santan444/MS003/03-设计开发输出阶段/02电子/05物料证书/18.内部网电源电线/BVR 450750V 2.5-6.jpg

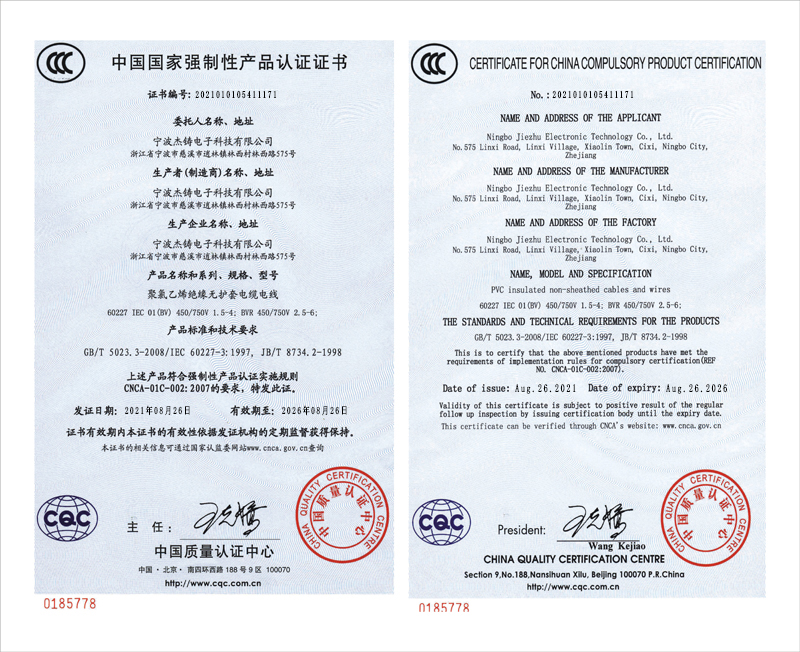
03-设计开发输出阶段/02电子/05物料证书/18.内部网电源电线/BVR 450750V 2.5-6.jpg
