santan444/MS003/03-设计开发输出阶段/02电子/02接线图/MS-003导航台车接线图.pdf

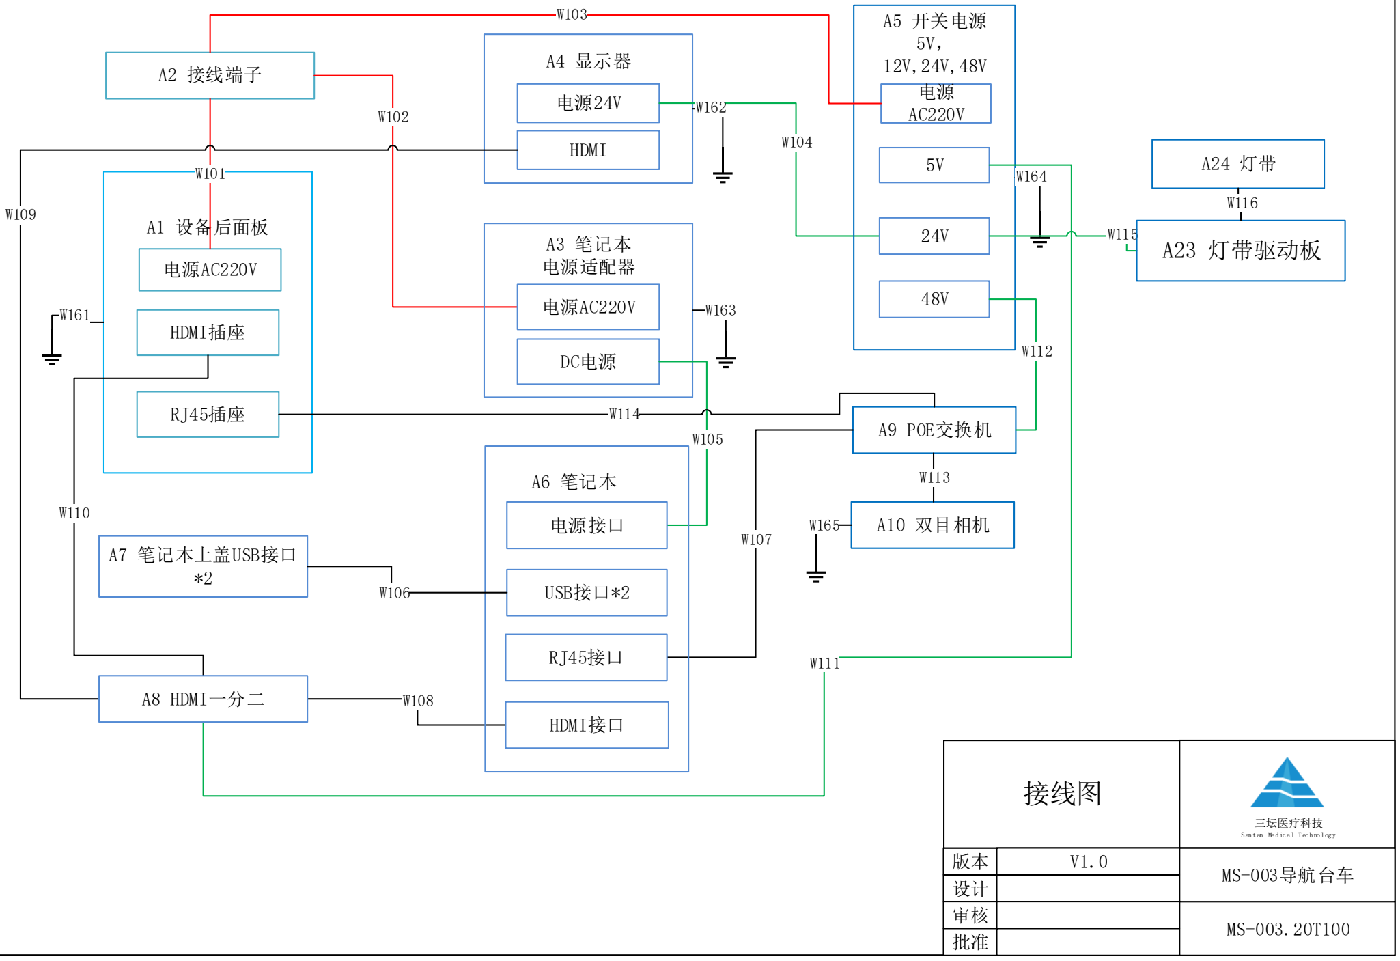
[picture p32: figure]
MS-003导航台车; 三坛医疗科技; Santan Medical Technology; 接线图; A2 接线端子; HDMI; A4 显示器; 电源AC220V; A1 设备后面板; DC电源; A3 笔记本 电源适配器; A5 开关电源 5V， 12V,24V,48V; A10 双目相机; A9 POE交换机; HDMI插座; A8 HDMI一分二; A7 笔记本上盖USB接口 *2; A6 笔记本; 电源接口; USB接口*2; HDMI接口; A23 灯带驱动板
