santan444/MS003/01-设计开发策划阶段/MS-003已上市同类产品不良事件及召回情况分析.docx

MS-003

已上市同类产品不良事件及召回情况分析

1. 已上市同类产不良事件

在国家药品监督管理局网站（https://www.nmpa.gov.cn/）的“医疗器械不良事件通报信息”版块中暂未发现2008年2月-2022年8月期间MS-003已上市同类产品的不良事件通报。

2. 已上市同类产品召回情况

2022年9月21日，在国家药品监督管理局网站（https://www.nmpa.gov.cn/）的“医疗器械召回”版块中以“关节”、“髋关节”、“关节系统”为关键词搜索相关信息，暂未发现MS-003已上市同类产品的召回信息。

编制人/日期：

复核人/日期：
