santan444/MS003/03-设计开发输出阶段/03软件/MS-003软件安装说明书.docx

MS-003

软件安装说明书

目 录

1 数据库安装及配置 3

1.1 PostgreSQL 12.11.1 安装 3

1.2 配置数据库 8

2 软件安装 11

2.1 安装 11

2.2 注册 14

# 1 数据库安装及配置

## 1.1 PostgreSQL 12.11.1 安装

说明: PostgreSQL 12.11.1 安装包由研发部提供。

双击运行安装文件postgresql-12.11-1-windows-x64.exe，如下图：

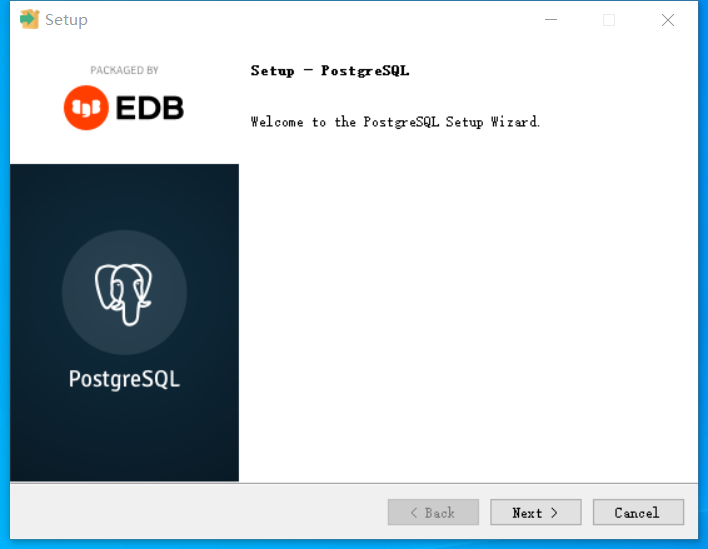
[picture p67: figure]
1660188475(1)

使用默认安装路径，如下图：

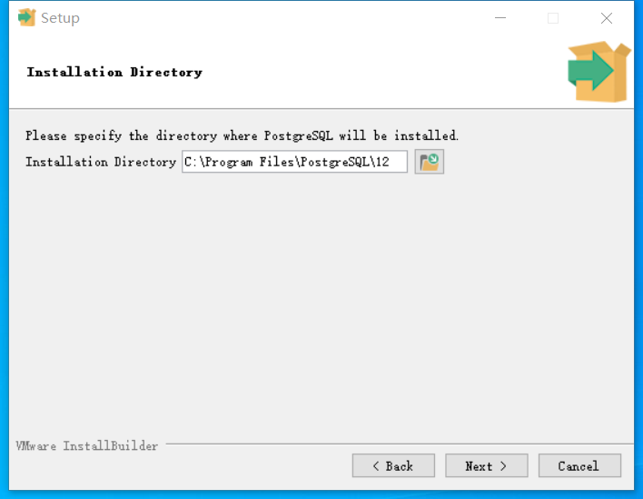
[picture p68: figure]
1660188507(1)

勾选所有组件，如下图：

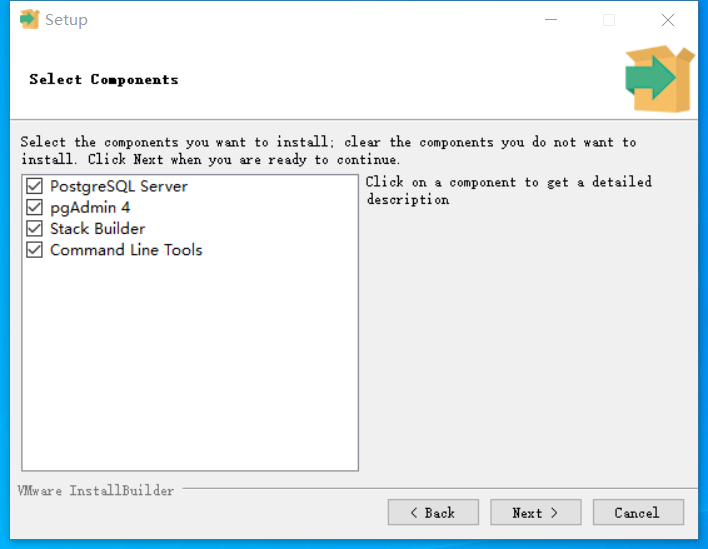
[picture p69: figure]
1660188563(1)

使用默认的数据存储路径，如下图：

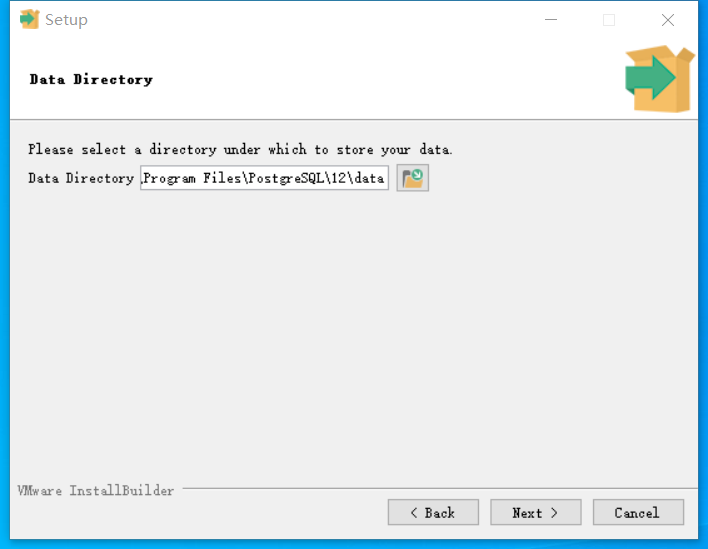
[picture p70: figure]
1660188821(1)

设置数据库用户密码，如下图：使用默认用户名，密码：santan2022

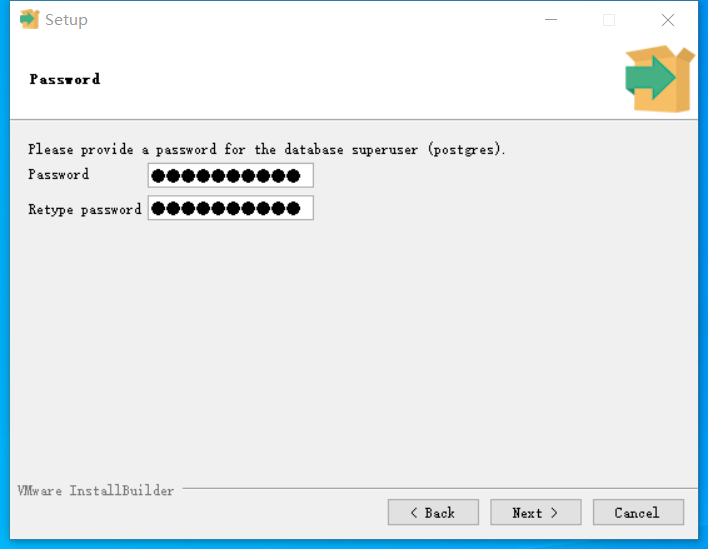
[picture p71: figure]
1660188945(1)

使用默认端口：

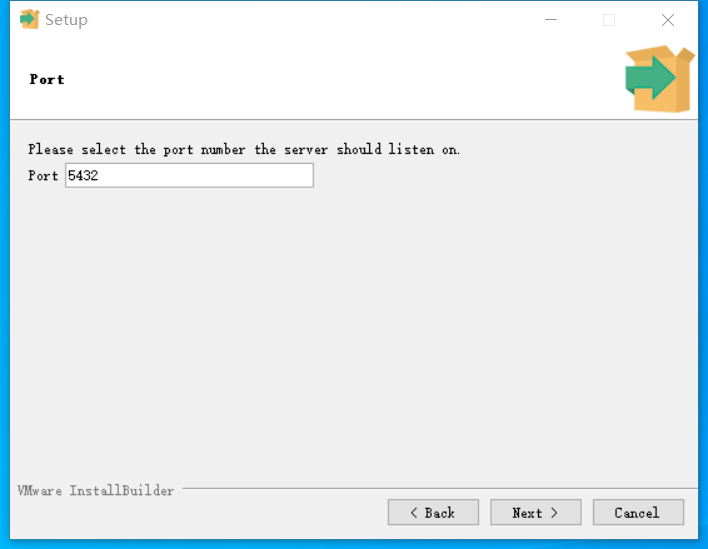
[picture p72: figure]
1660188966(1)

选择默认位置：

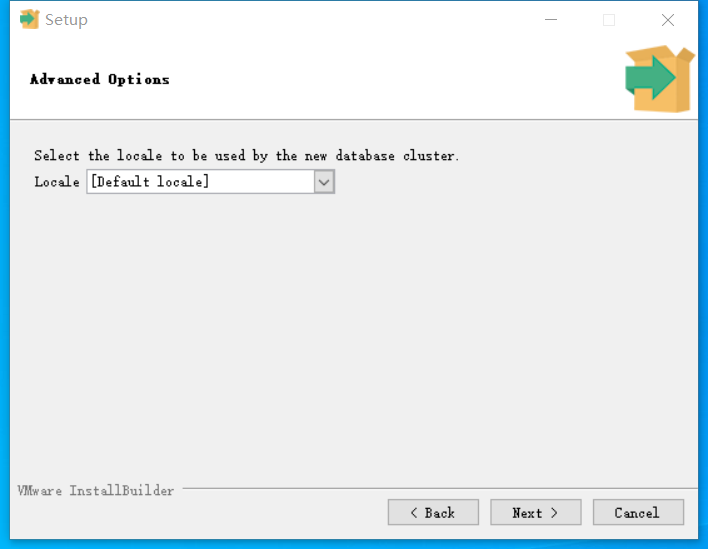
[picture p73: figure]
1660189086(1)

确认安装信息：

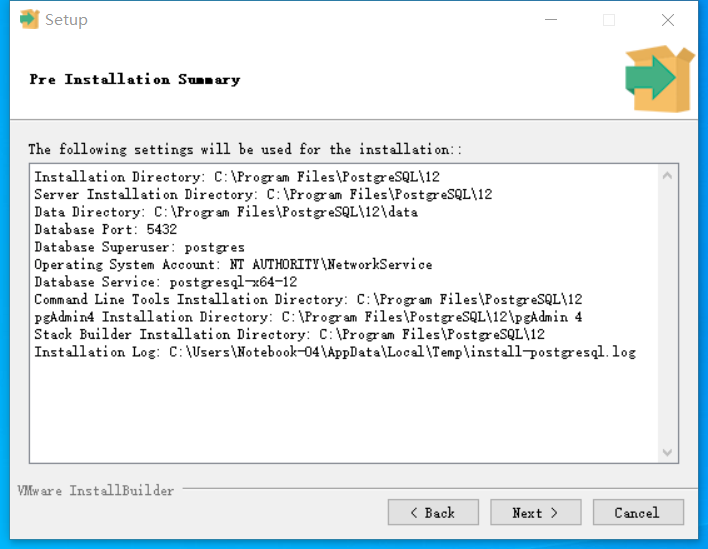
[picture p74: figure]
1660189108(1)

准备就绪，点击安装：

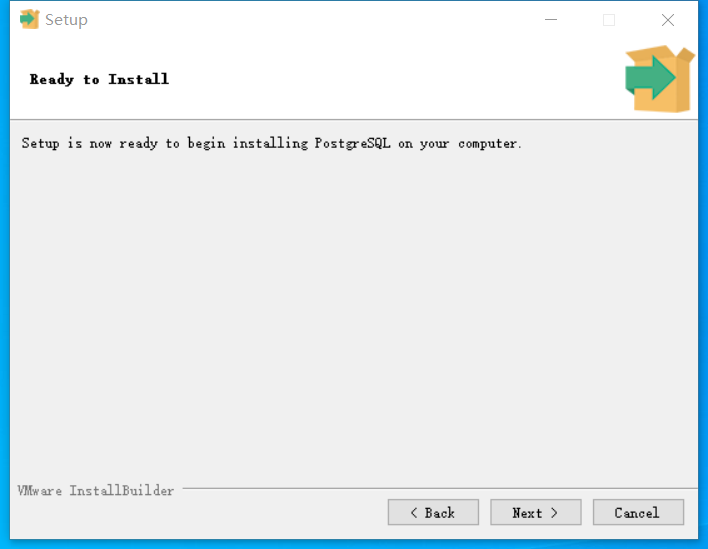
[picture p75: figure]
1660189157(1)

安装完成：

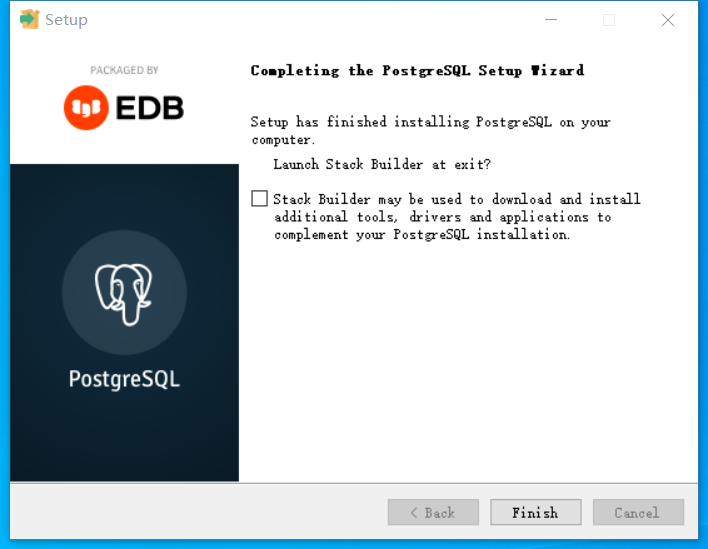
[picture p76: figure]
1660189288(1)

## 1.2 配置数据库

运行pgAdmin，输入密码登录，展开选中Servers->PostgreSQL12->Databases，右键单击，选择Create->Database

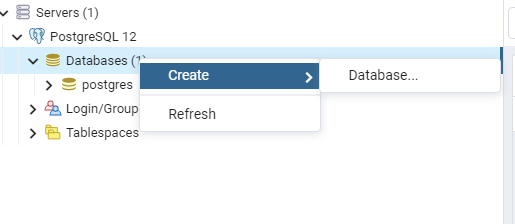
[picture p77: figure]
1660197411(1)

弹出对话框，输入名称STMDB, 点击save创建成功。

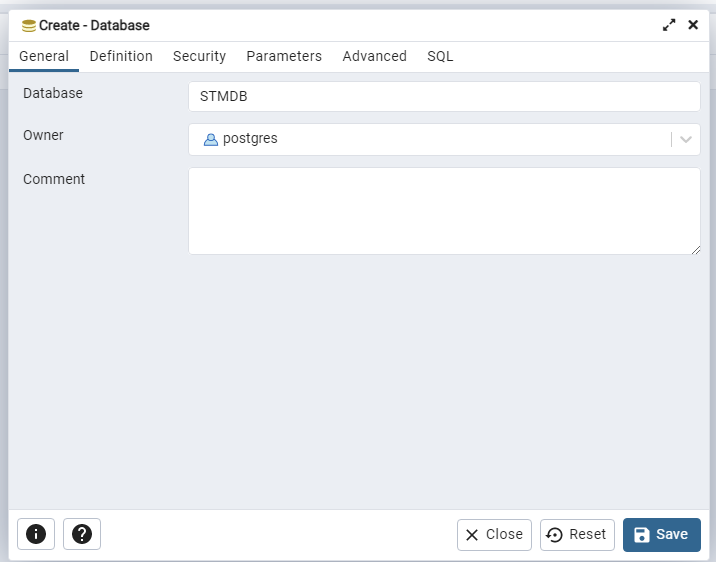
[picture p78: figure]
1660197630(1)

右键单击刚创建的STMDB，选择QueryTool，打开QueryEditor

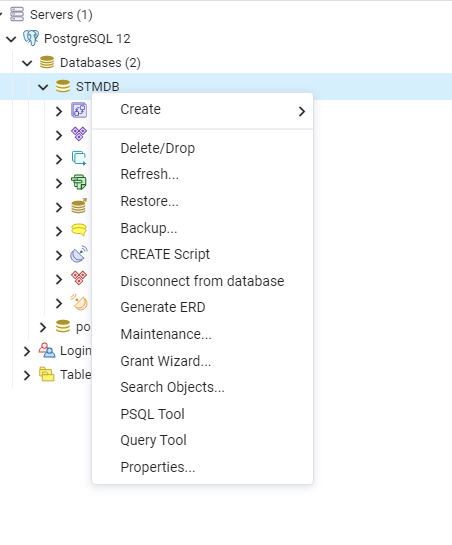
[picture p79: figure]
1660197780(1)

复制文档DbCreateScript中内容至Query Editor：

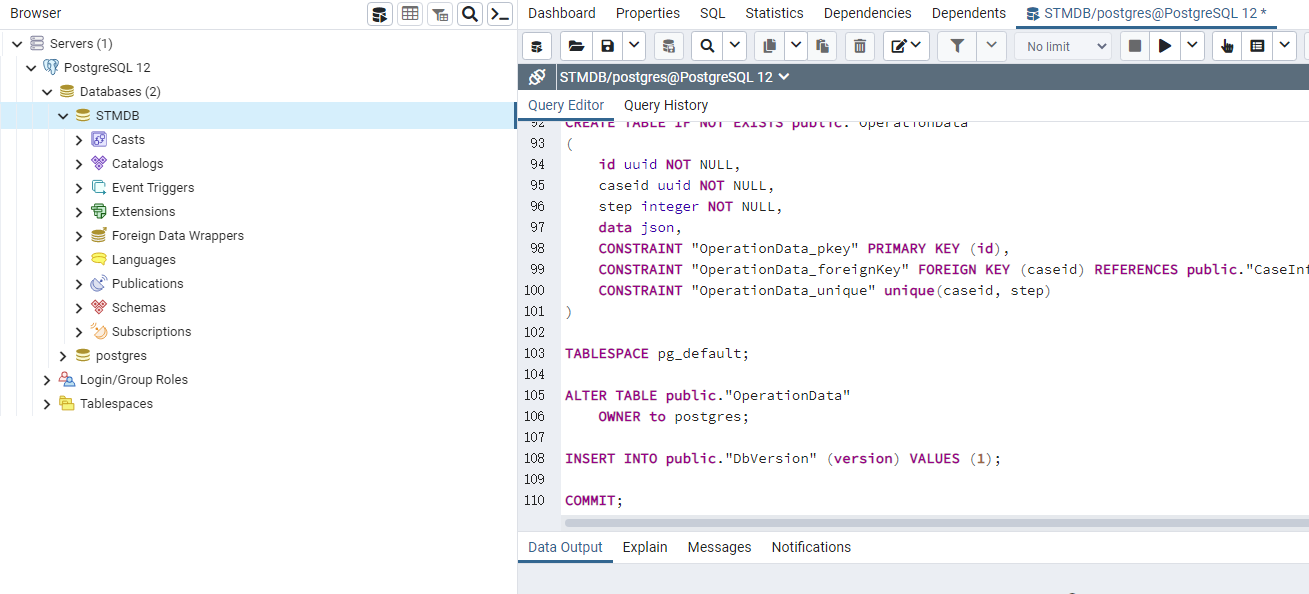
[picture p80: figure]
1660197918(1)

单击执行按钮或者按下F5执行成功。

此时展开STMDB->Schemas->Tables，会看到创建成功的数据表。

# 2 软件安装及注册

## 2.1 安装

安装前请卸载原有软件（如有），双击“安装包/MS003.msi”运行。 弹出窗口：

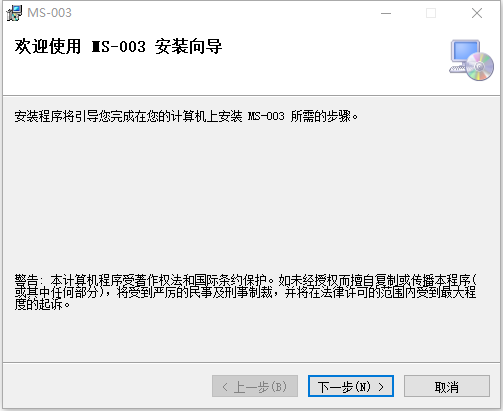
[picture p81: figure]

点击【下一步】，进入以下页面：

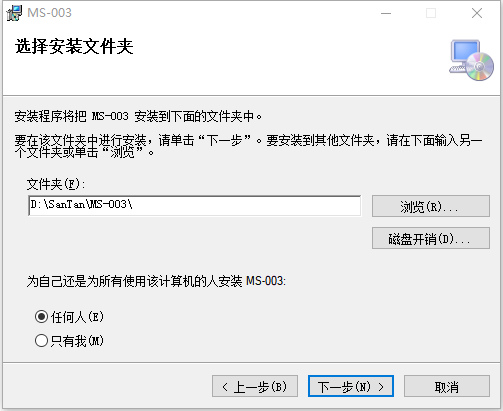
[picture p82: figure]

选择安装目录，可直接手工修改比如D盘“D:\”，或者点击右边【浏览】按钮：浏览

选择本地目录，如下图：

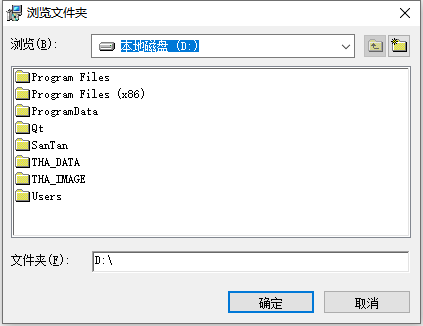
[picture p83: figure]

选中D\SanTan\MS-003\盘，点击【确定】:

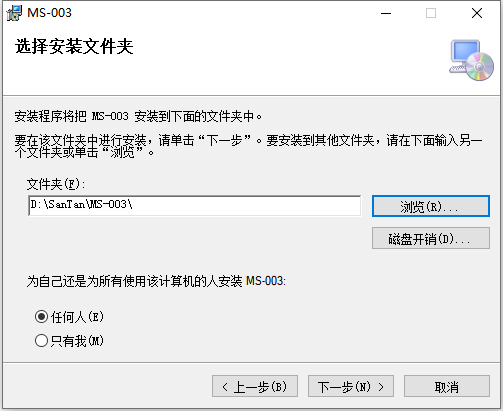
[picture p84: figure]

点击【下一步】按钮，进入以下页面：

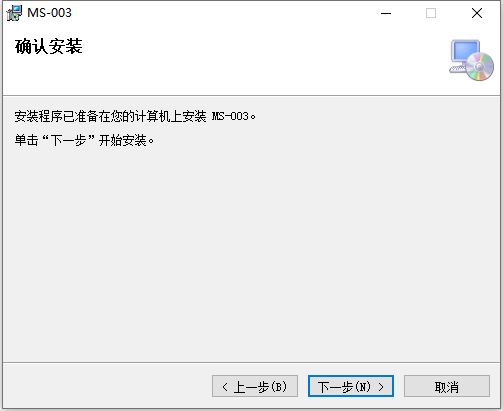
[picture p85: figure]

点击【下一步】按钮，开始安装，等待进度条加载：

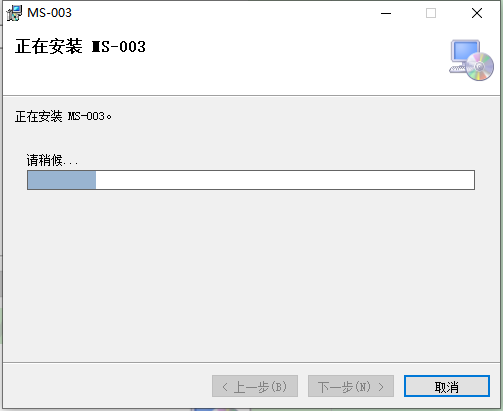
[picture p86: figure]

等待进度条加载完成，如下图：

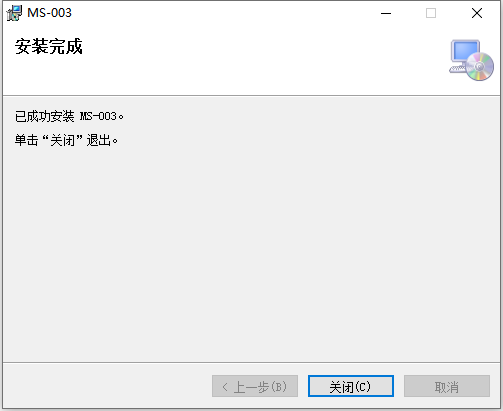
[picture p87: figure]

点击【关闭】按钮，安装完成。

## 2.2 注册

双击“D\SanTan\MS-003\ActivateTool.exe”如下图：

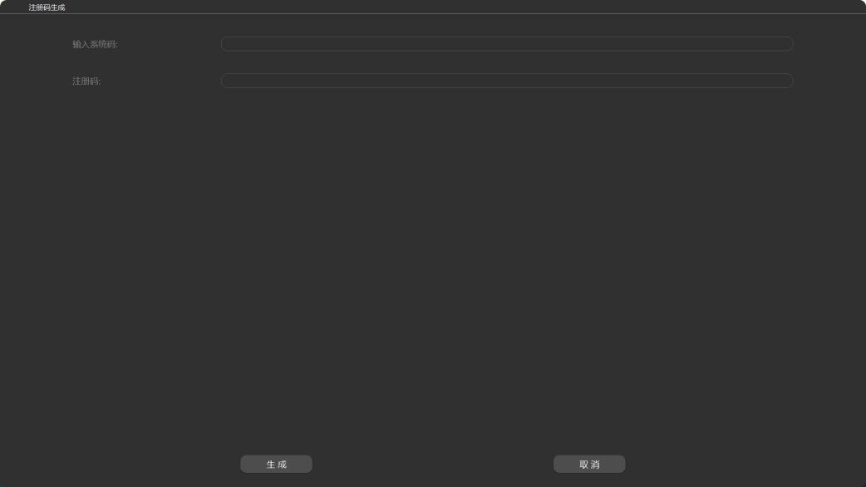
[picture p88: figure]

运行髋关节置换手术规划与控制（MS-003）软件，双击D:\MS-003\Entrance.exe，首

次运行，会自动进入注册页面，如下图：

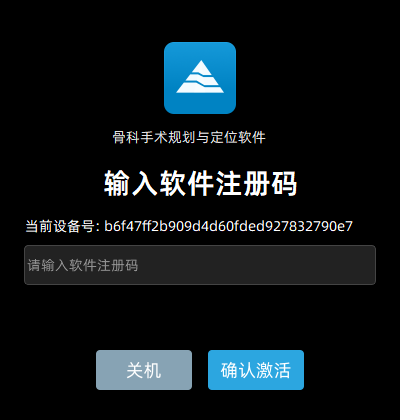
[picture p89: figure]

将注册页面的第一行内容(当前设备号)32位字符复制，

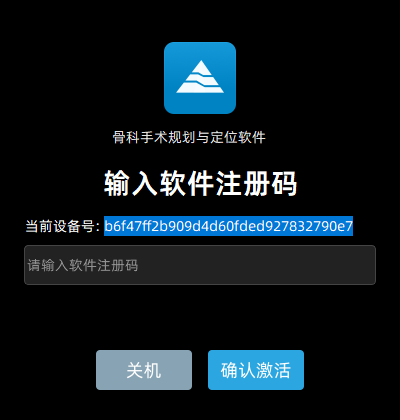
[picture p90: figure]

然后粘贴到ActivateTool窗口的“输入系统码”输入框，

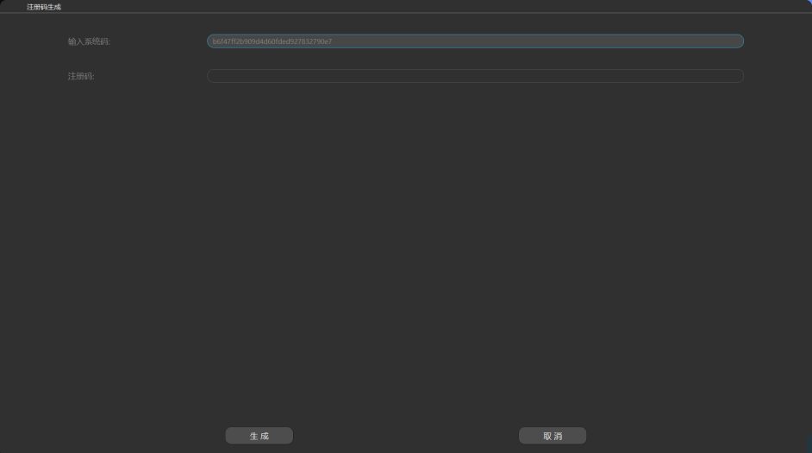
[picture p91: figure]

点击下方【生成】按钮，会自动生成注册码，如下图：

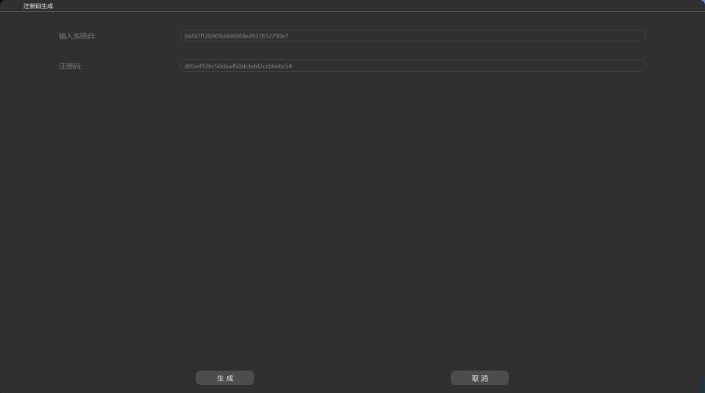
[picture p92: figure]

复制32位注册码，然后粘贴到MS-003软件注册页面，如下图：

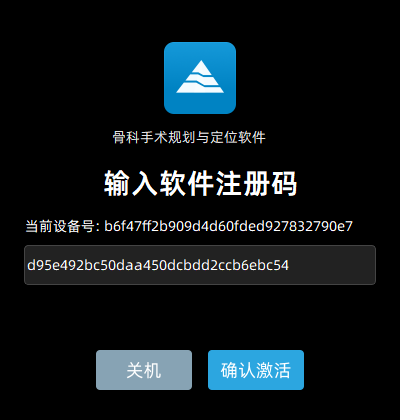
[picture p93: figure]

点击【确认激活】按钮，注册成功，进入登录页面，如下图：

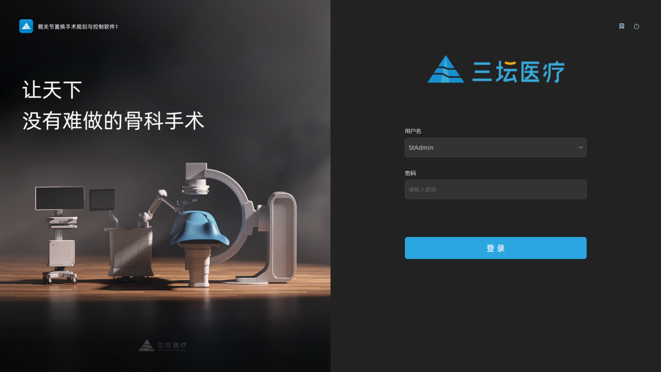
[picture p94: figure]

安装注册完成。
