santan444/MS003/03-设计开发输出阶段/02电子/MS-003网电源电路图.docx

MS-002 操作台车网电源电路图

P1:电源插座， 包含在DD12.9321.111中
F1、 F2:熔断器， 包含在DD12.9321.111中
F1、 F2熔断器座， 包含在DD12.9321.111中
SW1:电源开关， 包含在DD12.9321.111中
L1:滤波器， 包含在DD12.9321.111中

MS-002 导航台车网电源电路图

P1:电源插座， 包含在DD12.9321.111中
F1、 F2:熔断器， 包含在DD12.9321.111中
F1、 F2熔断器座， 包含在DD12.9321.111中
SW1:电源开关， 包含在DD12.9321.111中
L1:滤波器， 包含在DD12.9321.111中

MS-002 执行台车网电源电路图

P1:电源插座， 包含在DD12.9321.111中
F1、 F2:熔断器， 包含在DD12.9321.111中
F1、 F2熔断器座， 包含在DD12.9321.111中
SW1:电源开关， 包含在DD12.9321.111中
L1:滤波器， 包含在DD12.9321.111中
