santan444/MS003/03-设计开发输出阶段/02电子/04电子测试验证/MS-003.20W011 MS-003末端控制板验证方案.docx

| 文件号： | | | | | MS-003.20W011

MS-003

末端控制板验证方案
编制人： | | | | 日期：
审核人： | | | | 日期：
批准人： | | | | 日期：

文档修订履历

版本号 | 发布日期 | 更改内容概述 | 更改者
V1.0 | 2022.03.00 | 文件新编 | 雷俊勇

保密条款

文档仅限产品（项目）组内流转，违者负相应法律责任。

目录

# 第1章 概述

## 1.1 验证目的

末端控制板是用来控制机械臂前端通道上升下降通道左旋转右旋转和状态灯显示机械臂和操作状态的部件，根据产品技术需求说明书，对末端控制板按键功能和灯光控制功能进行测试验证，检验产品功能与开发需求是否一致。

根据GB∕T 14710-2009《医用电器环境要求及试验方法》环境试验条件分组第Ⅲ组要求，进行气候环境条件测试，试验产品在特定温湿度条件下是否正常工作。

## 1.2 验证范围

MS-003.22T001-末端控制板。

## 1.3 术语

无

## 1.4 参考资料

GB∕T 14710-2009《医用电器环境要求及试验方法》

《MS-003 技术需求规格书》

《MS-003 电子设计失效模式分析(D-FMEA)》

《MS-003 风险评估和控制记录》

# 第2章 验证条件

## 2.1 验证对象

设备编号 | 设备名称 | 型号规格 | 备注
1 | 末端控制板 | MS-003.22T001 | /

## 2.2 验证设备/工装/工具

设备编号 | 设备名称 | 型号规格 | 备注
/ | 末端灯板 | MS-003.24T001 | /
ST/RD-E2001 | 直流稳压电源 | UTP1306S | /
ST/RD-E1002 | 数字万用表 | FLUKE 17B+ | /
ST/SC-025 | 高低温箱 | WHTM-150BO | /

## 2.3 验证地点

公司实验室

## 2.4 验证时间

2023.01-2023.02

## 2.5 验证环境

环境一：温度：室温；相对湿度：≤75%

环境二：高低温箱内特殊要求

## 2.6 验证人员

序号 | 岗位 | 人数 | 职责
1 | 电子工程师 | 1人 | 验证中的设备操作
2 | 测试工程师 | 1人 | 进行相关过程数据记录； 数据统计，编制报告

# 第3章 验证可接受准则

验证结果应符合以下指标：

(1) 末端控制板电压值在±5%范围内。末端灯板灯光显示状态正常；
(2) 高低温试验后，末端灯板灯光显示状态依然正常。

# 第4章 验证方法与步骤

## 4.1 功能验证（在室温环境下进行）

(1) 电压：

将末端控制板接入稳压电源（12V）中，测试其按键输出至机械臂工具模拟输入口电压是否正常。分别各测3次。

表4.2-1 末端控制板功能测试-电压

按下按键 | 预期电压（V）±5% | 实测电压（V）
SW1 | 2
SW2 | 4
SW3 | 6
SW4 | 8

(2) 灯光：

将末端控制板接入机械臂工具口中，连接末端灯板测试灯光显示是否正常。

表4.2-2 末端控制板功能测试-灯光

状态 | 预期灯光显示 | 实际灯光显示
机械臂掉电、按下急停按钮 | 灯光不亮
机械臂运动中、自由拖动 | 蓝色闪烁
待机状态 | 蓝色常亮
定位就绪（精度达到1.5mm以内） | 绿色常亮
套筒示踪器不可见 | 黄色常亮

## 4.2 性能验证

根据GB∕T 14710-2009《医用电器环境要求及试验方法》环境试验条件分组要求，进行气候环境第Ⅲ组条件测试，进行以下试验项目：

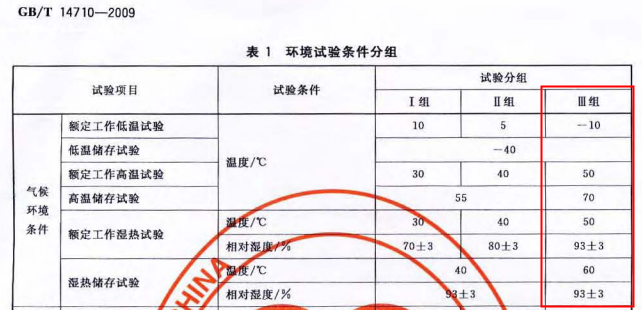
[picture p167: figure]

步骤：

(1) 进行高低温试验前，需要进行4.1功能测试，确认电压和灯光正常。

在低温(1)、高温(3)、湿热(5)的工作状态测试时应正常工作；

在低温(2)、高温(4)、湿热(6)的储存状态测试后恢复1h应正常工作。

(2) 将末端控制板置于高低温箱，按下表6种试验条件分别设置温湿度、并持续预定的时间。

表5.3-1 环境测试

序号 | 试验项目 | 试验条件 | 持续时间 | 预期结果 | 实际测试结果
1 | 额定工作低温试验 | 温度-10℃，试验时通电 | 1h | 此条件下正常工作
2 | 低温储存试验 | 温度-40℃，试验恢复后通电 | 4h | 上电后正常工作
3 | 额定工作高温试验 | 温度50℃，试验时通电 | 1h | 此条件下正常工作
4 | 高温储存试验 | 温度70℃，试验恢复后通电 | 4h | 上电后正常工作
5 | 额定工作湿热试验 | 温度50℃，湿度93%±3，试验时通电 | 4h | 此条件下正常工作
6 | 湿热储存试验 | 温度60℃，湿度93%±3，试验恢复后通电 | 48h | 上电后正常工作

(3) 序号1,3,5条件在高低温箱里，测试控制板，按照4.1功能测试分别测试电压和灯光状态。
(4) 序号2,4,6条件：将末端控制板从高低温箱取出，置于室温环境下恢复一小时，确认灯光状态。

# 第5章 验证结果与结论

从验证小组组员根据本方案的方法及步骤进行验证，记录结果并对结果进行相关分析。依据本方案的标准要求得出最终的验证结论，并编写验证报告。验证相关文档需经过审核、批准后归档。

# 第6章 附件

《MS-003 末端控制板验证记录表》。
