santan444/MS003/03-设计开发输出阶段/03软件/软件测试/v1..0.0.2截图/手术规划_运动评估.png

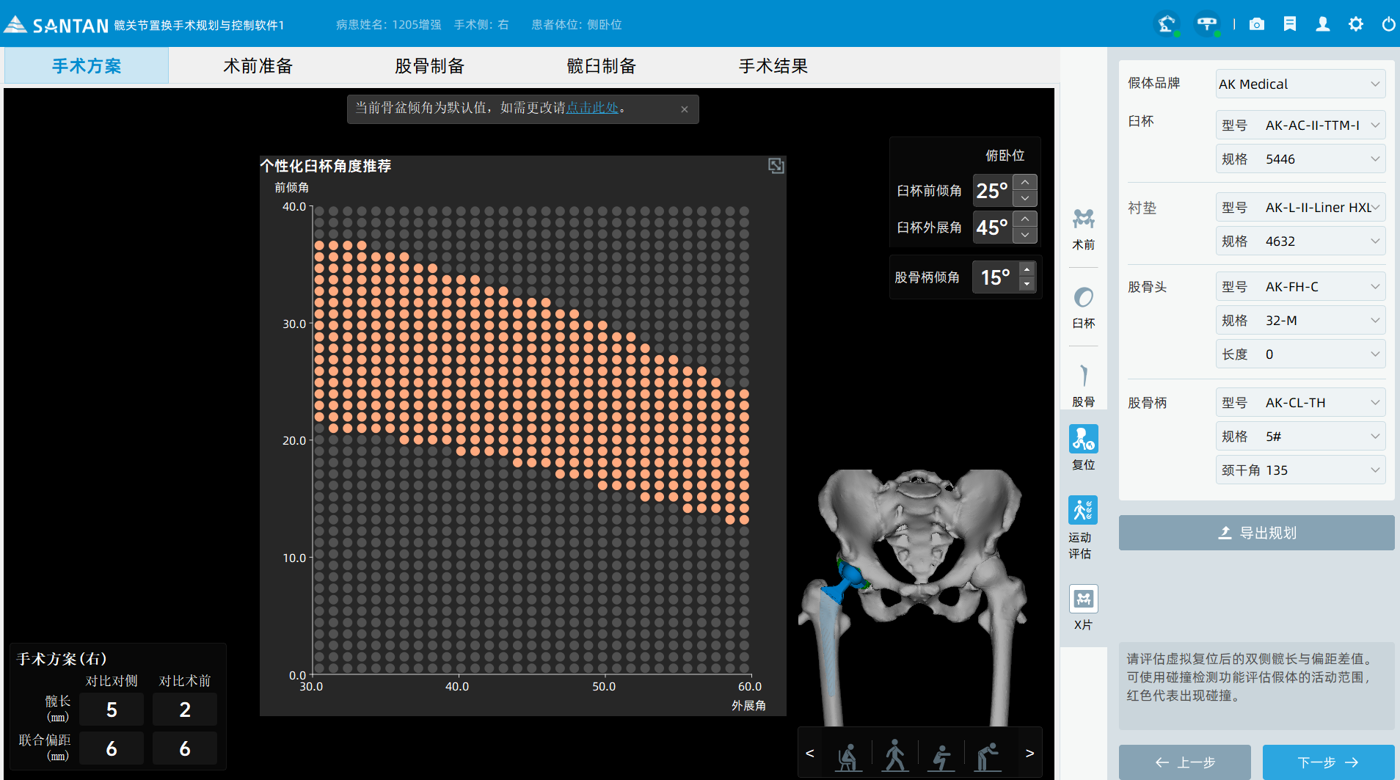
03-设计开发输出阶段/03软件/软件测试/v1..0.0.2截图/手术规划_运动评估.png
