santan444/MS003/03-设计开发输出阶段/02电子/07电子物料表/MS-003 三个台车电子BOM总表.xls

物料编码 | 物料名 | 型号 | 规格 | 品牌 | 缺少 | 合计 | 备注 | 导航 |  | 操作 |  | 执行 |  | 2023-12-19
611010217 | 电源接入连接器 | DD12.9321.111 |  | 得捷电子 |  | 3 |  |  | ● |  | ● |  | ●
611010147 | 保险丝座 | 4301.1403 |  | 得捷电 |  | 3 |  |  | ● |  | ● |  | ●
611010268 | 熔断器 | F5AL250V |  | 富轩电子 |  | 6 |  |  | ● |  | ● |  | ●
611010569 | 快速接线端子 | KC-6601 | 双色二进六出(固定款) | 汇君 |  | 3 |  |  | ● |  |  |  | ●
611010570 | 开关电源650W | NMP650-CEHK | 输出5V，12V，24V，48V | 明纬 |  | 3 |  |  | ● |  | ● |  | ●
611010571 | 开关电源450W-12V | MSP-450-12 |  | 明纬 |  | 1 |  |  |  |  |  |  | ●
611010435 | 27寸显示器 | MS27STPA | 带显示器电源适配器和HDMI线 | 睿显 |  | 2 |  |  | ● |  | ●
611010573 | UPS | UPS2000-G-1KRTS | 自带电源线和A口转B口USB线缆 | 华为 |  | 1 |  |  |  |  |  |  | ●
611010438 | 隔离变压器 | T8BFN-85419 | TTO-85419-00L | 河源天裕 |  | 1 |  |  |  |  |  |  | ●
611010206 | 铝壳电阻 | RX24-200W-4ΩJ |  |  |  | 1 |  |  |  |  |  |  | ●
611010574 | 机械臂 | LBR Med 14 R820 |  | KUKA |  | 1 |  |  |  |  |  |  | ●
611010582 | 戴尔笔记本主机 | 游匣G16 7630-1948W | 自带适配器 | 戴尔 |  | 1 |  |  | ●
611010434 | 双目相机 | Polaris Vega ST | 自带双目相机电源适配器 | NDI |  | 1 |  |  | ●
611010445 | 键盘 | MX keys mini | 无接收器 | 罗技 |  | 1 |  |  | ●
611010588 | 鼠标 | MX Anywhere3S |  | 罗技 |  | 1 |  |  | ●
611010523 | Bolt接收器 | Bolt | 支持鼠标和键盘 | 罗技 |  | 1 |  |  | ●
611010583 | poe交换机 | TL-SG2105P | POE，5口工业交换机 | TP-LINK |  | 1 |  |  | ●
611010581 | HDMI分屏器 | MT-SP102M | 一进二出 | 迈拓维矩 |  | 1 |  |  | ●
611010577 | HDMI插座 | VL24Y-HDMI-2 | 银色 | 罗科斯通 |  | 2 |  |  | ● |  | ●
611010580 | HDMI切换器 | CM597 | 三进一出 | 绿联 |  | 1 |  |  |  |  | ●
611010140 | 8口交换机 | TEG1008M | 电源线使用自带适配器线改装 | 腾达 |  | 1 |  |  |  |  |  |  | ●
611010288 | 电源指示灯-220V | GQ8T-DLGAC220VN | 绿色，带线 | 红波 |  | 1 |  |  |  |  |  |  | ●
611010515 | 电源指示灯-6V | GQ8T-DLGDC6VN | 绿色，带线 | 红波 |  | 1 |  |  |  |  |  |  | ●
611010575 | RJ45网口插座 | RAD24-C6A-S | 银色 | 罗科斯通 |  | 3 |  |  | ● |  |  |  | ●
611010576 | USB 插座 | RAU3D24-C | 银色 | 罗科斯通 |  | 3 |  |  | ● |  |  |  | ●
610060070 | 航空插头 | 2K-T1-3P plug | 金属原色 | 莫科连 |  | 1 |  |  |  |  |  |  | ●
610060071 | 航空插座 | 2K-Z7-3P socket | 金属原色 | 莫科连 |  | 1 |  |  |  |  |  |  | ●
611010578 | 航空插头 | 2K-T1-6P plug | 金属原色 | 莫科连 |  | 2 |  |  |  |  |  |  | ●
611010579 | 航空插座 | 2K-Z7-6P socket | 金属原色 | 莫科连 |  | 1 |  |  |  |  |  |  | ●
613010018 | M8连接器 | M8直头4针公头带线两米 |  | 东菀市代唯电子 |  | 5 |  |  |  |  |  |  | ●
613010017 | M8连接器 | M8直头4孔母头带线两米 |  | 东菀市代唯电子 |  | 5 |  |  |  |  |  |  | ●
611010593 | M8连接器 | M8直头6针公头带线两米 |  | 东菀市代唯电子 |  | 4 |  |  |  |  |  |  | ●
611010594 | M8连接器 | M8直头6孔母头带线两米 |  | 东菀市代唯电子 |  | 4 |  |  |  |  |  |  | ●
611010561 | 16mm金属带灯按钮 （蓝色圆圈符号) | HBS1-AGQ16F 电源符号【自锁】220V蓝色 |  | 红波 |  | 1 |  |  |  |  |  |  | ●
611010562 | AGQ按钮接插线 | HB-T1 五线 | 线长1m | 红波 |  | 1 |  |  |  |  |  |  | ●
611010122 | 16mm金属带灯按钮 （绿色箭头符号） | FY1B-A/16F-10F/箭头/G24 | 单独按钮，电压24V 自复位常开，平头 | FERNYE/丰奕电气 |  | 2 |  |  |  |  |  |  | ●
611010125 | 16mm金属按钮插座 | 16mm金属按钮插座 | 与16mm金属按钮配套使用 预留线定制 （长1.5m） |  |  | 2 |  |  |  |  |  |  | ●
611010427 | 急停开关 | PB1S-02ZR-R | 红色，两常闭，底座型号为PB1-F-C01 | APT |  | 1 |  |  |  |  |  |  | ●
611010595 | 散热风扇 | 9厘米/厚度2.5厘米/12V静音 |  | 台达 |  | 2 |  |  |  |  |  |  | ●
611010437 | 立柱 | HB-DJ825 | 24V供电 60毫米行程 6mm/s 1500N，带霍尔编码器，IP54 | 无锡宏霸机电 |  | 4 |  |  |  |  |  |  | ●
611010596 | 接触器 | ICT 2P 2NO 230~240V 16A |  | 施耐德 |  | 1 |  |  |  |  |  |  | ●
611010584 | 骨钻 | 5107B |  | 博进 |  | 1 |  |  |  |  |  |  | ●
611010439 | 脚踏 | MKF 2 1PW/1PW-MED GP26 | 有线脚踏 | 世德 |  | 1 |  |  |  |  |  |  | ●
611010527 | 无线脚踏发射器 | FS82-W-RF（S） | 无线脚踏发射器+无线脚踏接收器 | 三实 |  | 1 |  |  |  |  |  |  | ●
611010528 | 无线脚踏接收器 | RCV-RF-1A-6 |  | 三实 |  | 1 |  |  |  |  |  |  | ●
611010572 | 无线脚踏充电器 | GSM06U09-P1J | 明纬电源适配器 | 明纬 |  | 1 |  |  |  |  |  |  | ●
610130026 | 台车控制板 |  |  |  |  | 1 |  |  |  |  |  |  | ●
610130028 | 升降控制板 |  |  |  |  | 1 |  |  |  |  |  |  | ●
 | 末端灯板 |  |  |  |  | 1 |  |  |  |  |  |  | ●
 | 末端连接板 |  |  |  |  | 1 |  |  |  |  |  |  | ●
610130039 | 灯带驱动板 |  |  |  |  | 3 |  |  | ● |  | ● |  | ●
611010597 | TTL转网口模块 | TAS-LAN-751 |  | TASTEK |  | 2 |  |  |  |  |  |  | ●
611010513 | HDMI线 | HDMI | 睿显自带线缆 | 睿显 |  | 6 |  |  | ● |  | ●
611010514 | HDMI线 | H678I | HDMI2.1/5M | 晶华 |  | 1 |  |  |  |  | ●
611010505 | 网线 | W200B/CAT8/0.5m | 0.5m | 晶华 |  | 2 |  |  | ● |  |  |  | ●
611010589 | 网线 | 八类万兆双屏蔽网线【右弯对直头】 1米 | 1m | 炬信科技（JUXIN） |  | 1 |  |  | ●
611010590 | 网线 | 八类万兆双屏蔽网线【右弯对直头】 3米 | 3m | 炬信科技（JUXIN） |  | 1 |  |  | ●
611010453 | 网线 | W200I/CAT8/5m | 5m | 晶华 |  | 2 |  |  | ●
611010510 | 网线 | W200M/CAT8/15m | 15m | 晶华 |  | 1 |  |  | ●
611010558 | 网线 | W200C/CAT8/1m | 1m | 晶华 |  | 3 |  |  |  |  |  |  | ●
611010591 | 双头usb数据线 | 黑色右右公对公USB3.0 约25厘米 |  |  |  | 2 | https://item.jd.com/10066496520119.html |  | ●
611010506 | USB线 | US128/公对公/USB3.0 | 1m | 绿联 |  | 1 |  |  |  |  |  |  | ●
611010452 | USB线 | US102/公对公/USB2.0 | 1.5m | 绿联 |  | 1 |  |  |  |  |  |  | ●
611010451 | TYPE-C线缆 | US287 | 1.5m | 绿联 |  | 3 |  |  |  |  | ●
611010598 | 9针串口线 | DB9公对母/B110E | 1.5m | 晶华 |  | 1 |  |  |  |  |  |  | ●
611010599 | 品字电源线 | 直插头【1.5米】 | 1.5m | 绿联 |  | 2 |  |  |  |  |  |  | ●
611010454 | 品字电源线-2.5平方 | 3芯x2.5平方 5米 | 5m |  |  | 3 |  |  | ● |  | ● |  | ●
 | LED灯带 | 每米720珠cob幻彩RGB | 10m | NIOYE(欧尼意) |  |  |  |  | ● |  | ● |  | ●
