santan444/MS003/03-设计开发输出阶段/02电子/MS-003.24T001-灯带驱动板/03_物料清单/MS-003.24W004 灯带驱动板物料清单 V1.0.xlsx

Sheet: 文档修改履历
文档更改履历
日期 | 版本号 | 修订章节 | 描述 | 作者 | 审核 | 批准
2023.12.18 | V1.0 | 全文 | 文件新编 | 秦铭 | 雷俊勇 | 张巍

Sheet: 物料清单
三坛医疗 |  |  | 组件名称 | 灯光驱动板 |  | 电路板组件 物料明细表 | 编制/日期 |  | 审核/日期 | 批准/日期
产品型号 |  | Navolution | 文件号 | MS-003.24W004 V1.0 |  |  | 秦铭/2023.12.18
电路板组件
组件编码 |  | 610130024 | 灯光驱动板
物料明细
序号 | 物料类型 | 物料编码 | 名称/规格 | 厂家 | 封装 | 位号 | 数量 | 替代编码 | 替代名称/规格 | 替代厂家
1 | 贴片电容 | 610026014 | CC0603KRX7R9BB104 | 国巨 | C0603 | C1, C5, C6, C7, C8 | 5 | 610027014 | GRM188R71H104KA93D | 村田
2 | 贴片电解电容 | 610026049 | VES101M1VTR-0607 | lelon(台湾立隆) | SMD-6.3*7.7mm | C2 | 1
3 | 贴片钽电容 | 610027034 | TAJA106K016RNJ | Kyocera AVX | CASE-A_3216 | C3, C4 | 2
4 | TVS管 | 610120014 | SMBJ26CA | Brightking(君耀电子) | SMB(DO-214AA) | D1 | 1
5 | 贴片LED | 610040060 | 19-217/G7C-AN1P2/3T | EVERLIGHT(台湾亿光) | 0603 | D3 | 1
6 | 贴片电感 | 610030020 | SWPA4030S100MT | Sunlord(深圳顺络) | SMD-4.0*4.0*4.0mm | L1, L2 | 2
7 | 插拔式接线端子 | 610060058 | HT396R-3.96-04P-15 | KEFA(科发电子) | 2EDG4P-3R96-TH-W-L | P1, P4 | 2
8 | 贴片MOS管 | 610040015 | CJ2301 | CJ（江苏长电） | SOT-23-3 | Q1 | 1
9 | 贴片三极管 | 610040003 | S8050 | CJ（江苏长电） | SOT-23-3 | Q2, Q3 | 2
10 | 贴片电阻 | 610016109 | RC0603JR-0751KL | 国巨 | R0603 | R1, R2, R3, R4 | 4 | 610017109 | 0603WAJ0513T5E | 厚声
11 | 贴片电阻 | 610016093 | RC0603JR-0710KL | 国巨 | R0603 | R5, R7, R8, R13, R16 | 5 | 610017093 | 0603WAJ0103T5E | 厚声
12 | 贴片电阻 | 610016089 | RC0603JR-076K8L | 国巨 | R0603 | R6 | 1 | 610017089 | 0603WAJ0682T5E | 厚声
13 | 贴片电阻 | 610011078 | RC0603JR-074K7L | 国巨 | R0604 | R9, R10 | 2 | 610011040 | RTT034701FTP | 旺诠
14 | 贴片电阻 | 610016070 | RC0603JR-071KL | 国巨 | R0603 | R11, R15 | 2 | 610017070 | 0603WAJ0102T5E | 厚声
15 | 贴片电阻 | 610011025 | RC0603FR-07200RL | 国巨 | R0603 | R12, R14 | 2
16 | 集成电路 | 610050032 | TPS54202DDCR | TI(德州仪器) | SOT-23-6 | U1 | 1
17 | 电源芯片 | 610050066 | ME6211A33M3G-N | MICRONE(南京微盟) | SOT-23-3 | U2 | 1
18 | MCU芯片 |  | STM32G030F6P6 | ST(意法半导体) | TSSOP-20 | U3 | 1
19
20 | PCB板 |  | MS-003.22T003.1.0 | 睿索科技
37
38
39
40
41
42
