santan444/MS003/02-设计开发输入阶段/MS-003关键元器件表.xlsx

 |  |  |  |  |  |  | 文件号：MS-003.10W020
MS-003关键元器件表
序号 | 名称 | 品牌/厂商 | 型号 | 认证标准 | 价格 | 供货周期及备货建议 | 备注
1 | 27寸显示器 | 睿显 | MS27STPA |  | 8000 | 1个月 | 27寸、1920*1080分辨率、白色、带HDMI接口
2 | 主机工作站 | 戴尔 | 游匣G16 7630-1948W |  | 10000 | 15天 | (皓影白) CPU:i9-13900HX GPU:RTX4060 显存：8G 内存:32G 硬盘：1TB M.2 NVMe 显示屏：16英寸 2.5K（2560 x 1600）240hz 机身尺寸：约357x288.73x25.65mm 质量：约2.87kg
3 | 双目相机 | NDI | Polaris Vega ST（带电源和网线） |  | 196000 | 2个月左右
4 | NDI双目相机配套用反光球 | NDI | Radix Lens |  | 2390 | 7天 | 目前有库存，正常海外发货2个月起，价格为10盒的批量订货价
5 | 双目吊臂 | 深圳捷宜电子 | JY208B
6 | 机械臂 | KUKA德国股份有限公司 | LBR Med 14 R820 | LBR Med CB Test Certificate\ISO13485KUKADeutschlandGmbHe | 750000 | 目前国内有库存，正常海外订货4-5个月
7 | 无线视频传输 | 飞利浦(PHILIPS) | SWR8106 |  | 1300 | 7天 | 已停产 ，需要找替代型号
8 | 有线脚踏 | 世德 | MKF 2-MED GP26 |  | 2330 | 1.5个月 | 1. 底座：浅灰色RAL7035 2. 底座中间不带黑色按钮 3. 踏板颜色：左黑/右浅灰，不带steute logo 4. 两个脚踏单独控制 5. 线长2米，带屏蔽 6. 防水等级：IPX8
9 | 无线脚踏发射器 | 三实 | FS82-W-RF（S）
10 | 无线脚踏接收器 | 三实 | RCV-RF-1A-6
11 | 无线键鼠 | 罗技 | MX keys mini（键盘） MX Anywhere3（鼠标） |  | 119 | 7天
12 | 立柱 | 无锡市宏霸机电设备有限公司 | HB-DJ825-24-60=175-6 （24V供电 60毫米行程 6mm/s 1500N，带霍尔编码器，IP54 | CE | 340 | 1.5个月
13 | 开关电源450W-24V | 明纬企业股份有限公司 | MSP-450-24 | UL ES60601-1、CB IEC60601-1、EAC、EMC、UK、CE | 788 | 10天
14 | 开关电源450W-12V | 明纬企业股份有限公司 | MSP-450-12 | UL ES60601-1、CB IEC60601-1、EAC、EMC、UK、CE | 150 | 10天
15 | 开关电源650W | 明纬企业股份有限公司 | NMP650-CEHK | UL ES60601-1、CB IEC60601-2、EAC、EMC、UK、CE
16 | 开关电源45W-5V | 明纬企业股份有限公司 | MPM-45-5ST | UL ES60601-1、CB IEC60601-3、EAC、EMC、UK、CE
17 | 急停开关 | APT | PB1S-02ZR-R |  |  |  | 红色，两常闭
18 | 电源接入连接器 | 得捷电子 | DD12.9321.111
19 | 熔断器 |  | F5AL250V
20 | 保险丝座 | 得捷电子 | 4301.1403
21 | 脚轮 | 腾德脚轮+扫线器 | 5947UAP125P30-13 |  | 194 | 10天
22 | 8口交换机 | 腾达 | TEG1008M |  | 91 | 7天 | SY-002现用型号
23 | POE交换机 | TP-LINK | TL-SG2105P
24 | HDMI分屏器 | 迈拓维矩 | MT-SP102M |  |  |  | 一进二出
25 | HDMI切换器 | 绿联 | CM597 |  |  |  | 三进一出
26 | 隔离变压器 | 河源天裕电子塑胶有限公司 | T8BFN-85419 (TTO-85419-00L) （加宽保护接地屏蔽 温控开关 130℃） | CQC UL 60601-1 | 743 | 1个月
27 | UPS | 华为技术有限公司 | UPS2000-G-1KRTS（1kVA 内置电池） | YD/T 1095-2008, EN/IEC 62040-1, EN/IEC 62040-2, EN/IEC 62040-3, TLC,CE,CB等 | 970 | 10天
28 | 继电器 | 欧姆龙 | G6B-47BND-DC24
29 | 髋臼钻 | 上海博进 | 5107B
