santan444/MS003/03-设计开发输出阶段/02电子/MS-002.23T001-升降控制板/02_PCB/MS-002.23T003升降控制板PCB图检查表 V1.0.xls

PCB检查表
项目型号： | MS-002.23T003 V1.0
审查人： | 易臣云
日期： | 2022.07.22
序号 | 检查项 | 要求 | 检查结果 |  |  | 备注（不符合项说明）
 |  |  | 是 | 否 | NA
一、整体检查
1 | PCB生成 | PCB由原理图Update而来，不是PCB上直接修改 | √
2 | 规则检查 | 工具->设计规则检查不能有错误或警告信息产生 | √
3 | 外形尺寸 | PCB外形尺寸与外壳相匹配 | √
4 | 圆角处理 | 出于安全考虑，在板的四个角上做倒圆角处理 | √
5 | 名称 | PCB名称与原理图相对应 | √
6 | 封装 | 器件封装从公司封装库内选用，新增加器件需特别检查封装是否正确 | √
7 | 拼板 | 单板尺寸＜50mm*50mm时，必须做拼版，拼版尺寸＜200mm*250mm |  |  | √
二、布局
1 | 退耦电容 | 芯片、电源的退耦电容（例如0.1uF）和信号线上的滤波电容应该尽量放置在相关的管脚边上 | √
2 | 大功率或发热器件 | 大功率的器件或者发热的电路，远离单片机的位置，同时远离热敏感的器件 | √
3 | 磁敏感器件 | 磁敏感器件（如干簧管、霍尔、磁阻）周围应该尽量避免大电流的走线（如电机线），以防受到干扰 | √
4 | 强干扰器件 | 强干扰元器件（一般是指产生强电磁干扰的器件，如开关电源、GSM模块），此类器件一定要单独地放在PCB的一端，尽量的远离MCU或者易受干扰的器件 | √
5 | QFP、BGA器件 | QFP、BGA等多边出脚的器件（拆焊时需要热风枪）不要靠塑料件太近，以免维修芯片时热风枪将塑料件吹变形 | √
6 | 较高的器件 | 两个高大器件之间（15mm之内）不应该摆放低矮的贴片器件 | √
7 | 螺丝孔 | 螺丝孔周围2mm的范围内不应放置器件或者布线 | √
8 | MARK点 | PCB的两个对角上各放置一个MARK点 | √
9 | 波峰焊盘 | 手工/波峰焊接的焊盘周围3mm区域内不要放置贴片器件或测试点 | √
10 | 大器件接地脚 | 插座、FPC座子、体积较大器件接地脚不要直接连到大片地线，采用热焊盘形式接地 | √
11 | 板边器件 | 器件距板边距不能小于1.5mm | √
12 | 板边器件 | 离板边禁布区8mm范围内不允许布局高于25mm的器件 | √
13 | 工艺边 | 为满足生产工艺，器件与板边过轨面距离不能小于5mm，当不能满足此条件时，需要增加工艺边 | √
14 | 板边界 | 电路板的物理边界就是PCB的实际大小和形状，必须在“Mechanical 1”上绘制，不能只画“Keep_Out Layer”层 | √
二、布线
1 | 线宽 | 双层板信号线的最小线宽和线距为10mil，电源线的线宽和线距应该适当加大 |  | √ |  | MCU线距最大8mil
2 | 走线方式 | 布线方向水平或者垂直，由水平转垂直时一定要走45度角 | √
3 | 板边布线 | PCB板的边缘不要走类似RESET、Pulse的重要信号线 | √
4 | 过孔 | 无特殊要求时，过孔的参数：内径18mil，外径25mil，且过孔敷绿油 | √
5 | V-CUT边缘 | V-CUT（V型槽）边缘到线路边缘距离≥0.6mm |  |  | √
6 | 焊盘 | 焊盘上不能有通孔 | √
7 | 元件标识 | 元件标识和参数使用sans serif字体，高度40mil，宽度7mil，如果空间放不下，可以使用高度30mil，宽度6mil规格，但同一PCB中不能出现两种字体的位号或者参数 | √
8 | 板标识 | PCB名称、版本号使用sans serif字体，高度60mil，宽度10mil，如果空间放不下，可以使用高度40mil，宽度7mil规格，但同一PCB中名字标识不能出现两种以上字体 | √
9 | 丝印方向 | 丝印字符方向应该为水平或者右转90度 | √
10 | 丝印放置 | 丝印不能放在焊盘上，同时丝印与丝印之间不能交错 | √
11 | IC引脚出线线宽 | IC引脚引出线的线宽不允许大于焊盘宽度，避免虚焊 |  | √ |  | 有大电流故走线作加宽处理
12 | IC引脚出线方向 | IC焊盘的引出线不允许从侧面出线，相邻管脚如果相连，也需要从正面引出后再相连 | √
13 | 散热器 | 为了保证电气绝缘性，散热器下方周围应无走线 |  |  | √
14 | 差分线 | 运放差分输入的两个输入线要尽量短且相互平行走线 |  |  | √
15 | 过孔间距 | 过孔间距在条件允许的情况下不宜过小，尽可能放置过孔间隔在3mm以上 | √
16 | MCU、高频器件 | MCU或者其它高频器件下尽可能不走线 | √
