santan444/MS003/03-设计开发输出阶段/02电子/05物料证书/12.交换机/TEG1008M-CCC.pdf

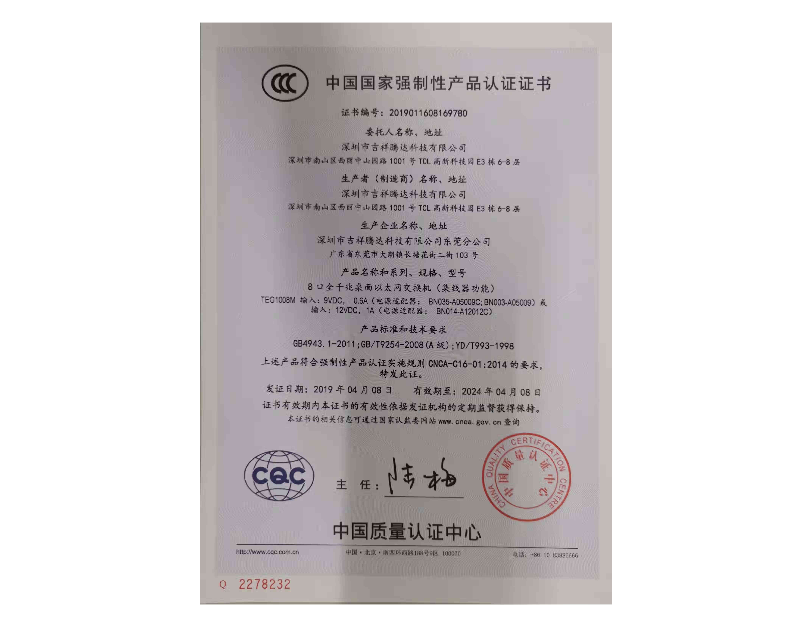
[picture p300: page 1]
