santan444/MS003/03-设计开发输出阶段/02电子/05物料证书/14.脚轮/RoSH Certificate REACH - 5947 UAP 125 P30-13.pdf

# Certificat de Conformité

## Certificate of Compliance

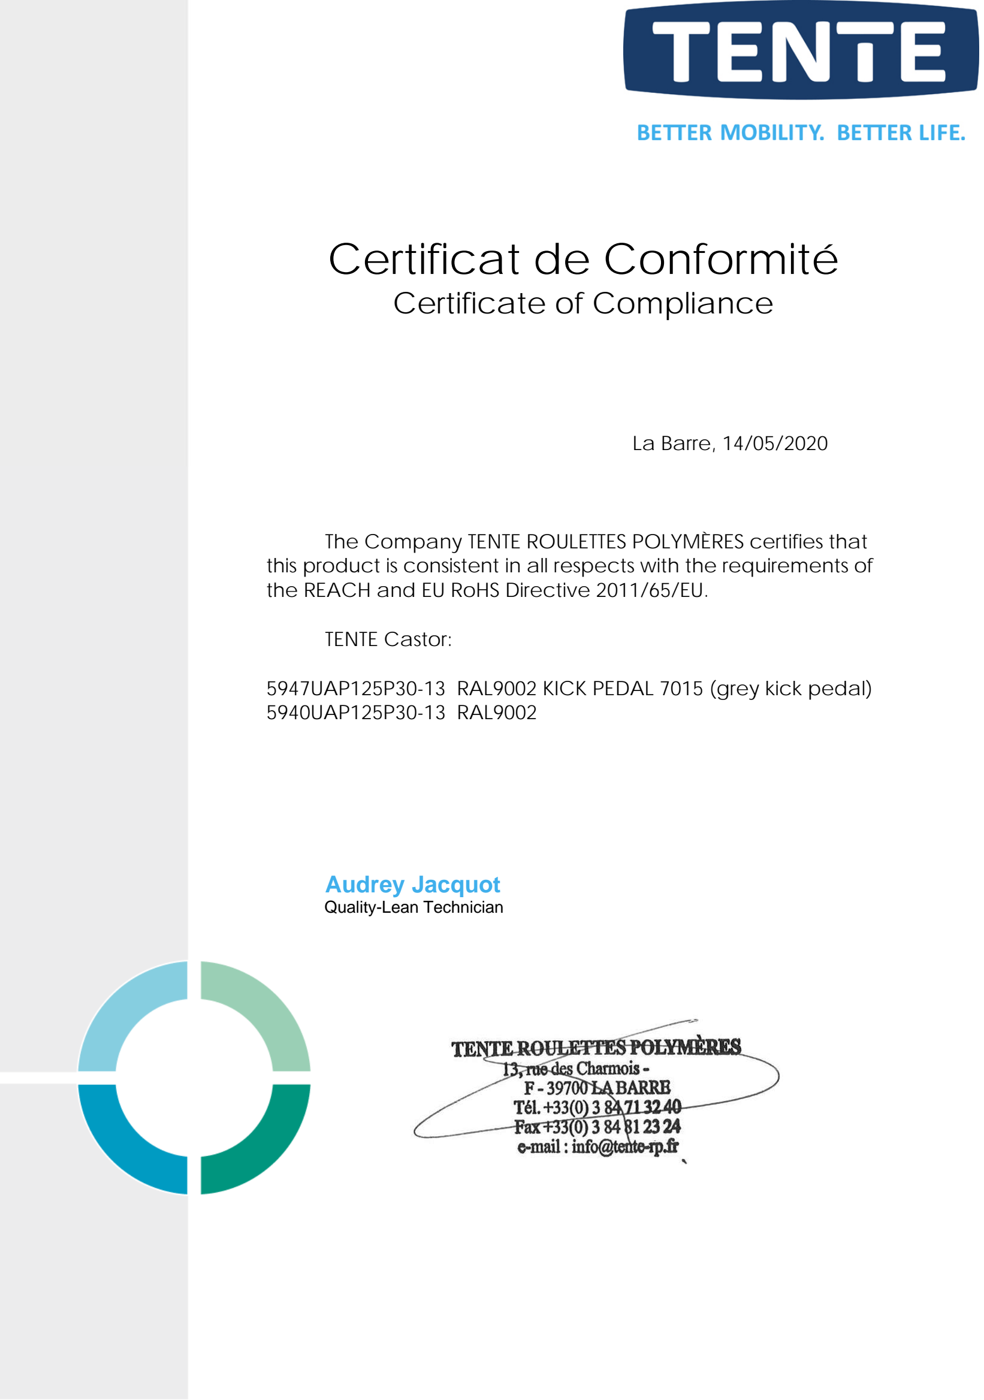
[picture p301: page 1]

La Barre, 14/05/2020

The Company TENTE ROULETTES POLYMÈRES certifies that this product is consistent in all respects with the requirements of the REACH and EU RoHS Directive 2011/65/EU.

TENTE Castor:

5947UAP125P30-13 RAL9002 KICK PEDAL 7015 (grey kick pedal) 5940UAP125P30-13 RAL9002

Audrey Jacquot
Quality-Lean Technician
