santan444/MS003/03-设计开发输出阶段/02电子/05物料证书/17.品字电源线/CCC 插头PBB 2020-02.pdf

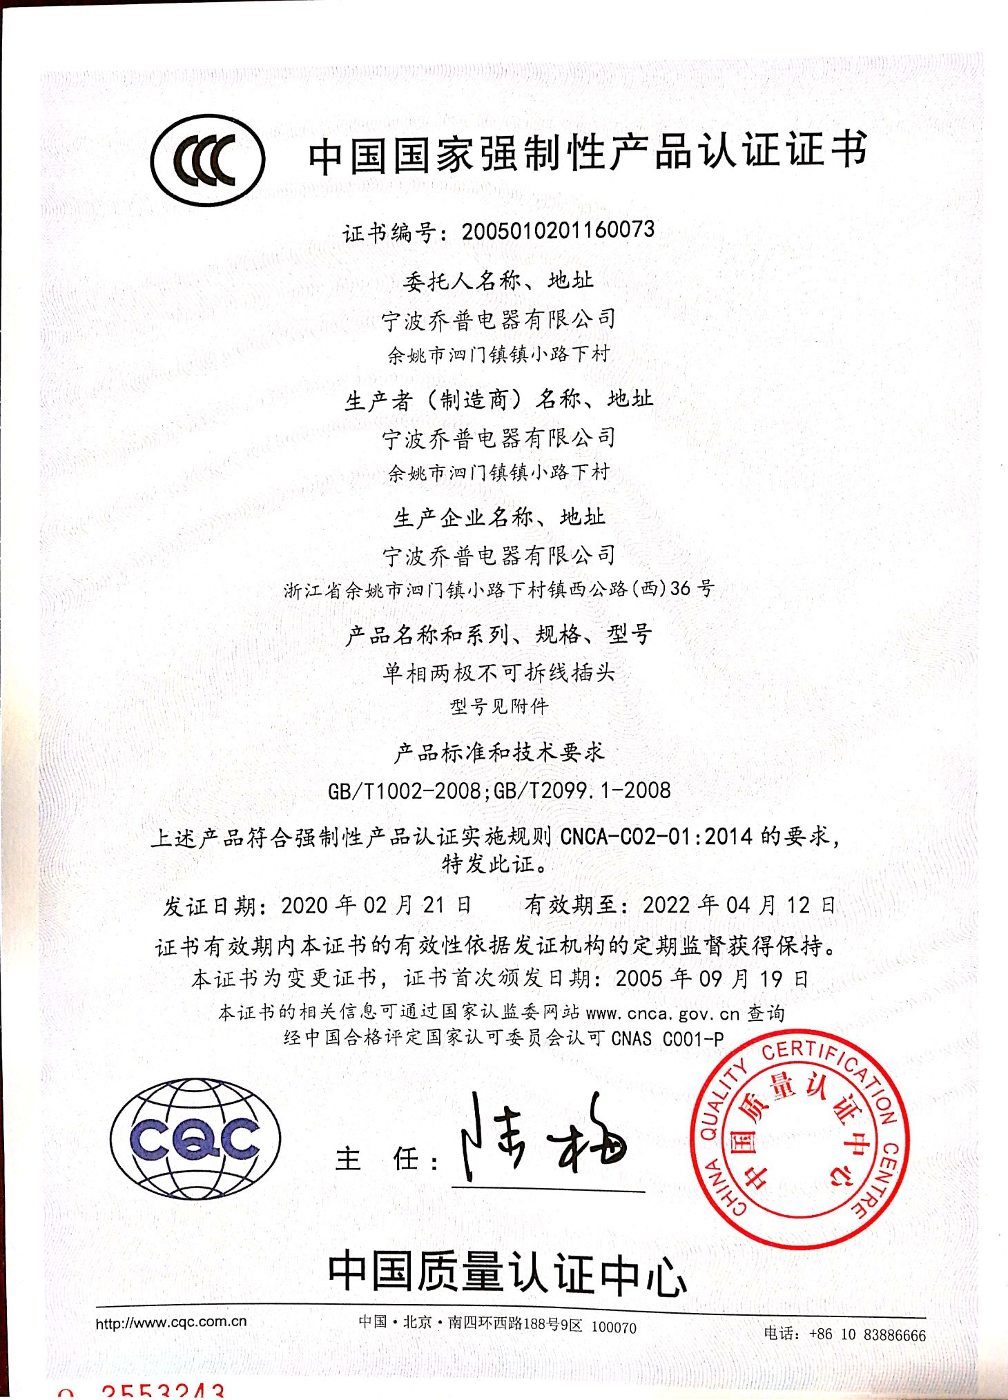
[picture p302: page 1]
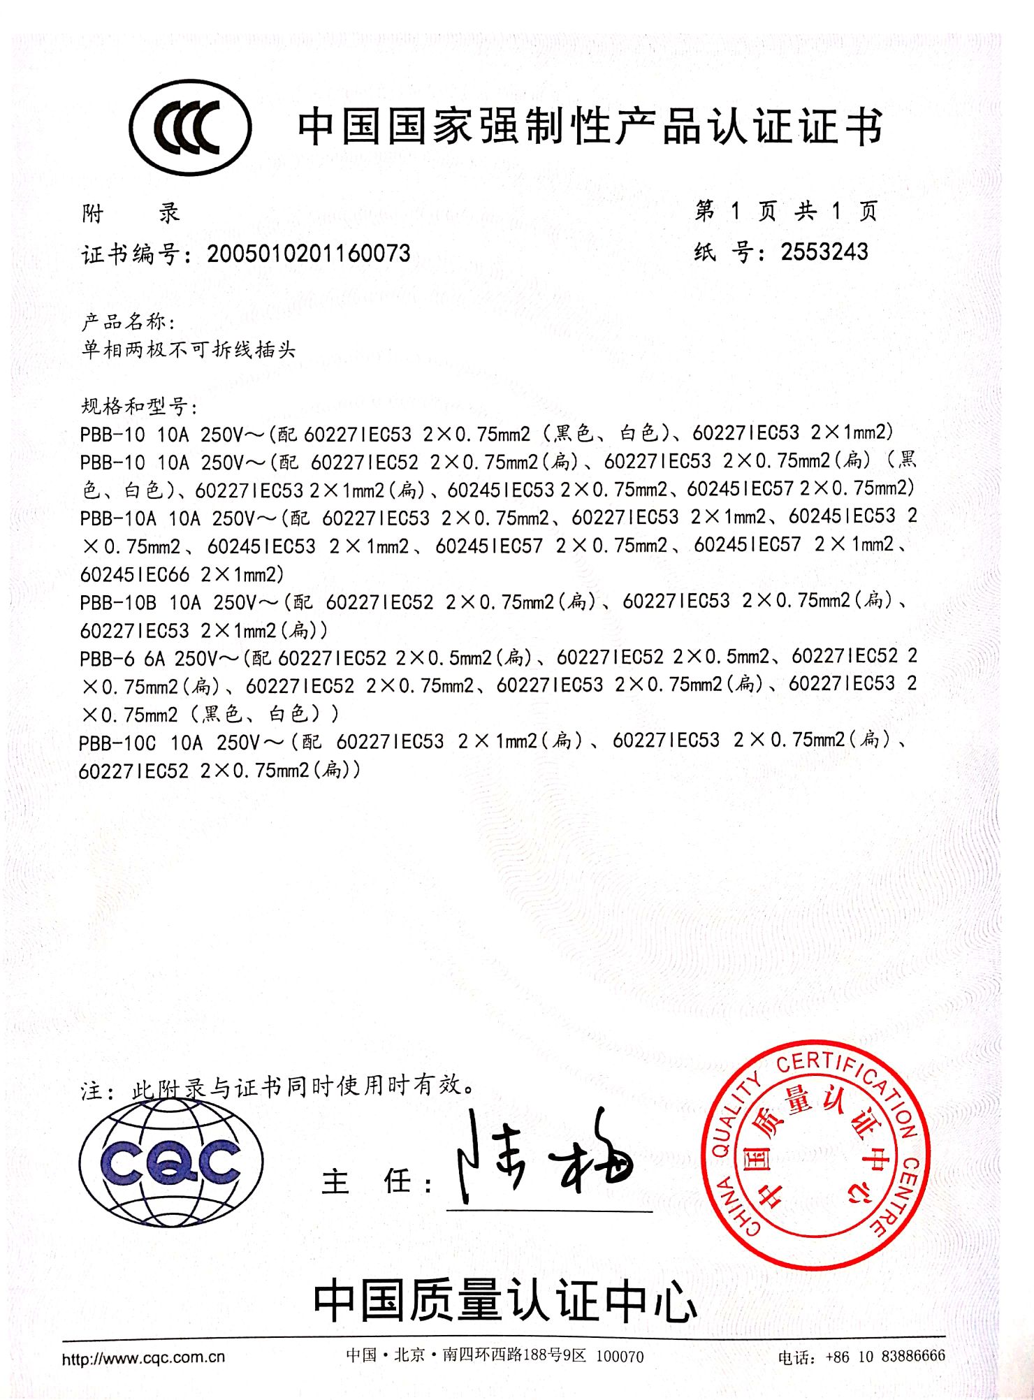
[picture p303: page 2]
