santan444/MS003/03-设计开发输出阶段/02电子/05物料证书/17.品字电源线/CCC 插头PSB 2019-05.pdf

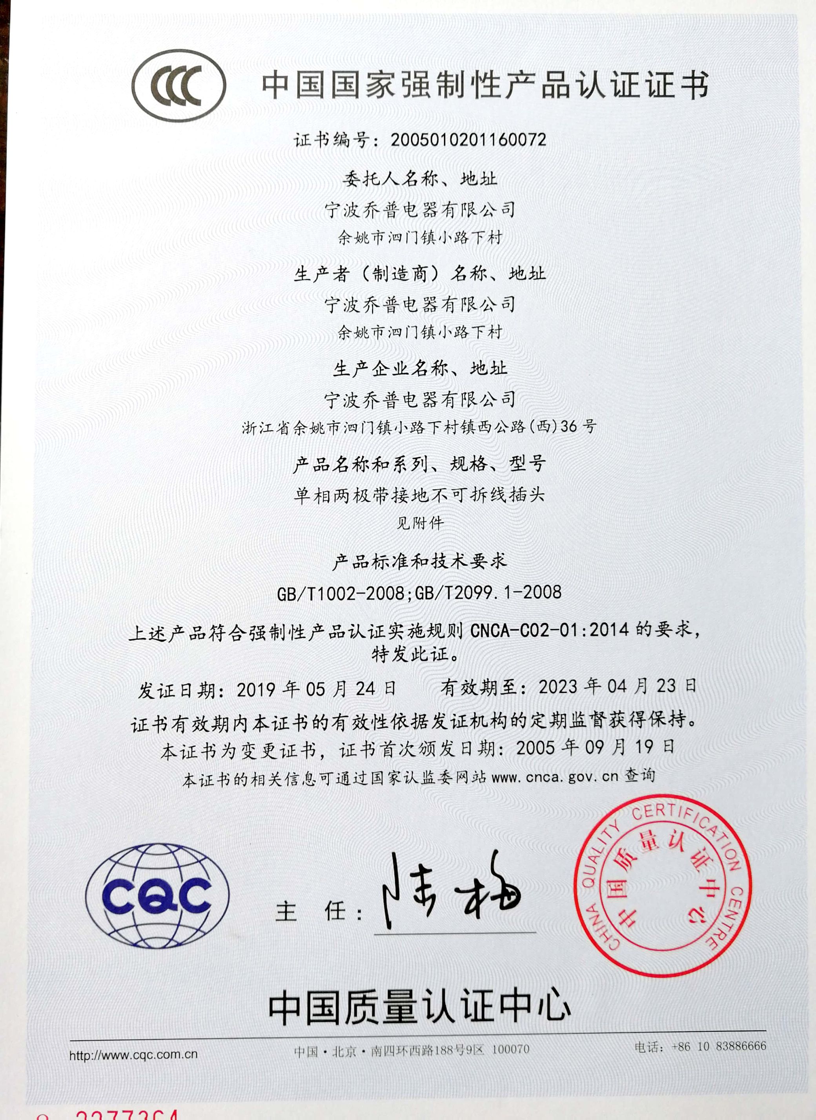
[picture p304: page 1]
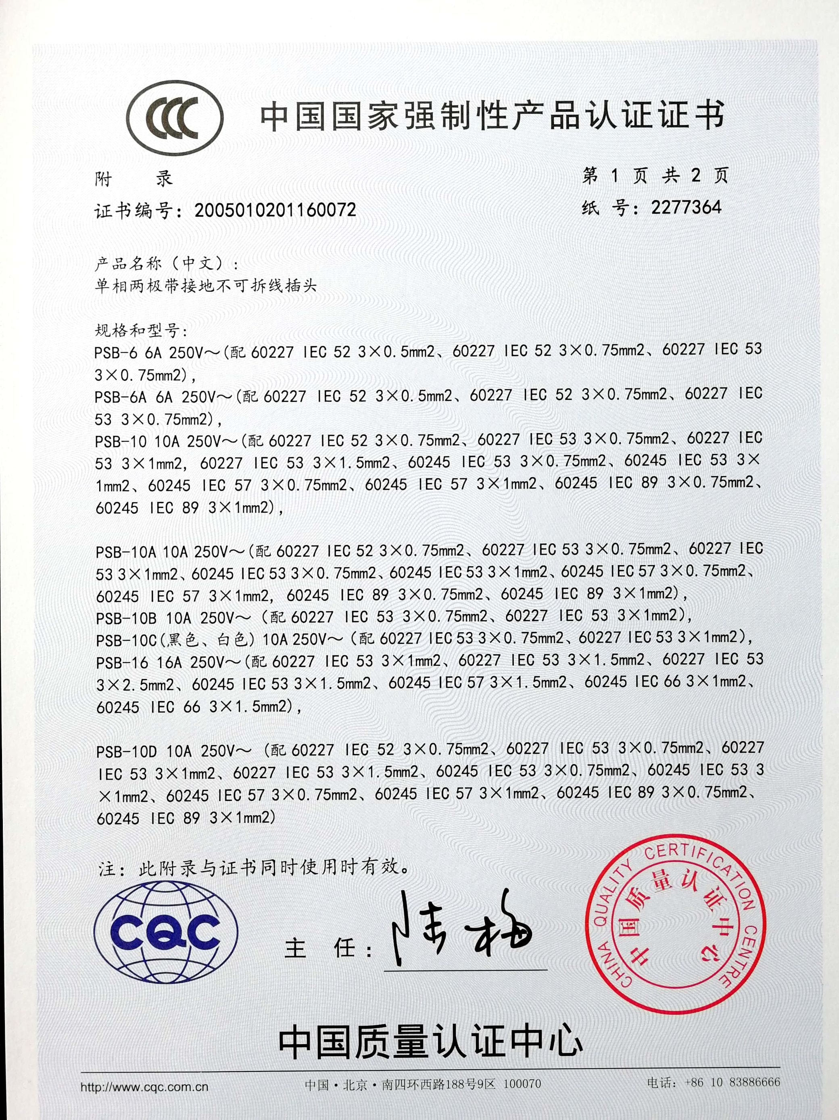
[picture p305: page 2]
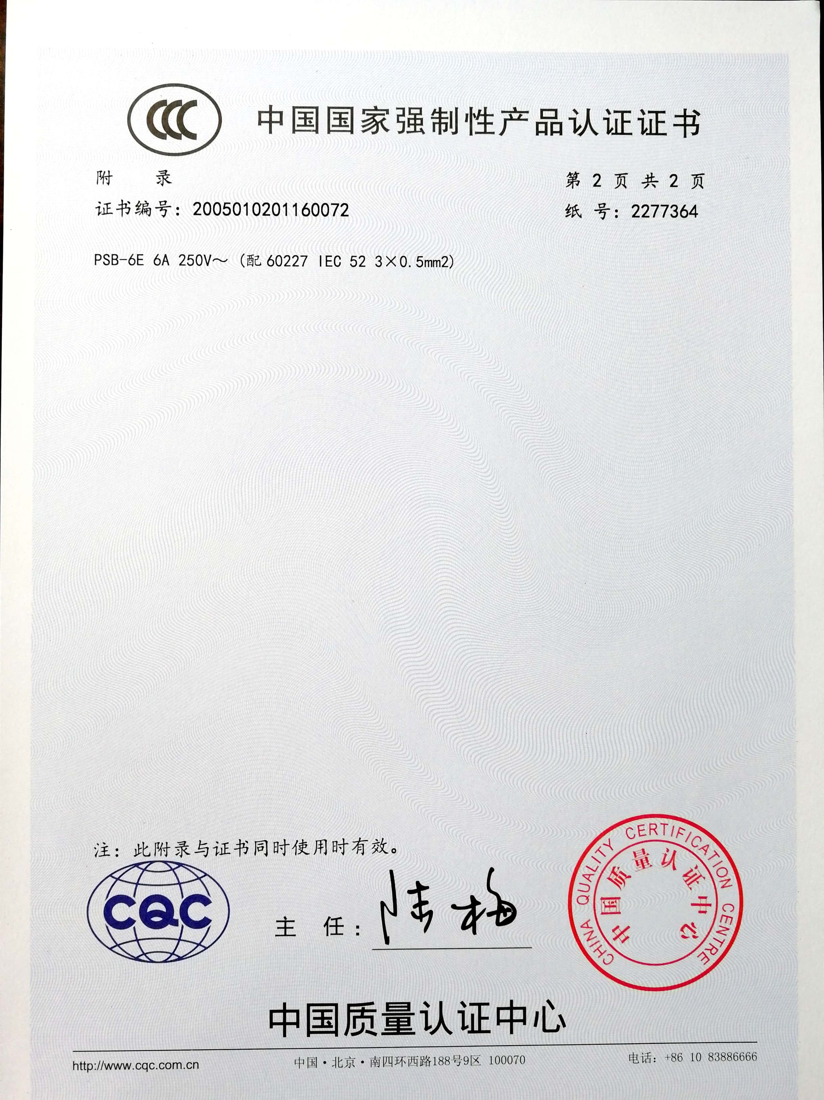
[picture p306: page 3]
