santan444/MS003/03-设计开发输出阶段/02电子/05物料证书/17.品字电源线/CCC 电线PVC 2020-01.pdf

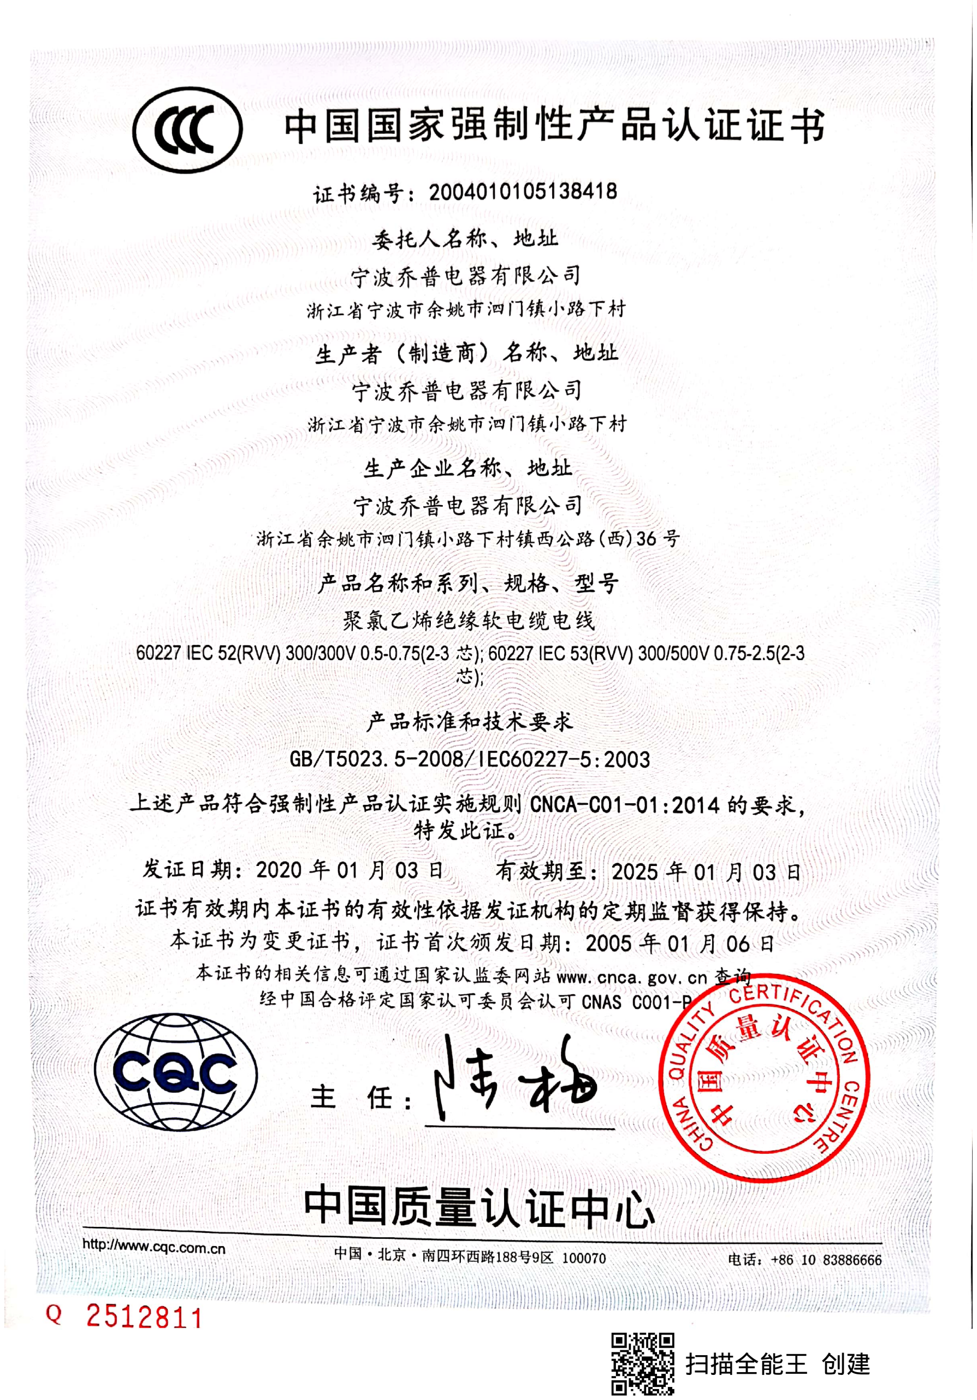
[picture p307: page 1]

扫描全能王 创建
