santan444/MS003/03-设计开发输出阶段/02电子/05物料证书/17.品字电源线/电源线3C证书.pdf

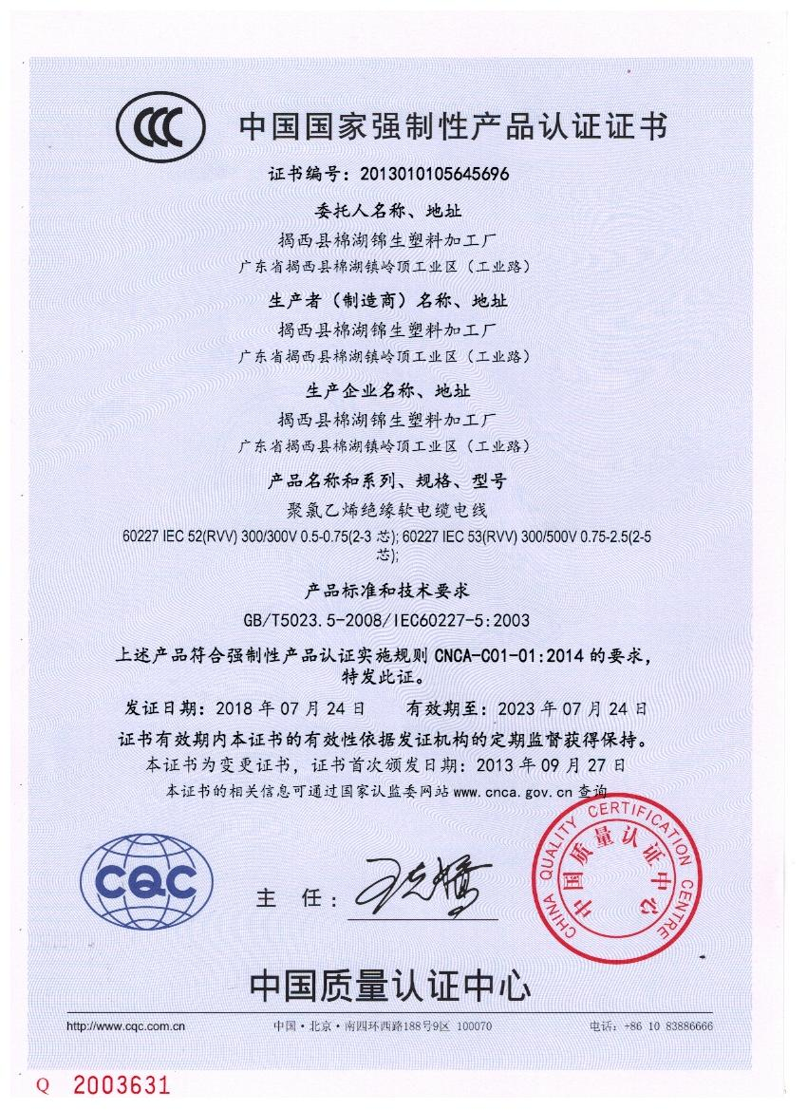
[picture p308: page 1]
