santan444/MS003/03-设计开发输出阶段/02电子/05物料证书/18.内部网电源电线/杰铸1007CCC报告.pdf

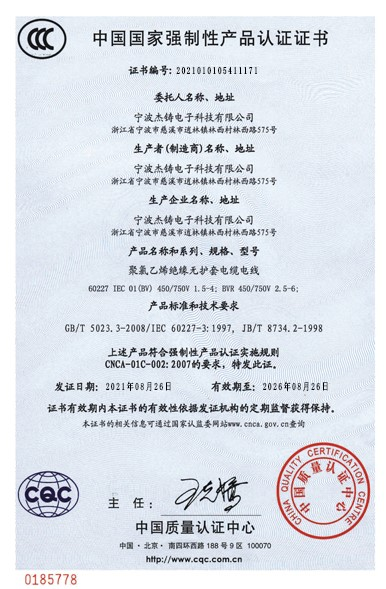
[picture p309: page 1]
