santan444/MS003/03-设计开发输出阶段/02电子/05物料证书/2.双目相机Polaris Vega ST/FM-10311- Polaris Vega EC Declaration of Conformity R03.pdf

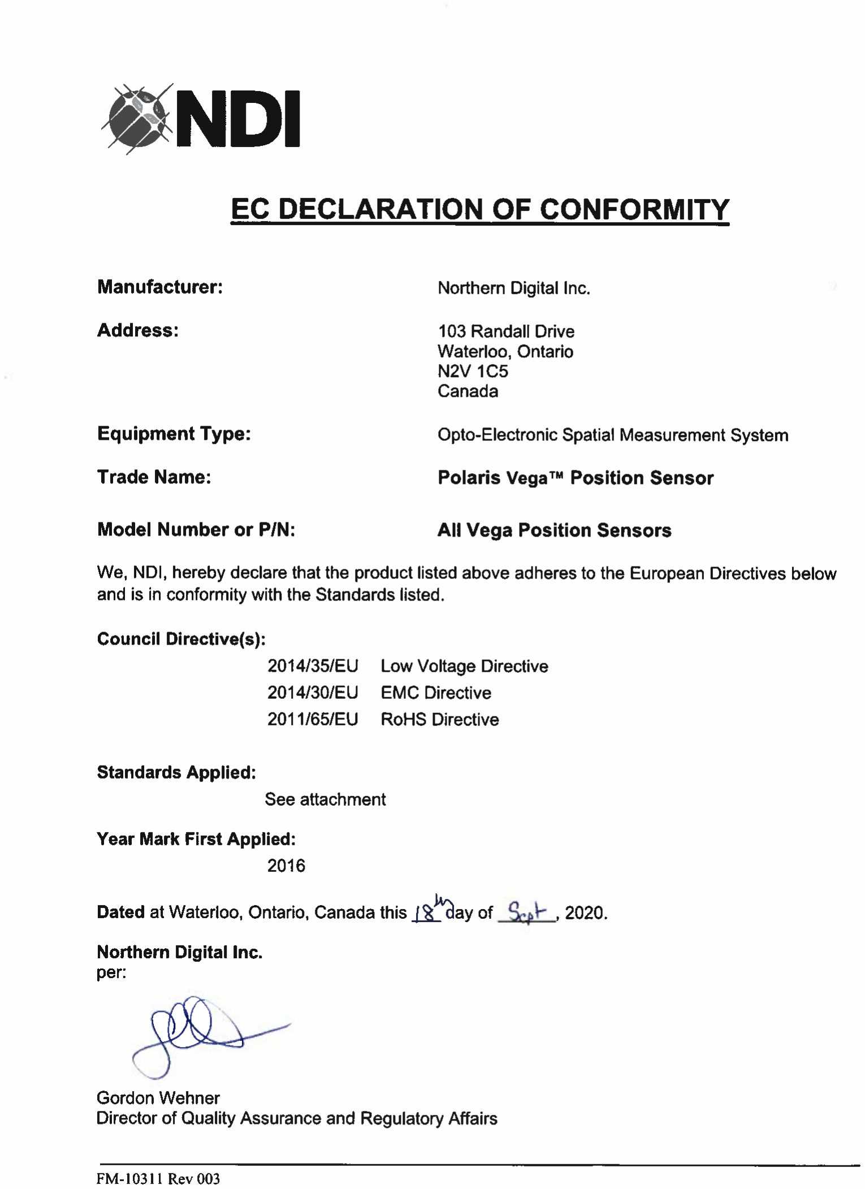
[picture p310: page 1]
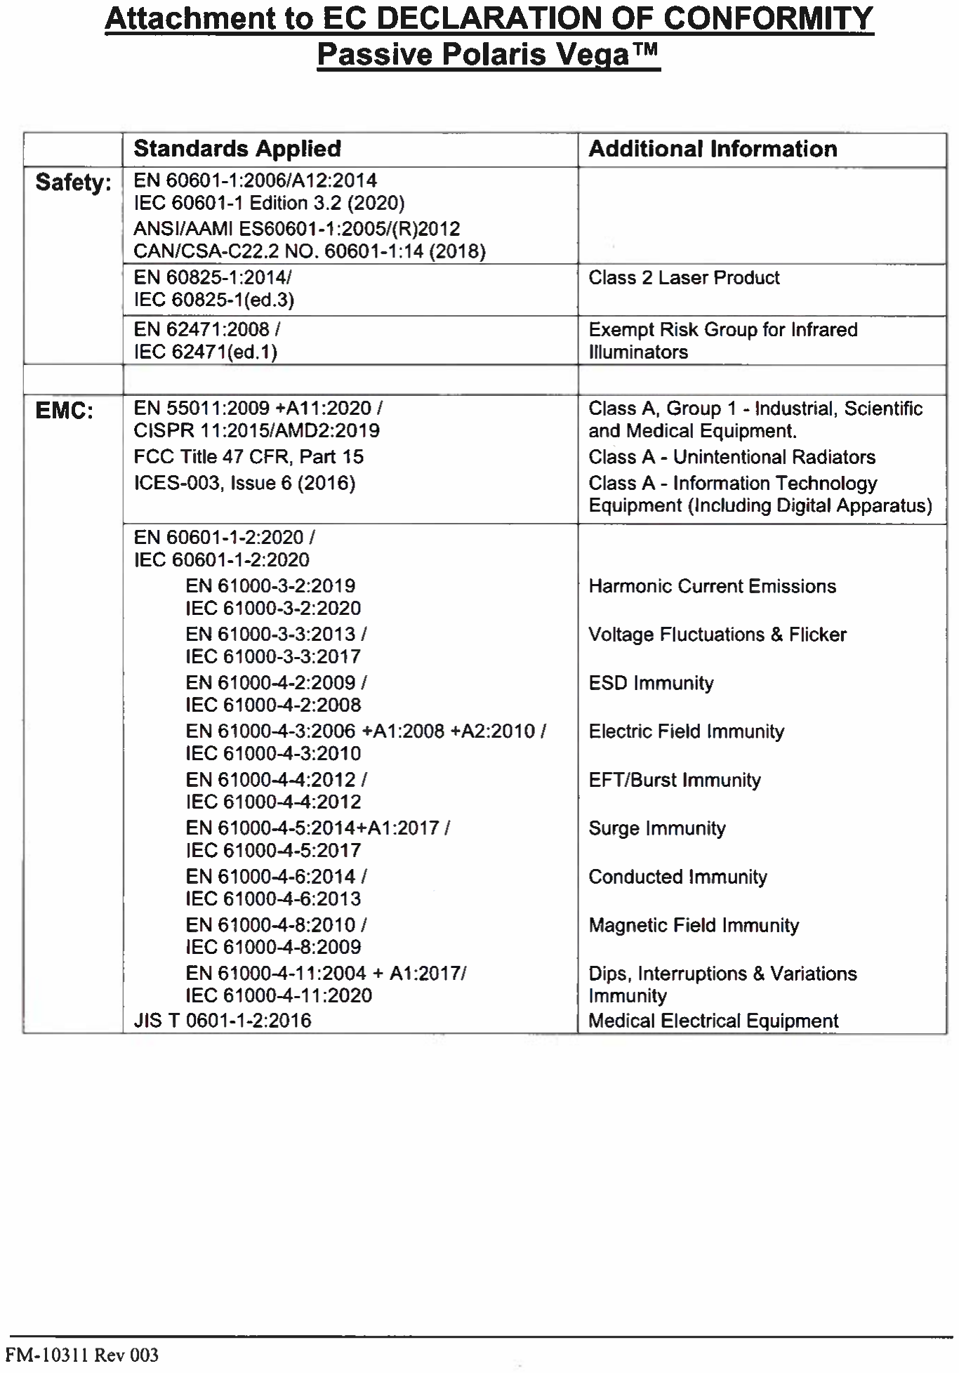
[picture p311: page 2]
