santan444/MS003/03-设计开发输出阶段/02电子/05物料证书/3.显示器睿显MS27STPA/MS27STPA CCC证书(MSXXXX通用证书).pdf

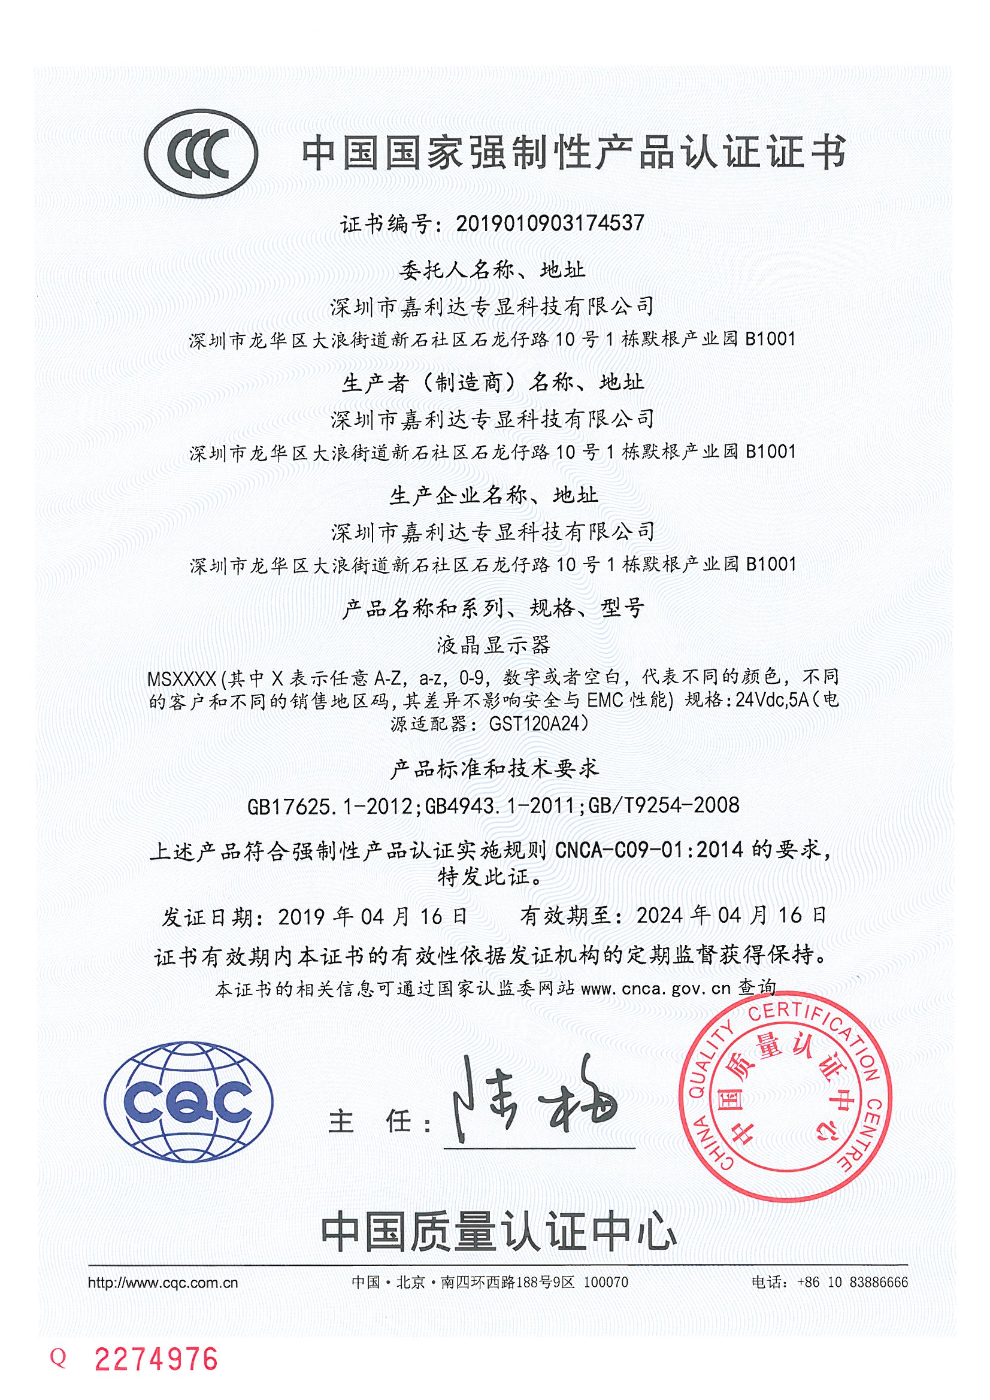
[picture p312: page 1]
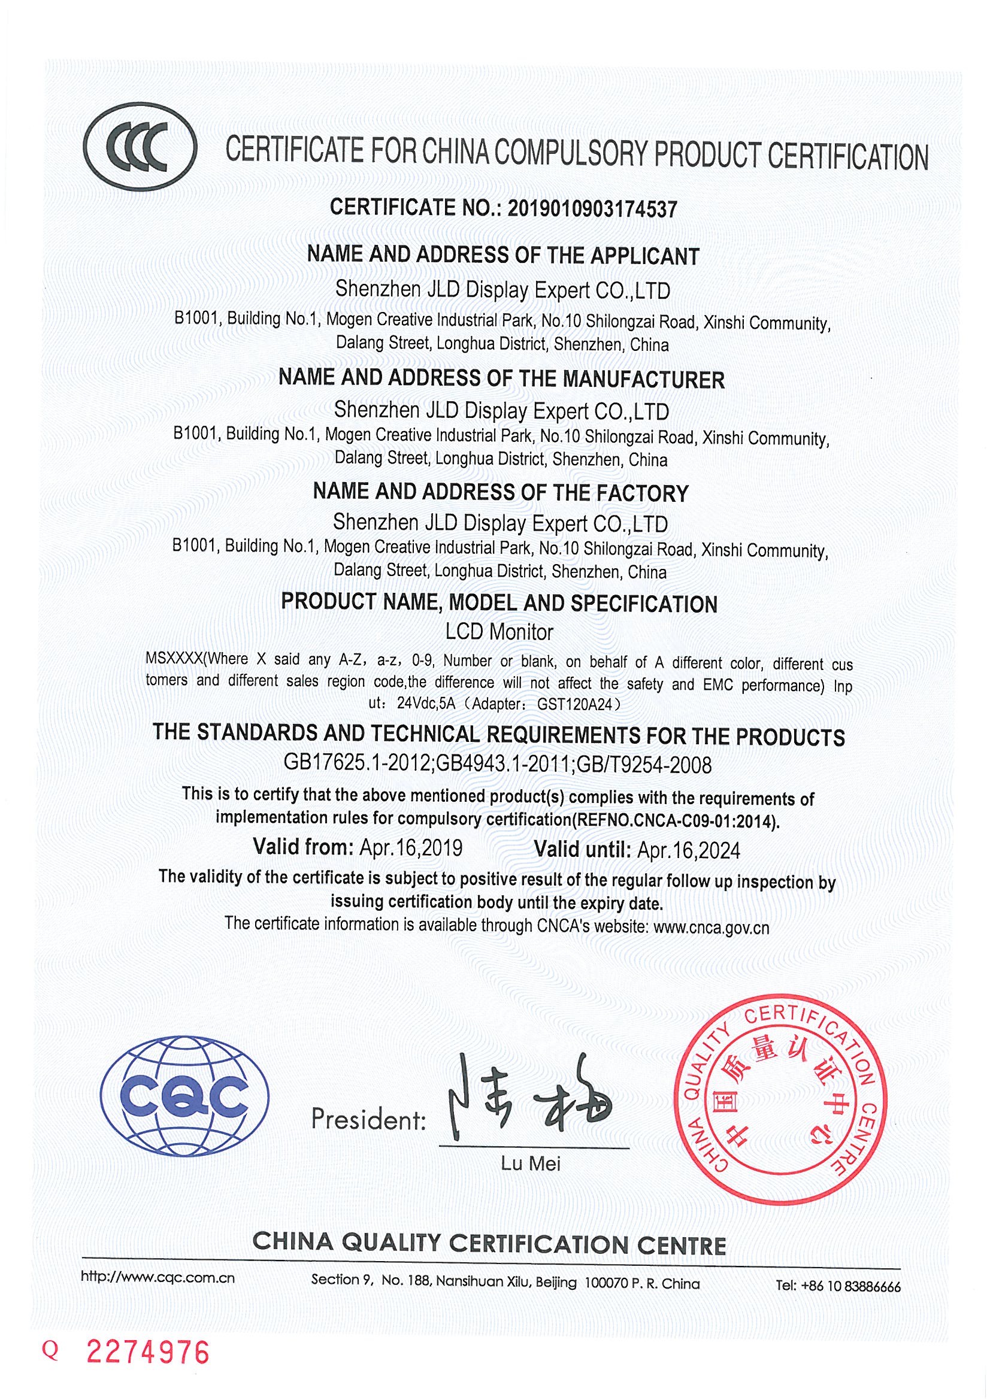
[picture p313: page 2]
