santan444/MS003/03-设计开发输出阶段/02电子/05物料证书/4.UPS UPS2000-G-1KRTL/Certificate-TLC-UPS2000-G-(1KRTL-3KRTL).pdf

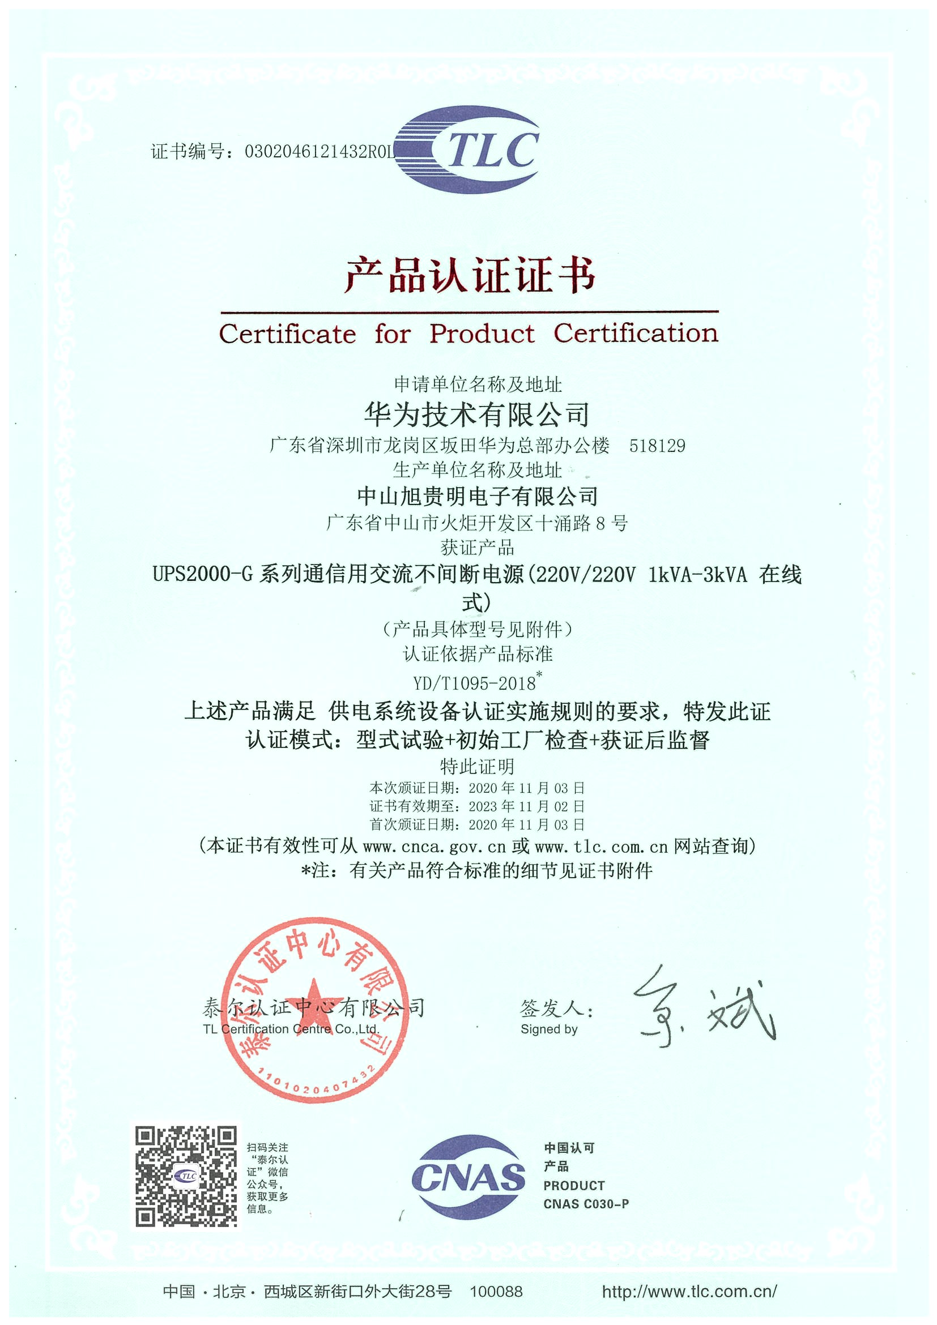
[picture p314: page 1]
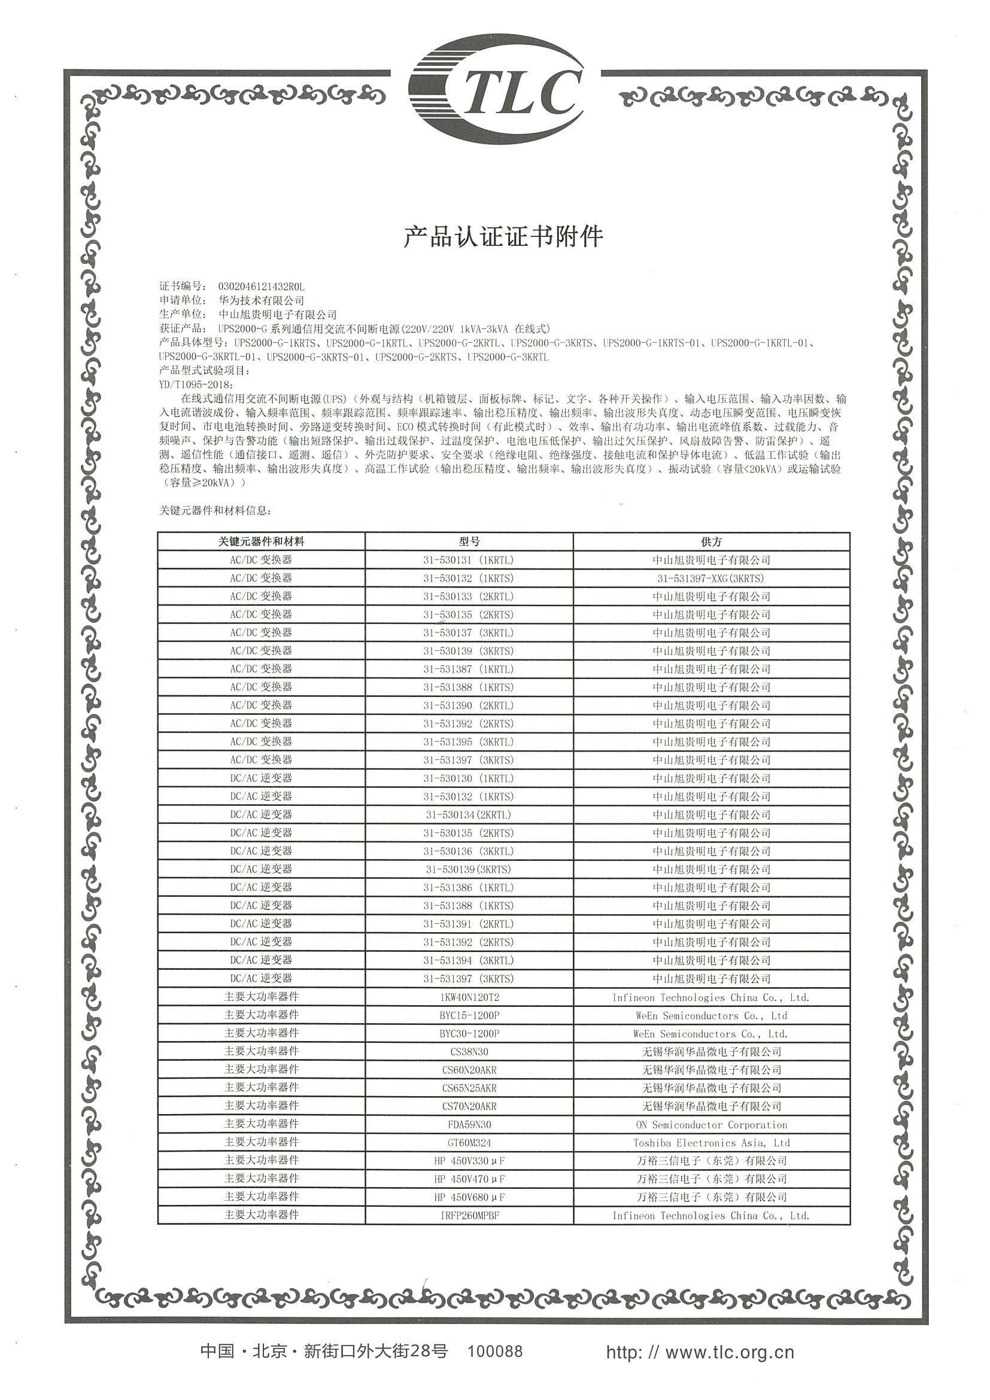
[picture p315: page 2]
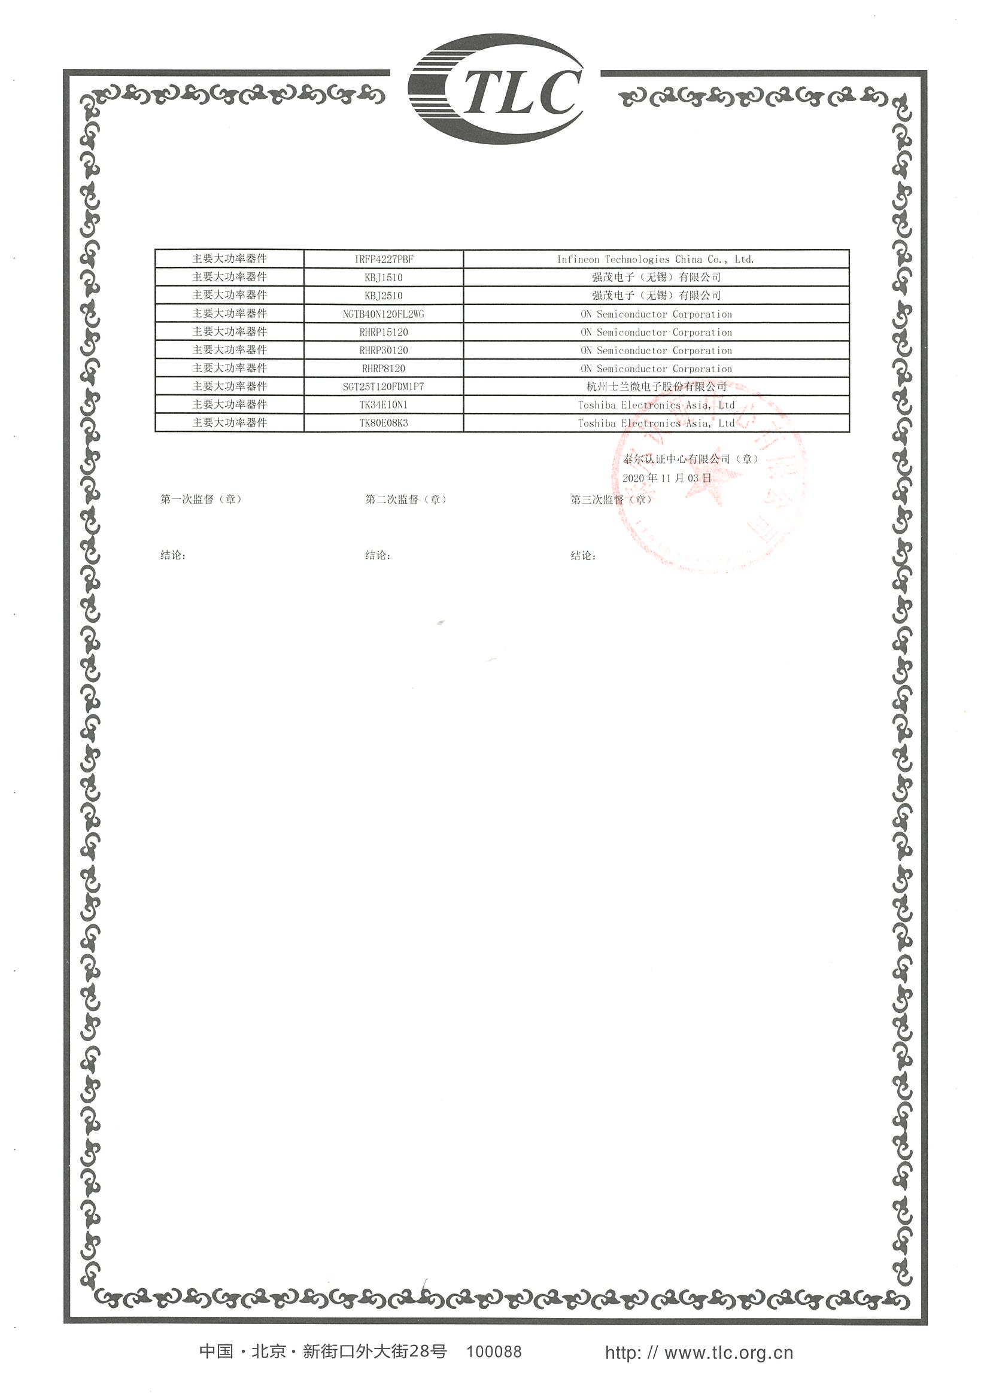
[picture p316: page 3]
