santan444/MS003/03-设计开发输出阶段/02电子/05物料证书/5.立柱HB-DJ825/CE certificate LCS170515090AE-825.pdf

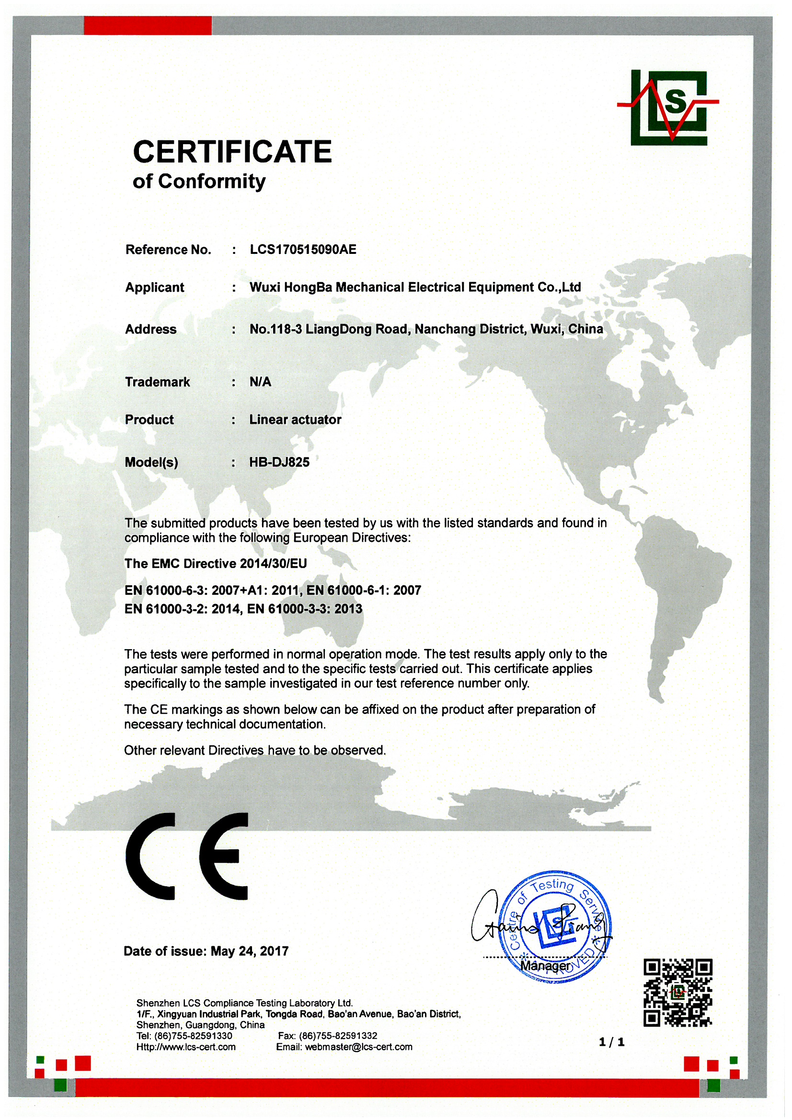
[picture p317: page 1]
