santan444/MS003/03-设计开发输出阶段/02电子/05物料证书/8.开关电源/MPM-45,65,90-TUV-cer.pdf

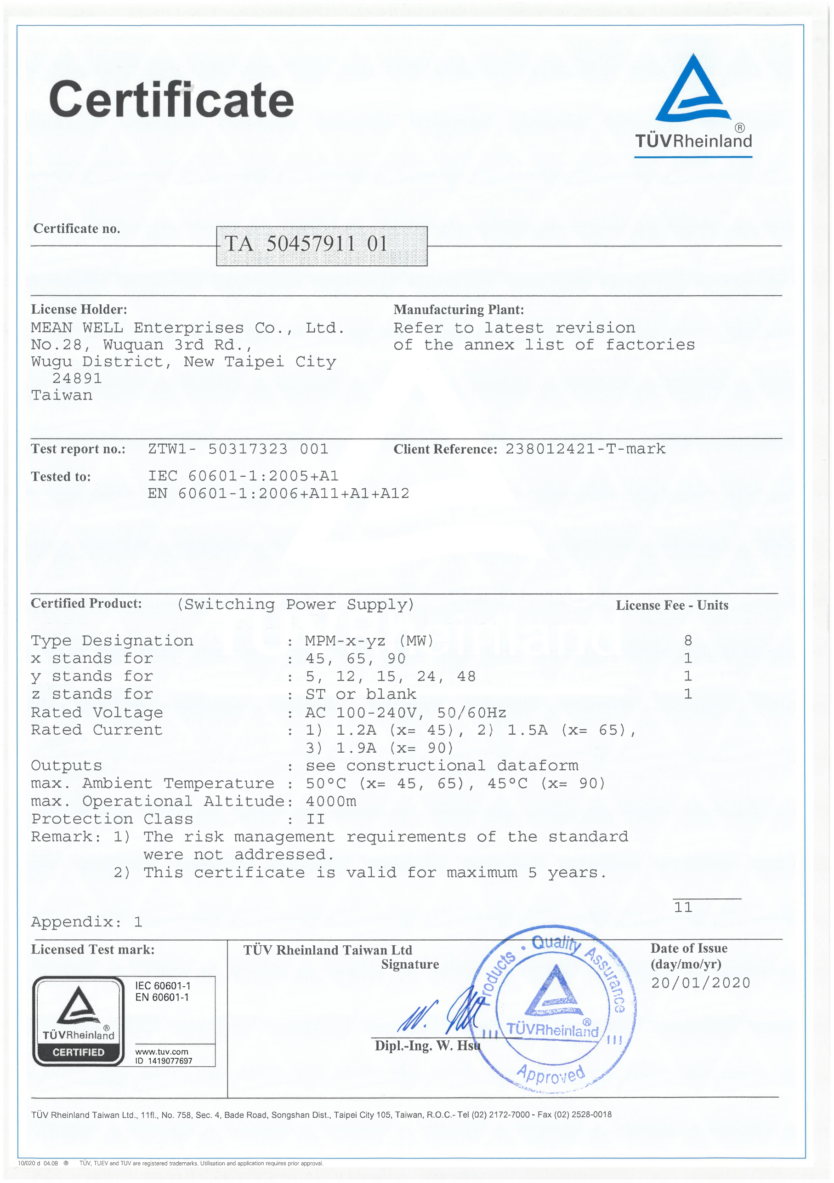
[picture p318: page 1]
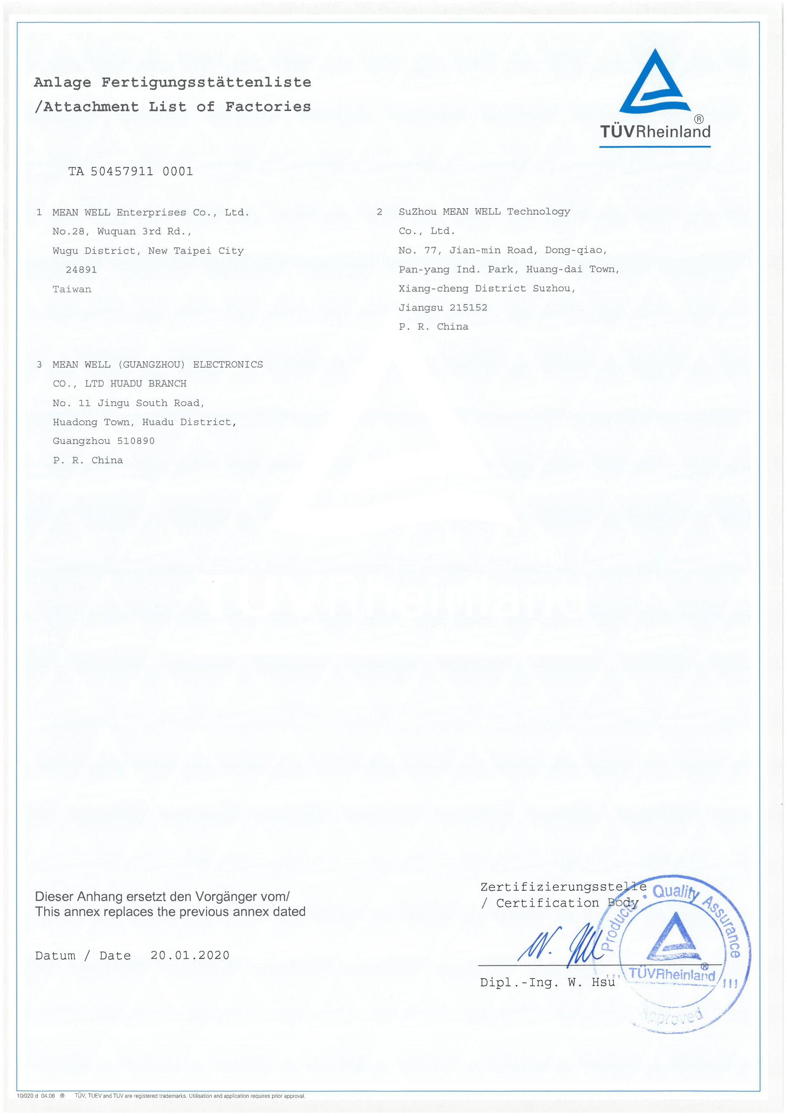
[picture p319: page 2]
