santan444/MS003/03-设计开发输出阶段/02电子/07电子物料表/MS-003 三个台车电子BOM.xls

Sheet: 导航台车
三坛医疗 |  |  | 组件名称 | 导航台车 | 组件物料 明细表 |  | 编制/日期 | 审核/日期 | 批准/日期
产品型号 |  | MS-003 | 文件号
序号 | 物料等级 | 物料编码 | 图号/标准 | 名称 | 数量 | 材料 | 规格 | 备注 | 参考 供应商
加工件明细（线缆图）
 | B |  | MS-003.20T101 | 导航台车电源输入线 | 1 |  |  | 自制线
 | B |  | MS-003.20T102 | 导航台车笔记本适配器输入线 | 1 |  |  | 自制线，笔记本自带电源线制作
 | B |  | MS-003.20T103 | 导航台车开关电源输入线 | 1 |  |  | 自制线
 | B |  | MS-003.20T104 | 导航台车显示器电源线 | 1 |  |  | 自制线，显示器自带电源线制作
 | B |  | MS-003.20T111 | 导航台车HDMI一分二电源线 | 1 |  |  | 自制线，HDMI一分二自带线制作
 | B |  | MS-003.20T112 | 导航台POE交换机电源输入线 | 1 |  |  | 自制线
 | C |  | MS-003.20T115 | 导航台车灯带驱动板电源线 | 1 |  |  | 自制线
 | C |  | MS-003.20T116 | 导航台车灯带线 | 1 |  |  | 自制线
 | B |  | MS-003.20T161 | 导航台车输入接地线 | 1 |  |  | 自制线
 | B |  | MS-003.20T162 | 导航台车显示器接地线 | 1 |  |  | 自制线
 | B |  | MS-003.20T164 | 导航台车开关电源接地线 | 1 |  |  | 自制线
 | B |  | MS-003.20T165 | 导航台车双目相机接地线 | 1 |  |  | 自制线
标准采购件明细（外购的各类机电类零部件、元器件等）
1 | B | 611010217 |  | 电源接入连接器 | 1 |  | DD12.9321.111 |  | 得捷电子/schurter
2 | B | 611010147 |  | 保险丝座 | 1 |  | 4301.1403 |  | 得捷电子/schurter
3 | B | 611010268 |  | 熔断器 | 2 |  | F5AL250V
4 | B | 611010569 |  | 快速接线端子 | 1 |  | KC-6601 | 双色二进四出(固定款) | 汇君
5 | B | 611010570 |  | 开关电源650W | 1 |  | NMP650-CEHK | 输出5V，12V，24V，48V | 明纬
6 | B | 611010435 |  | 27寸显示器 | 1 |  | MS27STPA | 带显示器电源适配器和HDMI线 | 深圳市嘉利达专显科技有限公司（睿显）
7 | B | 611010582 |  | 戴尔笔记本 | 1 |  | 游匣G16 7630-1948W | 自带适配器 | 戴尔
8 | A | 611010434 |  | 双目相机 | 1 |  | Polaris Vega ST | 自带双目相机电源适配器 | Northern Digital Inc
9 | B | 611010583 |  | poe交换机 | 1 |  | TL-SG2105P | POE，5口工业交换机 | TP-LINK
10 | B | 611010581 |  | HDMI分屏器 | 1 |  | MT-SP102M | 一进二出 | 迈拓维矩
11 | B | 611010577 |  | HDMI插座 | 1 |  | VL24Y-HDMI-2 | 银色 | 罗科斯通
12 | B | 611010575 |  | RJ45网口插座 | 1 |  | RAD24-C6A-S | 银色 | 罗科斯通
13 | B | 611010576 |  | USB 插座 | 2 |  | RAU3D24-C | 银色 | 罗科斯通
14 | C | 611010445 |  | 键盘 | 1 |  | MX keys mini | 无接收器 | 罗技
15 | C | 611010588 |  | 鼠标 | 1 |  | MX Anywhere3S |  | 罗技
16 | C | 611010523 |  | Bolt接收器 | 1 |  | Bolt | 支持鼠标和键盘 | 罗技
17 | B | 611010589 |  | 网线 | 1 |  | 八类万兆双屏蔽网线【右弯对直头】 1米 | 1m | 炬信科技（JUXIN）
18 | B | 611010590 |  | 网线 | 1 |  | 八类万兆双屏蔽网线【右弯对直头】 3米 | 3m | 炬信科技（JUXIN）
19 | B | 611010453 |  | 网线 | 2 |  | W200I/CAT8/5m | 5m | 晶华
20 | B | 611010510 |  | 网线 | 1 |  | W200M/CAT8/15m | 15m | 晶华
21 | B | 611010513 |  | HDMI线 | 3 |  | HDMI | 睿显自带线缆(可询问厂家能否2根2m,1根0.5m) | 睿显
22 | B | 611010591 |  | 双头usb数据线 | 2 |  | 黑色右右公对公USB3.0 约25厘米 | https://item.jd.com/10066496520119.html
23 | B | 611010454 |  | 品字电源线-2.5平方 | 1 |  | 3芯x2.5平方 5米 | 5m
24 | C | 610130039 | MS-003.24T001 | 灯带驱动板 | 1 |  | MS-003.24T001
25 | C | 610130035 |  | 台车LED灯带 | 1 |  | 2m/每米720珠cob幻彩RGB |  | NIOYE(欧尼意)
26
27
28
29
30

Sheet: 执行台车
三坛医疗 |  |  | 组件名称 | 执行台车 | 组件物料 明细表 |  | 编制/日期 | 审核/日期 | 批准/日期
产品型号 |  | MS-003 | 文件号
序号 | 物料等级 | 物料编码 | 图号/标准 | 名称 | 数量 | 材料 | 规格 | 备注 | 参考 供应商
加工件明细（线缆图）
 | B |  | MS-003.20T201 | 执行台车电源输入线 | 1 |  |  | 自制线
 | B |  | MS-003.20T202 | 执行台车电源指示灯线 | 1 |  |  | 自制线
 | B |  | MS-003.20T203 | 执行台车隔离变压器火 线初级 | 1 |  |  | 自制线
 | B |  | MS-003.20T204 | 执行台车UPS输入电源线 | 1 |  |  | 自制线，用UPS自带电源线制作
 | B |  | MS-003.20T205 | 执行台车UPS输出电源线1 | 1 |  |  | 自制线，611010599电源线制作
 | B |  | MS-003.20T206 | 执行台车UPS输出电源线2 | 1 |  |  | 自制线，611010599电源线制作
 | B |  | MS-003.20T207 | 执行台车风扇电源线 | 1 |  |  | 自制线，风扇自带电源线制作
 | B |  | MS-003.20T208 | 执行台车CEHK开关电源 输入线 | 1 |  |  | 自制线
 | B |  | MS-003.20T209 | 执行台车12V开关电源输 入线 | 1 |  |  | 自制线
 | B |  | MS-003.20T210 | 执行台车末端工具连接 器线缆 | 1 |  |  | 自制线，机械臂自带线制作
 | B |  | MS-003.20T211 | 执行台车接触器输入线 | 1 |  |  | 自制线
 | B |  | MS-003.20T212 | 执行台车机械臂控制柜 电源线 | 1 |  |  | 自制线，机械臂自带线制作
 | B |  | MS-003.20T213 | 执行台车交换机电源线 | 1 |  |  | 自制线，交换机自带电源线制作
 | B |  | MS-003.20T214 | 执行台车12V骨钻电源线 | 1 |  |  | 自制线
 | B |  | MS-003.20T215 | 执行台车末端骨钻电源 线 | 1 |  |  | 自制线
 | B |  | MS-003.20T216 | 执行台车升降控制板电 源线 | 1 |  |  | 自制线
 | B |  | MS-003.20T217 | 执行台车台车控制板电 源线 | 1 |  |  | 自制线
 | C |  | MS-003.20T220 | 执行台车末端灯光使能 线 | 1 |  |  | 自制线
 | B |  | MS-003.20T222 | 执行台车UPS充电指示灯 线 | 1 |  |  | 自制线
 | B |  | MS-003.20T223 | 执行台车机械臂带灯按钮线 | 1 |  |  | 自制线，按钮座自带线制作
 | B |  | MS-003.20T224 | 执行台车脚踏信号输入 线 | 1 |  |  | 自制线
 | C |  | MS-003.20T226 | 执行台车脚踏信号输出 线 | 1 |  |  | 自制线
 | B |  | MS-003.20T227 | 执行台车灯带驱动板信 号线 | 1 |  |  | 自制线
 | B |  | MS-003.20T228 | 执行台车灯带线 | 1 |  |  | 自制线
 | B |  | MS-003.20T229 | 执行台车升降立柱1自带线 | 1 |  |  | 自制线
 | B |  | MS-003.20T230 | 执行台车升降立柱2自带线 | 1 |  |  | 自制线
 | B |  | MS-003.20T231 | 执行台车升降立柱3自带线 | 1 |  |  | 自制线
 | B |  | MS-003.20T232 | 执行台车升降立柱4自带线 | 1 |  |  | 自制线
 | B |  | MS-003.20T233 | 执行台车升降按钮线 | 1 |  |  | 自制线，按钮座自带线制作
 | B |  | MS-003.20T236 | 执行台车急停开关线 | 1 |  |  | 自制线
 | B |  | MS-003.20T244 | 执行台脚踏线 | 1 |  |  | 自制线，脚踏自带线制作
 | C |  | MS-003.20T245 | 执行台车灯带驱动板电 源线 | 1 |  |  | 自制线
 | B |  | MS-003.20T246 | 执行台车脚踏电源线 | 1 |  |  | 自制线
 | B |  | MS-003.20T261 | 执行台车输入接地线 | 1 |  |  | 自制线
 | B |  | MS-003.20T262 | 执行台车隔离变压器接 地线 | 1 |  |  | 自制线
 | B |  | MS-003.20T263 | 执行台车UPS接地线 | 1 |  |  | 自制线
 | B |  | MS-003.20T264 | 执行台车CEHK开关电源 接地线 | 1 |  |  | 自制线
 | B |  | MS-003.20T265 | 执行台车12V开关电源接 地线 | 1 |  |  | 自制线
 | B |  | MS-003.20T266 | 执行台车机械臂控制柜 接地线 | 1 |  |  | 自制线
标准采购件明细（外购的各类机电类零部件、元器件等）
1 | B | 611010217 |  | 电源接入连接器 | 1 |  | DD12.9321.111 |  | 得捷电子/schurter
2 | B | 611010147 |  | 保险丝座 | 1 |  | 4301.1403 |  | 得捷电子/schurter
3 | B | 611010268 |  | 熔断器 | 2 |  | F5AL250V |  | 富轩电子
4 | B | 611010569 |  | 快速接线端子 | 2 |  | KC-6601 | 双色二进四出(固定款) | 汇君
5 | B | 611010570 |  | 开关电源650W | 1 |  | NMP650-CEHK | 输出5V，12V，24V，48V | 明纬
6 | B | 611010571 |  | 开关电源450W-12V | 1 |  | MSP-450-12 |  | 明纬
7 | B | 611010573 |  | UPS | 1 |  | UPS2000-G-1KRTS | 自带电源线和A口转B口USB线缆 | 华为技术有限公司
8 | B | 611010438 |  | 隔离变压器 | 1 |  | T8BFN-85419 (TTO-85419-00L) |  | 河源天裕电子塑胶有限公司
9 | B | 611010206 |  | 铝壳电阻 | 1 |  | RX24-200W-4ΩJ
10 | A | 611010574 |  | 机械臂 | 1 |  | LBR Med 14 R820 |  | KUKA
11 | C | 611010288 |  | 电源指示灯-220V | 1 |  | GQ8T-DLGAC220VN | 绿色，带线 | 红波
12 | C | 611010515 |  | 电源指示灯-6V | 1 |  | GQ8T-DLGDC6VN | 绿色，带线 | 红波
13 | B | 611010575 |  | RJ45网口插座 | 2 |  | RAD24-C6A-S | 银色 | 罗科斯通
14 | B | 611010576 |  | USB 插座 | 1 |  | RAU3D24-C | 银色 | 罗科斯通
15 | B | 610060070 |  | 航空插头 | 1 |  | 2K-T1-3P plug | 金属原色 | 莫科连
16 | B | 610060071 |  | 航空插座 | 1 |  | 2K-Z7-3P socket | 金属原色 | 莫科连
17 | B | 611010578 |  | 航空插头 | 2 |  | 2K-T1-6P plug | 金属原色 | 莫科连
18 | B | 611010579 |  | 航空插座 | 1 |  | 2K-Z7-6P socket | 金属原色 | 莫科连
19 | B | 613010018 |  | M8连接器 | 5 |  | M8直头4针公头带线两米 |  | 东菀市代唯电子
20 | B | 613010017 |  | M8连接器 | 5 |  | M8直头4孔母头带线两米 |  | 东菀市代唯电子
21 | B | 611010593 |  | M8连接器 | 4 |  | M8直头6针公头带线两米 |  | 东菀市代唯电子
22 | B | 611010594 |  | M8连接器 | 4 |  | M8直头6孔母头带线两米 |  | 东菀市代唯电子
23 | B | 611010561 |  | 16mm金属带灯按钮 （蓝色圆圈符号) | 1 |  | HBS1-AGQ16F 电源符号【自锁】220V蓝色 |  | 红波
24 | B | 611010562 |  | AGQ按钮接插线 | 1 |  | HB-T1 五线 | 线长1m | 红波
25 | B | 611010122 |  | 16mm金属带灯按钮 （绿色箭头符号） | 2 |  | FY1B-A/16F-10F/箭头/G24 | 单独按钮，电压24V 自复位常开，平头 | FERNYE/丰奕电气
26 | B | 611010125 |  | 16mm金属按钮插座 | 2 |  | 16mm金属按钮插座 | 与16mm金属按钮配套使用 预留线定制 （长1.5m） | FERNYE/丰奕电气
27 | B | 611010427 |  | 急停开关 | 1 |  | PB1S-02ZR-R | 红色，两常闭，底座型号为PB1-F-C01 | APT
28 | B | 611010140 |  | 8口交换机 | 1 |  | TEG1008M | 电源线使用自带适配器线改装 | 腾达
29 | B | 611010595 |  | 散热风扇 | 2 |  | 9厘米/厚度2.5厘米/12V静音 |  | 台达
30 | B | 611010437 |  | 立柱 | 4 |  | HB-DJ825 | 24V供电 60毫米行程 6mm/s 1500N，带霍尔编码器，IP54 | 无锡宏霸机电
31 | B | 611010596 |  | 接触器 | 1 |  | ICT 2P 2NO 230~240V 16A |  | 施耐德
32 | B | 611010584 |  | 骨钻 | 1 |  | 5107B |  | 博进
33 | B | 611010439 |  | 脚踏 | 1 |  | MKF 2 1PW/1PW-MED GP26 | 有线脚踏 | 世德
34 | B | 611010527 |  | 无线脚踏发射器 | 1 |  | FS82-W-RF（S） | 无线脚踏发射器+无线脚踏接收器 | 三实
35 | B | 611010528 |  | 无线脚踏接收器 | 1 |  | RCV-RF-1A-6 |  | 三实
36 | B | 610130037 | MS-003.21T001 | 台车控制板 | 1 |  | MS-003.21T001
37 | B | 610130028 | MS-002.23T001 | 升降控制板 | 1 |  | MS-002.23T001
38 | B |  | MS-002.25T001 | 末端灯板 | 1
39 | B |  | MS-002.26T001 | 末端连接板 | 1
40 | C | 610130039 | MS-003.24T001 | 灯带驱动板 | 1 |  | MS-003.24T001
41 | B | 611010597 |  | TTL转网口模块 | 2 |  | TAS-LAN-751 |  | TASTEK
42 | B | 611010505 |  | 网线 | 2 |  | W200B/CAT8/0.5m | 0.5m | 晶华
43 | B | 611010558 |  | 网线 | 3 |  | W200C/CAT8/1m | 1m | 晶华
44 | B | 611010506 |  | USB线 | 1 |  | 公对公/USB3.0 | 1m | 绿联
45 | B | 611010452 |  | USB线 | 1 |  | 公对公/USB2.0 | 1m
46 | B | 611010598 |  | 9针串口线 | 1 |  | DB9公对母/B110E | 1.5m | 晶华
47 | B | 611010599 |  | 品字电源线 | 2 |  | 直插头【1.5米】 | 2500W | 绿联
48 | B | 611010454 |  | 品字电源线-2.5平方 | 1 |  | 3芯x2.5平方 5米 | 5m
49 | C | 610130036 |  | 执行台车LED灯带 | 1 |  | 6m/每米720珠cob幻彩RGB |  | NIOYE(欧尼意)
50
51
52
53
54

Sheet: 操作台车
三坛医疗 |  |  | 组件名称 | 操作台车（可选配） | 组件物料 明细表 |  | 编制/日期 | 审核/日期 | 批准/日期
产品型号 |  | MS-003 | 文件号
序号 | 物料等级 | 物料编码 | 图号/标准 | 名称 | 数量 | 材料 | 规格 | 备注 | 参考 供应商
加工件明细（线缆图）
 | B |  | MS-003.20T301 | 操作台车电源输入线 | 1 |  |  | 自制线
 | B |  | MS-003.20T303 | 操作台车显示器电源线 | 1 |  |  | 自制线，显示器自带电源线制作
 | B |  | MS-003.20T304 | 操作台车鼠标充电线 | 1 |  |  | 自制线，由611010451制作
 | B |  | MS-003.20T305 | 操作台车键盘充电线 | 1 |  |  | 自制线，由611010451制作
 | B |  | MS-003.20T306 | 操作台车视频信号接收器电源线 | 1 |  |  | 自制线，由视频信号接收器自带电源线制作
 | B |  | MS-003.20T307 | 操作台车HDMI切换器电源线 | 1 |  |  | 自制线，由611010451制作
 | C |  | MS-003.20T311 | 操作台车灯带驱动板电 源线 | 1 |  |  | 自制线
 | C |  | MS-003.20T312 | 操作台车灯带线 | 1 |  |  | 自制线
 | B |  | MS-003.20T361 | 操作台车输入接地线 | 1 |  |  | 自制线
 | B |  | MS-003.20T362 | 操作台车显示器接地线 | 1 |  |  | 自制线
 | B |  | MS-003.20T363 | 操作台车开关电源接地 线 | 1 |  |  | 自制线
标准采购件明细（外购的各类机电类零部件、元器件等）
1 | B | 611010217 |  | 电源接入连接器 | 1 |  | DD12.9321.111 |  | 得捷电子/schurter
2 | B | 611010147 |  | 保险丝座 | 1 |  | 4301.1403 |  | 得捷电子/schurter
3 | B | 611010268 |  | 熔断器 | 2 |  | F5AL250V |  | 富轩电子
4 | B | 611010570 |  | 开关电源650W | 1 |  | NMP650-CEHK | 输出5V，12V，24V，48V | 明纬
5 | B | 611010435 |  | 27寸显示器 | 1 |  | MS27STPA | 带显示器电源适配器和HDMI线 | 深圳市嘉利达专显科技有限公司（睿显）
6 | B | 611010580 |  | HDMI切换器 | 1 |  | CM597 | 三进一出 | 绿联
7 | B | 611010577 |  | HDMI插座 | 1 |  | VL24Y-HDMI-2 | 银色 | 罗科斯通
8 | B | 611010513 |  | HDMI线 | 3 |  | HDMI | 睿显自带线缆(可询问厂家能否1根2m,1根0.5m) | 睿显
9 | B | 611010514 |  | HDMI线 | 1 |  | H678I | HDMI2.1/5M | 晶华
10 | B | 611010451 |  | TYPE-C线缆 | 3 |  | US287 | 1.5m | 绿联
11 | B | 611010454 |  | 品字电源线-2.5平方 | 1 |  | 3芯x2.5平方 5米 | 5m
12 | C | 610130039 | MS-003.24T001 | 灯带驱动板 | 1 |  | MS-003.24T001
13 | C | 610130035 |  | 台车LED灯带 | 1 |  | 2m/每米720珠cob幻彩RGB |  | NIOYE(欧尼意)
14
15
16
17
18
19
20
