santan444/MS003/03-设计开发输出阶段/02电子/MS-003.22T001-USB转接板/03_物料清单/MS-003.22W004 USB转接板物料清单 V1.0.xlsx

Sheet: 文档修改履历
文档更改履历
日期 | 版本号 | 修订章节 | 描述 | 作者 | 审核 | 批准
2023.12.18 | V1.0 | 全文 | 文件新编 | 秦铭 | 雷俊勇 | 张巍

Sheet: 物料清单
三坛医疗 |  |  | 组件名称 | USB转接板 |  | 电路板组件 物料明细表 | 编制/日期 |  | 审核/日期 | 批准/日期
产品型号 |  |  | 文件号 | MS-003.22W004 V1.0 |  |  | 秦铭/2023.12.18
电路板组件
组件编码
物料明细
序号 | 物料类型 | 物料编码 | 名称/规格 | 厂家 | 封装 | 位号 | 数量 | 替代编码 | 替代名称/规格 | 替代厂家
1 | 贴片钽电容 | 610027034 | TAJA106K016RNJ | Kyocera AVX | CASE-A_3216 | C3 | 1 |  | TAJA106K016RNJ | AVX
2 | 贴片电容 | 610026014 | CC0603KRX7R9BB104 | 国巨 | C0603 | C4, C5, C8, C9, C10, C11, C12 | 7 | 610027014 | GRM188R71H104KA93D | 村田
3 | 贴片电容 | 610026001 | CC0603JRNPO9BN220 | 国巨 | C0603 | C6, C7 | 2 | 610027001 | GRM1885C1H220JA01D | 村田
4 | 连接器 | 610060012 | U-USBAR04P-F002 | Ckmtw(灿科盟) | USB-A | P1 | 1
5 | 连接器 |  | D-DMS009PM-F000 | Ckmtw(灿科盟) | DSUB-TH_DMS009PM000XH00 | P2 | 1
6 | 集成电路 | 610050034 | CH340G | WCH(南京沁恒) | SOP-16 | U2 | 1
7 | 集成电路 | 610050035 | USBLC6-2SC6 | ST(意法半导体) | SOT-23-6 | U3 | 1
8 | 收发器 |  | SP3232EEN | UMW(友台半导体) | SOP-16 | U4 | 1
9 | 贴片晶振 | 610100006 | X503212MSB2GI | YXC(扬兴科技) | SMD-5032_2P | Y1 | 1
10
11 | PCB板 |  | MS-003.22T003.1.0 | 睿索科技
38
39
40
41
42
