santan444/MS003/03-设计开发输出阶段/07风险管理/MS-003故障树分析法(FTA)_软件V1.0.xlsx

Sheet: Rev
变更履历
版本号 | 发布/实施日期 | 更改内容概述 | 更改者
V1.0 | 2023.03.10 | 文件新编

Sheet: Method
操作指南
1，画软件架构框图
2，知晓每个模块的功能（参考软件技术需求说明书）
3，根据功能点，寻找潜在的软件故障（顶层事件）
4，根据软件架构框图，遍历可能导致故障的发生路径，识别、分析路径上的每个软件项（基本事件）
5，分析每个软件项的具体成因
备注：
1，当前只作为软件风险分析工具
2，每一个软件故障，为一棵树

Sheet: FTA
故障树分析法（FTA）
产品名称：骨科手术导航定位系统 |  | 文件号：MS-003.30W003 V1.0 |  | 项目编号：MS-003 |  | 编制人/日期： |  |  | 审核/日期： |  | 批准/日期：
序号 | 软件故障 | 危险情况 | 伤害 | 可能促成危险情况的软件项 | 软件项具体成因 | 伤害严重度S | 伤害的总体概率P | 风险水平 | 风险控制选项 | 风险控制措施描述 | 责任人和目标完成日期 | 风险评估控制记录编号
1 | 软件运行过程中闪退 | 用户当前操作数据丢失，无法继续手术，需重启设备 | 延误手术进程 | 内存申请失败 | 运行环境操作系统内存太小 | S2 | P3 | R | 设计保证 | 1.固定硬件与操作系统
 |  |  |  |  | 系统内存被其他应用大量占用 | S2 | P3 | R | 设计保证 | 1.禁止其他软件共享内存
 |  |  |  | 存储IO错误 | 内存和硬盘不稳定 | S2 | P2 | R | 设计保证 | 1.重启后可以继续操作
 |  |  |  | 操作系统错误 | 操作系统自有缺陷 | S2 | P2 | R | 设计保证 | 1.重启后可以继续操作
2 | 软件运行卡顿 | 使用体验感不佳 | 延误手术进程 | 系统内存使用占比过高 | 导入CT数据过多 | S1 | P3 | R | 设计保证 | 1. 限制导入CT数据量
 |  |  |  | 部分功能运行时间太久 | 部分功能在主进程中占 用太多时间 | S1 | P3 | R | 设计保证 | 1.采用多线程运行计算
3 | 数据导入失败 | 无法继续手术 | 延误手术进程 | 规划数据无法读取 | U盘传输错误 | S1 | P3 | R | 设计保证 安全说明 | 1.使用稳定的存储设备 2.加强测试
 |  |  |  |  | 数据路径过长 | S1 | P3 | R | 安全说明 | 1.加强培训，规范操作
 |  |  |  |  | 数据不完整 | S1 | P3 | R | 设计保证 安全说明 | 1.数据导出前增加完整性校验 2.加强培训，规范操作
 |  |  |  | 导入数据存储本地失败 | 磁盘空间不足 | S1 | P3 | R | 设计保证 安全说明 | 1.导入前检测磁盘空间容量 2.定期清理磁盘空间
4 | 数据导出失败 | 使用体验感不佳 | 影响用户判断 | 导出数据中断 | 传输过程中拔出U盘 | S1 | P3 | R | 设计保证 安全说明 | 1.加强培训，规范操作 2.软件提示
 |  |  |  | 导出数据失败 | U盘空间不足 | S1 | P3 | R | 设计保证 | 1.导出前检测U盘空间容量
 |  |  |  |  | U盘传输错误 | S1 | P3 | R | 设计保证 安全说明 | 1.使用稳定的存储设备 2.软件提示
5 | 设备连接异常 | 无法继续手术 | 延误手术进程 | 连接双目相机失败 | 参数设置错误 | S2 | P3 | R | 设计保证 | 1.软件提示
 |  |  |  |  | 硬件线路断开 | S2 | P3 | R | 设计保证 | 1.软件提示
 |  |  |  |  | 端口被占用 | S2 | P3 | R | 设计保证 | 1.软件提示
 |  |  |  | 无法获取示踪器数据 | 工具选择错误 | S2 | P3 | R | 设计保证 | 1.软件提示
 |  |  |  | 无法获取机械臂数据 | 网络参数设置错误 | S2 | P3 | R | 设计保证 | 1.软件提示
 |  |  |  |  | 硬件线路断开 | S2 | P3 | R | 设计保证 | 1.软件提示
 |  |  |  |  | 端口被占用 | S2 | P3 | R | 设计保证 | 1.软件提示
 |  |  |  | 无法控制机械臂 | 网络参数设置错误 | S2 | P3 | R | 设计保证 | 1.软件提示
 |  |  |  |  | 硬件线路断开 | S2 | P3 | R | 设计保证 | 1.软件提示
 |  |  |  |  | 端口被占用 | S2 | P3 | R | 设计保证 | 1.软件提示
6 | 视图显示异常 | 用户体验感差 | 影响用户判断 | 窗口显示效果异常 | 窗宽窗位调整不熟练 | S1 | P3 | R | 设计保证 安全说明 | 1.增加重置视图功能 2.加强培训
 |  |  |  | 窗口丢失图像 | 图像被移出视野范围 | S1 | P3 | R | 设计保证 安全说明 | 1.增加重置视图功能 2.加强培训
7 | 规划数据异常 | 无法继续手术 | 延误手术进程 | 骨性标记点选择不准确 | 操作人员经验不足 | S2 | P3 | R | 设计保证 | 1. 示意图提示标记点位置
 |  |  |  | 规划假体位置不准确 | 假体参数错误 | S2 | P3 | R | 设计保证 | 1. 对假体数据进行验证
8 | 点云配准失败 | 无法继续手术 | 延误手术进程 | 粗配准失败 | 操作人员经验不足 | S2 | P3 | R | 设计保证 安全说明 | 1.推荐合理的粗配点 2.加强培训，规范操作
 |  |  |  | 精配准失败 | 操作人员经验不足 | S2 | P3 | R | 设计保证 安全说明 | 1.推荐精配点选点区域 2.加强培训，规范操作
 |  |  |  |  | 骨模型表面与真实骨表 面差距较大 | S2 | P3 | R | 设计保证 安全说明 | 1.显示骨模型在图像上的轮廓 2.加强培训，规范操作
9 | 无法定位到目标位置 | 无 | 用户体验感差 | 仿真失败 | 目标位置超出机械臂运动范围 | S1 | P3 | R | 设计保证 安全说明 | 1.推荐合理的机械臂摆位 2.加强培训，规范操作
10 | 机械臂无法运动到目标位置 | 手术无法继续 | 延误手术进程 | 机械臂停止 | 机械臂关节自碰撞，保护性停止 | S2 | P3 | R | 设计保证 | 1.增加姿态仿真功能
 |  |  |  |  | 机械臂碰到障碍物，保护性停止 | S2 | P3 | R | 设计保证 安全说明 | 1.增加姿态仿真功能 2.操作说明要求避免机械臂大范围运动
11 | 定位不准确 | 继续手术操作 | 导致患者伤残 | 患者示踪器发生位移 | 示踪器固定不牢 | S3 | P3 | U | 设计保证 安全说明 | 1.提供检查功能 2.加强培训，规范操作
 |  |  |  | 配准结果精度不足 | 操作人员经验不足 | S3 | P5 | U | 设计保证 安全说明 | 1.提供人工确认 2.加强培训，规范操作
 |  |  |  | 机械臂精度不足 | 关节老化 | S3 | P3 | U | 设计保证 安全说明 | 1.闭环控制监测 2.定期维护
 |  |  |  |  | 关节变形 | S3 | P3 | U | 设计保证 安全说明 | 1.闭环控制监测 2.定期维护
12 | 设备工具自检不合格 | 继续使用设备工具 | 导致患者伤残 | 相机精度不合格 | 相机老化 | S3 | P2 | R | 安全说明 | 1.定期维护
 |  |  |  |  | 配置参数错误 | S3 | P3 | U | 设计保证 | 1.过滤双目相机传输数据
 |  |  |  | 器械工具精度不合格 | 工具变形 | S3 | P3 | U | 设计保证 安全说明 | 1.实时标定 2.定期维护
 |  |  |  |  | 配置参数错误 | S3 | P3 | U | 安全说明 | 1.加强培训，规范操作
13 | 软件功能不完整 | 手术无法继续 | 延误手术进程 | 依赖组件缺失 | 组件未安装 | S1 | P3 | R | 设计保证 安全说明 | 1.检测依赖组件完整性，给出相关提示 2.加强培训，规范操作
14 | 使用错误 | 数据错误 | 延误手术进程 | 软件关闭 | 误操作 | S2 | P3 | R | 设计保证 安全说明 | 1.关键操作增加二次提醒 2.加强培训，规范操作
 |  |  |  | 数据丢失 | 误操作 | S2 | P3 | R | 设计保证 安全说明 | 1.关键操作增加二次提醒 2.加强培训，规范操作
