santan444/MS003/03-设计开发输出阶段/07风险管理/MS-003设计失效模式分析(D-FMEA)_电子.xlsx

Sheet: Rev
变更履历
版本号 | 发布/实施日期 | 更改内容概述 | 更改者
A/0 | 2021.07.05 | 文件新编 | 洪洁
A/1 | 2021.07.28 | 修改SEV | 洪洁
B/0 |  | 格式修改 | 黄莹莹

Sheet: FMEA
MS-003（髋关节置换手术机器人）设计失效模式与效应分析（D-FMEA）
产品名称：髋关节置换手术机器人 |  |  | 文件号：MS-003.20W005 V1.0 |  |  | 项目编号：MS-003 |  |  | 编制人/日期： |  |  | 审核/日期： |  |  | 批准/日期：
序号 | 子系统/零部件 | 潜在失效模式 | 潜在失效的后果 | 局部影响 | SEV | 最终影响 | SEV | 失效模式发生的原因/机理 | OCC | 现行设计控制预防 | 现行设计控制探测方法 | DET | RPN | 建议采取的行动 | 责任人和目标完成日期 | 风险评估控制记录编号
1 | 升降控制板 | 台车无法升 | 脚杯无法撑住地面 | 手术无法进行 | 3 | 延误手术进程，对病人无直接伤害 | 6 | 推杆卡死 | 4 | 选用带认证的推杆 | 器件选型评审 | 1 | 24 | 无
2 |  |  |  |  | 3 |  | 6 | 限位开关失效 | 8 | 选用带认证的推杆 | 器件选型评审 | 1 | 48 | 对推杆进行疲劳测试
3 |  | 台车无法降 | 脚杯无法收离地面 | 台车不能移动 | 2 | 操作者使用不方便 | 4 | 推杆卡死 | 4 | 选用带认证的推杆 | 器件选型评审 | 2 | 32 | 无
4 |  | 电源部分芯片故障 | 控制板无法供电 | 控制板所有功能失效 | 7 | 1.手术前延误手术进程，对病人无直接伤害 2.手术中无法关机，对病人无伤害 | 3 | 后端功率过大，或者短路 | 4 | 1.设计上，对电源留有足够余量 2.对PCB板进行测试，电压、电流 | 1.原理图检查 2.台车控制板验证 | 1 | 28 | 无
5 |  | MCU故障 | 控制逻辑输出错误 | 控制板所有功能失效 | 7 | 1.手术前延误手术进程，对病人无直接伤害 2.手术中无法关机，对病人无伤害 | 3 | MCU静电等干扰损坏 | 5 | 设计阶段，设计接地线，进行防静电设计 | 原理图检查 | 1 | 35 | 无
6 |  | 电源连接松动 | 台车不能升降 | 台车在需要移动时无法进行移动 | 1 | 操作者使用不方便 | 3 | 接头故障，导致接触不良 | 1 | 使用防脱带卡扣插头 | PCB图检查 | 1 | 3 | 无
7 |  | 水平调节功能失效 | 台车不能调节水平 | 手术无法进行 | 3 | 延误手术进程，对病人无直接伤害 | 6 | 控制板逻辑失效 | 1 | 控制板进行严格测试 | 升降控制板验证 | 2 | 12 | 无
8 | 台车控制板 | UPS通讯口松动 | 与UPS信号无法发送 | 控制板功能失效 | 2 | UPS延时关机，对病人无直接伤害 | 3 | 接头故障，导致接触不良 | 6 | 使用防脱带卡扣插头 | PCB图检查 | 1 | 18 | 无
9 |  | 电源部分芯片故障 | 控制板无法供电 | 控制板所有功能失效 | 7 | 1.手术前延误手术进程，对病人无直接伤害 2.手术中无法关机，对病人无伤害 | 3 | 后端功率过大，或者短路 | 4 | 1.设计上，对电源留有足够余量 2.对PCB板进行测试，电压、电流 | 1.原理图检查 2.台车控制板验证 | 1 | 28 | 无
10 |  | MCU故障 | 控制逻辑输出错误 | 控制板所有功能失效 | 7 | 1.手术前延误手术进程，对病人无直接伤害 2.手术中无法关机，对病人无伤害 | 3 | MCU静电等干扰损坏 | 5 | 设计阶段，设计接地线，进行防静电设计 | 原理图检查 | 1 | 35 | 无
11 |  | Kuka机械臂上下电功能失效 | 机械臂无法启动 | 机械臂无法启动 | 7 | 延误手术进程，对病人无直接伤害 | 3 | 接头故障，导致接触不良 | 3 | 使用防脱带卡扣插头 | PCB图检查 | 1 | 21 | 无
12 | UPS | 内部故障关闭 | 系统断电 | 系统在工作中突然断电 | 10 | 产品缺陷会导致病人/用户严重健康损害 | 8 | UPS发生过热、过载或其它内部故障时保护性关闭 | 4 | 1.外壳增加散热孔 2.设计上，对UPS输出功率留有余量 3.保证UPS工作散热良好 | 1.结构设计图 2.器件选型评审 3.型检测试 | 2 | 80 | 对台车进行超温测试
13 |  | 后备电池供电不足 | 停电时系统无后备电源 | 系统在工作中突然断电 | 10 | 产品缺陷会导致病人/用户严重健康损害 | 8 | 用户超年限使用 | 1 | 规定使用年限，定期更换 | 使用说明书规定 | 2 | 20 | 无
14 |  | 控制线连接松动 | 系统无法关机 | 系统关机功能受限 | 2 | UPS延时关机，对病人无直接伤害 | 3 | 接头品质问题或者工艺原因 | 6 | 使用防脱带卡扣插头 | PCB图检查 | 2 | 36 | 无
15 | Kuka机械臂 | 关节卡死 | 机械臂达不到定位位置 | 系统定位无法正常进行 | 7 | 延误手术进程，对病人无直接伤害 | 6 | 关节电机损坏 | 1 | 进行耐久性测试 | Kuka机械臂验证 | 1 | 7 | 无
16 |  | 定位精度变差 | 机械臂到达定位位置误差较大 | 系统定位后有较大误差 | 7 | 延误手术进程，对病人无直接伤害 | 6 | 机械传动部分间隙过大 | 1 | 进行耐久性测试 | Kuka机械臂验证 | 3 | 21 | 无
17 |  | 电源连接线松动 | 机械臂无法启动 | 机械臂无法启动 | 7 | 延误手术进程，对病人无直接伤害 | 6 | 接头故障，导致接触不良 | 3 | 使用原厂插头插座，不做二次加工 | PCB图检查 | 1 | 21 | 无
18 |  | 负载力下降 | 机械臂到达定位位置误差较大 | 系统定位后有较大误差 | 7 | 延误手术进程，对病人无直接伤害 | 6 | 关节电机损坏 | 1 | 进行耐久性测试 | Kuka机械臂验证 | 1 | 7 | 无
19 | 髋臼钻 | 髋臼钻磨锉时卡死 | 磨锉工作无法继续进行 | 手术无法进行 | 7 | 延误手术进程，对病人无直接伤害 | 6 | 髋臼钻功率不足 | 2 | 选择合适功率的髋臼钻 | 髋臼钻选型验证 | 1 | 14 | 无
20 |  | 髋臼钻发热 | 磨锉时产生热量 | 磨锉头磨锉时温度过高 | 2 | 用户接触烫伤 | 7 | 磨锉转速过高 | 2 | 选择合适转速的髋臼钻 | 髋臼钻选型验证 | 2 | 28 | 无
21 |  | 髋臼锉选择错误 | 手术磨锉范围错误 | 手术失败 | 3 | 患者受到额外伤害 | 7 | 髋臼锉型号不好分辨 | 1 | 说明书上进行使用说明 | 产品说明书 | 1 | 7 | 无
22 | 脚踏 | 脚踏卡住 | 机械臂无法启动 | 机械臂无法定位 | 7 | 延误手术进程，对病人无直接伤害 | 6 | 脚踏被异物卡住或者内部损坏 | 2 | 进行耐久性测试 | 脚踏验证 | 1 | 14 | 无
23 |  | 功能失效 | 机械臂无法启动 | 机械臂无法定位 | 7 | 延误手术进程，对病人无直接伤害 | 6 | 脚踏功能失效 | 4 | 使用具有认证的脚踏 | 器件选型评审 | 1 | 28 | 无
24 | 视频传输器 | 视频显示延迟 | 视频与鼠标键盘操作不同步 | 影响用户操作体验 | 1 | 操作者使用不方便 | 3 | 视频信号传输延迟 | 5 | 选用延迟较小的视频传输器 | 器件选型评审 | 6 | 90 | 可用性验证
25 |  | 无视频信号 | 用户无法使用 | 手术无法进行 | 8 | 延误手术进程，对病人无直接伤害 | 5 | 视频信号连接失败 | 1 | 使用具有认证的视频传输器 | 器件选型评审 | 1 | 8 | 系统测试
备注 | *1 | 如果对病人、用户的安全影响是清楚的，则记录相应的严重度等级。
 |  | 非病人、用户安全相关的失效则记录为非相关"N"。
 |  | 对病人、用户的安全影响不清楚时，应记录为"待定"并由更高一级的FMEA最终确定其是否对病人、用户构成安全影响，而不是记录为"空格"或"非安全相关影响"。
 | *2 | 即使用RPN进行危害度的评价，也不能完全根据RPN值确定是否应该采取补救措施。
 |  | RPN值不高的时候，如果失效模式的影响、后果的严重度非常高，也应当采取补救措施。

Sheet: 附录A
评分标准
SEV 局部影响严重程度 |  | SEV 最终影响严重程度
标准 | 评分 | 标准 | 评分
产品不影响使用的瑕疵，功能报废率0.1% | 1 | 用户/病人通常不会发现并对其没有影响 | 1
产品不影响使用的瑕疵，功能报废率0.3% | 2 | 较细心能察觉的外观等产品瑕疵 | 2
产品次要功能损失，功能报废率0.3% | 3 | 用户容易发现并不乐于接受，不影响使用 | 3
产品次要功能损失，功能报废率1% | 4 | 使用不方便，增加用户负担 | 4
产品次要功能损失，可靠性降低但在规格内，功能报废率1% | 5 | 产品还能用，但性能没达到预期 | 5
产品次要严重功能损失，可靠性降低，功能报废率1% | 6 | 对病人/用户健康没有损害，但产品丧失功能 | 6
产品主要功能部分损失，功能报废率1% | 7 | 产品缺陷会导致病人/用户健康损害 | 7
产品主要功能部分损失，功能报废率3% | 8 | 产品缺陷会导致病人/用户严重健康损害 | 8
产品主要功能丧失，功能报废率10% | 9 | 产品缺陷会导致病人/用户生命危险或不可逆转的健康损害 | 9
产品主要功能和次要功能完全丧失，功能报废率10% | 10 | 产品缺陷会导致病人/用户死亡 | 10

Sheet: 附录B
评分标准
OCC（发生几率） |  | DET（失效模式的可察觉性）
标准 | 评分 | 标准 | 评分
<10ppm | 1 | 发生了必然被察觉 | 1
<100ppm | 2 | 一检查就能发现 | 2
<500ppm | 3 | 较多的检查才能发现 | 3
<1000ppm | 4 | 能被发现，检测方法可靠 | 4
<2500ppm | 5 | 可能被发现，检测方法可靠 | 5
<5000ppm | 6 | 可能被发现，检测方法相对可靠 | 6
<10000ppm | 7 | 难被肯定地发现，即使检测方法可靠 | 7
<25000ppm | 8 | 难被肯定地发现，即使检测方法相对可靠 | 8
<50000ppm | 9 | 很难被发现 | 9
<100000ppm | 10 | 似乎不可能察觉的到 | 10
