santan444/MS003/04-设计开发验证与确认阶段/可追溯性/MS-003可追溯性跟踪表.xlsx

Sheet: 封面
 |  | 文件号： | MS-003
MS-003
可追溯性跟踪表
 | 编制/时间：
 | 审核/时间：
 | 批准/时间：

Sheet: 文档修订页
文档更改履历
日期 | 版本号 | 修订章节 | 描述 | 作者
 | V1.0 | 全文 | 二阶（输入阶段）可追溯分析 |  | 填写用户需求、技术需求，及风险
 |  |  | 三阶（输出阶段）可追溯分析 |  | 填写概设、详设；填写单元模块、单元测试用例；填写集成测试用例
 |  |  | 四阶（验证确认阶段）可追溯分析 |  | 填写验证方案、报告

Sheet: Readme
备忘：
1 | 已在表单页眉中设置了表单编号、版本号及页码情况。
2 | 医疗器械的网络安全可追溯性分析以下方式二选一： （1）提供独立的有关网络安全的可追溯分析； （2）提供整体的可追溯性报告，但需注明网络安全情况。
Readme
简介
本文档用于记录需求的相关信息和属性，管理需求与上下游工作产品的追踪关系。
操作说明
需求跟踪矩阵RTM（Requirement traceability matrix）中所有列分成6个组，分别以不同的颜色标记，每组都可以折叠或展开（通过点击+\-). 各组详细说明如下：
字段 |  | 说明
1.用户需求跟踪 |  | 每一个用户需求可引伸出多个产品技术需求，并且多个用户需求可能需要相同的产品技术需求。在这里记录用户需求与产品技术需求之间的对应关系。可能是一对一、也可能是一对多的关系。
2.产品技术需求 | 状态 | 产品技术需求。 记录产品技术需求相关的信息，包括、、需求简要描述、需求状态。 需求状态包括： 1.已批准：该需求已经经过分析和评估，并确定了实现的版本，分配到相应的需求基线中； 2.已设计：该需求已经完成了设计； 3.已开发：该需求已经完成编码和单元测试；需求开发状态还可以进一步细分，如：提前完成/按时完成/延迟完成； 4.已测试：该需求已经完成了测试；需求测试状态还可以进一步细分，如：已系统测试，已用户测试； 5.已上线：该需求已经部署到生产系统。 6.已删除：由于需求变更原因，该需求已经被删除。
 | 技术需求编号
 | 简述
（软件需求跟踪） |  | 记录软件需求与产品技术需求、设计、代码、测试用例的关联关系。可能是一对一、也可能是一对多的关系。
3.设计文档追踪 |  | 记录产品技术需求与设计文档的关联关系。可能是一对一、也可能是一对多的关系。 设计可以跟踪到设计文档的章节。 设计文档可以是概要设计，也可以是详细设计，或者两者皆有。
4.下游工作产品跟踪 |  | 记录产品技术需求与设计、代码、测试用例的关联关系。可能是一对一、也可能是一对多的关系。 代码可以跟踪到代码文件。 测试可以跟踪到测试用例。
5.风险分析
6.需求变更信息 |  | 用于记录需求变更的过程。需求变更可以来源于用户、也可以来源于项目组内部。 需求变更类型包括新增、修改、删除。 1.新增：需要在矩阵中新增加一行，记录增加的需求点； 2.修改：直接修改原需求记录； 3.删除：原需求记录需要保留，只是将需求状态标记为“已删除”。
裁剪说明
允许裁剪的内容为： 1.用户需求跟踪。（对于由我方主导的纯研发项目，用户需求在适当情况下可裁剪） 软件需求。 3.设计文档，概要或详细至少追踪一种。
注意事项
无
依据：（五）软件可追溯性分析 软件可追溯性分析作为软件验证、软件确认的重要活动之一，是指追踪软件需求、软件设计、源代码、软件测试、软件风险管理之间的关系，分析已识别关系的正确性、一致性、完整性、准确性。 软件生存周期过程均需开展可追溯性分析活动，详见图 2。 软件需求分析阶段追溯分析软件需求与产品需求、软件需求与风险分析的关系。 软件设计阶段追溯分析软件设计与软件需求、软件设计与风险控制的关系。 软件编码阶段追溯分析源代码与软件设计、源代码与测试用例的关系。 内部测试阶段追溯分析单元测试、集成测试、系统测试各级测试用例与软件设计，系统测试与软件需求，系统测试与风险管理的关系。 用户测试阶段追溯分析用户测试与产品需求、用户测试与风险管理的关系。 软件更新亦需开展与之相适宜的软件可追溯性分析活动。 （来源《医疗器械软件注册审查指导原则（2022年修订版）（2022年第9号）》）

Sheet: RTM需求跟踪矩阵
1.产品技术需求 |  | 产品技术需求分解 |  |  | 2.用户需求追踪 |  |  | 3.设计 | 4.实现 |  | 5.验证、确认 |  |  | 6.风险分析
技术需求编号 | 技术需求简述 | 软件 | 机械 | 电子 | 用户需求编号 | 用户需求名称 | 软件需求名称 | 设计文档及章节名称 | 编码、图纸 | 单元测试 | 测试用例文档名称/测试方案 | 产品验证/测试报告 | 产品确认/用户测试 | 风险编号 | 备注
 |  | √ | √ | √
 |  | √ | √ | √
 |  | √
 |  | √
 |  | √
 |  | √
 |  | √
 |  | √
 |  | √
 |  | √
 |  | √
 |  | √
 |  | √
 |  | √
 |  | √
 |  | √
 |  | √
 |  | √
 |  | √
 |  | √
 |  | √
 |  | √
 |  | √
 |  | √
 |  | √
 |  | √
 |  | √
 |  | √
 |  | √
 |  | √
 |  | √
 |  | √
 |  | √
 |  | √
 |  | √
 |  | √
 |  | √
 |  | √
 |  | √
 |  | √
 |  | √
 |  | √
 |  | √
 |  | √
 |  | √
 |  | √
 |  | √
 |  | √
 |  | √
 |  | √
 |  | √
 |  | √
 |  |  | √ | √
 |  |  | √
 |  |  |  | √
 |  |  |  | √
