santan444/MS003/02-设计开发输入阶段/可用性工程/MS-003可用性任务分析_V1.0.xlsx

可用性任务分析
产品名称：髋关节置换手术手术导航系统 |  |  | 产品型号： | MS-003 | 编写/日期： | 2022.11.01 | 审核/日期： | 2022.11.09
文件号：MS-003.10W017 |  |  |  |  | 批准/日期： | 2022.11.10
ID | UR_ID | 使用场景 | Task_ID | 步骤（任务分析） | 潜在的使用错误 （原因） | 基于潜在用途的危害 （危害） | 伤害 | 分析
例 | {可用性需求评估中识别出的UR_ID} | {使用场景描述，适用时包括操作场景、运输场景、安装场景、维护场景、报废场景} | 任务 ID | {描述该场景下具体的人机交互步骤，注：一个任务也可由多个步骤组成} | {描述潜在的使用错误，若使用错误的可能性极低，则描述为Rare} | {识别使用错误是否可能导致危险源或危害，填写yes/no} | {罗列可能导致的伤害（可参考伤害清单）} | {本文档分析的结果输出至RAC中进一步分析和控制，同时危害相关的使用场景将进行总结性评估(可行性确认)}
1 | URS001-001 | 术中调整手术规划 | Task0001 | 通过二级菜单进入CT标记或手术规划界面 | 进入了配准界面，并点击了重置 | Yes | 延长手术时间 | 将结果输出至RAC进行风险分析及控制；对该场景进行可行性确认
 |  |  |  |  | 进入了手术工具标定界面，并点击了重置 | Yes | 延长手术时间 | 将结果输出至RAC进行风险分析及控制；对该场景进行可行性确认
 |  |  |  |  | 进入了示踪器安装界面，并点击了重置 | Yes | 延长手术时间 | 将结果输出至RAC进行风险分析及控制；对该场景进行可行性确认
 |  |  |  |  | 进入了机械臂精度检查界面，并点击了重置 | Yes | 延长手术时间 | 将结果输出至RAC进行风险分析及控制；对该场景进行可行性确认
 |  |  |  |  | 进入了机械臂开机检查界面，并点击了重置 | Yes | 延长手术时间 | 将结果输出至RAC进行风险分析及控制；对该场景进行可行性确认
 |  |  |  |  | 进入了股骨标记点捕获界面，并点击了重置 | Yes | 延长手术时间 | 将结果输出至RAC进行风险分析及控制；对该场景进行可行性确认
 |  |  |  |  | 进入了股骨检查钉安装及捕获界面，并点击了重置 | Yes | 延长手术时间 | 将结果输出至RAC进行风险分析及控制；对该场景进行可行性确认
 |  |  | Task0002 | 当前在磨锉界面，通过点击“上一步”，依次经过磨锉前准备界面、机械臂台车摆位界面、髋臼精配准界面、髋臼粗配准界面、联合前倾角评估界面、股骨截骨界面、股骨精配准界面、股骨粗配准界面、示踪器安装界面、手术工具标定界面、机械臂精度检查界面、机械臂开机检查界面、手术设置界面，最后后进入手术规划界面 | 进入了配准界面，并点击了重置 | Yes | 延长手术时间 | 将结果输出至RAC进行风险分析及控制；对该场景进行可行性确认
 |  |  |  |  | 进入了手术工具标定界面，并点击了重置 | Yes | 延长手术时间 | 将结果输出至RAC进行风险分析及控制；对该场景进行可行性确认
 |  |  |  |  | 进入了示踪器安装界面，并点击了重置 | Yes | 延长手术时间 | 将结果输出至RAC进行风险分析及控制；对该场景进行可行性确认
 |  |  |  |  | 进入了机械臂精度检查界面，并点击了重置 | Yes | 延长手术时间 | 将结果输出至RAC进行风险分析及控制；对该场景进行可行性确认
 |  |  |  |  | 进入了机械臂开机检查界面，并点击了重置 | Yes | 延长手术时间 | 将结果输出至RAC进行风险分析及控制；对该场景进行可行性确认
 |  |  |  |  | 进入了股骨标记点捕获界面，并点击了重置 | Yes | 延长手术时间 | 将结果输出至RAC进行风险分析及控制；对该场景进行可行性确认
 |  |  |  |  | 进入了股骨检查钉安装及捕获界面，并点击了重置 | Yes | 延长手术时间 | 将结果输出至RAC进行风险分析及控制；对该场景进行可行性确认
 |  |  | Task0003 | 在CT标记界面或手术规划界面修改相关信息 | Rare | No | / | /
 |  |  | Task0004 | 在磨锉过程中返回手术规划界面，在磨锉后的CT数据上修改手术规划 | Rare | No | / | /
 |  |  | Task0005 | 进入下一个界面前，系统会自动跳转到手术信息确认界面 | 没有对所有规划的参数逐一确认 | Yes | 无法继续使用本产品进行手术 | 将结果输出至RAC进行风险分析及控制；对该场景进行可行性确认
2 | URS001-002 URS001-033 | 检查患者示踪器 | Task0006 | 在患者示踪器旁植入检查钉 | 检查钉安装不牢靠 | Yes | 延长手术时间 | 将结果输出至RAC进行风险分析及控制；对该场景进行可行性确认
 |  |  |  |  | 检查钉植入位置不当 | Yes | 干扰手术操作，可能引起患者受伤 | 将结果输出至RAC进行风险分析及控制；对该场景进行可行性确认
 |  |  | Task0007 | 用探针捕获检查钉，记录初始位置 | 探针采集不到位 | Yes | 延长手术时间 | 将结果输出至RAC进行风险分析及控制；对该场景进行可行性确认
 |  |  | Task0008 | 点击工具精度检查按钮，用探针再次捕获检查钉，并查看精度值 | Rare | No | / | /
3 | URS001-008 URS001-009 | 登录软件 | Task0009 | 管理员账户输入用户名与密码后登录软件；普通用户输入用户名与密码后登录软件；售后工程师用户输入用户名与密码后登录软件 | 可能输入错误的用户名或密码，无法正常登录 | No | / | /
4 | URS001-010 URS001-011 URS001-012 URS001-013 URS001-018 | 病例管理 | Task0010 | 进入病例管理界面，选择“新建病例”，输入患者信息及手术信息 | 信息输入错误 | Yes | 可能导致患者受伤 | 将结果输出至RAC进行风险分析及控制；对该场景进行可行性确认
 |  |  | Task0011 | 双击病例列表中的某患者，在弹窗内查看或修改患者信息 | 信息修改错误 | Yes | 可能导致患者受伤 | 将结果输出至RAC进行风险分析及控制；对该场景进行可行性确认
 |  |  | Task0012 | 选中病例列表中的某患者，点击“导入规划”，选择目标文件夹并导入 | 数据导入错误 | Yes | 无法继续使用本产品进行手术，可能导致患者受伤 | 将结果输出至RAC进行风险分析及控制；对该场景进行可行性确认
 |  |  | Task0013 | 选中病例列表中的某患者，点击“导出规划”，选择存储路径并导出 | Rare | No | / | /
 |  |  | Task0014 | 通过搜索栏对患者信息进行关键词查找 | Rare | No | / | /
5 | URS001-014 URS001-015 URS001-017 | 术前图像处理 | Task0015 | 进入CT导入界面，点击导入CT，选择目标文件夹并导入一个或多个数据包 | 数据导入错误 | Yes | 无法继续使用本产品进行手术，可能导致患者受伤 | 将结果输出至RAC进行风险分析及控制；对该场景进行可行性确认
 |  |  | Task0016 | 选中某个目标CT序列，并分别与“髋关节”及“股骨远端”绑定 | 用户序列选择错误 | Yes | 无法继续使用本产品进行手术，可能导致患者受伤 | 将结果输出至RAC进行风险分析及控制；对该场景进行可行性确认
 |  |  | Task0017 | 进入CT预处理界面，利用工具对兴趣区域进行预剪裁，点击“下一步”即保存剪裁结果 | 剪裁错误 | Yes | 无法继续使用本产品进行手术，可能导致患者受伤 | 将结果输出至RAC进行风险分析及控制；对该场景进行可行性确认
 |  |  | Task0018 | 进入CT分割界面，依次导入骨盆模型及股骨模型 | 用户模型选择错误，导致数据不可用 | Yes | 无法继续使用本产品进行手术，可能导致患者受伤 | 将结果输出至RAC进行风险分析及控制；对该场景进行可行性确认
 |  |  | Task0019 | 进入CT分割界面，点击“分割”按钮，出现分割功能栏 | Rare | No | / | /
 |  |  | Task0020 | 使用分割工具栏，在骨块上添加不同颜色的标记球，进行自动分割 | 标记球放置位置不正确 | Yes | 无法继续使用本产品进行手术，可能导致患者受伤 | 将结果输出至RAC进行风险分析及控制；对该场景进行可行性确认
 |  |  |  |  | CT分割错误 | Yes | 无法继续使用本产品进行手术，可能导致患者受伤 | 将结果输出至RAC进行风险分析及控制；对该场景进行可行性确认
 |  |  | Task0021 | 进入CT标记界面，选中“髋臼”区域，并选中该区域的标记点标题栏 | Rare | No | / | /
 |  |  | Task0022 | 用鼠标在CT断层上选中标题栏对应的部位，并点击确认 | CT标记点选择不精准或者有误 | Yes | 无法进行本产品辅助下的手术，严重时患者受伤 | 将结果输出至RAC进行风险分析及控制；对该场景进行可行性确认
 |  |  | Task0023 | 在CT标记界面，通过菜单切换“股骨”及“膝关节”区域，重复上步操作 | Rare | No | / | /
 |  |  | Task0024 | 如果需要修改某个特征点，选中某栏特征点标题，点击“重置” | Rare | No | / | /
6 | URS001-021 URS001-022 URS001-026 | 假体规划及参数评估 | Task0025 | 进入规划界面，选择“术前模式”，观察术前患者髋长差值及偏距差值 | Rare | No | / | /
 |  |  | Task0026 | 通过下拉菜单选择假体的品牌、各假体组件的型号及规格 | 假体信息选择错误 | Yes | 可能导致患者受伤 | 将结果输出至RAC进行风险分析及控制；对该场景进行可行性确认
 |  |  | Task0027 | 进入“臼杯规划”或“股骨规划”界面，在3D视图上通过鼠标拖动假体位置 | Rare | No | / | /
 |  |  | Task0028 | 进入“臼杯规划”或“股骨规划”界面，在CT断层视图上通过箭头调整假体位置 | Rare | No | / | /
 |  |  | Task0029 | 系统实时显示臼杯当前角度值、臼杯旋转中心相对解剖旋转中心的位移 | Rare | No | / | /
 |  |  | Task0030 | 点击臼杯规划选项中的X线视图，观察臼杯在骨盆X片中的位置 | Rare | No | / | /
 |  |  | Task0031 | 点击臼杯规划选项中磨锉视图，观察预期磨锉的范围及深度 | Rare | No | / | /
 |  |  | Task0032 | 更改臼杯规划信息，磨锉范围会出现相应变化 | Rare | No | / | /
 |  |  | Task0033 | 在股骨柄规划界面，系统实时显示髋长差值及偏距差值 | Rare | No | / | /
 |  |  | Task0034 | 进入复位界面，系统模拟假体组装且骨骼复位后的3D模型，并显示髋关节长度及偏距差值 | Rare | No | / | /
 |  |  | Task0035 | 用户点开“脊柱骨盆矢状面平衡”,将骨盆倾角输入系统 | 用户输入的数值有误 | Yes | 影响临床精度 | 将结果输出至RAC进行风险分析及控制；对该场景进行可行性确认
 |  |  | Task0036 | 系统显示矢状面臼杯前外展角 | Rare | No | / | /
7 | URS001-027 | 进行假体运动模拟 | Task0037 | 用户进入“复位”界面，点开“更多评估”，并选中“坐位”或“站立位” | Rare | No | / | /
 |  |  | Task0038 | 用户在方向对应的三个数字框内输入某个角度值，模拟患者的某个动作（如选中坐位对应的数值栏后，输入屈曲90°及内旋30°可大致模拟跷二郎腿的动作） | Rare | No | / | /
 |  |  | Task0039 | 系统将显示在当前输入值下，股骨相对于骨盆的位姿关系 | Rare | No | / | /
 |  |  | Task0040 | 用户用肉眼判断当前假体与骨骼或假体与假体之间是否发生了碰撞 | 用户未能在3D模型上看清假体与骨骼或假体与假体之间是否发生了碰撞，导致忽视了风险，引发手术失败 | Yes | 假体的规划及安装不能满足患者需求 | 将结果输出至RAC进行风险分析及控制；对该场景进行可行性确认 （解决方案是禁忌症的明确）
8 | URS001-018 | 确认手术信息 | Task0041 | 用户改变了规划数据，一旦切换到其他界面，均出现手术信息确认弹窗 | Rare | No | / | /
9 | URS001-028 URS001-029 | 选择术中工具包及执行工具的类型 | Task0042 | 用户在手术设置界面，选择工具包及执行工具类型 | 用户误操作导致系统选择的工具包与实际工具包不一致，导致本产品参数显示错误 | Yes | 无法进行本产品辅助下的手术，严重时患者受伤 | 将结果输出至RAC进行风险分析及控制；对该场景进行可行性确认
 |  |  | Task0043 | 用户在其他界面返回手术设置界面，重新选择工具包，且工具的类型发生了变化（如直杆变成了弯杆） | 用户没有根据信息提示重新标定工具或直接跳过工具标定 | Yes | 无法进行本产品辅助下的手术，严重时患者受伤 | 将结果输出至RAC进行风险分析及控制；对该场景进行可行性确认
10 | URS001-030 | 图像配准 | Task0044 | 在患者髂骨植入2-3枚骨针 | 骨针打偏 | Yes | 无法进行本产品辅助下的手术，严重时患者受伤 | 将结果输出至RAC进行风险分析及控制；对该场景进行可行性确认
 |  |  | Task0045 | 在髂骨的骨针上套入转接件及参考架 | 转接件及参考架未牢固固定 | Yes | 延长手术时间 | 将结果输出至RAC进行风险分析及控制；对该场景进行可行性确认
 |  |  | Task0046 | 在患者股骨近端植入1枚骨皮质螺钉 | 骨皮质螺钉安装不牢固 | Yes | 延长手术时间 | 将结果输出至RAC进行风险分析及控制；对该场景进行可行性确认
 |  |  | Task0047 | 在患者股骨近端的螺钉上安装转接件及参考架 | 转接件及参考架未牢固固定 | Yes | 延长手术时间 | 将结果输出至RAC进行风险分析及控制；对该场景进行可行性确认
 |  |  | Task0048 | 用户进入点云配准界面，使用探针依次在患者骨骼上采集模型提示的特征点 | 用户使用探针采集不到位，导致配准不通过 | Yes | 延长手术时间 | 将结果输出至RAC进行风险分析及控制；对该场景进行可行性确认
 |  |  | Task0049 | 用户在粗配准开始前，先在3D模型上修改全部粗配准的特征点 | Rare | No | / | /
 |  |  | Task0050 | 用户在第一次粗配准失败的情况下，修改一个或多个特征点，并再次用探针捕获修改后的特征点（捕获完成且精度通过后自动进入下一界面） | Rare | No | / | /
 |  |  | Task0051 | 使用探针根据工具栏提示依次采集若干特征点，用于精配准 | 探针采集不到位 | Yes | 无法进行本产品辅助下的手术，严重时患者受伤 | 将结果输出至RAC进行风险分析及控制；对该场景进行可行性确认
 |  |  | Task0052 | 采集若干点用于配准验证，查看配准结果 | Rare | No | / | /
 |  |  | Task0053 | 用户在精配准失败后重置所有点，重新精配准 | 用户多次重复精配准，均无法成功 | Yes | 延长手术时间 | 将结果输出至RAC进行风险分析及控制；对该场景进行可行性确认
11 | URS001-031 URS001-034 URS001-035 URS001-036 URS001-037 URS001-038 URS001-039 URS001-040 URS001-046 URS001-047 URS001-048 URS001-049 URS001-050 | 髋臼磨锉与臼杯安放 | Task0054 | 将磨锉杆装入机械臂套筒 | 用户安装错误 | Yes | 延长手术时间 | 将结果输出至RAC进行风险分析及控制；对该场景进行可行性确认
 |  |  | Task0055 | 将髋臼锉装入磨锉杆末端 | 用户安装错误 | Yes | 延长手术时间 | 将结果输出至RAC进行风险分析及控制；对该场景进行可行性确认
 |  |  | Task0056 | 进入磨锉前准备界面，在软件中选择髋臼锉型号及磨锉杆型号 | 用户在系统选择的型号与实际型号不一致 | Yes | 无法进行本产品辅助下的手术，严重时患者受伤 | 将结果输出至RAC进行风险分析及控制；对该场景进行可行性确认
 |  |  |  |  | 用户中途修改操作工具或髋臼锉等信息，没有在软件上重新选择型号 | Yes | 无法进行本产品辅助下的手术，严重时患者受伤 | 将结果输出至RAC进行风险分析及控制；对该场景进行可行性确认
 |  |  | Task0057 | 用探针验证髋臼锉连杆的精度，以及示踪器的精度 | 探针采集错误 | Yes | 无法进行本产品辅助下的手术，严重时患者受伤 | 将结果输出至RAC进行风险分析及控制；对该场景进行可行性确认
 |  |  | Task0058 | 将机械臂台车脚撑着地 | 用户未将机械臂台车脚撑着地 | Yes | 无法进行本产品辅助下的手术，严重时患者受伤 | 将结果输出至RAC进行风险分析及控制；对该场景进行可行性确认
 |  |  | Task0059 | 进入磨锉界面，选中自由拖动模式 | Rare | No | / | /
 |  |  | Task0060 | 将机械臂末端拖动至患者髋臼 | Rare | No | / | /
 |  |  | Task0061 | 将骨钻连接在磨锉杆末端，先选择“手动磨锉"模式，消除髋臼周围骨赘 | 用户操作错误或操作不当 | Yes | 患者受伤 | 将结果输出至RAC进行风险分析及控制；对该场景进行可行性确认
 |  |  | Task0062 | 骨赘清除后，用户在边界保护模式下开始磨锉 | Rare | No | / | /
 |  |  | Task0063 | 用户根据实际需求，使用髋臼钻的正转或反转功能 | 用户误用了骨钻的反转功能 | Yes | 患者受伤 | 将结果输出至RAC进行风险分析及控制；对该场景进行可行性确认
 |  |  | Task0064 | 用户将机械臂拖离出髋臼，更换髋臼锉型号 | Rare | No | / | /
 |  |  | Task0065 | 用户重新在软件上选择更换的髋臼锉型号 | 用户忘记重新选择髋臼锉型号 | Yes | 无法实现预期手术效果，严重时患者受伤 | 将结果输出至RAC进行风险分析及控制；对该场景进行可行性确认
 |  |  | Task0066 | 中途放弃导航系统辅助，移除机械臂 | Rare | No | / | /
 |  |  | Task0067 | 将磨锉杆从机械臂套筒中取下，装上套筒把持装置，用传统方式进行磨锉 | Rare | No | / | /
 |  |  | Task0068 | 将臼杯打入杆装入机械臂末端 | 用户安装错误 | Yes | 延长手术时间，严重时患者受伤 | 将结果输出至RAC进行风险分析及控制；对该场景进行可行性确认
 |  |  | Task0069 | 在臼杯打入杆上安装示踪器 | 示踪器安装不牢靠 | Yes | 延长手术时间 | 将结果输出至RAC进行风险分析及控制；对该场景进行可行性确认
 |  |  | Task0070 | 进入安放前准备界面，将臼杯安装在臼杯打入杆末端 | 打入杆安装不牢靠 | Yes | 延长手术时间，严重时患者受伤 | 将结果输出至RAC进行风险分析及控制；对该场景进行可行性确认
 |  |  | Task0071 | 在软件上选择打入杆型号及臼杯型号 | 用户在系统选择的型号与实际型号不一致 | Yes | 无法实现预期手术效果，严重时患者受伤 | 将结果输出至RAC进行风险分析及控制；对该场景进行可行性确认
 |  |  | Task0072 | 验证臼杯打入杆及示踪器精度 | Rare | No | 无法进行本产品辅助下的手术，严重时患者受伤 | 将结果输出至RAC进行风险分析及控制；对该场景进行可行性确认
 |  |  | Task0073 | 进入臼杯安放界面，选择自由拖动模式 | Rare | No | / | /
 |  |  | Task0074 | 将机械臂拖动到规划位置附近，选择自动定位 | 机械臂定位错误 | Yes | 无法进行本产品辅助下的手术，严重时患者受伤 | 将结果输出至RAC进行风险分析及控制；对该场景进行可行性确认
 |  |  | Task0075 | 用骨锤敲击打入杆末端，直至臼杯牢固植入人体适当位置 | 用户未按照规划磨锉，仍然按照规划的角度打入臼杯 | Yes | 无法进行本产品辅助下的手术，严重时患者受伤 | 将结果输出至RAC进行风险分析及控制；对该场景进行可行性确认
 |  |  |  |  | 用户在错误的方向不断敲击骨锤导致机械臂锁死 | Yes | 无法进行本产品辅助下的手术，严重时患者受伤 | 将结果输出至RAC进行风险分析及控制；对该场景进行可行性确认
 |  |  |  |  | 用户误解了剩余敲击距离的提示，导致敲击不到位或者敲击过深 | Yes | 无法进行本产品辅助下的手术，严重时患者受伤 | 将结果输出至RAC进行风险分析及控制；对该场景进行可行性确认
 |  |  |  |  | 用户在敲击的过程中，引发髋臼示踪器松动 | Yes | 无法进行本产品辅助下的手术，严重时患者受伤 | 将结果输出至RAC进行风险分析及控制；对该场景进行可行性确认
 |  |  | Task0076 | 用户安装臼杯后，可通过探针验证臼杯放置角度 | 探针采集不到位 | No | / | /
12 | URS001-042 URS001-043 URS001-044 | 股骨截骨及验证 | Task0077 | 用探针在患者股骨侧标记规划的截骨线 | 探针操作不到位 | Yes | 无法进行本产品辅助下的手术，严重时患者受伤 | 将结果输出至RAC进行风险分析及控制；对该场景进行可行性确认
 |  |  | Task0078 | 在股骨侧重新装入示踪器，在髓腔锉末端安装转接头 | 示踪器安装不牢靠或转接头安装不到位 | Yes | 无法进行本产品辅助下的手术 | 将结果输出至RAC进行风险分析及控制；对该场景进行可行性确认
 |  |  | Task0079 | 使用探针依次采集转接头特征点，获得当前髓腔锉前倾角 | Rare | No | / | /
13 | URS001-024 | 术后评估髋关节长度及偏距 | Task0080 | 术前在患者股骨远端植入/贴标记物 | 用户可能遗忘 | Yes | 影响本产品的系统精度 | 将结果输出至RAC进行风险分析及控制；对该场景进行可行性确认
 |  |  | Task0081 | 术前在患者股骨近端植入/贴标记物 | 标记钉或标记物术中发生脱落 | Yes | 影响本产品的系统精度 | 将结果输出至RAC进行风险分析及控制；对该场景进行可行性确认
 |  |  | Task0082 | 用探针分别捕获两枚标记钉/物，记录股骨初始位置 | 捕获过程中，患者体位发生了移动，则记录的数据无效 | Yes | 影响本产品的系统精度 | 将结果输出至RAC进行风险分析及控制；对该场景进行可行性确认
 |  |  | Task0083 | 复位后再次用探针分别捕获两枚标记钉 | 术后捕获标记钉时的体位与术前第一次捕获的体位不一致 | Yes | 影响本产品的系统精度 | 将结果输出至RAC进行风险分析及控制；对该场景进行可行性确认
 |  |  | Task0084 | 将股骨示踪器重新安装于大转子螺钉 | 安装不牢靠 | Yes | 延长手术时间 | 将结果输出至RAC进行风险分析及控制；对该场景进行可行性确认
 |  |  | Task0085 | 点击捕获按钮，系统可计算并显示髋关节长度及偏距 | Rare | No | 本产品的术后评估无法使用 | 将结果输出至RAC进行风险分析及控制；对该场景进行可行性确认
14 | URS002-001 | 意外导致系统崩溃，重启软件后提供可恢复的方案 | Task0086 | 用户在使用软件过程中，突然遇到系统崩溃或死机，因此重启系统 | 关键操作的中断 | Yes | 无法进行本产品辅助下的手术，严重时患者受伤 | 将结果输出至RAC进行风险分析及控制；对该场景进行可行性确认
15 | URS002-007 | 台车操作面板应简单易用 | Task0087 | 点击面板的操作按钮进行相应操作 | 按钮操作错误 | Yes | 导致患者体表擦伤，严重可能导致患者受伤 | 将结果输出至RAC进行风险分析及控制；对该场景进行可行性确认
16 | URS002-008 | 硬件接口应方便用户使用 | Task0088 | 通过硬件接口进行设备连接 | 设备连接错误 | Yes | 导致患者体表擦伤，严重可能导致患者受伤 | 将结果输出至RAC进行风险分析及控制；对该场景进行可行性确认
17 | URS003-001 | 机械臂台车无菌保护 | Task0089 | 为机械臂台车包裹无菌罩 | 无菌罩包裹错误 | Yes | 导致并发症 | 将结果输出至RAC进行风险分析及控制；对该场景进行可行性确认
18 | URS005-001 | 收纳、包装和运输的可用性 | Task0090 | 收纳：在软件的机械臂控制界面，点击收纳位后踩下脚踏，机械臂运行至收纳位；将操作台车与导航台车进行组合拼接 | 机械臂收纳运动中出现自碰撞；操作台车与导航台车拼接不到位导致结构损伤 | / | / | /
 |  |  | Task0091 | 包装：操作台车与导航台车的显示器、导航相机统一包装； 导航台车悬臂独立包装；导航台车与操作台车统一包装；执行台车独立包装 | 包装不到位，导致设备损伤 | / | / | /
 |  |  | Task0092 | 拆卸包装 | Rare | No | / | /
 |  |  | Task0093 | 取出显示器Ⅰ，安装于操作台车上 | Rare | No | / | /
 |  |  | Task0094 | 将操作台车主体引出的电源线与显示器Ⅰ后部接口连接 | Rare | No | / | /
 |  |  | Task0095 | 取出显示器Ⅱ拆下显示器装饰罩，安装在导航台车上 | Rare | No | / | /
 |  |  | Task0096 | 将导航台车主体引出的信号线和电源线与显示器Ⅱ连接 | 接错接口 | No | / | /
 |  |  | Task0097 | 将相机悬臂安装在导航台车上 | 安装不到位，悬臂易掉落 | Yes | 悬臂掉落，手术中断 | 将结果输出至RAC进行风险分析及控制； 对该场景进行可行性确认；
 |  |  | Task0098 | 将相机安装在相机悬臂末端 | 安装不到位，相机易掉落 | Yes | 悬臂掉落，手术中断 | 将结果输出至RAC进行风险分析及控制； 对该场景进行可行性确认；
 |  |  | Task0099 | 将导航台车主体引出的信号线和电源线与双目相机连接 | Rare | No | / | /
 |  |  | Task0100 | 进行机械臂开机检查 | Rare | No | / | /
 |  |  | Task0101 | 从工具包中取出磨挫杆并装在机械臂末端 | 安装不到位 | Yes | 延长安装调试时间 | 将结果输出至RAC进行风险分析及控制； 对该场景进行可行性确认；
 |  |  | Task0102 | 从工具包中取出示踪器，装在磨锉杆末端 | 安装不到位 | Yes | 延长安装调试时间 | 将结果输出至RAC进行风险分析及控制； 对该场景进行可行性确认；
 |  |  | Task0103 | 进行机械臂精度检查 | Rare | No | / | /
 |  |  | Task0104 | 将执行台车拖至手术床合适位置，通过网线与导航台车连接，接通电源并按下“台车降”按钮，使台车底部支撑脚撑着地，脚轮悬空即可 | 台车下降未到位，脚撑未着地 | No | / | /
 |  |  | Task0105 | 现场对系统进行精度调试 | Rare | No | / | /
 |  |  | Task0106 | 完成后关闭系统 | Rare | No | / | /
19 | URS006-001 | 与配套工具包及假体联合使用， 实现基本功能和手术目标 | Task0107 | 术前对配套工具包进行清洁及灭菌处理 | 清洁不充分、灭菌方式选择错误或灭菌不充分 | Yes | 患者发生感染等并发症 | 将结果输出至RAC进行风险分析及控制；对该场景进行可行性确认
 |  |  | Task0108 | 术前使用标定工具，对工具包进行标定 | 术前标定过程发生错误 | Yes | 患者受伤 | 将结果输出至RAC进行风险分析及控制；对该场景进行可行性确认
