santan444/MS003/02-设计开发输入阶段/可用性工程/MS-003可用性需求评估.xlsx

可用性需求评估
产品名称：髋关节置换手术导航定位系统 |  |  | 产品型号：MS-003 |  | 编写/日期：
文件号：MS-003.10W016 |  |  | 版本号：V1.0 |  | 审核/日期：
 |  |  |  |  | 批准/日期：
序号 | URS_ID （用户需求编号） | 用户需求 （填写具体的用户需求条款内容,参考用户需求、概念说明书等） | 判定 | 使用错误的可能性 | 是否开展任务分析 | 评估 （结果输出形成人机界面及功能描述、经常使用的功能，也是任务分析的输入；任务应能覆盖产品安装、使用、维护等过程）
1 | URS001-001 | 能够支持操作者在术中任意时刻调整手术规划方案 | 是 | 可能 | 是 | 软件操作的可用性
2 | URS001-002 | 能够支持操作者在术中任意时刻检查患者示踪器精度 | 是 | 可能 | 是 | 软件操作的可用性
3 | URS001-003 | 能够支持操作者在术中任意时刻检查执行工具的精度 | 是 | 可能 | 是 | 软件操作的可用性
4 | URS001-004 | 提供随时截图的功能 | 是 | 不可能 | 不适用 | 不适用
5 | URS001-005 | 术后能够复现手术过程 | 是 | 不可能 | 不适用 | 不适用
6 | URS001-006 | 临床可接受的偏差范围如下：与术前规划对比，臼杯旋转中心偏差±2mm，臼杯前倾角及外展角偏差±5°。 | 否 | 不适用 | 不适用 | 不适用
7 | URS001-007 | 电气安全、EMC、环境要求及网络安全等符合相关标准 | 否 | 不适用 | 不适用 | 不适用
8 | URS001-008 | 提供用户账户管理功能 | 是 | 可能 | 是 | 软件操作的可用性
9 | URS001-009 | 提供分级管理权限 | 是 | 可能 | 是 | 软件操作的可用性
10 | URS001-010 | 提供患者、手术信息的录入功能 | 是 | 可能 | 是 | 软件操作的可用性
11 | URS001-011 | 提供病例储存、查找、导出功能 | 是 | 可能 | 是 | 软件操作的可用性
12 | URS001-012 | 能够读取图像预处理及手术规划的数据包 | 是 | 可能 | 是 | 软件操作的可用性
13 | URS001-013 | 能够导出图像预处理及手术规划的数据包 | 是 | 可能 | 是 | 软件操作的可用性
14 | URS001-014 | 提供图像分割的功能 | 是 | 可能 | 是 | 软件操作的可用性
15 | URS001-015 | 提供解剖标记点选择、确认及调整功能 | 是 | 可能 | 是 | 软件操作的可用性
16 | URS001-016 | 提供虚拟矫正及髋关节参数计算功能 | 否 | 不适用 | 不适用 | 不适用
17 | URS001-017 | 提供图像分割结果确认及调整的功能 | 是 | 可能 | 是 | 软件操作的可用性
18 | URS001-018 | 对患者信息和手术信息进行修改及确认的功能 | 是 | 可能 | 是 | 软件操作的可用性
19 | URS001-019 | 提供核对患者信息与图像信息的提示 | 是 | 不可能 | 不适用 | 不适用
20 | URS001-020 | 提供多视图联动功能 | 是 | 不可能 | 不适用 | 不适用
21 | URS001-021 | 提供假体规划功能 | 是 | 可能 | 是 | 软件操作的可用性
22 | URS001-022 | 提供臼杯角度计算功能 | 否 | 不适用 | 不适用 | 不适用
23 | URS001-023 | 提供磨锉量及磨锉范围计算功能 | 否 | 不适用 | 不适用 | 不适用
24 | URS001-024 | 提供髋关节长度及偏距差值评估功能 | 是 | 可能 | 是 | 软件操作的可用性
25 | URS001-025 | 提供髋关节长度差值及偏距差值计算功能 | 否 | 不适用 | 不适用 | 不适用
26 | URS001-026 | 提供矢状面平衡评估功能 | 是 | 可能 | 是 | 软件操作的可用性
27 | URS001-027 | 提供运动模拟功能 | 是 | 可能 | 是 | 软件操作的可用性
28 | URS001-028 | 提供手术工具包选择的功能 | 是 | 可能 | 是 | 软件操作的可用性
29 | URS001-029 | 提供选择执行工具类型的功能 | 是 | 可能 | 是 | 软件操作的可用性
30 | URS001-030 | 提供一种及以上配准功能 | 是 | 可能 | 是 | 配准功能的可用性
31 | URS001-031 | 提供髋臼锉规格选择功能 | 是 | 可能 | 是 | 软件操作的可用性
32 | URS001-032 | 提供执行工具的精度检查功能 | 是 | 可能 | 是 | 示踪器精度检查工具的可用性
33 | URS001-033 | 提供患者跟踪器偏移检查功能 | 是 | 可能 | 是 | 执行工具精度检查的可用性
34 | URS001-034 | 提供骨骼3D模型显示及视角调整的功能 | 是 | 可能 | 是 | 软件操作的可用性
35 | URS001-035 | 实时显示3D髋臼锉与骨骼模型相对位置 | 是 | 可能 | 是 | 软件操作的可用性
36 | URS001-036 | 提供术中髋臼锉/杯前倾角、外展角实时计算功能 | 是 | 可能 | 是 | 软件操作的可用性
37 | URS001-037 | 提供髋臼磨锉数据实时监测功能 | 是 | 可能 | 是 | 软件操作的可用性
38 | URS001-038 | 提供髋臼钻工作状态的提示功能 | 是 | 可能 | 是 | 软件操作的可用性
39 | URS001-039 | 提供臼杯型号选择功能 | 是 | 可能 | 是 | 软件操作的可用性
40 | URS001-040 | 提供臼杯安放轴向距离计算功能 | 是 | 可能 | 是 | 臼杯安放轴向距离计算功能的可用性
41 | URS001-041 | 提供臼杯安放后角度验证功能 | 是 | 可能 | 是 | 臼杯角度验证功能的可用性
42 | URS001-042 | 具有股骨截骨位置提示的功能 | 是 | 可能 | 是 | 软件操作的可用性
43 | URS001-043 | 具有髓腔锉前倾角计算功能 | 是 | 可能 | 是 | 髓腔锉前倾角计算功能的可用性
44 | URS001-044 | 具有联合前倾角计算的功能 | 否 | 不适用 | 不适用 | 不适用
45 | URS001-045 | 提供实时显示机械臂工作状态的功能 | 是 | 可能 | 是 | 软件操作的可用性
46 | URS001-046 | 支持医生在机械臂边界保护的方式下进行磨锉 | 是 | 可能 | 是 | 机械臂边界保护功能的可用性
47 | URS001-047 | 能够根据髋臼锉型号启动相应的边界保护模式 | 是 | 可能 | 是 | 软件操作的可用性
48 | URS001-048 | 支持医生使用非机械臂引导的模式进行磨锉 | 是 | 可能 | 是 | 非机械臂导引工具的可用性
49 | URS001-049 | 提供髋臼钻的正转和反转的控制功能 | 是 | 可能 | 是 | 骨钻正转与反转功能的可用性
50 | URS001-050 | 磨锉偏移规划时给予提示 | 是 | 可能 | 是 | 软件操作的可用性
51 | URS002-001 | 如果意外导致系统崩溃，重启软件后提供可恢复的方案 | 是 | 可能 | 是 | 软件操作的可用性
52 | URS002-002 | 提供UPS防止意外断电 | 否 | 不适用 | 不适用 | 不适用
53 | URS002-003 | 提示示踪器状态 | 是 | 可能 | 是 | 软件操作的可用性
54 | URS002-004 | 提示机械臂台车脚撑着地状态 | 是 | 可能 | 是 | 软件操作的可用性
55 | URS002-005 | 机械臂台车可升降 | 是 | 可能 | 是 | 机械臂升降功能的可用性
56 | URS002-006 | 台车操作面板应简单易用 | 是 | 可能 | 是 | 台车操作面板的可用性
57 | URS002-007 | 硬件接口应方便用户使用 | 是 | 可能 | 是 | 应有软件人机界面及操作面板，需要有额外控制接口
58 | URS003-001 | 机械臂台车要求使用无菌保护罩 | 是 | 可能 | 是 | 软件操作的可用性
59 | URS004-001 | 设备外壳可用干净的抹布擦洗清洁 | 否 | 不适用 | 不适用 | 不适用
60 | URS005-001 | 可移动式设备 | 是 | 可能 | 是 | 收纳、包装和运输的可用性
61 | URS006-001 | 本产品需结合配套工具包及经过验证的联合使用器械使用 | 是 | 可能 | 是 | 配套工具包及联合使用器械的可用性
