santan444/MS003/02-设计开发输入阶段/配置管理/MS-003配置管理计划及配置项列表_V1.0.xls

Sheet: 封面
 |  | 文件号：MS-003.10W026
MS-003
配置管理计划及配置项列表
 | 编制/日期：
 | 审核/日期：
 | 批准/日期：
杭州三坛医疗科技有限公司

Sheet: 文档修订页
文档更改履历
日期 | 版本号 | 修订章节 | 描述 | 作者
2022-10-13 | V0.1 | 全文 | 根据模板初步制定本项目配置计划 | 吴辉
2022-12-28 | V1.0 | 4.基线计划 | 需求基线建立时间； | 吴辉
 |  | 5.配置项计划 | 识别了新的配置项。

Sheet: 1.组织和职责
组织和职责
角色 | 承担者 | 职责 | 工作频度
配置管理员 | 吴辉 | 1.根据项目特点制定项目配置管理计划； 2.配合项目经理识别项目生命周期过程各个阶段的配置项； 3.根据项目生命周期确定项目基线计划； 4.配置服务器日常管理； 5.创建配置基线，跟踪和管理变更过程； 6.向项目经理报告当前配置状态； 7.程序发布执行； 8.跟踪并解决相关的配置问题。 | 每阶段/事件触发
产品经理 | 王婧 | 1.批准配置项的标志，以及软件基线的建立； 2.制定访问控制策略； 3.建立、更改基线的设置，审核变更申请； 4.根据配置管理员的报告决定相应的对策； 5.审核项目配置管理计划； 6.审核配置项的发布； 7.接受配置状态报告； 8.跟踪并解决相关的配置问题。 | 每阶段/事件触发
项目经理 | 洪洁 | 1.审批项目配置管理计划，发布配置计划； 2.审批配置项的发布； 3.接受配置状态报告； 4.解决配置管理问题； 5.批准产品版本发布。 | 每阶段/事件触发

Sheet: 2.配置项标识规定
配置项标识规定
技术类文档
技术文档
标识规定 | 项目名称(简称) + 文档类型名称
说明 | 项目名称：项目启动阶段，依据项目计划书定义
 | 技术类文档包括：技术需求说明书/设计文档/测试类文档等
举例 | MS-003技术需求说明书
技术讨论记录
标识规定 | 项目名称(简称) +记录日期
说明 | 项目名称：项目启动阶段，依据项目计划书定义
 | 技术讨论记录：表示管理文档的类别为技术讨论记录
 | 讨论日期：为讨论的时间(格式为：4位的“年”+2位的“月”+2位的“日”，如20050718)
举例 | MS-003技术讨论记录_20050914
项目管理文档
项目计划
标识规定 | 项目名称(简称) + 项目计划+（版本号）
说明 | 文档类型名称：如概要设计说明书、详细设计说明书
 | 项目名称：项目启动阶段，依据项目计划书定义
 | 括号内版本号为可选项，如：进度计划选用（无法添加历史修改页）
举例 | MS-003项目计划书.docx MS-003进度计划V1.0.mpp
会议纪要
标识规定 | 项目名称(简称) + 会议纪要 +开会日期
说明 | 项目名称：项目启动阶段，依据项目计划书定义
 | 文档类型名称：会议纪要
举例 | MS-003会议记要_20051010
项目月报/周报
标识规定 | 项目名称(简称)+文档类别+ 日期
说明 | 项目名称：项目启动阶段，依据项目计划书定义
 | 项目周报：表示管理文档的类别为项目周报
 | 提交日期：为提交的时间(格式为：4位的“年”+2位的“月”+2位的“日”，如20050718)
举例 | MS-003项目周报_20051010
软件发布标识
文档版本号命名规则(适用修改历史页版本命名)
标识规定 | VX.Y
说明 | X – 与发布版本对应，范围为0~9；
 | Y – 与增量、修正对应，范围为0~9。当Y满10，X顺序升一位；
 | 说明：文档初始版本号为0.1，发布初始版本为1.0 ，
 | 若发布新的版本，则发布版本X增加“1”为“X+1”，如“V1.0”升版为“V2.0”；
 | 若发布版本仅存在增量、修正，则Y增1，如“V1.0”升版为“V1.1”。
举例 | V1.1
代码版本命名规则
标识规定 | 版本号=vX.Y.Z.B
说明
举例 | v1.0.0.1

Sheet: 3.配置库说明
配置库说明
文档工程-配置库目录结构
一级目录 | 二级目录 | 三级目录 | 四级目录 | 备注说明 | 操作权限
研发中心 |  |  |  | 公盘研发中心目录，不可更改 | 依照公司文档管理制度，具体权限见“研发中心公盘权限matrix.xlsx”
 | 01-产品文档 |  |  | 公盘研发中心二级目录产品文档，不可更改
 |  | MS-003 髋关节置换手术导航定位系统 |  | 产品编号及名称
 |  |  | 01-设计开发策划阶段 | 针对策划阶段（一阶）文档，例如产品开发提议、可行性分析等
 |  |  | 02-设计开发输入阶段 | 针对输入阶段（二阶）文档，例如产品技术需求、风险管理计划等
 |  |  | 03-设计开发输出阶段 | 针对输出阶段（三阶）文档，例如概要设计说明书、详细设计说明书、单元测试报告、集成测试报告等
 |  |  | 04-设计开发验证与确认阶段 | 针对验证与确认阶段（四阶）文档，例如系统测试报告、用户测试报告等
 |  |  | 05-设计开发注册申报阶段 | 注册申报阶段（五阶），例如注册检验报告、临床评价资料等
 |  |  | 06-设计开发量产阶段 | 量产阶段（六阶），上市及上市后产生的文档
注:1.一~四级目录均不可更改，四级目录以上可再进行扩展；2.文档工程中不允许存放开发工具软件包等，请将开发工具软件包存放在“研发中心/09-工作软件”目录下。避免工具包占用配置库主机空间，备份时间周期过长。
工作环境及使用工具说明
类别 | 工具/环境/配置要求 |  | 地址 |  | 维护负责人
需求管理 | Excel/Word |  | \\192.168.2.200\研发中心\ |  | 吴辉、蒋雨枫
缺陷跟踪 | Excel/Word |  | \\192.168.2.200\研发中心\ |  | 吴辉、蒋雨枫
配置管理 | Excel/Word |  | \\192.168.2.200\研发中心\ |  | 吴辉、蒋雨枫
编码工具 | Microsoft Visual Studio |  | / |  | /
发布站点 | 公司公盘共享目录 |  | \\192.168.2.200\研发体系归档 |  | 吴辉、蒋雨枫
版本控制 | 代码工程：Gitlab |  | http://192.168.2.252:7080/MS-003 |  | 吴辉、蒋雨枫
代码工程-配置库操作权限分配举例说明
master分支 | master | 用途 | 主分支，产品的功能全部实现后，最终在master分支对外发布。
 |  | 数据来源 | 初始创建；从其他分支(develop)合并。
 |  | 权限 | 该分支为开发负责人可以读写，其他开发人员只读； 另外所有在master分支的推送应该打标签做记录，方便追溯。
develop分支 | develop | 用途 | 开发分支，该分支为所有开发人员日常提交的分支； 按项目进展阶段性，进行提测。
 |  | 数据来源 | 基于master分支克隆。
 |  | 权限 | 该分支为所有开发人员可读写，测试人员只读。
配置库操作权限分组举例说明
大域 | 名称 | 权限分组名称 | 权限分组说明
文档域 | MS-003 髋关节置换手术导航定位系统 | / | 依照公司文档管理制度，具体权限见“研发中心公盘权限matrix.xlsx”
代码域（Gitlab） | / | Guest | Gitlab用户在组中有五种权限：Guest、Reporter、Developer、Master、Owner Guest：可以创建issue、发表评论，不能读写版本库
 |  | Reporter | Reporter：可以克隆代码，不能提交，QA、PM可以赋予这个权限
 |  | Developer | Developer：可以克隆代码、开发、提交、push，研发可以赋予这个权限
 |  | Master | Master：可以创建项目、添加tag、保护分支、添加项目成员、编辑项目，核心RD负责人可以赋予这个权限
 |  | Owner | Owner：可以设置项目访问权限 - Visibility Level、删除项目、迁移项目、管理组成员，开发组leader可以赋予这个权限。
 |  | / | Gitlab中的组和项目有三种访问权限：Private、Internal、Public Private：只有组成员才能看到 Internal：只要登录的用户就能看到 Public：所有人都能看到
发布站点（公盘）服务器信息
地址 | \\192.168.2.200\研发体系归档
用户名 | lixiaokang | / | wuhui
用途 | 只能下载 | 只能下载和上传 | 能上传、下载、建目录、删除、改名

Sheet: 4.基线计划
基线计划
基线标识 | 基线名称 | 计划创建日期
MS-003需求基线V1.0 | 需求基线 | 2022-12-28
MS-003设计基线V1.0 | 设计基线 | 2023-??
MS-003发布基线V1.0 | 发布基线 | 2023-??

Sheet: 5.配置项计划
配置项计划
1.文档类配置项 |  |  |  |  |  | 按阶段进行配置
1.1技术类文档
# | 配置项名称 | 责任人 | 是否纳入基线 | 进入基线条件 | 计划入库日期 | 所属基线
1 | 开发提议书 | 产品经理 | 是 | 评审通过 | 2022-10-13 | 需求基线
2 | 任命书 | 产品经理 | 是 | 评审通过 | 2022-10-13 | 需求基线
3 | 市场可行性分析 | 产品经理 | 是 | 评审通过 | 2022-10-13 | 需求基线
4 | 技术可行性分析 | 系统工程师 | 是 | 评审通过 | 2022-10-13 | 需求基线
5 | 市场竞品情况 | 质量经理 | 是 | 评审通过 | 2022-10-13 | 需求基线
6 | 可注册性评估 | 注册经理 | 是 | 评审通过 | 2022-10-13 | 需求基线
7 | 学术调研分析 | 学术专员 | 是 | 评审通过 | 2022-10-13 | 需求基线
8 | 专利分析 | 知识产权专员 | 是 | 评审通过 | 2022-10-13 | 需求基线
9 | 用户需求规格说明书 | 产品经理 | 是 | 评审通过 | 2022-10-13 | 需求基线
10 | 立项报告 | 项目经理 | 是 | 评审通过 | 2022-10-13 | 需求基线
11 | 产品系统设计方案 | 系统工程师 | 是 | 评审通过 | 2022-12-28 | 需求基线
12 | 可用性需求评估 | 产品经理 | 是 | 评审通过 | 2022-12-28 | 需求基线
13 | 可用性任务分析 | 产品经理 | 是 | 评审通过 | 2022-12-28 | 需求基线
14 | 可用性分析报告 | 产品经理 | 是 | 评审通过 | 2022-12-28 | 需求基线
15 | 风险评估和控制记录 | DQA | 是 | 评审通过 | 2022-12-28 | 需求基线
16 | 风险管理报告 | DQA | 是 | 评审通过 | 2022-12-28 | 需求基线
17 | 产品开发试验和验证清单 | DQA | 是 | 评审通过 | 2022-12-28 | 需求基线
18 | 产品技术需求规格书（软件、硬件、结构） | 系统工程师 | 是 | 评审通过 | 2022-12-28 | 需求基线
19 | 初始关键物料采购建议 | 采购经理 | 是 | 评审通过 | 2022-12-28 | 需求基线
20 | 可追溯性分析 | 项目经理 | 是 | 评审通过 | 2022-12-28 | 需求基线
21 | 技术评审报告 | DQA | 是 | 评审通过 | / | 各阶段所属基线
22 | 配置审计报告 | 配置管理员 | 是 | 评审通过 | 2022-12-28 | 需求基线
23 | 配置项状态报告 | 配置管理员 | 是 | 评审通过 | 2022-12-28 | 需求基线
包括：需求规格书/设计文档/测试文档/数据库脚本等，当然每个阶段这些的变量部分作为新配置项识别。
1.2管理类文档
# | 配置项名称 | 责任人 | 是否纳入基线 | 进入基线条件 | 计划入库日期 | 所属基线
1 | 设计与开发策划计划 | 项目经理 | 是 | 评审通过 | 2022-10-13 | 需求基线
2 | 设计开发计划 | 项目经理 | 是 | 评审通过 | 2022-12-28 | 需求基线
3 | 风险管理计划 | DQA | 是 | 评审通过 | 2022-12-28 | 需求基线
4 | 配置管理计划 | 配置管理员 | 是 | 评审通过 | 2022-12-28 | 需求基线
5 | 会议记录 | / | 是 | 项目经理确认 | / | 各阶段所属基线
6 | 阶段评审报告 | DQA | 是 | 评审通过 | / | 各阶段所属基线
7 | 里程碑事件进展表 | 项目经理 | 是 | 评审通过 | / | 各阶段所属基线
8 | 更改申请单 | / | 是 | 评审通过 | / | 各阶段所属基线
9 | 更改通知单 | QA | 是 | 评审通过 | / | 各阶段所属基线
包括：项目计划，配置计划，会议纪要等。
1.3第三方相关
# | 配置项名称 | 责任人 | 是否纳入基线 | 进入基线条件 | 计划入库日期 | 所属基线
1 | 第三方软件验证报告 | / | 是 | 评审通过 | / | 各阶段所属基线
2 | 现成软件列表 | 配置管理员 | 是 | 项目经理确认 | / | 各阶段所属基线
包括：和相关小组交互的第三方文档、工具、平台、插件等等，这些输入或者输出直接对项目产生一定的影响，相关小组包括：本公司其他项目或者部门，用户，第三方厂家。
1.4工程类文档
# | 配置项名称 | 责任人 | 是否纳入基线 | 进入基线条件 | 计划入库日期 | 所属基线
1 | / | / | / | / | / | /
包括：项目的割接方案/上线计划/安装调试报告/上线报告等等工程文档。
2.代码类配置项
# | 配置项名称 | 责任人 | 是否纳入基线 | 进入基线条件 | 计划入库日期 | 所属基线
1 | 源代码 | / | 是 | 测试通过 | / | 发布基线
包括：产品的源代码/编译环境。 要求：颗粒度保持在模块级别，不需要列出具体的配置项名称，只需要说明此子目录下存放的哪类配置项，如“子服务前台”。
公共部分说明： 1.识别阶段和生命周期的各个阶段保持一致，如果在设计阶段识别的配置项，那么这个识别阶段就是设计阶段。 2.进入基线条件：其实任何一个配置项纳入配置库必须经过评审/验证/或者确认才能纳入基线库，例如需求规格书必须经过评审，工程类文档只要项目经理确认，对于代码类配置项必须经常测试进行验证。

Sheet: 6.配置变更流程 7.源码管理流程
配置变更流程
按照ST-QSP-39《更改控制程序》执行。
源码管理流程
注：以下流程供项目组参考，配置管理与项目组定义源码管理流程。
主要工作流程： 1.初始化项目为gitflow，默认创建master分支，然后从master拉取第一个develop分支。 2.从develop拉取feature分支进行编码开发(多个开发人员拉取多个feature同时进行并行开发，互不影响)。 3.feature分支完成后，合并到develop(不推送，feature功能完成还未提测，推送后会影响其他功能分支的开发)。 合并feature到develop后，可以选择删除当前feature，也可以不删除。但当前feature就不可更改了，必须从release分支继续编码修改。 4.从develop拉取release分支进行提测，提测过程中在release分支上修改BUG。 5.release分支上线后，合并release分支到develop/master并推送。 合并之后，可选删除当前release分支，若不删除，则当前release不可修改。线上有问题也必须从master拉取hotfix分支进行修改。 6.上线之后若发现线上BUG，从master拉取hotfix进行BUG修改。 7.hotfix通过测试上线后，合并hotfix分支到develop/master并推送； 合并之后，可选删除当前hostfix，若不删除，则当前hotfix不可修改，若补丁未修复，需要从master拉取新的hotfix继续修改。 8.当进行一个feature时，若develop分支有变动，如其他开发人员完成功能并上线，则需要将完成的功能合并到自己分支上，即合并develop到当前feature分支。 9.当进行一个release分支时，若develop分支有变动，如其他开发人员完成功能并上线，则需要将完成的功能合并到自己分支上，即合并develop到当前release分支(！因为当前release分支通过测试后会发布到线上，如果不合并最新的develop分支，就会发生丢代码的情况)。

Sheet: 8.日常工作计划
日常工作计划
配置审计计划
审计频率 | 1次/阶段
审计人 | 配置管理员
审计内容 | 1.项目组成员配置活动的规范性检查（检入、检出等） 2.配置项变更过程及记录 3.基线完整性及变更过程和记录
配置状态报告发布计划
发布频率 | 1次/阶段
发布人 | 配置管理员
发布对象 | 项目管理人员（PM，各小组组长）
配置库维护计划
维护频率 | 巡检：1次/周 备份：文档配置库每天自动备份，代码配置库每3天自动备份
维护人 | 信息管理员、配置管理员
维护内容 | 1.配置库巡检，确保配置库正常 2.配置库备份
