santan444/MS003/02-设计开发输入阶段/风险管理/MS-003.10W013 MS-003风险评估和控制记录_V1.0.xlsx

Sheet: Rev.
变更履历
序号 | 版本号 | 发布/实施日期 | 更改内容概述 | 更改者
1 | V1.0 | 2021.08.03 | 文件新编 | 洪洁
2 | V1.1 | 2022.04.28 | 文件修订 | 程焕

Sheet: 风险可接受准则
潜在的伤害严重度等级(S)
等级名称 | 代号 | 定义
可忽略 | S1 | 不便或暂时不适
轻度 | S2 | 导致不要求专业医疗介入的暂时伤害或损伤
严重 | S3 | 导致要求专业医疗介入的伤害或损伤
危重的 | S4 | 导致永久性损伤或危及生命的伤害
灾难性的 | S5 | 导致患者死亡
危险发生概率(P)
等级名称 | 代号 | 概率范围 | 分析
非常少 | P1 | ﹤10-6 | 事件不可复制和/或无法在设备的指定操作条件下复制。由于缺乏明确的信息，或在调查后发现与一系列未经证实或不可信的操作员行为或事件有关，因此无法对此类事件进行适当调查。
很少 | P2 | ﹤10-5和≥10-6 | 在设备的特定操作条件下，在产品寿命期间，事件很少发生。这一概率与设备运行相关的不经常的、未预料到的结果有关，或与操作员操作或异常事件的多步骤序列有关。
偶然 | P3 | ﹤10-4和≥10-5 | 在产品寿命期间，在设备的特定操作条件下，偶尔会发生事件。这种概率与两个特定的连续或同时的操作员操作或事件，或大多数用户偶尔执行的功能有关。
有时 | P4 | ﹤10-3和≥10-4 | 在产品的寿命期内，在设备的特定操作条件下，事件可能会发生或多次发生。这种可能性与未预料到的结果有关，这些结果很可能发生在设备的正常使用中。
经常 | P5 | ≥10-3 | 在产品的寿命期内，在设备的特定操作条件下，事件可能会被频发重现的或可能规律性发生或多次发生。
风险评价准则
A：可接受的风险；
R：合理可行降低(ALARP)的风险；
U：不经过风险/收益分析即判定为不可接受的风险。

Sheet: RAC
项目编号： |  | MS-003 |  | 产品名称： | 髋关节置换手术导航定位系统 |  |  |  | 编制/日期：
风险分析 |  |  |  |  |  |  |  | 风险评估 |  |  | 风险控制
危险源序号 | 危险(源) |  | 详细描述 | 可预见的事件 |  | 危险情况 | 伤害 | 伤害等级S | 伤害概率P | 风险A/R/U | 风险控制选项 | 风险控制措施描述
H1 | 机械能危险 |  | 是一款有源医疗设备，预期用于髋关节置换手术过程中的手术工具和髋关节假体的导航定位。 | 1.定位过程中，机械臂失控或误操作； 2.操作过程中髋臼钻失控或误操作。 |  | 1.碰撞患者； 2.在非规划区域磨锉。 | 造成患者伤残。 | S4 | P3 | U | 设计保证 | 1.增加脚踏控制； 2.紧急停止按钮。
H2 | 功能危险 |  | 是一款有源医疗设备，预期用于髋关节置换手术过程中的手术工具和髋关节假体的导航定位。 | 系统精度不准，或者配准误差过大。 |  | 1.碰撞患者； 2.在非规划区域操作。 | 造成患者伤残。 | S4 | P3 | U | 设计保证、安全说明 | 1.软件增加确认提示信息； 2.说明书中增加说明。
H3 | 机械能危险 |  | 患者创伤接触。 | 机械臂掉电，末端器械脱落。 |  | 1.碰撞患者； 2.在非规划区域操作。 | 造成患者伤残。 | S4 | P3 | U | 设计保证 | 1.增加UPS防止掉电； 2.末端器械防脱落设计。
H4 | 功能危险 |  | 患者创伤接触。 | 患者体位移动。 |  | 1.碰撞患者； 2.在非规划区域操作。 | 造成患者伤残。 | S4 | P3 | U | 设计保证 | 依靠双目进行动态补偿。
H5 | 生物学危险 |  | 患者创伤接触。 | 末端器械灭菌不彻底。 |  | 细菌与患者伤口接触。 | 引起并发症。 | S3 | P3 | U | 安全说明 | 1.说明书明确消毒灭菌要求； 2.对用户进行培训。
H6 | 化学危险 |  | 与假体、髋臼锉、示踪器、骨针、标记钉、探针共同使用。 | 1.清洁不彻底； 2.磨损导致污染物掉落。 |  | 污染物掉落到患者伤口。 | 引起并发症。 | S3 | P3 | U | 设计保证、安全说明 | 1.说明书明确清洁要求； 2.限定使用次数。
H7 | 生物相容性危险 |  | 与假体、髋臼锉、示踪器、骨针、标记钉、探针共同使用。 | 选用生物不相容材料。 |  | 生物不相容。 | 引起并发症。 | S3 | P3 | U | 设计保证 | 选用生物相容材料。
H8 | 机械能危险 |  | 髋臼磨锉。 | 髋臼钻选型不当。 |  | 过度磨锉。 | 造成患者伤残。 | S4 | P2 | U | 设计保证 | 限定髋臼钻扭矩和转速。
H9 | 辐射能危险 |  | 髋臼磨锉。 | 磨锉时间过长。 |  | 组织灼伤。 | 造成患者伤残。 | S4 | P2 | U | 设计保证 | 限定磨锉时间。
H10 | 生物学危险 |  | 联合使用工具包需要医院进行高温或低温等离子灭菌，髋臼钻需要进行灭菌。 | 灭菌不彻底。 |  | 细菌与患者伤口接触。 | 引起并发症。 | S3 | P3 | U | 安全说明 | 1.说明书明确消毒灭菌要求； 2.对用户进行培训。
H11 | 生物学危险 |  | 医院进行常规清洁消毒。 | 清洁不彻底。 |  | 污染物掉落到患者伤口。 | 引起并发症。 | S3 | P1 | R | 安全说明 | 说明书明确清洁要求。
H12 | 功能危险 |  | 需要对医学图像进行处理。 | 1、导入其他患者的医学图像； 2、医学图像人为处理不当； 3、患者数据未经授权的操作。 |  | 1、规划对象不正确； 2、数据不完整； 3、患者信息泄露。 | 1、导致患者伤残； 2、造成本产品无法使用； 3、侵犯患者隐私。 | S4 | P3 | U | 设计保证、安全说明 | 1.软件增加确认提示信息； 2、通过账号、密码进行用户管理； 3.对用户进行培训。
H13 | 辐射能危险 |  | 与工具包配合使用，与假体共同使用。 | 磨挫时，髋臼挫与病灶长时间接触。 |  | 产生大量热量。 | 引起并发症。 | S3 | P2 | R | 设计保证 | 1.系统控制持续磨挫的时间； 2.持续磨挫时间过久，有相应的软件提示。
H14 | 机械能危险 |  | 与工具包配合使用，与假体共同使用。 | 医疗器械与工具包、假体不匹配。 |  | 医疗器械无法使用或精度下降。 | 造成患者伤残。 | S4 | P2 | U | 设计保证、安全说明 | 1.操作前精度检查； 2.说明书中明确配合使用的医疗器械的产品规格。
H15 | 电磁能危险 |  | 器械可能发射辐射电磁能及设备发热产生的热源。 | 对外辐射电磁能超标。 |  | 干扰其他手术设备不正常。 | 造成患者伤残。 | S4 | P3 | U | 设计保证 | EMC设计。
H16 | 辐射能危险 |  | 器械可能发射辐射电磁能及设备发热产生的热源。 | 设备发热量超标。 |  | 影响其他手术室设备运行。 | 造成患者伤残。 | S4 | P3 | U | 设计保证 | 防超温设计。
H17 | 标记危险 |  | 操作、运输和存储环境都会规定要求； 器械可能受环境辐射电磁能、发热及红外干扰影响。 | 标记脱落、残缺。 |  | 使用不规范或功能变坏。 | 延误手术进程。 | S3 | P1 | R | 设计保证 | 增强标签的防脱落能力。
H18 | 电磁能危险 |  | 操作、运输和存储环境都会规定要求； 器械可能受环境辐射电磁能、发热及红外干扰影响。 | 环境电磁能超标。 |  | 干扰设备运行不流畅甚至死机。 | 造成患者伤残。 | S4 | P2 | U | 设计保证 | EMC设计。
H19 | 辐射能危险 |  | 操作、运输和存储环境都会规定要求； 器械可能受环境辐射电磁能、发热及红外干扰影响。 | 环境温度过高导致设备内部温度过高。 |  | 设备运行不流畅甚至死机。 | 延误手术进程。 | S3 | P2 | R | 设计保证 | 按GB/T 14710-2009《医用电器环境要求及试验方法》进行设计。
H20 | 功能危险 |  | 操作、运输和存储环境都会规定要求； 器械可能受环境辐射电磁能、发热及红外干扰影响。 | 手术室中有红外干扰源。 |  | 双目视觉数据被干扰。 | 延误手术进程。 | S3 | P3 | U | 设计保证、安全说明 | 1、示踪器结构设计； 2、软件中示踪器精度异常提示； 3、说明书中明确设备使用环境中无红外干扰源。
H21 | 电磁能危险 |  | 器械对环境产生辐射电磁能影响。 | 对外辐射电磁能超标。 |  | 干扰其他手术设备不正常。 | 造成患者伤残。 | S4 | P3 | U | 设计保证 | EMC设计。
H22 | 辐射能危险 |  | 器械对环境产生辐射电磁能影响。 | 设备发热量超标。 |  | 影响其他手术室设备运行。 | 造成患者伤残。 | S4 | P3 | U | 设计保证 | 防超温设计。
H23 | 功能危险 |  | 整机需要定期维护。 | 没有定期维护。 |  | 整机精度下降，在非规划区域工作。 | 造成患者伤残。 | S4 | P2 | U | 设计保证、安全说明 | 1.软件增加提示； 2.说明书中规定维护周期。
H24 | 使用错误危险 |  | 整机需要定期维护。 | 超期继续使用器械。 |  | 整机精度下降，在非规划区域工作。 | 造成患者伤残。 | S4 | P2 | U | 设计保证、安全说明 | 1.软件增加提示； 2.说明书中规定维护周期。
H25 | 功能危险 |  | 器械预装软件，用户无法修改。 | 软件版本安装错误。 |  | 软件功能无法使用。 | 延误手术进程。 | S3 | P1 | R | 设计保证、安全说明 | 1.软件版本管理； 2.提供生产作业指南； 3.生产作业培训。
H26 | 功能危险 |  | 存储寿命8年。 | 1、关键元器件超过使用寿命； 2、医疗器械到期后处置不当。 |  | 1.设备无法正常使用； 2.患者数据泄露。 | 延误手术进程。 | S3 | P2 | R | 设计保证、安全说明 | 1.对关键元器件进行选型设计； 2.整机设计符合有效期8年的要求； 3.说明书中明确定期维护设备和明确有效期期限为8年； 4.说明书中明确到期后的处置方式。
H27 | 功能危险 |  | 器械机械松动，老化。 标签磨损或脱落。 | 老化后继续使用器械。 |  | 整机精度下降，在非规划区域工作。 | 造成患者伤残。 | S4 | P2 | U | 设计保证、安全说明 | 1.软件增加提示； 2.增强标签的防脱落能力； 3.说明书中规定维护周期。
H28 | 机械能危险 |  | 受到的力是受用户及他人的相互作用控制。 | 1.医生拖动机械臂用力过猛。 2.安放臼杯时，敲打过程中，机械臂受力。 |  | 1、机械臂保护性停止。 2.非规划区域内操作 | 造成患者伤残。 | S4 | P3 | U | 设计保证、安全说明 | 1.说明书中规定； 2.软件里增加提示。 3.机械臂虚拟边界区域保护与深度区域保护设计。 4.安放杆设计，尽可能减少敲击时机械臂的受力。
H29 | 功能危险 |  | 关键元器件决定医疗器械的寿命。 | 关键元器件超过使用寿命。 |  | 设备无法正常使用。 | 造成患者伤残。 | S4 | P3 | U | 设计保证、安全说明 | 1.对关键元器件选型设计； 2.设计应符合整机有效期要求； 3.说明书中明确定期维护设备。 1.对关键元器件进行选型设计；
H30 | 化学危险 |  | 相关部件和数据需要按照国家标准规范进行处置。 | UPS电池未按规定回收处置。 |  | 造成环境污染。 | 无。 | S1 | P1 | A | 安全说明 | 说明书中增加回收相关说明。
H31 | 信息危险 |  | 相关部件和数据需要按照国家标准规范进行处置。 | 医疗器械到期处置时，患者数据信息未按规定处理。 |  | 患者信息泄露 | 侵犯患者隐私。 | S1 | P2 | A | 安全说明 | 说明书中增加医疗器械在到期处置，患者数据的处理方式。
H32 | 使用错误危险 |  | 需要培训。 | 培训不到位。 |  | 引起误操作。 | 造成患者伤残。 | S4 | P2 | U | 安全说明 | 实施培训。
H33 | 操作说明书危险 |  | 需要培训。 | 过于复杂的操作说明。 |  | 影响医生的手术效率。 | 延误手术进程。 | S3 | P2 | R | 设计保证、安全说明 | 1.系统可用性设计； 2.完善说明书。
H34 | 服务和维护规范危险 |  | 必须由专人进行售后安装、调试； 会提供操作说明书。 | 由未经培训的人员进行安装、调试。 |  | 设备无法正常使用。 | 无。 | S2 | P1 | A | 安全说明 | 实施培训。
H35 | 使用错误危险 |  | 必须由专人进行售后安装、调试； 会提供操作说明书。 | 没有提供操作说明书。 |  | 设备无法正常使用。 | 无。 | S2 | P1 | A | 安全说明 | 进行装箱核对。
H36 | 操作说明书危险 |  | 必须由专人进行售后安装、调试； 会提供操作说明书。 | 培训不到位。 |  | 设备使用不当。 | 造成患者伤残。 | S4 | P2 | U | 安全说明 | 实施培训。
H37 | 标记危险 |  | 用户界面设计可能导致使用错误。 | 软件界面不适当的描述。 |  | 引起误操作。 | 造成患者伤残。 | S4 | P2 | U | 设计保证、安全说明 | 1.系统可用性设计； 2.完善操作说明书。
H38 | 使用错误危险 |  | 用户界面设计可能导致使用错误。 | 软件界面不适当的描述。 |  | 引起误操作。 | 造成患者伤残。 | S4 | P2 | U | 设计保证、安全说明 | 1.系统可用性设计； 2.完善操作说明书。
H39 | 使用错误危险 |  | 软件的操作界面时会有分散注意力。 | 使用者注意力不集中，在软件界面误点了机械臂相关功能。 |  | 机械臂碰撞到患者。 | 造成患者伤残。 | S4 | P3 | U | 设计保证 | 增加机械臂控制相关动作的确认提示。
H40 | 使用错误危险 |  | 使用脚踏进行控制； 多个台车之间通过数据线进行连接； 执行工具和机械臂之间的连接。 | 接口/接插件连接错误。 |  | 医疗器械无法正常工作。 | 延误手术进程。 | S3 | P2 | R | 设计保证 | 接口防呆设计。
H41 | 使用错误危险 |  | 使用脚踏进行控制； 使用键盘鼠标进行控制； 使用按键进行控制。 | 脚踏/按键的误操作。 |  | 引起非预期动作。 | 造成患者伤残。 | S4 | P2 | U | 设计保证、安全说明 | 1.关键行为前增加确认提示信息； 2.髋臼钻的控制电源与安全区域（虚拟边界保护与深度保护区域）联动。
H42 | 使用错误危险 |  | 软件界面或操作面板均显示信息。 | 颜色和文字引发用户误解。 |  | 引起误操作。 | 造成患者伤残。 | S4 | P2 | U | 设计保证 | 系统可用性设计。
H43 | 功能危险 |  | 软件界面或操作面板均显示信息。 | 软件界面造成用户误解。 |  | 引起误操作。 | 延误手术进程。 | S3 | P1 | R | 设计保证 | 系统可用性设计。
H44 | 使用错误危险 |  | 器械由菜单控制。 | 菜单点错按钮。 |  | 引起误操作。 | 造成患者伤残。 | S4 | P2 | U | 设计保证 | 系统可用性设计。
H45 | 功能危险 |  | 器械由菜单控制。 | 菜单表述不明确。 |  | 引起误操作。 | 延误手术进程。 | S3 | P2 | R | 设计保证 | 系统可用性设计。
H46 | 使用错误危险 |  | 经过专业培训的医生。 | 医生培训不合格或未经培训操作。 |  | 引起误操作。 | 造成患者伤残。 | S4 | P1 | R | 安全说明 | 实施培训。
H47 | 使用错误危险 |  | 软件界面会有相应提示，引导用户进行相应动作。 | 手术过程中，误点手动磨挫按钮。 |  | 引起非预期动作。 | 造成患者伤残。 | S4 | P2 | U | 设计保证 | 1.采用脚踏控制。 2.增加用户确认。
H48 | 功能危险 |  | 软件界面和指示灯有报警系统。 | 软件界面/操作面板与实际故障不符。 |  | 引起误操作。 | 延误手术进程。 | S3 | P2 | R | 设计保证 | 1.符合GB 9706.1-2020《医用电气设备 第1部分：基本安全和基本性能的通用要求》进行设计； 2.系统可用性设计。
H49 | 使用错误危险 |  | 软件操作存在误用可能性； 用户不按照说明书要求使用和维护器械。 | 用户不按说明书要求使用和维护医疗器械 |  | 引起非预期动作。 | 造成患者伤残。 | S4 | P2 | U | 安全说明 | 1.说明书中明确非正常操作及维护的危险性。 2.实施培训。
H50 | 使用错误危险 |  | 器械持有患者CT数据，存在未经授权访问数据的可能性。 | 患者数据被修改或损坏。 |  | 导致误操作。 | 造成患者伤残。 | S4 | P1 | R | 设计保证 | 软件提示。
H51 | 信息危险 |  | 器械持有患者CT数据，存在未经授权访问数据的可能性。 | 患者数据未经授权的访问操作。 |  | 患者信息泄露。 | 侵犯患者隐私。 | S1 | P3 | R | 设计保证 | 通过账号、密码进行用户管理。
H52 | 机械能危险 |  | 移动式医疗设备。 | 台车移动过程中，脚轮失效。 |  | 台车移动困难。 | 延误手术进程。 | S3 | P1 | R | 设计保证 | 对影响台车移动的零部件进行稳定性、耐久性的设计。
H53 | 功能危险 |  | 器械使用依赖导航定位精度；系统配准精度会影响系统精度。 | 系统精度不达标。 |  | 在非规划区域操作。 | 造成患者伤残。 | S4 | P2 | U | 设计保证 | 1.软件增加配准精度确认提示信息； 2.软件引导用户进行机械臂精度验证； 3.软件引导用户进行示踪器标定； 4.在关键操作时，软件引导用户进行工具精度检验。
H54 | 使用错误危险 |  | 有可访问的以太网端口、USB 端口。 | 以太网端口插错。 |  | 设备无法正常使用。 | 延误手术进程。 | S3 | P3 | U | 设计保证 | 内部网络通过交换机进行组网。
H55 | 功能危险 |  | 有可访问的以太网端口、USB 端口。 | 使用U盘导入患者数据时，系统中病毒。 |  | 系统功能丧失。 | 产品无法使用。 | S1 | P3 | R | 设计保证、安全说明 | 1.对U盘进行病毒扫描、查杀； 2.说明书提示用户对装有患者数据的U盘进行病毒扫描、查杀。
H56
H57
H58
H59
H60
H61
H62
H63
H64
H65
H66
H67
H68
H69
H70
H71
H72
H73
H74
H75
H76
H77
H78
H79
H80
H81
H82
H83
H84
H85
H86
H87
H88
H89
H90
H91
H92
H93
H94
H95
H96
H97
H98
H99
H100
H101
H102
H103
H104
H105
H106
H107
H108
H109
H110
H111
H112
H113
H114
H115
H116
H117
H118
H119
H120
H121
H122
H123
H124
H125
H126
H127
H128
H129
H130
H131
H132
H133
H134
H135
H136
H137
H138
H139
H140
H141
H142
H143
H144
H145
H146
H147
H148
H149
H150
H151
H152
H153
H154

Sheet: 可用性危险
ID | UR_ID | 使用场景 | Task_ID | 步骤（任务分析） | 潜在的使用错误 （原因） | 基于潜在用途的危害 （危害） | 伤害 | 分析 |  | 详细描述 | 可预见的事件 | 危险情况 | 伤害
1 | URS001-001 | 术中调整手术规划 | Task0001 | 通过二级菜单进入CT标记或手术规划界面 | 进入了配准界面，并点击了重置 | Yes | 延长手术时间 | 将结果输出至RAC进行风险分析及控制；对该场景进行可行性确认 | H56 | 通过二级菜单进入CT标记或手术规划界面 | 进入了配准界面，并点击了重置 | 延长手术时间 | 延误手术进程。
 |  |  |  |  | 进入了手术工具标定界面，并点击了重置 | Yes | 延长手术时间 | 将结果输出至RAC进行风险分析及控制；对该场景进行可行性确认 | H57 | 通过二级菜单进入CT标记或手术规划界面 | 进入了手术工具标定界面，并点击了重置 | 延长手术时间 | 延误手术进程。
 |  |  |  |  | 进入了示踪器安装界面，并点击了重置 | Yes | 延长手术时间 | 将结果输出至RAC进行风险分析及控制；对该场景进行可行性确认 | H58 | 通过二级菜单进入CT标记或手术规划界面 | 进入了示踪器安装界面，并点击了重置 | 延长手术时间 | 延误手术进程。
 |  |  |  |  | 进入了机械臂精度检查界面，并点击了重置 | Yes | 延长手术时间 | 将结果输出至RAC进行风险分析及控制；对该场景进行可行性确认 | H59 | 通过二级菜单进入CT标记或手术规划界面 | 进入了机械臂精度检查界面，并点击了重置 | 延长手术时间 | 延误手术进程。
 |  |  |  |  | 进入了机械臂开机检查界面，并点击了重置 | Yes | 延长手术时间 | 将结果输出至RAC进行风险分析及控制；对该场景进行可行性确认 | H60 | 通过二级菜单进入CT标记或手术规划界面 | 进入了机械臂开机检查界面，并点击了重置 | 延长手术时间 | 延误手术进程。
 |  |  |  |  | 进入了股骨标记点捕获界面，并点击了重置 | Yes | 延长手术时间 | 将结果输出至RAC进行风险分析及控制；对该场景进行可行性确认 | H61 | 通过二级菜单进入CT标记或手术规划界面 | 进入了股骨标记点捕获界面，并点击了重置 | 延长手术时间 | 延误手术进程。
 |  |  |  |  | 进入了股骨检查钉安装及捕获界面，并点击了重置 | Yes | 延长手术时间 | 将结果输出至RAC进行风险分析及控制；对该场景进行可行性确认 | H62 | 通过二级菜单进入CT标记或手术规划界面 | 进入了股骨检查钉安装及捕获界面，并点击了重置 | 延长手术时间 | 延误手术进程。
 |  |  | Task0002 | 当前在磨锉界面，通过点击“上一步”，依次经过磨锉前准备界面、机械臂台车摆位界面、髋臼精配准界面、髋臼粗配准界面、联合前倾角评估界面、股骨截骨界面、股骨精配准界面、股骨粗配准界面、示踪器安装界面、手术工具标定界面、机械臂精度检查界面、机械臂开机检查界面、手术设置界面，最后后进入手术规划界面 | 进入了配准界面，并点击了重置 | Yes | 延长手术时间 | 将结果输出至RAC进行风险分析及控制；对该场景进行可行性确认 | H63 | 当前在磨锉界面，通过点击“上一步”，依次经过磨锉前准备界面、机械臂台车摆位界面、髋臼精配准界面、髋臼粗配准界面、联合前倾角评估界面、股骨截骨界面、股骨精配准界面、股骨粗配准界面、示踪器安装界面、手术工具标定界面、机械臂精度检查界面、机械臂开机检查界面、手术设置界面，最后后进入手术规划界面 | 进入了配准界面，并点击了重置 | 延长手术时间 | 延误手术进程。
 |  |  |  |  | 进入了手术工具标定界面，并点击了重置 | Yes | 延长手术时间 | 将结果输出至RAC进行风险分析及控制；对该场景进行可行性确认 | H64 | 当前在磨锉界面，通过点击“上一步”，依次经过磨锉前准备界面、机械臂台车摆位界面、髋臼精配准界面、髋臼粗配准界面、联合前倾角评估界面、股骨截骨界面、股骨精配准界面、股骨粗配准界面、示踪器安装界面、手术工具标定界面、机械臂精度检查界面、机械臂开机检查界面、手术设置界面，最后后进入手术规划界面 | 进入了手术工具标定界面，并点击了重置 | 延长手术时间 | 延误手术进程。
 |  |  |  |  | 进入了示踪器安装界面，并点击了重置 | Yes | 延长手术时间 | 将结果输出至RAC进行风险分析及控制；对该场景进行可行性确认 | H65 | 当前在磨锉界面，通过点击“上一步”，依次经过磨锉前准备界面、机械臂台车摆位界面、髋臼精配准界面、髋臼粗配准界面、联合前倾角评估界面、股骨截骨界面、股骨精配准界面、股骨粗配准界面、示踪器安装界面、手术工具标定界面、机械臂精度检查界面、机械臂开机检查界面、手术设置界面，最后后进入手术规划界面 | 进入了示踪器安装界面，并点击了重置 | 延长手术时间 | 延误手术进程。
 |  |  |  |  | 进入了机械臂精度检查界面，并点击了重置 | Yes | 延长手术时间 | 将结果输出至RAC进行风险分析及控制；对该场景进行可行性确认 | H66 | 当前在磨锉界面，通过点击“上一步”，依次经过磨锉前准备界面、机械臂台车摆位界面、髋臼精配准界面、髋臼粗配准界面、联合前倾角评估界面、股骨截骨界面、股骨精配准界面、股骨粗配准界面、示踪器安装界面、手术工具标定界面、机械臂精度检查界面、机械臂开机检查界面、手术设置界面，最后后进入手术规划界面 | 进入了机械臂精度检查界面，并点击了重置 | 延长手术时间 | 延误手术进程。
 |  |  |  |  | 进入了机械臂开机检查界面，并点击了重置 | Yes | 延长手术时间 | 将结果输出至RAC进行风险分析及控制；对该场景进行可行性确认 | H67 | 当前在磨锉界面，通过点击“上一步”，依次经过磨锉前准备界面、机械臂台车摆位界面、髋臼精配准界面、髋臼粗配准界面、联合前倾角评估界面、股骨截骨界面、股骨精配准界面、股骨粗配准界面、示踪器安装界面、手术工具标定界面、机械臂精度检查界面、机械臂开机检查界面、手术设置界面，最后后进入手术规划界面 | 进入了机械臂开机检查界面，并点击了重置 | 延长手术时间 | 延误手术进程。
 |  |  |  |  | 进入了股骨标记点捕获界面，并点击了重置 | Yes | 延长手术时间 | 将结果输出至RAC进行风险分析及控制；对该场景进行可行性确认 | H68 | 当前在磨锉界面，通过点击“上一步”，依次经过磨锉前准备界面、机械臂台车摆位界面、髋臼精配准界面、髋臼粗配准界面、联合前倾角评估界面、股骨截骨界面、股骨精配准界面、股骨粗配准界面、示踪器安装界面、手术工具标定界面、机械臂精度检查界面、机械臂开机检查界面、手术设置界面，最后后进入手术规划界面 | 进入了股骨标记点捕获界面，并点击了重置 | 延长手术时间 | 延误手术进程。
 |  |  |  |  | 进入了股骨检查钉安装及捕获界面，并点击了重置 | Yes | 延长手术时间 | 将结果输出至RAC进行风险分析及控制；对该场景进行可行性确认 | H69 | 当前在磨锉界面，通过点击“上一步”，依次经过磨锉前准备界面、机械臂台车摆位界面、髋臼精配准界面、髋臼粗配准界面、联合前倾角评估界面、股骨截骨界面、股骨精配准界面、股骨粗配准界面、示踪器安装界面、手术工具标定界面、机械臂精度检查界面、机械臂开机检查界面、手术设置界面，最后后进入手术规划界面 | 进入了股骨检查钉安装及捕获界面，并点击了重置 | 延长手术时间 | 延误手术进程。
 |  |  | Task0003 | 在CT标记界面或手术规划界面修改相关信息 | Rare | No | / | /
 |  |  | Task0004 | 在磨锉过程中返回手术规划界面，在磨锉后的CT数据上修改手术规划 | Rare | No | / | /
 |  |  | Task0005 | 进入下一个界面前，系统会自动跳转到手术信息确认界面 | 没有对所有规划的参数逐一确认 | Yes | 无法继续使用本产品进行手术 | 将结果输出至RAC进行风险分析及控制；对该场景进行可行性确认 | H70 | 进入下一个界面前，系统会自动跳转到手术信息确认界面 | 没有对所有规划的参数逐一确认 | 无法继续使用本产品进行手术 | 延误手术进程。
2 | URS001-002 URS001-033 | 检查患者示踪器 | Task0006 | 在患者示踪器旁植入检查钉 | 检查钉安装不牢靠 | Yes | 延长手术时间 | 将结果输出至RAC进行风险分析及控制；对该场景进行可行性确认 | H71 | 在患者示踪器旁植入检查钉 | 检查钉安装不牢靠 | 延长手术时间 | 延误手术进程。
 |  |  |  |  | 检查钉植入位置不当 | Yes | 干扰手术操作，可能引起患者受伤 | 将结果输出至RAC进行风险分析及控制；对该场景进行可行性确认 | H72 | 在患者示踪器旁植入检查钉 | 检查钉植入位置不当 | 干扰手术操作 | 导致患者伤残
 |  |  | Task0007 | 用探针捕获检查钉，记录初始位置 | 探针采集不到位 | Yes | 延长手术时间 | 将结果输出至RAC进行风险分析及控制；对该场景进行可行性确认 | H73 | 用探针捕获检查钉，记录初始位置 | 探针采集不到位 | 延长手术时间 | 延误手术进程。
 |  |  | Task0008 | 点击工具精度检查按钮，用探针再次捕获检查钉，并查看精度值 | Rare | No | / | /
3 | URS001-008 URS001-009 | 登录软件 | Task0009 | 管理员账户输入用户名与密码后登录软件；普通用户输入用户名与密码后登录软件；售后工程师用户输入用户名与密码后登录软件 | 可能输入错误的用户名或密码，无法正常登录 | No | / | /
4 | URS001-010 URS001-011 URS001-012 URS001-013 URS001-018 | 病例管理 | Task0010 | 进入病例管理界面，选择“新建病例”，输入患者信息及手术信息 | 信息输入错误 | Yes | 可能导致患者受伤 | 将结果输出至RAC进行风险分析及控制；对该场景进行可行性确认 | H74 | 进入病例管理界面，选择“新建病例”，输入患者信息及手术信息 | 信息输入错误 |  | 导致患者伤残
 |  |  | Task0011 | 双击病例列表中的某患者，在弹窗内查看或修改患者信息 | 信息修改错误 | Yes | 可能导致患者受伤 | 将结果输出至RAC进行风险分析及控制；对该场景进行可行性确认 | H75 | 双击病例列表中的某患者，在弹窗内查看或修改患者信息 | 信息修改错误 |  | 导致患者伤残
 |  |  | Task0012 | 选中病例列表中的某患者，点击“导入规划”，选择目标文件夹并导入 | 数据导入错误 | Yes | 无法继续使用本产品进行手术，可能导致患者受伤 | 将结果输出至RAC进行风险分析及控制；对该场景进行可行性确认 | H76 | 选中病例列表中的某患者，点击“导入规划”，选择目标文件夹并导入 | 数据导入错误 | 无法继续使用本产品进行手术 | 导致患者伤残
 |  |  | Task0013 | 选中病例列表中的某患者，点击“导出规划”，选择存储路径并导出 | Rare | No | / | /
 |  |  | Task0014 | 通过搜索栏对患者信息进行关键词查找 | Rare | No | / | /
5 | URS001-014 URS001-015 URS001-017 | 术前图像处理 | Task0015 | 进入CT导入界面，点击导入CT，选择目标文件夹并导入一个或多个数据包 | 数据导入错误 | Yes | 无法继续使用本产品进行手术，可能导致患者受伤 | 将结果输出至RAC进行风险分析及控制；对该场景进行可行性确认 | H77 | 进入CT导入界面，点击导入CT，选择目标文件夹并导入一个或多个数据包 | 数据导入错误 | 无法继续使用本产品进行手术 | 导致患者伤残
 |  |  | Task0016 | 选中某个目标CT序列，并分别与“髋关节”及“股骨远端”绑定 | 用户序列选择错误 | Yes | 无法继续使用本产品进行手术，可能导致患者受伤 | 将结果输出至RAC进行风险分析及控制；对该场景进行可行性确认 | H78 | 选中某个目标CT序列，并分别与“髋关节”及“股骨远端”绑定 | 用户序列选择错误 | 无法继续使用本产品进行手术 | 导致患者伤残
 |  |  | Task0017 | 进入CT预处理界面，利用工具对兴趣区域进行预剪裁，点击“下一步”即保存剪裁结果 | 剪裁错误 | Yes | 无法继续使用本产品进行手术，可能导致患者受伤 | 将结果输出至RAC进行风险分析及控制；对该场景进行可行性确认 | H79 | 进入CT预处理界面，利用工具对兴趣区域进行预剪裁，点击“下一步”即保存剪裁结果 | 剪裁错误 | 无法继续使用本产品进行手术 | 导致患者伤残
 |  |  | Task0018 | 进入CT分割界面，依次导入骨盆模型及股骨模型 | 用户模型选择错误，导致数据不可用 | Yes | 无法继续使用本产品进行手术，可能导致患者受伤 | 将结果输出至RAC进行风险分析及控制；对该场景进行可行性确认 | H80 | 进入CT分割界面，依次导入骨盆模型及股骨模型 | 用户模型选择错误，导致数据不可用 | 无法继续使用本产品进行手术 | 导致患者伤残
 |  |  | Task0019 | 进入CT分割界面，点击“分割”按钮，出现分割功能栏 | Rare | No | / | /
 |  |  | Task0020 | 使用分割工具栏，在骨块上添加不同颜色的标记球，进行自动分割 | 标记球放置位置不正确 | Yes | 无法继续使用本产品进行手术，可能导致患者受伤 | 将结果输出至RAC进行风险分析及控制；对该场景进行可行性确认 | H81 | 使用分割工具栏，在骨块上添加不同颜色的标记球，进行自动分割 | 标记球放置位置不正确 | 无法继续使用本产品进行手术 | 导致患者伤残
 |  |  |  |  | CT分割错误 | Yes | 无法继续使用本产品进行手术，可能导致患者受伤 | 将结果输出至RAC进行风险分析及控制；对该场景进行可行性确认 | H82 | 使用分割工具栏，在骨块上添加不同颜色的标记球，进行自动分割 | CT分割错误 | 无法继续使用本产品进行手术 | 导致患者伤残
 |  |  | Task0021 | 进入CT标记界面，选中“髋臼”区域，并选中该区域的标记点标题栏 | Rare | No | / | /
 |  |  | Task0022 | 用鼠标在CT断层上选中标题栏对应的部位，并点击确认 | CT标记点选择不精准或者有误 | Yes | 无法进行本产品辅助下的手术，严重时患者受伤 | 将结果输出至RAC进行风险分析及控制；对该场景进行可行性确认 | H83 | 用鼠标在CT断层上选中标题栏对应的部位，并点击确认 | CT标记点选择不精准或者有误 | 无法进行本产品辅助下的手术 | 导致患者伤残
 |  |  | Task0023 | 在CT标记界面，通过菜单切换“股骨”及“膝关节”区域，重复上步操作 | Rare | No | / | /
 |  |  | Task0024 | 如果需要修改某个特征点，选中某栏特征点标题，点击“重置” | Rare | No | / | /
6 | URS001-021 URS001-022 URS001-026 | 假体规划及参数评估 | Task0025 | 进入规划界面，选择“术前模式”，观察术前患者髋长差值及偏距差值 | Rare | No | / | /
 |  |  | Task0026 | 通过下拉菜单选择假体的品牌、各假体组件的型号及规格 | 假体信息选择错误 | Yes | 可能导致患者受伤 | 将结果输出至RAC进行风险分析及控制；对该场景进行可行性确认 | H84 | 通过下拉菜单选择假体的品牌、各假体组件的型号及规格 | 假体信息选择错误 | 软件规划错误 | 导致患者伤残
 |  |  | Task0027 | 进入“臼杯规划”或“股骨规划”界面，在3D视图上通过鼠标拖动假体位置 | Rare | No | / | /
 |  |  | Task0028 | 进入“臼杯规划”或“股骨规划”界面，在CT断层视图上通过箭头调整假体位置 | Rare | No | / | /
 |  |  | Task0029 | 系统实时显示臼杯当前角度值、臼杯旋转中心相对解剖旋转中心的位移 | Rare | No | / | /
 |  |  | Task0030 | 点击臼杯规划选项中的X线视图，观察臼杯在骨盆X片中的位置 | Rare | No | / | /
 |  |  | Task0031 | 点击臼杯规划选项中磨锉视图，观察预期磨锉的范围及深度 | Rare | No | / | /
 |  |  | Task0032 | 更改臼杯规划信息，磨锉范围会出现相应变化 | Rare | No | / | /
 |  |  | Task0033 | 在股骨柄规划界面，系统实时显示髋长差值及偏距差值 | Rare | No | / | /
 |  |  | Task0034 | 进入复位界面，系统模拟假体组装且骨骼复位后的3D模型，并显示髋关节长度及偏距差值 | Rare | No | / | /
 |  |  | Task0035 | 用户点开“脊柱骨盆矢状面平衡”,将骨盆倾角输入系统 | 用户输入的数值有误 | Yes | 影响临床精度 | 将结果输出至RAC进行风险分析及控制；对该场景进行可行性确认 | H85 | 用户点开“脊柱骨盆矢状面平衡”,将骨盆倾角输入系统 | 用户输入的数值有误 | 影响临床精度 | 导致患者伤残
 |  |  | Task0036 | 系统显示矢状面臼杯前外展角 | Rare | No | / | /
7 | URS001-027 | 进行假体运动模拟 | Task0037 | 用户进入“复位”界面，点开“更多评估”，并选中“坐位”或“站立位” | Rare | No | / | /
 |  |  | Task0038 | 用户在方向对应的三个数字框内输入某个角度值，模拟患者的某个动作（如选中坐位对应的数值栏后，输入屈曲90°及内旋30°可大致模拟跷二郎腿的动作） | Rare | No | / | /
 |  |  | Task0039 | 系统将显示在当前输入值下，股骨相对于骨盆的位姿关系 | Rare | No | / | /
 |  |  | Task0040 | 用户用肉眼判断当前假体与骨骼或假体与假体之间是否发生了碰撞 | 用户未能在3D模型上看清假体与骨骼或假体与假体之间是否发生了碰撞，导致忽视了风险，引发手术失败 | Yes | 假体的规划及安装不能满足患者需求 | 将结果输出至RAC进行风险分析及控制；对该场景进行可行性确认 （解决方案是禁忌症的明确） | H86 | 用户用肉眼判断当前假体与骨骼或假体与假体之间是否发生了碰撞 | 用户未能在3D模型上看清假体与骨骼或假体与假体之间是否发生了碰撞，导致忽视了风险，引发手术失败 |  | 假体的规划及安装不能满足患者需求
8 | URS001-018 | 确认手术信息 | Task0041 | 用户改变了规划数据，一旦切换到其他界面，均出现手术信息确认弹窗 | Rare | No | / | /
9 | URS001-028 URS001-029 | 选择术中工具包及执行工具的类型 | Task0042 | 用户在手术设置界面，选择工具包及执行工具类型 | 用户误操作导致系统选择的工具包与实际工具包不一致，导致本产品参数显示错误 | Yes | 无法进行本产品辅助下的手术，严重时患者受伤 | 将结果输出至RAC进行风险分析及控制；对该场景进行可行性确认 | H87 | 用户在手术设置界面，选择工具包及执行工具类型 | 用户误操作导致系统选择的工具包与实际工具包不一致，导致本产品参数显示错误 | 无法进行本产品辅助下的手术 | 导致患者伤残
 |  |  | Task0043 | 用户在其他界面返回手术设置界面，重新选择工具包，且工具的类型发生了变化（如直杆变成了弯杆） | 用户没有根据信息提示重新标定工具或直接跳过工具标定 | Yes | 无法进行本产品辅助下的手术，严重时患者受伤 | 将结果输出至RAC进行风险分析及控制；对该场景进行可行性确认 | H88 | 用户在其他界面返回手术设置界面，重新选择工具包，且工具的类型发生了变化（如直杆变成了弯杆） | 用户没有根据信息提示重新标定工具或直接跳过工具标定 | 无法进行本产品辅助下的手术 | 导致患者伤残
10 | URS001-030 | 图像配准 | Task0044 | 在患者髂骨植入2-3枚骨针 | 骨针打偏 | Yes | 无法进行本产品辅助下的手术，严重时患者受伤 | 将结果输出至RAC进行风险分析及控制；对该场景进行可行性确认 | H89 | 在患者髂骨植入2-3枚骨针 | 骨针打偏 | 无法进行本产品辅助下的手术 | 导致患者伤残
 |  |  | Task0045 | 在髂骨的骨针上套入转接件及参考架 | 转接件及参考架未牢固固定 | Yes | 延长手术时间 | 将结果输出至RAC进行风险分析及控制；对该场景进行可行性确认 | H90 | 在髂骨的骨针上套入转接件及参考架 | 转接件及参考架未牢固固定 | 延长手术时间 | 延误手术进程。
 |  |  | Task0046 | 在患者股骨近端植入1枚骨皮质螺钉 | 骨皮质螺钉安装不牢固 | Yes | 延长手术时间 | 将结果输出至RAC进行风险分析及控制；对该场景进行可行性确认 | H91 | 在患者股骨近端植入1枚骨皮质螺钉 | 骨皮质螺钉安装不牢固 | 延长手术时间 | 延误手术进程。
 |  |  | Task0047 | 在患者股骨近端的螺钉上安装转接件及参考架 | 转接件及参考架未牢固固定 | Yes | 延长手术时间 | 将结果输出至RAC进行风险分析及控制；对该场景进行可行性确认 | H92 | 在患者股骨近端的螺钉上安装转接件及参考架 | 转接件及参考架未牢固固定 | 延长手术时间 | 延误手术进程。
 |  |  | Task0048 | 用户进入点云配准界面，使用探针依次在患者骨骼上采集模型提示的特征点 | 用户使用探针采集不到位，导致配准不通过 | Yes | 延长手术时间 | 将结果输出至RAC进行风险分析及控制；对该场景进行可行性确认 | H93 | 用户进入点云配准界面，使用探针依次在患者骨骼上采集模型提示的特征点 | 用户使用探针采集不到位，导致配准不通过 | 延长手术时间 | 延误手术进程。
 |  |  | Task0049 | 用户在粗配准开始前，先在3D模型上修改全部粗配准的特征点 | Rare | No | / | /
 |  |  | Task0050 | 用户在第一次粗配准失败的情况下，修改一个或多个特征点，并再次用探针捕获修改后的特征点（捕获完成且精度通过后自动进入下一界面） | Rare | No | / | /
 |  |  | Task0051 | 使用探针根据工具栏提示依次采集若干特征点，用于精配准 | 探针采集不到位 | Yes | 无法进行本产品辅助下的手术，严重时患者受伤 | 将结果输出至RAC进行风险分析及控制；对该场景进行可行性确认 | H94 | 使用探针根据工具栏提示依次采集若干特征点，用于精配准 | 探针采集不到位 | 无法进行本产品辅助下的手术 | 导致患者伤残
 |  |  | Task0052 | 采集若干点用于配准验证，查看配准结果 | Rare | No | / | /
 |  |  | Task0053 | 用户在精配准失败后重置所有点，重新精配准 | 用户多次重复精配准，均无法成功 | Yes | 延长手术时间 | 将结果输出至RAC进行风险分析及控制；对该场景进行可行性确认 | H95 | 用户在精配准失败后重置所有点，重新精配准 | 用户多次重复精配准，均无法成功 | 延长手术时间 | 延误手术进程。
11 | URS001-031 URS001-034 URS001-035 URS001-036 URS001-037 URS001-038 URS001-039 URS001-040 URS001-046 URS001-047 URS001-048 URS001-049 URS001-050 | 髋臼磨锉与臼杯安放 | Task0054 | 将磨锉杆装入机械臂套筒 | 用户安装错误 | Yes | 延长手术时间 | 将结果输出至RAC进行风险分析及控制；对该场景进行可行性确认 | H96 | 将磨锉杆装入机械臂套筒 | 用户安装错误 | 延长手术时间 | 延误手术进程。
 |  |  | Task0055 | 将髋臼锉装入磨锉杆末端 | 用户安装错误 | Yes | 延长手术时间 | 将结果输出至RAC进行风险分析及控制；对该场景进行可行性确认 | H97 | 将髋臼锉装入磨锉杆末端 | 用户安装错误 | 延长手术时间 | 延误手术进程。
 |  |  | Task0056 | 进入磨锉前准备界面，在软件中选择髋臼锉型号及磨锉杆型号 | 用户在系统选择的型号与实际型号不一致 | Yes | 无法进行本产品辅助下的手术，严重时患者受伤 | 将结果输出至RAC进行风险分析及控制；对该场景进行可行性确认 | H98 | 进入磨锉前准备界面，在软件中选择髋臼锉型号及磨锉杆型号 | 用户在系统选择的型号与实际型号不一致 | 无法进行本产品辅助下的手术 | 导致患者伤残
 |  |  |  |  | 用户中途修改操作工具或髋臼锉等信息，没有在软件上重新选择型号 | Yes | 无法进行本产品辅助下的手术，严重时患者受伤 | 将结果输出至RAC进行风险分析及控制；对该场景进行可行性确认 | H99 | 进入磨锉前准备界面，在软件中选择髋臼锉型号及磨锉杆型号 | 用户中途修改操作工具或髋臼锉等信息，没有在软件上重新选择型号 | 无法进行本产品辅助下的手术 | 导致患者伤残
 |  |  | Task0057 | 用探针验证髋臼锉连杆的精度，以及示踪器的精度 | 探针采集错误 | Yes | 无法进行本产品辅助下的手术，严重时患者受伤 | 将结果输出至RAC进行风险分析及控制；对该场景进行可行性确认 | H100 | 用探针验证髋臼锉连杆的精度，以及示踪器的精度 | 探针采集错误 | 无法进行本产品辅助下的手术 | 导致患者伤残
 |  |  | Task0058 | 将机械臂台车脚撑着地 | 用户未将机械臂台车脚撑着地 | Yes | 无法进行本产品辅助下的手术，严重时患者受伤 | 将结果输出至RAC进行风险分析及控制；对该场景进行可行性确认 | H101 | 将机械臂台车脚撑着地 | 用户未将机械臂台车脚撑着地 | 无法进行本产品辅助下的手术 | 导致患者伤残
 |  |  | Task0059 | 进入磨锉界面，选中自由拖动模式 | Rare | No | / | /
 |  |  | Task0060 | 将机械臂末端拖动至患者髋臼 | Rare | No | / | /
 |  |  | Task0061 | 将骨钻连接在磨锉杆末端，先选择“手动磨锉"模式，消除髋臼周围骨赘 | 用户操作错误或操作不当 | Yes | 患者受伤 | 将结果输出至RAC进行风险分析及控制；对该场景进行可行性确认 | H102 | 将骨钻连接在磨锉杆末端，先选择“手动磨锉"模式，消除髋臼周围骨赘 | 用户操作错误或操作不当 |  | 导致患者伤残
 |  |  | Task0062 | 骨赘清除后，用户在边界保护模式下开始磨锉 | Rare | No | / | /
 |  |  | Task0063 | 用户根据实际需求，使用髋臼钻的正转或反转功能 | 用户误用了骨钻的反转功能 | Yes | 患者受伤 | 将结果输出至RAC进行风险分析及控制；对该场景进行可行性确认 | H103 | 用户根据实际需求，使用髋臼钻的正转或反转功能 | 用户误用了骨钻的反转功能 |  | 导致患者伤残
 |  |  | Task0064 | 用户将机械臂拖离出髋臼，更换髋臼锉型号 | Rare | No | / | /
 |  |  | Task0065 | 用户重新在软件上选择更换的髋臼锉型号 | 用户忘记重新选择髋臼锉型号 | Yes | 无法实现预期手术效果，严重时患者受伤 | 将结果输出至RAC进行风险分析及控制；对该场景进行可行性确认 | H104 | 用户重新在软件上选择更换的髋臼锉型号 | 用户忘记重新选择髋臼锉型号 | 无法实现预期手术效果 | 导致患者伤残
 |  |  | Task0066 | 中途放弃导航系统辅助，移除机械臂 | Rare | No | / | /
 |  |  | Task0067 | 将磨锉杆从机械臂套筒中取下，装上套筒把持装置，用传统方式进行磨锉 | Rare | No | / | /
 |  |  | Task0068 | 将臼杯打入杆装入机械臂末端 | 用户安装错误 | Yes | 延长手术时间，严重时患者受伤 | 将结果输出至RAC进行风险分析及控制；对该场景进行可行性确认 | H105 | 将臼杯打入杆装入机械臂末端 | 用户安装错误 | 延长手术时间 | 导致患者伤残
 |  |  | Task0069 | 在臼杯打入杆上安装示踪器 | 示踪器安装不牢靠 | Yes | 延长手术时间 | 将结果输出至RAC进行风险分析及控制；对该场景进行可行性确认 | H106 | 在臼杯打入杆上安装示踪器 | 示踪器安装不牢靠 | 延长手术时间 | 延误手术进程。
 |  |  | Task0070 | 进入安放前准备界面，将臼杯安装在臼杯打入杆末端 | 打入杆安装不牢靠 | Yes | 延长手术时间，严重时患者受伤 | 将结果输出至RAC进行风险分析及控制；对该场景进行可行性确认 | H107 | 进入安放前准备界面，将臼杯安装在臼杯打入杆末端 | 打入杆安装不牢靠 | 延长手术时间 | 导致患者伤残
 |  |  | Task0071 | 在软件上选择打入杆型号及臼杯型号 | 用户在系统选择的型号与实际型号不一致 | Yes | 无法实现预期手术效果，严重时患者受伤 | 将结果输出至RAC进行风险分析及控制；对该场景进行可行性确认 | H108 | 在软件上选择打入杆型号及臼杯型号 | 用户在系统选择的型号与实际型号不一致 | 无法实现预期手术效果 | 导致患者伤残
 |  |  | Task0072 | 验证臼杯打入杆及示踪器精度 | Rare | No | 无法进行本产品辅助下的手术，严重时患者受伤 | 将结果输出至RAC进行风险分析及控制；对该场景进行可行性确认 | H109 | 验证臼杯打入杆及示踪器精度 | Rare | 无法进行本产品辅助下的手术 | 导致患者伤残
 |  |  | Task0073 | 进入臼杯安放界面，选择自由拖动模式 | Rare | No | / | /
 |  |  | Task0074 | 将机械臂拖动到规划位置附近，选择自动定位 | 机械臂定位错误 | Yes | 无法进行本产品辅助下的手术，严重时患者受伤 | 将结果输出至RAC进行风险分析及控制；对该场景进行可行性确认 | H110 | 将机械臂拖动到规划位置附近，选择自动定位 | 机械臂定位错误 | 无法进行本产品辅助下的手术 | 导致患者伤残
 |  |  | Task0075 | 用骨锤敲击打入杆末端，直至臼杯牢固植入人体适当位置 | 用户未按照规划磨锉，仍然按照规划的角度打入臼杯 | Yes | 无法进行本产品辅助下的手术，严重时患者受伤 | 将结果输出至RAC进行风险分析及控制；对该场景进行可行性确认 | H111 | 用骨锤敲击打入杆末端，直至臼杯牢固植入人体适当位置 | 用户未按照规划磨锉，仍然按照规划的角度打入臼杯 | 无法进行本产品辅助下的手术 | 导致患者伤残
 |  |  |  |  | 用户在错误的方向不断敲击骨锤导致机械臂锁死 | Yes | 无法进行本产品辅助下的手术，严重时患者受伤 | 将结果输出至RAC进行风险分析及控制；对该场景进行可行性确认 | H112 | 用骨锤敲击打入杆末端，直至臼杯牢固植入人体适当位置 | 用户在错误的方向不断敲击骨锤导致机械臂锁死 | 无法进行本产品辅助下的手术 | 导致患者伤残
 |  |  |  |  | 用户误解了剩余敲击距离的提示，导致敲击不到位或者敲击过深 | Yes | 无法进行本产品辅助下的手术，严重时患者受伤 | 将结果输出至RAC进行风险分析及控制；对该场景进行可行性确认 | H113 | 用骨锤敲击打入杆末端，直至臼杯牢固植入人体适当位置 | 用户误解了剩余敲击距离的提示，导致敲击不到位或者敲击过深 | 无法进行本产品辅助下的手术 | 导致患者伤残
 |  |  |  |  | 用户在敲击的过程中，引发髋臼示踪器松动 | Yes | 无法进行本产品辅助下的手术，严重时患者受伤 | 将结果输出至RAC进行风险分析及控制；对该场景进行可行性确认 | H114 | 用骨锤敲击打入杆末端，直至臼杯牢固植入人体适当位置 | 用户在敲击的过程中，引发髋臼示踪器松动 | 无法进行本产品辅助下的手术 | 导致患者伤残
 |  |  | Task0076 | 用户安装臼杯后，可通过探针验证臼杯放置角度 | 探针采集不到位 | No | / | /
12 | URS001-042 URS001-043 URS001-044 | 股骨截骨及验证 | Task0077 | 用探针在患者股骨侧标记规划的截骨线 | 探针操作不到位 | Yes | 无法进行本产品辅助下的手术，严重时患者受伤 | 将结果输出至RAC进行风险分析及控制；对该场景进行可行性确认 | H115 | 用探针在患者股骨侧标记规划的截骨线 | 探针操作不到位 | 无法进行本产品辅助下的手术
 |  |  | Task0078 | 在股骨侧重新装入示踪器，在髓腔锉末端安装转接头 | 示踪器安装不牢靠或转接头安装不到位 | Yes | 无法进行本产品辅助下的手术 | 将结果输出至RAC进行风险分析及控制；对该场景进行可行性确认 | H116 | 在股骨侧重新装入示踪器，在髓腔锉末端安装转接头 | 示踪器安装不牢靠或转接头安装不到位 | 无法进行本产品辅助下的手术
 |  |  | Task0079 | 使用探针依次采集转接头特征点，获得当前髓腔锉前倾角 | Rare | No | / | /
13 | URS001-024 | 术后评估髋关节长度及偏距 | Task0080 | 术前在患者股骨远端植入/贴标记物 | 用户可能遗忘 | Yes | 影响本产品的系统精度 | 将结果输出至RAC进行风险分析及控制；对该场景进行可行性确认 | H117 | 术前在患者股骨远端植入/贴标记物 | 用户可能遗忘 | 影响本产品的系统精度 | 导致患者伤残
 |  |  | Task0081 | 术前在患者股骨近端植入/贴标记物 | 标记钉或标记物术中发生脱落 | Yes | 影响本产品的系统精度 | 将结果输出至RAC进行风险分析及控制；对该场景进行可行性确认 | H118 | 术前在患者股骨近端植入/贴标记物 | 标记钉或标记物术中发生脱落 | 影响本产品的系统精度 | 导致患者伤残
 |  |  | Task0082 | 用探针分别捕获两枚标记钉/物，记录股骨初始位置 | 捕获过程中，患者体位发生了移动，则记录的数据无效 | Yes | 影响本产品的系统精度 | 将结果输出至RAC进行风险分析及控制；对该场景进行可行性确认 | H119 | 用探针分别捕获两枚标记钉/物，记录股骨初始位置 | 捕获过程中，患者体位发生了移动，则记录的数据无效 | 影响本产品的系统精度 | 导致患者伤残
 |  |  | Task0083 | 复位后再次用探针分别捕获两枚标记钉 | 术后捕获标记钉时的体位与术前第一次捕获的体位不一致 | Yes | 影响本产品的系统精度 | 将结果输出至RAC进行风险分析及控制；对该场景进行可行性确认 | H120 | 复位后再次用探针分别捕获两枚标记钉 | 术后捕获标记钉时的体位与术前第一次捕获的体位不一致 | 影响本产品的系统精度 | 导致患者伤残
 |  |  | Task0084 | 将股骨示踪器重新安装于大转子螺钉 | 安装不牢靠 | Yes | 延长手术时间 | 将结果输出至RAC进行风险分析及控制；对该场景进行可行性确认 | H121 | 将股骨示踪器重新安装于大转子螺钉 | 安装不牢靠 | 延长手术时间 | 延误手术进程。
 |  |  | Task0085 | 点击捕获按钮，系统可计算并显示髋关节长度及偏距 | Rare | No | 本产品的术后评估无法使用 | 将结果输出至RAC进行风险分析及控制；对该场景进行可行性确认 | H122 | 点击捕获按钮，系统可计算并显示髋关节长度及偏距 | Rare |  | 本产品的术后评估无法使用
14 | URS002-001 | 意外导致系统崩溃，重启软件后提供可恢复的方案 | Task0086 | 用户在使用软件过程中，突然遇到系统崩溃或死机，因此重启系统 | 关键操作的中断 | Yes | 无法进行本产品辅助下的手术，严重时患者受伤 | 将结果输出至RAC进行风险分析及控制；对该场景进行可行性确认 | H123 | 用户在使用软件过程中，突然遇到系统崩溃或死机，因此重启系统 | 关键操作的中断 |  | 无法进行本产品辅助下的手术，严重时患者受伤
15 | URS002-007 | 台车操作面板应简单易用 | Task0087 | 点击面板的操作按钮进行相应操作 | 按钮操作错误 | Yes | 导致患者体表擦伤，严重可能导致患者受伤 | 将结果输出至RAC进行风险分析及控制；对该场景进行可行性确认 | H124 | 点击面板的操作按钮进行相应操作 | 按钮操作错误 |  | 导致患者体表擦伤，严重可能导致患者受伤
16 | URS002-008 | 硬件接口应方便用户使用 | Task0088 | 通过硬件接口进行设备连接 | 设备连接错误 | Yes | 导致患者体表擦伤，严重可能导致患者受伤 | 将结果输出至RAC进行风险分析及控制；对该场景进行可行性确认 | H125 | 通过硬件接口进行设备连接 | 设备连接错误 |  | 导致患者体表擦伤，严重可能导致患者受伤
17 | URS003-001 | 机械臂台车无菌保护 | Task0089 | 为机械臂台车包裹无菌罩 | 无菌罩包裹错误 | Yes | 导致并发症 | 将结果输出至RAC进行风险分析及控制；对该场景进行可行性确认 | H126 | 为机械臂台车包裹无菌罩 | 无菌罩包裹错误 | 细菌与患者伤口接触。 | 引起并发症。
18 | URS005-001 | 收纳、包装和运输的可用性 | Task0090 | 收纳：在软件的机械臂控制界面，点击收纳位后踩下脚踏，机械臂运行至收纳位；将操作台车与导航台车进行组合拼接 | 机械臂收纳运动中出现自碰撞；操作台车与导航台车拼接不到位导致结构损伤 | / | / | /
 |  |  | Task0091 | 包装：操作台车与导航台车的显示器、导航相机统一包装； 导航台车悬臂独立包装；导航台车与操作台车统一包装；执行台车独立包装 | 包装不到位，导致设备损伤 | / | / | /
 |  |  | Task0092 | 拆卸包装 | Rare | No | / | /
 |  |  | Task0093 | 取出显示器Ⅰ，安装于操作台车上 | Rare | No | / | /
 |  |  | Task0094 | 将操作台车主体引出的电源线与显示器Ⅰ后部接口连接 | Rare | No | / | /
 |  |  | Task0095 | 取出显示器Ⅱ拆下显示器装饰罩，安装在导航台车上 | Rare | No | / | /
 |  |  | Task0096 | 将导航台车主体引出的信号线和电源线与显示器Ⅱ连接 | 接错接口 | No | / | /
 |  |  | Task0097 | 将相机悬臂安装在导航台车上 | 安装不到位，悬臂易掉落 | Yes | 悬臂掉落，手术中断 | 将结果输出至RAC进行风险分析及控制； 对该场景进行可行性确认； | H127 | 将相机悬臂安装在导航台车上 | 安装不到位，悬臂易掉落 | 悬臂掉落，手术中断 | 延误手术进程。
 |  |  | Task0098 | 将相机安装在相机悬臂末端 | 安装不到位，相机易掉落 | Yes | 悬臂掉落，手术中断 | 将结果输出至RAC进行风险分析及控制； 对该场景进行可行性确认； | H128 | 将相机安装在相机悬臂末端 | 安装不到位，相机易掉落 | 悬臂掉落，手术中断 | 延误手术进程。
 |  |  | Task0099 | 将导航台车主体引出的信号线和电源线与双目相机连接 | Rare | No | / | /
 |  |  | Task0100 | 进行机械臂开机检查 | Rare | No | / | /
 |  |  | Task0101 | 从工具包中取出磨挫杆并装在机械臂末端 | 安装不到位 | Yes | 延长安装调试时间 | 将结果输出至RAC进行风险分析及控制； 对该场景进行可行性确认； | H129 | 从工具包中取出磨挫杆并装在机械臂末端 | 安装不到位 | 延长安装调试时间 | 延误手术进程。
 |  |  | Task0102 | 从工具包中取出示踪器，装在磨锉杆末端 | 安装不到位 | Yes | 延长安装调试时间 | 将结果输出至RAC进行风险分析及控制； 对该场景进行可行性确认； | H130 | 从工具包中取出示踪器，装在磨锉杆末端 | 安装不到位 | 延长安装调试时间 | 延误手术进程。
 |  |  | Task0103 | 进行机械臂精度检查 | Rare | No | / | /
 |  |  | Task0104 | 将执行台车拖至手术床合适位置，通过网线与导航台车连接，接通电源并按下“台车降”按钮，使台车底部支撑脚撑着地，脚轮悬空即可 | 台车下降未到位，脚撑未着地 | No | / | /
 |  |  | Task0105 | 现场对系统进行精度调试 | Rare | No | / | /
 |  |  | Task0106 | 完成后关闭系统 | Rare | No | / | /
19 | URS006-001 | 与配套工具包及假体联合使用， 实现基本功能和手术目标 | Task0107 | 术前对配套工具包进行清洁及灭菌处理 | 清洁不充分、灭菌方式选择错误或灭菌不充分 | Yes | 患者发生感染等并发症 | 将结果输出至RAC进行风险分析及控制；对该场景进行可行性确认 | H131 | 术前对配套工具包进行清洁及灭菌处理 | 清洁不充分、灭菌方式选择错误或灭菌不充分 | 细菌与患者伤口接触。 | 引起并发症。
 |  |  | Task0108 | 术前使用标定工具，对工具包进行标定 | 术前标定过程发生错误 | Yes | 患者受伤 | 将结果输出至RAC进行风险分析及控制；对该场景进行可行性确认 | H132 | 术前使用标定工具，对工具包进行标定 | 术前标定过程发生错误 |  | 导致患者伤残

Sheet: 危险源分析
参考YY/T 0316-2016 | 参考ISO14971-2019 | 问题 | 考虑因素 | 适用 与否 | 详细描述 | 可能的危险（源） | 危险源标识
C.2.1 | A.2.1 | 医疗器械的预期用途是什么和怎样使用医疗器械？ | 医疗器械的作用： 疾病的诊断、预防、监护、治疗或者缓解； 伤害或残疾的补偿； 解剖或生理过程的研究、替代或者补偿； 妊辰控制； 使用要求（例如，患者人群）？ 设备用于维持生命或支撑生命？ 医疗器械故障时是否需要特殊干预？ 使用适应症是什么（例如患者群体、用户特征、使用环境）？ 禁忌症是什么？ 如果发生安全漏洞（性能下降或可用性丧失），医疗设备的性能是否会受到影响？ 未经授权的访问、未经授权的活动或数据丢失是否会影响医疗设备的安全？ | 适用 | 是一款有源医疗设备，预期用于髋关节置换手术过程中的手术工具和髋关节假体的导航定位 | 机械能危险 功能危险 | H1 H2
C.2.2 | A.2.2 | 医疗器械是否预期植入？ | 考虑： 植入位置，患者人群的特征，年龄，体重，体力活动，老化对种植体性能的影响，种植体的预期寿命，植入的可逆性。 植入物在植入时是否可以修改或配置，以及执行此修改或配置的接入连接(例如，与植入医疗设备的物理接入点或无线连接)。 | 否 | / | / | /
C.2.3 | A.2.3 | 医疗器械是否预期和患者或其他人员接触？ | 预期的接触性质，即表面接触，侵入性接触或植入，以及接触的周期和频率。 | 适用 | 患者创伤接触。 | 机械能危险 功能危险 生物学危险 | H3 H4 H5
C.2.4 | A.2.4 | 在医疗器械中利用何种材料或组分，或与医疗器械共同使用或与其接触？ | 考虑： 与相关物质的相容性； 与组织或体液的相容性； 是否值得与安全相关的特征？ 是否利用动物源材料？ | 适用 | 与假体、髋臼锉、示踪器、骨针、标记钉、探针共同使用 | 化学危险 生物学危险 | H6 H7
C.2.5 | A.2.5 | 是否有能量给予患者或从患者身上获取？ | 考虑： 能量转移的类型； 其控制、质量、数量、强度和持续时间； 能量基本是否高于类似产品当前应用的能量水平。 | 适用 | 髋臼磨锉 | 机械能危险 辐射能危险（热能） | H8 H9
C.2.6 | A.2.6 | 是否有物质提供给患者或从患者身上提取？ | 考虑： 物质是提供还是提取；无论是单一物质还是一系列物质；最大和最小传送率及其控制。 | 否 | / | / | /
C.2.7 | A.2.7 | 医疗器械是否处理生物材料用于随后的再次使用、输液/血或移植？ | 考虑： 处理过程和物质的类型（例如，自动输血，透析，血液成分或细胞疗法处理） | 否 | / | / | /
C.2.8 | A.2.8 | 医疗器械是否以无菌形式提供或预期由使用者灭菌，或用其它微生物学控制方法灭菌？ | 考虑： 医疗装置是否预期一次性使用包装或重复使用包装； 储存寿命； 重复使用周期次数的限制； 灭菌方式； 制造商非预期灭菌方法的影响。 | 适用 | 联合使用工具包需要医院进行高温或低温等离子灭菌，髋臼钻需要进行灭菌。 | 生物学危险 | H10
C.2.9 | A.2.9 | 医疗器械是否预期由用户进行常规清洁和消毒？ | 考虑： 使用的清洁剂或消毒剂的类型以及对清洁周期数的任何限制。 医疗器械的设计会影响日常清洁和消毒的效果。 应考虑清洁剂和消毒剂对装置的安全性或性能的影响。 | 适用 | 医院进行常规清洁消毒。 | 生物学危险 | H11
C.2.10 | A.2.10 | 医疗器械是否预期改善患者的环境？ | 考虑： 温度； 湿度； 大气成分； 压力； 光线。 | 否 | / | / | /
C.2.11 | A.2.11 | 是否进行测量？ | 考虑： 测量的变量以及测量结果的准确性和精度。以及测量设备或数据是否会受到损害。 此外，还应考虑校准和维护的需要（另见 A.2.18） | 否 | / | / | /
C.2.12 | A.2.12 | 医疗器械是否进行分析处理？ | 考虑： 医疗设备是否从输入数据或采集数据得出结论，使用的算法以及置信限度。 应特别注意数据或算法的非预期应用。以及对算法和数据的未经授权的操作或更改。 | 适用 | 需要对医学图像进行处理。 | 功能危险 | H12
C.2.13 | A.2.13 | 医疗器械是否预期和其它医疗器械、医药或其它医疗技术联合使用？ | 考虑： 识别可能涉及的任何其他医疗装置，药物或其他医疗技术以及与这种相互作用相关的潜在问题以及患者对治疗的依从性。 | 适用 | 与工具包配合使用，与假体共同使用。 | 辐射能危险 机械能危险 | H13 H14
C.2.14 | A.2.14 | 是否有不希望的能量或物质输出？ | 能量相关考虑: 噪声和振动，热量，辐射（包括电离，非电离和紫外/可见/红外辐射），接触温度，泄漏电流和电场或磁场。 物质相关考虑： 制造，清洁或测试中使用的物质，如果留在产品中，会产生不必要的生理影响。 其他物质相关考虑：化学品，废物和体液的排放。 | 适用 | 器械可能发射辐射电磁能及设备发热产生的热源。 | 电磁能危险 辐射能危险 | H15 H16
C.2.15 | A.2.15 | 医疗器械是否对环境影响敏感？ | 考虑： 操作、运输和存储环境。这些因素包括光照、温度、湿度、振动、溢出、对电源和冷却电源变化的敏感性，以及电磁干扰。 | 适用 | 操作、运输和存储环境都会规定要求； 器械可能受环境辐射电磁能、发热及红外干扰影响。 | 标记危险 电磁能危险 辐射能危险 功能危险（红外干扰） | H17 H18 H19 H20
C.2.16 | A.2.16 | 医疗器械是否影响环境？ | 考虑： 对电力和冷却供应的影响； 有毒物质的排放； 电磁干扰的产生。 | 适用 | 器械对环境产生辐射电磁能影响。 | 电磁能危险 辐射能危险 | H21 H22
C.2.17 | A.2.17 | 医疗器械是否有基本的消耗品或附件？ | 考虑： 这些消耗品或附件的规格，以及在选择这些消耗品时对用户的任何限制。 | 否 | / | / | /
C.2.18 | A.2.18 | 是否需要维护和校准？ | 考虑： 是否由操作者或用户或专家进行维护或校准； 维护或校准需要特殊的物质或设备。 校准器值到更高阶参考的可追溯性； 如何确定何时需要维护或重新校准； 如何验证校准（仍然）可以接受。 | 适用 | 整机需要定期维护。 | 功能危险 使用错误危险 | H23 H24
C.2.19 | A.2.19 | 医疗器械是否有软件？ | 考虑： 软件是否打算由操作员或用户或专家安装，验证，修改或交换。以及软件更新的真实性。 | 适用 | 器械预装软件，用户无法修改。 | 功能危险 | H25
C.2.20 | A.2.22 | 医疗器械是否有存储寿命限制？ | 考虑： 医疗器械是否会随着时间的推移而变质、储存条件和初包装的影响、标签或标识，以及到期后此类医疗器械的处置。 | 适用 | 存储寿命8年。 | 功能危险 | H26
C.2.21 | A.2.23 | 是否有延时或长期使用效应？ | 考虑: 人体工程学和累积效应。 示例包括： 随时间腐蚀的盐水泵，机械疲劳，皮带和附件松动， 振动的影响，标签磨损或脱落，长期的材料退化。 | 适用 | 器械机械松动，老化。 标签磨损或脱落。 | 功能危险 | H27
C.2.22 | A.2.24 | 医疗器械承受何种机械力？ | 考虑: 医疗装置受到的力是受用户控制还是与他人的相互作用控制。 | 适用 | 受到的力是受用户及他人的相互作用控制。 | 机械能危险 | H28
C.2.23 | A.2.25 | 什么决定医疗器械的寿命？ | 考虑: 老化和电池耗尽。 还应考虑备件的可用性。 | 适用 | 关键元器件决定医疗器械的寿命。 | 功能危险 | H29
C.2.24 | A.2.26 | 医疗器械是否预期一次性使用？ | 考虑: 医疗器械使用后是否自毁？设备已被使用是否显而易见？ | 否 | / | / | /
C.2.25 | A.2.27 | 医疗器械是否需要安全的退出运行或处置？ | 考虑： 处置医疗设备本身产生的废弃物。 例如，是否含有有毒或有害物质，物质是否可回收？如果医疗器械存储数据，则应考虑对存储数据的正确处理和安全性，包括数据删除和保留。 | 适用 | 相关部件和数据需要按照国家标准规范进行处置。 | 化学危险 信息危险 | H30 H31
C.2.26 | A.2.28 | 医疗器械的安装或使用是否需要专门的培训或专门的技能？ | 考虑： 医疗设备的新颖性以及设备安装人员可能的技能和培训。 | 适用 | 需要培训。 | 使用错误危险 操作说明书危险 | H32 H33
C.2.27 | A.2.29 | 如何提供安全使用信息？ | 考虑： 信息是由制造商直接提供给最终用户，还是涉及安装人员，护理人员，医疗保健专业人员或药剂师等第三方的参与，以及这是否会影响到培训； 调试和交付给最终用户，以及是可以由没有必要技能的人员进行安装； 基于设备的预期寿命，是否需要对操作员或服务人员进行再培训或重新认证。 | 适用 | 必须由专人进行售后安装、调试； 会提供操作说明书。 | 服务和维护规范危险 使用错误危险 操作说明书危险 | H34 H35 H36
C.2.28 | A.2.30 | 是否需要建立或引入新的制造过程？ | 考虑: 新技术或新的生产规模，是否涉及合同制造、供应商的变更。 | 否 | / | / | /
C.2.29 | A.2.31 | 医疗器械的成功使用，是否关键取决于人为因素，例如用户界面？
C.2.29.1 | A.2.31.1 | 用户界面设计特性是否可能促成使用错误？ | 应考虑的因素是可能导致使用错误的用户界面设计。 界面设计的例子包括：控制和指示器，使用的符号，人机工程学特征，物理设计和布局，操作层次，软件驱动设备的菜单，警告的可见性，警报的可听性以及颜色编码的标准化。 有关可用性的更多指导，请参阅IEC 60601-1-6（请参阅IEC 62366-1)，有关警报的指导请参阅IEC 60601-1-8 | 适用 | 用户界面设计可能导致使用错误。 | 标记危险 使用错误危险 | H37 H38
C.2.29.2 | A.2.31.2 | 医疗器械是否在因分散注意力而导致使用错误的环境中使用？ | 考虑： 使用错误的后果； 干扰是否来自公共场所； 用户是否被偶发性事件干扰。 重复的压力是否会降低用户的意识或注意力 | 适用 | 软件的操作界面时会有分散注意力。 | 使用错误危险 | H39
C.2.29.3 | A.2.31.3 | 医疗器械是否有连接部分或附件？ | 考虑: 错误连接的可能性，与其他产品连接的相似性，连接力，对连接完整性的反馈，过度和不足。 | 适用 | 使用脚踏进行控制； 多个台车之间通过数据线进行连接； 执行工具和机械臂之间的连接。 | 使用错误危险 | H40
C.2.29.4 | A.2.31.4 | 医疗器械是否有控制接口？ | 考虑: 间隔，编码，分组，映射，反馈模式，失误，滑动，控制差异，可见性，激活或改变的方向，控制是连续的还是离散的，以及设置或动作的可逆性。 | 适用 | 使用脚踏进行控制； 使用键盘鼠标进行控制； 使用按键进行控制。 | 使用错误危险 | H41
C.2.29.5 | A.2.31.5 | 医疗器械是否显示信息？ | 考虑： 各种环境中的可视性，方向，用户的视觉能力，人口和观点，所呈现信息的清晰度，单位，颜色编码以及关键信息的可访问性。 | 适用 | 软件界面或操作面板均显示信息。 | 使用错误危险 功能危险 | H42 H43
C.2.29.6 | A.2.31.6 | 医疗器械是否由菜单控制？ | 考虑: 复杂性和层数，状态意识，设置位置，导航方法，每个动作的步数，序列清晰度和记忆问题，控制功能相对于其可访问性的重要性以及偏离指定操作程序的影响。 | 适用 | 器械由菜单控制。 | 使用错误危险 功能危险 | H44 H45
C.2.29.7 | A.2.31.7 | 医疗器械是否由具有特殊需要的人使用？ 医疗器械的成功使用是否取决于用户的知识、技能和能力？ | 考虑: 使用者，他们的精神和身体能力，技能和培训，人体工程学方面，使用环境，安装要求以及患者控制或影响医疗设备使用的能力。 应特别关注残疾人，老年人，儿童等有特殊需求的用户。 他们的特殊需求可能包括另一个人的帮助，以便使用医疗设备。 医疗器械是否打算供具有不同技术水平和文化背景的人使用？ 可能影响他们与医疗设备成功交互的能力的预期用户的个人特征。 参阅 IEC TR 62366-2 | 适用 | 经过专业培训的医生。 | 使用错误危险 | H46
C.2.29.8 | A.2.31.8 | 用户界面能否用于启动使用者动作？ | 考虑： 启动一个有意的动作以便用户进入受控操作模式的可能性，增加了患者的风险并且为用户提供了这种情况的意识。 | 适用 | 软件界面会有相应提示，引导用户进行相应动作。 | 使用错误危险 | H47
C.2.30 | A.2.32 | 医疗器械是否使用报警系统？ | 考虑: 是否存在误报，漏报，断电报警系统，不可靠的远程报警系统，以及医务人员了解报警系统工作原理的可能性。 报警系统的指导在IEC 60601-1-8中给出。 | 适用 | 软件界面和指示灯有报警系统。 | 功能危险 | H48
C.2.31 | A.2.33 | 医疗器械可能以什么方式被故意地误用？ | 考虑: 连接器使用不正确，禁用安全功能或警报，忽视制造商推荐的维护。未经授权访问医疗器械或医疗器械功能。 | 适用 | 软件操作存在误用可能性； 用户不按照说明书要求使用和维护器械。 | 使用错误危险 | H49
C.2.32 | A.2.21 | 医疗器械是否持有患者护理的关键数据？ | 考虑： 数据被修改或损坏的后果。未经授权访问数据的可能性以及对患者的后果。 | 适用 | 器械持有患者CT数据。存在未经授权访问数据的可能性 | 使用错误危险 信息危险 | H50 H51
C.2.33 | A.2.34 | 医疗器械是否预期为移动式或便携式？ | 应该考虑的因素是必要的把手，手柄，车轮，制动器，机械稳定性和耐久性。 | 适用 | 移动式医疗设备。 | 机械能危险 | H52
C.2.34 | A.2.35 | 医疗器械的使用是否依赖于基本性能？ | 考虑： 例如，生命支持设备的输出特性或警报的操作。有关性能的讨论，请参见GB 9706.1（IEC60601-1-1） | 适用 | 器械使用依赖定位精度；图像识别精度会影响系统精度。 | 功能危险 | H53
 | A.2.20 | 医疗设备是否允许访问信息？ | 可访问的以太网端口、USB 端口、串行端口和可移动硬盘驱动器。 | 适用 | 有可访问的以太网端口、USB 端口 | 使用错误危险 功能危险 | H54 H55
 | A.2.36 | 医疗器械是否有一定程度的自主权？ | 当具有一定自主权的医疗设备产生错误、警报或故障时，用户能否意识到； 当需要干预自主执行的动作时，用户能否意识到； 用户干预或中止自主执行的操作的能力； 用户选择和执行正确纠正措施的能力。 | 否 | / | / | /
 | A.2.37 | 医疗器械是否产生用作确定临床行为输入的输出？ | 不正确或延迟的输出是否会对患者造成直接或间接的风险，例如。 错误的诊断导致患者治疗延迟或遗漏。 有关体外诊断医疗器械的指南，请参见附录 H。 | 否 | / | / | /

Sheet: 参考
能量危险（源）示例 | 生物学和化学危险（源）示例 | 操作危险（源）示例 | 信息危险（源）示例
电磁能 | 生物学的 | 功能 | 标记
线电压 | 细菌 | 不正确或不适当的输出或功能 | 不完整的使用说明书
漏电流 | 病毒 | 不正确的测量 | 性能特征的不适当的描述
——外壳漏电流 | 其他介质（例如：蛋白病毒） | 错误的测量 | 不适当的预期使用规范
——对地漏电流 | 再次或者交叉感染 | 功能的丧失或变坏 | 局限性未充分公示
——患者漏电流 | 化学的 | 使用错误 | 操作说明书
电场 | 气路、组织、环境或者财产暴露在外来物质中、例如： | 缺乏注意力 | 医疗器械所使用的的附件的规范不适当
磁场 | ——酸或碱 | 记忆力不良 | 使用前检查规范不适当
辐射能 | ——残留物 | 不遵守规则 | 过于复杂的操作说明
电离辐射 | ——污染物 | 缺乏知识 | 警告
非电离辐射 | ——添加剂或者加工助剂 | 违反常规 | 副作用
热能 | ——清洁剂、消毒剂或试验试剂 |  | 一次性使用医疗器械可能重复使用的危险（源）
高温 | ——降解产物 |  | 服务和使用的危险（源）
低温 | ——医用气体
机械能 | ——麻醉产品 |  | 服务和维护规范
重力 | 生物相容性
——坠落 | 化学成分毒性，例如：
——悬挂物 | ——致敏型/刺激
振动 | ——致热源
贮存的能量
运动零件
扭转力、剪切力和张力
患者的移动和定位
声能
——超声能量
——次声能量
——声音
高压液体注射
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
