santan444/MS003/03-设计开发输出阶段/03软件/软件测试/MS-003软件系统测试用例_V1.0.xlsx

Sheet: 封皮
MS-003
系统测试用例
 | 编制/时间：
 | 审核/时间：
 | 批准/时间：
 |  | 杭州三坛医疗科技有限公司

Sheet: 更新履历
文档更改履历
版本号 | 发布日期 | 更改内容概述 | 更改者
1 | 2023-03-02 | 文件新编 | 张彦彦

Sheet: 系统用例
MS-003系统测试用例
用例编号 | 一级模块 | 二级模块 | 技术需求编号 | 用例名称 | 前提条件 | 操作步骤 | 预期结果
MS003_SC_001 | 01登录 | / | TR010101 | 开机-软件自启动 | 1、软件已注册； | 1、通电，按电源开关，按开机； 2、观察软件是否自动启动； | 1、软件启动，显示登录页面；
MS003_SC_002 | 01登录 | / | TR010102 | 验证码正确-注册成功 | 1、软件未注册； | 1、安装软件； 2、启动软件，进入注册页面； 3、输入正确的验证码； 4、点击注册； | 1、注册成功，进入登录页面；
MS003_SC_003 | 01登录 | / | TR010102 | 注册页面点击关机 | 1、软件未注册； | 1、安装软件； 2、启动软件，进入注册页面； 3、点击关机； | 1、软件关闭，工作站关机；
MS003_SC_004 | 01登录 | / | TR010103、TR010104 | 查看登录页面UI | 1、软件已注册； | 1、主机开机； 2、自动进入软件登录页面； 3、查看登录页面UI； | 1、显示logo、软件名称、标语、关于、关机、账号密码、登录按钮；
MS003_SC_005 | 01登录 | / | TR010105 | 关于、维护帮助、使用帮助-内容查看 | 1、软件已注册； 2、进入登录页面； | 1、点击关于，查看内容； 2、点击维护帮助，查看内容； 3、点击使用帮助，查看内容； | 1、与技术需求说明书描述一致；
MS003_SC_006 | 01登录 | / | TR010105 | 关机-锁屏、关机-关机、关机-重启、关机-注销 | 1、软件已注册； 2、进入登录页面； | 1、点击关机，点击锁屏； 2、点击关机，点击关机； 3、点击关机，点击重启； 4、点击关机，点击注销； | 1、软件锁屏，输入正确密码，进入系统； 软件关闭，工作站关机； 系统软件重启； 注销软件退出当前账号，进入登录页面；
MS003_SC_007 | 01登录 | / | TR010106、TR010110 | 管理员创建普通账号-查看登录页面账号列表 | 1、软件已注册； 2、进入登录页面； 3、管理员已创建普通账号； | 1、查看账号列表； 2、一级管理员、售后账号、普通账号分别登录； | 1、一级管理员、售后账号、普通账号存在，分别登录成功；
MS003_SC_008 | 01登录 | / | TR010107 | 一级管理员登录-只可操作用户管理 | 1、软件已注册； | 1、一级管理员登录； 2、进入用户管理，新增账号； 3、操作除用户管理页面的其他功能； | 1、只能操作用户管理；
MS003_SC_009 | 01登录 | / | TR010107 | 一级管理员登录-新增二级管理员及普通账号 | 1、软件已注册； | 1、一级管理员登录； 2、进入用户管理，新增二级管理员及普通账号； | 1、新增成功；新增用户可以登录；
MS003_SC_010 | 01登录 | / | TR010107 | 二级管理员登录-只能创建普通账号 | 1、软件已注册； | 1、二级管理员登录； 2、进入用户管理，新增普通账号； | 1、只能新增普通账号，无法操作其他功能；
MS003_SC_011 | 01登录 | / | TR010108 | 售后账号登录-进行手术及系统后台数据删减操作 | 1、软件已注册； | 1、售后账号登录； 2、进行手术及系统后台数据删减操作； | 1、可进行数据删减及手术过程相关操作；
MS003_SC_012 | 01登录 | / | TR010109 | 普通账号登录-仅能进行手术相关操作 | 1、软件已注册； | 1、普通账号登录； 2、进行手术相关操作并进行其他操作； | 1、仅能进行手术相关操作；
MS003_SC_013 | 02患者管理 | 患者管理 | TR020101 | 查看患者管理页面UI | 1、普通账号已登录； | 1、查看患者管理页面UI； | 1、显示logo、产品名称、版本号、截图、关于、设置、关机、患者管理和手术记录子页面； 默认显示患者管理；
MS003_SC_014 | 02患者管理 | 患者管理 | TR020102 | 患者管理-手术记录页面切换 | 1、普通账号已登录； 2、进入患者管理页面； | 1、点击手术记录； 2、点击患者管理； | 1、进入手术记录页面，后进入患者管理页面；
MS003_SC_015 | 02患者管理 | 患者管理 | TR020103 | 截图成功 | 1、普通账号已登录； 2、进入患者管理页面； | 1、点击截图，查看提示； 2、鼠标点击任意位置； | 1、提示截图成功，点击任意位置提示消失；
MS003_SC_016 | 02患者管理 | 患者管理 | TR020104 | 点击设置 | 1、进入患者管理页面； | 1、点击设置； 2、查看设置页面内容，并设置； | 1、设置页面内容与技术需求一致，修改内容，可以设置成功；
MS003_SC_017 | 02患者管理 | 患者管理 | TR020105 | 点击关于、关机 | 1、进入患者管理页面； | 1、点击关于，点击关机； 2、查看功能菜单及内容，验证锁屏等功能的正确性； | 1、同上述MS003_SC_005、MS003_SC_006的结果；
MS003_SC_018 | 02患者管理 | 患者管理 | TR020106、TR020107 | 查看患者管理页面UI | 1、进入患者管理页面； | 1、查看患者管理页面UI； | 1、显示新增病例、导入规划、导出规划、下一步按钮、搜索栏、患者列表（姓名、ID、状态、手术入路、滚动条）列表按创建时间倒序排列、图像预览窗口；
MS003_SC_019 | 02患者管理 | 患者管理 | TR020108 | 双击患者信息-修改-保存 | 1、进入患者管理页面； | 1、双击患者姓名； 2、修改患者姓名、性别、年龄、手术时间、病历号、主刀医生、备注、手术侧、软件流程、手术入路； 3、点击确定； | 1、仅姓名、性别、年龄、手术时间、病历号、主刀医生、备注被修改成功；
MS003_SC_020 | 02患者管理 | 患者管理 | TR020109 | 选中已规划病例-预览 | 1、进入患者管理页面； 2、选中已规划病例； | 1、选中已规划病例； 2、查看预览窗口视图及其他内容显示； | 1、左侧显示名称、ID、手术入路，中间显示横断面、矢状面、冠状面及3D图；
MS003_SC_021 | 02患者管理 | 患者管理 | TR020110 | 选中已规划病例-点下一步-点是 | 1、进入患者管理页面； 2、患者列表存在已规划和未规划的病例； | 1、选中已规划的病例； 2、点击下一步，弹框提示是否接受CT标记结果？ 3、点击是； | 1、进入手术方案下的手术规划页面；
MS003_SC_022 | 02患者管理 | 患者管理 | TR020110 | 选中已规划病例-点下一步-点否 | 1、进入患者管理页面； 2、患者列表存在已规划和未规划的病例； | 1、选中已规划的病例； 2、点击下一步，弹框提示是否接受CT标记结果？ 3、点击否； | 1、进入手术方案下的CT标记页面；
MS003_SC_023 | 02患者管理 | 患者管理 | TR020110 | 选中未规划病例-点下一步 | 1、进入患者管理页面； 2、患者列表存在已规划和未规划的病例； | 1、选中未规划的病例； 2、点击下一步； | 1、进入导入CT页面；
MS003_SC_024 | 02患者管理 | 患者管理 | TR020111 | 新增病例-成功 | 1、进入患者管理页面； | 1、点击新增病例； 2、输入必填项及其他患者信息； 3、点击确认； | 1、患者管理列表新增一条数据，数据正确；
MS003_SC_025 | 02患者管理 | 患者管理 | TR020112 | 导入规划数据 | 1、进入患者管理页面； 2、已规划病例中包含患者病例信息、CT数据、分割数据、规划数据； | 1、点击导入规划，选中已规划病例； 2、点击加载； | 1、患者管理列表新增一条数据，数据正确；
MS003_SC_026 | 02患者管理 | 患者管理 | TR020112 | 导出规划数据 | 1、进入患者管理页面； 2、已规划病例中包含患者病例信息、CT数据、分割数据、规划数据； | 1、插入U盘，选中已规划病例； 2、点击导出规划； 3、点击确定； | 1、提示规划数据导出完毕，数据内容正确；
MS003_SC_027 | 02患者管理 | 患者管理 | TR020113 | 根据姓名、手术入路搜索 | 1、进入患者管理页面； 2、患者管理列表有数据； | 1、输入姓名，点击搜索； 2、输入手术入路，点击搜索； | 1、显示与搜索条件匹配的所有数据；
MS003_SC_028 | 02患者管理 | 手术记录 | TR020201、TR020202、TR020203、TR020204 | 查看手术记录页面UI | 1、进入患者管理页面； | 1、点击手术记录； 2、查看手术记录页面UI； | 1、显示搜索框、姓名、ID、手术入路、软件流程、滚动条、患者姓名、病例号、手术入路、手术流程、CT预览、手术截图、手术报告、四视图、导出报告；
MS003_SC_029 | 02患者管理 | 手术记录 | TR020204 | 选中患者病例-查看手术记录右侧变化 | 1、进入手术记录页面； | 1、选中病例，查看右侧变化； | 1、显示选中病例的图像；
MS003_SC_030 | 02患者管理 | 手术记录 | TR020205 | 进入手术截图页面-截图 | 1、进入手术记录-手术截图； | 1、选中病例，点击手术截图； 2、点击截图； | 1、窗口截图+1；
MS003_SC_031 | 02患者管理 | 手术记录 | TR020206 | 查看手术记录-手术报告显示内容 | 1、进入手术记录-手术报告； | 1、选中病例； 2、点击手术报告； 3、查看报告内容； | 1、显示患者姓名、性别、年龄、病历号、手术时间、软件流程、手术入路、手术侧、手术方案、手术结果；
MS003_SC_032 | 02患者管理 | 手术记录 | TR020207 | 导出手术报告 | 1、进入手术记录页面； | 1、插入U盘； 2、选中手术已结束的病例； 3、点击导出报告； | 1、导出成功，提示报告导出完毕，内容完整正确；
MS003_SC_033 | 03 用户管理 | 管理员账号管理 | TR030101 | 一级管理员登录-查看用户管理页面UI | 1、一级管理员登录； 2、已进入用户管理页面； 3、账户列表有多个二级管理员和普通账户； | 1、查看用户管理页面UI； | 1、顶部显示logo、产品名、版本号、截图、关于、设置、关机；下面显示用户管理列表（用户名、真实姓名、用户类别、创建时间、手术例数、操作）、新建用户按钮； 账户列表显示所有二级管理员和普通账户；
MS003_SC_034 | 03 用户管理 | 管理员账号管理 | TR030101 | 二级管理员登录-查看用户管理页面UI | 1、二级管理员登录； 2、已进入用户管理页面； 3、账户列表有多个二级管理员和普通账户； | 1、查看用户管理页面UI； | 1、顶部显示logo、产品名、版本号、截图、关于、设置、关机；下面显示用户管理列表（用户名、真实姓名、用户类别、创建时间、手术例数、操作）、新建用户按钮； 账户列表只显示当前二级管理员创建的普通账户；
MS003_SC_035 | 03 用户管理 | 管理员账号管理 | TR030102、 TR030103 | 编辑用户 | 1、已进入用户管理页面； 2、账户列表有多个二级管理员和普通账户； | 1、一级管理员登录；点击二级管理员和普通账户后的编辑，输入用户名，真实姓名，用户类别，密码； 2、点击保存； 3、二级管理员登录；点击普通账户后的编辑，输入用户名，真实姓名，用户类别，密码； 4、点击保存； | 1、用户信息保存成功；
MS003_SC_036 | 03 用户管理 | 管理员账号管理 | TR030102 | 删除用户 | 1、账户列表有多个二级管理员和普通账户； | 1、管理员登录，点击账号后面的删除； 2、删除账号登录； | 1、删除账号用户列表不显示，且无法登录；
MS003_SC_037 | 03 用户管理 | 管理员账号管理 | TR030104、 TR030105 | 查看新建用户页面UI | 1、已进入用户管理； | 1、点击新建用户； 2、查看新建用户页面UI； | 1、显示新建用户，×，用户名，真实姓名，用户类别，密码，取消添加；
MS003_SC_038 | 03 用户管理 | 管理员账号管理 | TR030104、 TR030106 | 新建用户 | 1、已进入用户管理； | 1、点击新建用户； 2、输入用户姓名测试账户1A,输入真实姓名王三，选择普通用户或二级管理员；输入密码123456a； 3、点击添加； 4、新建用户，输入信息，点击取消； | 1、点添加，用户添加成功可以登录，点取消，用户添加失败，无法登录；
MS003_SC_039 | 03 用户管理 | 售后账号管理 | TR030201 | 查看工具管理页面UI | 1、进入工具包管理页面； | 1、查看工具包管理页面UI； | 1、顶部显示logo、产品名、版本号、截图、关于、设置、关机； 工具包管理列表显示序号、工具包名称、工具包编号、操作；导入工具包按钮；
MS003_SC_040 | 03 用户管理 | 售后账号管理 | TR030202 | 导入工具包 | 1、进入工具包管理页面； | 1、插入U盘，点击导入工具包； 2、选择工具包导入； | 1、导入成功，工具包显示在工具包列表；
MS003_SC_041 | 03 用户管理 | 售后账号管理 | TR030203、 TR030204 | 查看工具包数据详情-删除工具包 | 1、进入工具包管理页面； 2、工具包已导入； | 1、点击工具包后面的数据详情； 2、点击删除； | 1、数据详情显示工具包名称、编号（产品型号+年月+4位流水号）；显示探针、患者示踪器、股骨示踪器、髋臼示踪器、配准板、工装的编号，型号；
MS003_SC_042 | 03 用户管理 | 售后账号管理 | TR030205 | 查看假体管理页面UI | 1、进入假体管理页面； | 1、查看假体管理页面UI； | 1、假体列表显示序号、假体名称、假体编号、操作、导入假体；
MS003_SC_043 | 03 用户管理 | 售后账号管理 | TR030206 | 导入假体包 | 1、进入假体管理页面； | 1、插入U盘，点击导入假体； 2、选择假体包，点击确认； | 1、假体列表新增一条信息；
MS003_SC_044 | 03 用户管理 | 售后账号管理 | TR030207、 TR030208 | 查看假体包数据详情-删除假体包 | 1、进入假体管理页面； 2、假体列表存在假体信息； | 1、点击假体信息后的数据详情； 2、点击删除； | 1、详情页面显示假体包编号-数据详情，臼杯、股骨柄、衬垫、球头的编号和型号；
MS003_SC_045 | 04 手术方案 | CT导入 | TR040101 | 选择髋臼-查看CT导入页面UI | 1、进入CT导入页面； 2、软件流程选择髋臼； | 1、查看CT导入页面UI； | 1、显示logo、产品名称、版本号、截图、设置、关于、关机、导航栏包括手术方案、术前准备、髋臼制备、手术结果，图像序列选择窗口、图像预览窗口，导入CT、上一步、下一步按钮；
MS003_SC_046 | 04 手术方案 | CT导入 | TR040101 | 选择股骨及髋臼-查看CT导入页面UI | 1、进入CT导入页面； 2、软件流程选择股骨及髋臼； | 1、查看CT导入页面UI； | 1、导航栏增加股骨制备；
MS003_SC_047 | 04 手术方案 | CT导入 | TR040102 | 选择CT导入-导入成功 | 1、进入CT导入页面； | 1、点击导入CT； 2、选择CT，点击加载； | 1、CT导入成功，显示CT；
MS003_SC_048 | 04 手术方案 | CT导入 | TR040103 | 查看CT预览页面UI | 1、CT已导入； 2、进入CT导入页面； | 1、查看CT预览页面UI； | 1、显示患者姓名、勾选框、部位、层厚、层数、图像序列第一层、窗宽窗位调节按钮、导入CT按钮、患者姓名、出生年月、CT扫描时间、髋关节、股骨远端选项及确定按钮、信息提示栏、上一步、下一步按钮；
MS003_SC_049 | 04 手术方案 | CT导入 | TR040103 | 选中序列-绑定髋关节及股骨远端-进入CT预处理 | 1、CT已导入； 2、进入CT导入页面； | 1、选中髋关节，选中髋关节序列； 2、选中股骨远端，选中股骨远端序列，点击确定； 3、点击下一步； | 1、进入CT预处理页面；
MS003_SC_050 | 04 手术方案 | CT预处理 | TR040201 | 查看CT预处理页面UI | 1、CT已导入； 2、已进入CT预处理页面； | 1、点击髋关节，查看页面显示； 2、点击股骨远端，查看页面显示； | 1、左侧显示4视图（窗宽窗位调节、放大按钮）、患者姓名、出生年月、CT扫描时间、髋关节、股骨远端、重置、信息提示栏、上一步、下一步按钮；
MS003_SC_051 | 04 手术方案 | CT预处理 | TR040202 | CT预处理页面-视图放大缩小、窗宽窗位调节 | 1、CT已导入； 2、已进入CT预处理页面； | 1、选中髋关节，点击视图放大，再次点击视图放大； 2、点击窗宽窗位，调整窗宽窗位； | 1、2+2模式变为3+1模式再变为2+2，图像窗宽窗位变化；
MS003_SC_052 | 04 手术方案 | CT预处理 | TR040203 | 通过长方形边框裁剪3D视图 | 1、CT已导入； 2、已进入CT预处理页面； | 1、通过拉伸3D视图边框调整长方体大小； | 1、3D视图被裁剪；
MS003_SC_053 | 04 手术方案 | CT预处理 | TR040204 | 点击重置 | 1、CT已导入； 2、已进入CT预处理页面； | 1、对髋关节及股骨远端进行处理； 2、点击重置； | 1、恢复至原始数据；
MS003_SC_054 | 04 手术方案 | CT预处理 | TR040205 | 上一步下一步测试 | 1、CT已导入； 2、已进入CT预处理页面； | 1、点击上一步； 2、点击下一步； | 1、返回导入CT导入页面，进入模型导入页面，保存已处理的CT数据；
MS003_SC_055 | 04 手术方案 | 模型导入 | TR040301 | 查看模型导入页面UI | 1、已进入模型导入页面； | 1、查看模型导入页面UI； | 1、显示四视图（窗宽窗位、视图放大）、导入骨盆模型、导入股骨模型术侧、导入股骨模型对侧、重置、信息提示框、上一步、下一步按钮；
MS003_SC_056 | 04 手术方案 | 模型导入 | TR040302、 TR040303、 TR040304、 TR040306 | 导入骨盆、导入股骨术侧、导入股骨对侧模型STL文件 | 1、已进入模型导入页面； | 1、点击导入骨盆模型STL文件，导入，点击加载； 2、点击股骨术侧模型STL文件，导入，点击加载； 3、点击导入股骨对侧模型STL文件，导入，点击加载； 4、点击下一步； | 1、进入CT标记页面；信息提示狂提示相应信息；
MS003_SC_057 | 04 手术方案 | 模型导入 | TR040305 | 点击重置-确认清除数据 | 1、已进入模型导入页面； | 1、骨盆、股骨外侧、股骨术侧STL文件已导入； 2、点击重置，提示“是否清除所有模型数据！”； 3、点击确认； | 1、提示弹框关闭，当前病例的所有模型数据被清除；
MS003_SC_058 | 04 手术方案 | 模型导入 | TR040307 | 上一步/下一步测试 | 1、已进入模型导入页面； | 1、点击上一步； 2、点击下一步； | 1、返回CT处理页面； 下一步进入CT标记页面；
MS003_SC_059 | 04 手术方案 | CT标记 | TR040401 | 查看CT标记页面UI | 1、已进入CT标记页面； | 1、查看CT标记页面UI； | 1、默认3+1模式，2D图（放大按钮）、3D图（重置、MPR、C、T、S、体绘制、测量），骨盆，股骨，膝关节，确认、重置，信息提示框、上一步、下一步；
MS003_SC_060 | 04 手术方案 | CT标记 | TR040402、 TR040403、 TR040404、 TR040405、 TR040406 TR040407 TR040408 | CT标记-功能按钮测试 | 1、已进入CT标记页面； | 1、点击视图放大、添加标记点点击重置、点击MPR、点击C、T、S、体绘制、画线测量； | 1、视图放大、重置所有标记点，MPR重建、C显示冠状面、T显示横断面、S显示矢状面，体绘制显示体绘制模式，可以画线测量；
MS003_SC_061 | 04 手术方案 | CT标记 | TR040409 | 骨盆标记点选取 | 1、已进入CT标记页面； | 1、选中术侧髂前上棘、选标记点，点确认； 2、选中对侧髂前上棘，选标记点，点确认； 3、选耻骨联合中心，选标记点，点确认； 4、选旋转中心（对侧），选10个标记点，复选髋臼后部、髋臼前部、髋臼上部； | 1、标记点在图像上显示；
MS003_SC_062 | 04 手术方案 | CT标记 | TR040410 | 股骨标记选取 | 1、已进入CT标记页面； | 1、选中股骨特征点1，选标记点，点确认； 2、选中股骨特征点2，选标记点，点确认； 3、选中股骨特征点3，选标记点，点确认； 4、选股骨头中心，选标记点，点确认； 5、选股骨颈中心，选标记点，点确认； 6、选小转子，选标记点，点确认； 7、选股骨干近端中心，选标记点，点确认； 8、选股骨远端中心，选标记点，点确认； 9、选对侧股骨头中心，选标记点，点确认； 10、选对侧小转子，选标记点，点确认； 11、选对侧股骨干近端中心，选标记点，点确认； 12、选对侧股骨干远端中心，选标记点，点确认； | 1、标记点在图像上显示；
MS003_SC_063 | 04 手术方案 | CT标记 | TR040411 | 膝关节标记选取 | 1、已进入CT标记页面； | 1、选中膝关节内上踝，选标记点，点确认； 2、选中膝关节外上踝，选标记点，点确认； 3、选中右侧膝关节内上踝，选标记点，点确认； 4、选中右侧膝关节外上踝，选标记点，点确认； | 1、标记点在图像上显示；
MS003_SC_064 | 04 手术方案 | CT标记 | TR040412 | 上一步/下一步测试 | 1、已进入CT标记页面； 2、已完成CT标记； | 1、点击上一步； 2、点击下一步； | 1、返回模型导入页面；下一步进入手术规划页面；
MS003_SC_065 | 04 手术方案 | 手术规划 | TR040501、 TR040502、 TR040512 | 查看手术规划页面UI | 1、已进入手术规划页面； | 1、查看手术规划页面UI； | 1、视图显示区、规划类型选项区（术前、臼杯、股骨柄、复位）；假体的品牌、臼杯型号、规格，衬垫型号，股骨头的型号、规格、长度，股骨柄的型号、规格、颈干角；设为默认、重置、导出规划、上一步、下一步按钮；界面显示虚拟矫正后的髋关节的DRR图像，右上角显示股骨倾角、界面显示髂前上棘连线、骨盆中轴线及两侧小转子到中轴线的连线，左下角显示对比对侧与对比术前的髋长和联合偏距值，对比术前的显示N/A;
MS003_SC_066 | 04 手术方案 | 手术规划 | TR040503、 TR040504、 TR040505、 TR040506 | 术前、臼杯、股骨柄、复位功能区页面切换 | 1、已进入手术规划页面； | 1、点击术前、臼杯、股骨柄、复位； 2、查看右侧功能区； | 1、显示选中规划类型的功能参数区；
MS003_SC_067 | 04 手术方案 | 手术规划 | TR040507、 TR040508 | 设置默认、重置测试 | 1、已进入手术规划页面； | 1、选中假体品牌及参数，选设置为默认； 2、规划完成，点击重置； | 1、选中项变为默认项，点重置，假体的信息数据恢复为默认配置；
MS003_SC_068 | 04 手术方案 | 手术规划 | TR040509、 TR040510 | 导出规划 | 1、已进入手术规划页面； | 1、插入U盘； 2、规划完成，点击导出规划，选择U盘目录，点击确认，导出完成，点确认； | 1、弹框提示规划数据导出完毕，点确认，弹框关闭；
MS003_SC_069 | 04 手术方案 | 手术规划 | TR040511 | 查看手术信息确认页面UI及内容 | 1、已进入手术规划页面； 2、已规划完成； | 1、点击下一步，查看手术信息确认页面内容； | 1、显示患者姓名、年龄、手术侧、手术入路，假体品牌、臼杯、股骨柄、股骨头、衬垫类型、型号；臼杯前倾角、外展角、前外展角、股骨柄倾角、髋长差值、联合偏距差值、髋长改变值、联合偏距改变值；本人已阅读并确认上述信息，返回、确认按钮；
MS003_SC_070 | 04 手术方案 | 手术规划 | TR040511 | 上一步、下一步测试 | 1、已进入手术规划页面； 2、已规划完成； | 1、点击上一步； 2、点击下一步； | 1、返回CT标记页面，进入术前准备页面；
MS003_SC_071 | 04 手术方案 | 手术规划 | TR040513 | 查看臼杯规划页面UI | 1、已进入手术规划页面； | 1、查看臼杯规划页面UI； | 1、3+1模式，2D图（上移、下移、左移、右移、左旋、右旋、视图放大按钮），3D（重置、MPR、C、T、S、体绘制、测量、放大），平移幅度0.25mm、旋转幅度0.5°，臼杯VS解剖中心参数（内侧、后侧、上侧），脊柱-骨盆矢状面平衡（展开按钮、臼杯前倾角、臼杯外展角、骨盆倾角、臼杯前外展角、推荐值）；术前、臼杯、磨挫、X片、股骨柄、复位、假体品牌选择项、设为默认、重置、导出规划、信息提示栏、上一步、下一步；
MS003_SC_072 | 04 手术方案 | 手术规划 | TR040514、 TR040515 | 臼杯规划 | 1、已进入手术规划页面； | 1、选中臼杯选项栏； 2、选择臼杯假体型号，调整假体位置； 3、点击X片显示髋臼部位的DRR图，臼杯假体显示在X光底图上； 4、通过平移旋转及∨∧调整臼杯假体与髋臼的相对角度及位置，直到完全匹配； | 1、臼杯假体安放在髋臼部位的合适位置；
MS003_SC_073 | 04 手术方案 | 手术规划 | TR040516 | 查看股骨柄规划页面UI | 1、已进入手术规划页面； | 1、点击股骨柄； 2、查看股骨柄规划页面UI； | 1、3+1模式，2D图（上移、下移、左移、右移、左旋、右旋、视图放大按钮），3D（重置、MPR、C、T、S、体绘制、测量、放大），股骨倾角、股骨柄倾角可调整、手术方案（左）对比对侧的髋长及联合偏距值、对比术前的髋长及联合偏距值；术前、臼杯、股骨柄、复位、假体品牌选项，设为默认，重置，导出规划，信息提示框，上一步，下一步；
MS003_SC_074 | 04 手术方案 | 手术规划 | TR040516 | 股骨柄规划 | 1、已进入手术规划页面； | 1、点击股骨柄； 2、选择合适的股骨头型号； 3、移动股骨股骨柄与股骨头贴合； 4、通过∨∧调整股骨柄的角度，直到合适的位置； | 1、骨股柄与股骨头被调整到合适的位置；
MS003_SC_075 | 04 手术方案 | 手术规划 | TR040517 | 查看复位评估页面UI | 1、已进入手术规划页面； | 1、点击复位； 2、查看复位页面UI | 1、复位选项被选中，默认显示3D视图，左键旋转、滚轮调整大小，滚轮移动鼠标是平移，左下角显示对比对侧和对比术前的髋长和联合偏距值，右上角为视图矢状位、正位调整快捷键，臼杯前倾角、臼杯外展角、股骨柄倾角的规划值，∨∧调整规划数据的值； 右下角显示日常行为和个性化行为仿真功能区，有三个滑条的＋减号调整腿部的伸直-屈曲、外旋-内旋，外展-内收的角度值； 下方显示日常行为图标区，图标仅在日常行为栏被激活； 右侧显示术前、臼杯、股骨柄、复位、X片，假体品牌臼杯、衬垫、球头、股骨柄选择；设为默认按钮、重置、导出规划、信息提示栏，上一步，下一步按钮；
MS003_SC_076 | 04 手术方案 | 手术规划 | TR040518 | 日常行为-仿真碰撞检测 | 1、已进入手术规划页面； | 1、选择合适的衬垫； 2、调整股骨柄倾角使股骨头与臼杯贴合，无角度偏差； 3、调整好后，通过修改站立位及坐位的各个角度值，查看复位效果； 4、点击前面5个小人，查看运动轨迹和碰撞检测，图标的变化； 5、点击图标6-图标8，查看图标变化并通过滑条来调整角度； | 1、复位成功，可正常弯曲伸直、内旋外旋、内收外展；角度值随着gif的变化而变化，碰撞出现红色，无碰撞，为绿色，有高碰撞风险，为黄色；灰色区域滑条可以调整，每间隔5°调整一下；
MS003_SC_077 | 04 手术方案 | 手术规划 | TR040519 | 个性化行为-仿真碰撞检测 | 1、已进入手术规划页面； | 1、医生通过滑条调整角度值； 2、观察3D模型是否碰撞； 3、有碰撞，重新设置假体参数，直到不碰撞，查看模型变化； | 1、检测到的碰撞区域显示在3D模型上，直到假体参数重新设置不碰撞，3D模型显示正常未碰撞；
MS003_SC_078 | 04 手术方案 | 手术规划 | TR040520 | 进入X片模式下-进行复位评估 | 1、已进入手术规划页面； | 1、复位评估页面，点击X片； 2、进入X片模式，查看复位评估页面； | 1、X光底图现在在3D视图下方；
MS003_SC_079 | 05 增强版模式 | 术前准备 | TR050101、 TR050102、 TR050103 | 查看手术设置界面UI | 1、进入增强版术前准备页面； | 1、查看术前准备-手术设置界面UI； | 1、手术设置包含软件流程（髋臼、股骨及髋臼）、手术入路方式（后外侧、直接正前方、直接外侧、其他）、操作杆类型（偏心操作杆、直操作杆）、工具包（工具包1、工具包2....）;信息提示框、上一步、下一步；
MS003_SC_080 | 05 增强版模式 | 术前准备 | TR050104 | 手术设置界面-上一步/下一步测试 | 1、进入增强版术前准备页面； | 1、点击上一步； 2、选择软件流程其中一、选中手术入路其一、选中操作杆类型其一、选中工具包其一； 3、点击下一步； | 1、返回手术规划页面； 进入机械臂检查界面；
MS003_SC_081 | 05 增强版模式 | 术前准备 | TR050105 | 查看机械臂开机检查页面UI | 1、进入机械臂开机检查页面； | 1、查看机械臂开机检查界面UI； | 1、机械臂运动姿态运动示意图、底部显示进度条、右侧显示零点检验、刹车检验、开始、重置、上一步、下一步按钮；
MS003_SC_082 | 05 增强版模式 | 术前准备 | TR050106、TR050107 | 机械臂开机检查 | 1、进入机械臂开机检查页面； | 1、勾选零点检验，点开始； 2、勾选刹车检验，点开始； | 1、显示检验进度条，示意图变化，检验完成变为√；
MS003_SC_083 | 05 增强版模式 | 术前准备 | TR050108 | 机械臂开机检查界面-上一步/下一步测试 | 1、进入机械臂开机检查页面； 2、机械臂自检完成； | 1、点击上一步； 2、点击下一步； | 1、返回手术设置页面； 2、进入无菌罩包裹引导页面；
MS003_SC_084 | 05 增强版模式 | 术前准备 | TR050109 | 查看无菌罩包裹引导页面UI | 1、已进入无菌罩包裹引导页面； | 1、查看无菌罩包裹引导页面UI； 2、安装无菌罩； | 1、无菌罩包裹示意图，信息提示框，上一步、下一步按钮；
MS003_SC_085 | 05 增强版模式 | 术前准备 | TR050110、 TR050111 | 无菌罩包裹引导页面-上一步/下一步测试 | 1、已进入无菌罩包裹引导页面； | 1、点击上一步； 2、点击下一步； | 1、返回机械臂开机检查页面； 2、进入机械臂在线标定页面；
MS003_SC_086 | 05 增强版模式 | 术前准备 | TR050112 | 查看机械臂在线标定引导页面UI | 1、进入机械臂在线标定引导页面； | 1、查看机械臂在线标定页面UI； | 1、左侧显示机械臂精度检查（含磨挫杆标定）+机械臂在线标定引导示意图，底部显示进度条；右侧显示机械臂基座示踪器、末端示踪器、探针图标；机械臂精度检查提示框及显示框，捕获、重置、信息提示框，上一步、下一步按钮；
MS003_SC_087 | 05 增强版模式 | 术前准备 | TR050113、TR050114 | 机械臂在线标定 | 1、进入机械臂在线标定引导页面；2、机械臂基座示踪器、末端示踪器、探针示踪器已被识别到； | 1、点击捕获，观察机械臂标定进度及结果； | 1、标定过程中显示标定进度，标定完成，机械臂精度检查前面的复选框显示√，显示机械臂标定的精度值；信息提示框显示操作信息；
MS003_SC_088 | 05 增强版模式 | 术前准备 | TR050115 | 机械臂在线标定引导页面-上一步/下一步 | 1、进入机械臂在线标定引导页面； 2、机械臂已标定完成； | 1、点击上一步； 2、点击下一步； | 1、返回无菌罩引导页面，进入手术工具标定页面；
MS003_SC_089 | 05 增强版模式 | 术前准备 | TR050116 | 查看手术工具标定引导页面UI | 1、进入手术工具标定引导页面； | 1、查看手术工具标定引导页面UI； | 1、显示手术工具标定及引导示意图，标定进度条；右侧显示标定器示踪器，探针示踪器；注册安放杆、注册Y型探针、注册M型探针、捕获、重置、信息提示框、上一步、下一步；
MS003_SC_090 | 05 增强版模式 | 术前准备 | TR050117、 TR050118 | 手术工具标定 | 1、进入手术工具标定引导页面； 2、标定示踪器及探针已被识别； | 1、选中注册安放杆，点击捕获； 2、选中注册Y型探针，点击捕获； 3、选中注册M型探针，点击捕获； | 1、选中，前面复选框变为⊙，显示标定进度条，标定完成，⊙变为√；信息提示框显示操作信息；
MS003_SC_091 | 05 增强版模式 | 术前准备 | TR050119 | 手术工具标定引导页面-上一步/下一步 | 1、进入手术工具标定引导页面； 2、手术工具已标定完成； | 1、点击上一步； 2、点击下一步； | 1、返回机械臂在线标定引导页面； 进入髋臼示踪器安装引导页面；
MS003_SC_092 | 05 增强版模式 | 术前准备 | TR050120 | 查看髋臼示踪器安装引导页面UI | 1、进入髋臼示踪器安装引导界面； | 1、查看髋臼示踪器安装引导页面UI； | 1、安装髋臼示踪器并植入检查钉+引导示意图；右侧显示髋臼示踪器及探针示踪器状态图；髋臼检查钉选项，捕获，重置按钮，信息提示框，上一步、下一步按钮；
MS003_SC_093 | 05 增强版模式 | 术前准备 | TR050121、 TR050122 | 安装髋臼示踪器并植入检查钉 | 1、进入髋臼示踪器安装引导界面； | 1、按照引导示意图安装髋臼示踪器及检查钉； 2、选中髋臼检查钉，点击捕获，自动对检查钉位置采集，采集完成； | 1、髋臼检查钉前复选框⊙变为√；信息框显示相应操作信息；
MS003_SC_094 | 05 增强版模式 | 术前准备 | TR050123 | 髋臼示踪器安装引导界面-上一步/下一步 | 1、进入髋臼示踪器安装引导界面； 2、已安装标定完成； | 1、点击上一步； 2、点击下一步； | 1、返回手术工具标定引导页面； 进入股骨示踪器安装引导页面；
MS003_SC_095 | 05 增强版模式 | 术前准备 | TR050124 | 查看股骨示踪器安装引导页面UI | 1、进入安装股骨示踪器并植入检查钉页面； | 1、查看股骨示踪器安装引导页面UI； | 1、左侧显示安装股骨示踪器并植入检查钉的引导示意图；右侧显示股骨示踪器和探针示踪器；股骨检查钉选项，捕获、重置、信息提示框、上一步、下一步按钮；
MS003_SC_096 | 05 增强版模式 | 术前准备 | TR050125、 TR050126 | 安装股骨示踪器并植入检查钉 | 1、进入安装股骨示踪器并植入检查钉页面； 2、股骨及探针示踪器已被识别； | 1、按照引导示意图安装股骨示踪器并植入检查钉； 2、选中股骨检查钉，点击捕获； | 1、选中变为⊙，采集完成，变为√；提示相应操作信息；
MS003_SC_097 | 05 增强版模式 | 术前准备 | TR050127 | 股骨示踪器安装引导页面-上一步/下一步 | 1、进入安装股骨示踪器并植入检查钉页面； 2、股骨示踪器已安装，检查钉已植入； 3、检查钉位置已采集完成； | 1、点击上一步； 2、点击下一步； | 1、返回髋臼示踪器安装引导页面； 进入股骨粗配准页面；
MS003_SC_098 | 05 增强版模式 | 股骨制备 | TR050201 | 查看股骨粗配准页面UI | 1、进入股骨导航页面； 2、机械臂、探针、股骨示踪器已看到； | 1、查看股骨粗配准页面UI； | 1、显示股骨粗配准特征点示意图；机械臂、探针、股骨示踪器识别状态，工具精度检查按钮，股骨特征点1、股骨特征点2、股骨特征点3，捕获按钮，重置按钮，信息提示框，上一步、下一步按钮；
MS003_SC_099 | 05 增强版模式 | 股骨制备 | TR050202、 TR050203、 TR050207 | 股骨特征点采集 | 1、进入股骨导航页面； 2、工具精度已全部检查完成； | 1、选中股骨特征点1，按图示采集点； 2、选中股骨特征点2，按图示采集点； 3、选中股骨特征点3，按图示采集点； | 1、采集完成，选中的复选框变为√；信息提示框提示相应操作信息；
MS003_SC_100 | 05 增强版模式 | 股骨制备 | TR050204、 TR050205、 TR050206、 TR050207 | 股骨特征点修改 | 1、进入股骨导航页面； 2、特征点已采集完成； | 1、点击修改，点击捕获，在股骨位置获取点； 2、点击保存； | 1、特征点修改完成，新标记点为绿色，旧标记点为蓝色；返回股骨粗配准页面；信息提示框提示相应操作信息；
MS003_SC_101 | 05 增强版模式 | 股骨制备 | TR050208 | 股骨粗配准页面UI-上一步/下一步 | 1、进入股骨导航页面； 2、特征点已采集完成； | 1、点击上一步； 2、点击下一步； | 1、返回股骨示踪器安装引导界面； 进入股骨精配准界面；
MS003_SC_102 | 05 增强版模式 | 股骨制备 | TR050209 | 查看股骨精配准页面UI | 1、已进入股骨精配准页面； | 1、查看股骨精配准页面UI； | 1、左侧显示精配准导引示意图； 左侧下方显示进度条；右上角显示基座示踪器、探针、股骨示踪器图标、工具精度检查、特征点名称列表、捕获、撤销、重置、上一步、下一步按钮；
MS003_SC_103 | 05 增强版模式 | 股骨制备 | TR050210、 TR050211、 TR050212 | 股骨精配准特征点采集 | 1、已进入股骨精配准页面； 2、工具精度已检查； | 1、选中股骨头名称，点击捕获，共采集6个点； 2、选中股骨颈10个点的名称，一一捕获； 3、选中转子间哨16个点，一一捕获； | 1、采集完成，右侧列表状态变为√；操作过程中，信息提示栏有操作信息提示；
MS003_SC_104 | 05 增强版模式 | 股骨制备 | TR050213 | 股骨精配准页面-上一步/下一步 | 1、已进入股骨精配准页面； 2、精配准特征点已采集； | 1、点击上一步； 2、点击下一步； | 1、返回股骨粗配准页面； 进入股骨配准验证界面；
MS003_SC_105 | 05 增强版模式 | 股骨制备 | TR050214 | 查看股骨配准验证页面UI | 1、已股骨配准验证页面； | 1、查看股骨配准验证页面UI； | 1、左侧显示股骨配准验证引导示意图；局部CT图，距离骨表面的距离提示框mm，左侧底部显示进度条，反映配准采集点验证进度；右上角有基座示踪器、探针示踪器、股骨示踪器的图标；工具精度检查、捕获、撤销、重置、上一步、下一步按钮，精度提示框mm；信息提示框；
MS003_SC_106 | 05 增强版模式 | 股骨制备 | TR050215、 TR050216、 TR050217 | 选中目标验证点-验证配准精度 | 1、已股骨配准验证页面； 2、工具精度已检查； | 1、根据导引示意图的上点，点击捕获； 2、使用探针选中目标验证点； 3、查看精度； | 1、1mm内蓝色，1-1.5mm配准精度是黄色，1.5mm以上显示红色；信息提示框提示相应操作信息；
MS003_SC_107 | 05 增强版模式 | 股骨制备 | TR050218 | 股骨配准验证页面-上一步/下一步 | 1、已股骨配准验证页面； 2、粗配精配已完成并验证； | 1、点击上一步； 2、点击下一步； | 1、返回股骨精配准页面； 进入股骨截骨页面；
MS003_SC_108 | 05 增强版模式 | 股骨制备 | TR050219 | 查看股骨截骨页面UI | 1、进入股骨截骨界面； | 1、查看股骨截图页面UI； | 1、显示股骨截图示意图，基座、探针、股骨示踪器图标；工具精度检查、股骨柄型号下拉菜单、信息提示栏、上一步、下一步按钮；
MS003_SC_109 | 05 增强版模式 | 股骨制备 | TR050220、 TR050221、 TR050222 | 选择匹配股骨柄型号-在病灶标记截骨线 | 1、进入股骨截骨界面； 2、工具精度已检查完成； | 1、下拉选择股骨柄型号，引导图上显示截骨线； 2、在人体病灶处标记截骨线； | 1、人体截骨线被标记；信息提示框提示操作信息；
MS003_SC_110 | 05 增强版模式 | 股骨制备 | TR050223 | 股骨截骨页面-上一步/下一步 | 1、进入股骨截骨界面； 2、已选择股骨柄型号； | 1、点击上一步； 2、点击下一步； | 1、返回股骨配准验证页面； 2、进入髓腔锉倾角计算界面；
MS003_SC_111 | 05 增强版模式 | 股骨制备 | TR050224 | 查看髓腔锉倾角计算页面UI | 1、已进入髓腔锉倾角计算界面； | 1、查看髓腔锉倾角计算界面UI； | 1、左侧显示工具安装已引导示意图，底部显示进度条；右上角显示髓腔锉倾角值，显示基座示踪器、探针、股骨示踪器图标，显示工具精度检查、捕获、重置、信息提示栏、上一步、下一步按钮；
MS003_SC_112 | 05 增强版模式 | 股骨制备 | TR050225、 TR050226、 TR050227 | 安装股骨示踪器-并用探针采集髓腔锉倾角计算标记点的数据 | 1、已进入髓腔锉倾角计算界面； 2、工具精度已检查； | 1、按照导引示意图重新安装股骨示踪器； 2、点击捕获，使用探针采集髓腔锉倾角计算标记点的数据； 3、采集完成，观察结果； | 1、系统自动计算髓腔锉倾角值；提示框提示相应的操作信息；
MS003_SC_113 | 05 增强版模式 | 股骨制备 | TR050228 | 髓腔锉倾角计算页面-上一步/下一步 | 1、已进入髓腔锉倾角计算界面； 2、髓腔锉倾角值已计算完成； | 1、点击上一步； 2、点击下一步； | 1、返回股骨截骨页面； 进入联合前倾角评估界面；
MS003_SC_114 | 05 增强版模式 | 股骨制备 | TR050229、 TR050230、 TR050231 | 查看联合前倾角评估界面UI | 1、已进入联合前倾角评估界面； 2、工具精度已检查； | 1、查看联合前倾角评估界面UI； | 1、左侧显示3D的假体组合效果图，左下角显示预期结果数值（髋长的对比对侧、对比术前、联合偏距值mm）；髓腔锉前倾角，联合前倾角，机械臂、探针、股骨示踪器状态图，工具精度检查，信息提示栏，上一步下一步按钮；
MS003_SC_115 | 05 增强版模式 | 股骨制备 | TR050232 | 联合前倾角评估界面-上一步/下一步 | 1、已进入联合前倾角评估界面； | 1、点击上一步； 2、点击下一步； | 1、返回髓腔锉倾角计算界面； 进入髋臼粗配准界面；
MS003_SC_116 | 05 增强版模式 | 髋臼制备 | TR050301 | 查看髋臼粗配准页面UI | 1、已进入髋臼粗配准页面； | 1、查看髋臼粗配准页面UI； | 1、左侧显示髋臼标记引导示意图，右侧显示基座、探针、髋臼示踪器、工具精度检查按钮；髋臼特征点1，2,3，修改、捕获、重置、上一步、下一步按钮；
MS003_SC_117 | 05 增强版模式 | 髋臼制备 | TR050302、 TR050303 | 髋臼标记点采集 | 1、已进入髋臼粗配准页面； 2、工具精度已检查完成； | 1、选中髋臼特征点1，点击捕获，按导引图位置在髋臼上点一点； 2、选中髋臼特征点2，点击捕获，髋臼上点一点； 3、选中髋臼特征点3，点击捕获，髋臼上点一点； | 1、采集完成，髋臼特征前的勾选框从未选中变为选中后的⊙，采集完成变为√；信息提示框显示操作信息；
MS003_SC_118 | 05 增强版模式 | 髋臼制备 | TR050304、 TR050305、 TR050306、 TR050307 | 髋臼标记点修改 | 1、已进入髋臼粗配准页面； 2、髋臼标记点已采集完成； | 1、点击修改；根据左侧标记点修改引导示意图； 2、点击捕获，添加新的标记点； 3、点击保存； | 1、髋臼标记点后点修改变为取消和保存，蓝色表示旧标记点，绿色表示新标记点；信息提示框显示操作信息；
MS003_SC_119 | 05 增强版模式 | 髋臼制备 | TR050308 | 髋臼粗配准页面-上一步/下一步 | 1、已进入髋臼粗配准页面； 2、髋臼标记点已采集完成； | 1、点击上一步； 2、点击下一步； | 1、返回联合前倾角评估界面； 2、进入髋臼精配准界面；
MS003_SC_120 | 05 增强版模式 | 髋臼制备 | TR050309 | 查看髋臼精配准页面UI | 1、已进入髋臼精配准页面； | 1、查看髋臼精配准页面UI； | 1、左侧显示髋臼精配准示意图，下方显示采集进度条；待采集个数，基座、探针、髋臼示踪器图标，工具精度检查按钮，“髋臼关节面”、“髋臼后角”、“髋臼前切迹”、“髋臼外侧面”选项及需要采集个数；捕获、撤销、重置、配准精度显示框、上一步、下一步按钮；
MS003_SC_121 | 05 增强版模式 | 髋臼制备 | TR050310、 TR050311、 TR050312 | 髋臼配准点采集 | 1、已进入髋臼精配准页面； 2、工具精度已检查； | 1、选中“髋臼关节面”，点击捕获添加多个采集点； 2、选中“髋臼后角”，点击捕获添加多个采集点； 3、选中“髋臼前切迹”，点击捕获添加多个采集点； 4、选中“髋臼外侧面”点击捕获添加多个采集点； | 1、采集完成，选项前更新为√，自动计算配准精度并显示；信息提示框提示操作信息；
MS003_SC_122 | 05 增强版模式 | 髋臼制备 | TR050313 | 髋臼精配准页面-上一步/下一步 | 1、已进入髋臼精配准页面； 2、髋臼配准点已采集完成； | 1、点击上一步； 2、点击下一步； | 1、返回髋臼粗配准界面； 进入髋臼配准确认界面；
MS003_SC_123 | 05 增强版模式 | 髋臼制备 | TR050314 | 查看髋臼配准确认界面UI | 1、已进入髋臼配准确认界面； | 1、查看髋臼配准确认界面UI； | 1、左侧为配准确认操作引导示意图；右上角显示局部CT图、距离骨表面的距离mm，基座、探针、髋臼示踪器识别状态，工具精度检查，捕获、撤销、重置、精度值mm；
MS003_SC_124 | 05 增强版模式 | 髋臼制备 | TR050315、 TR050316、 TR050317 | 根据示意图-探针选中目标验证点-验证精配准 | 1、已进入髋臼配准确认界面； 2、工具精度已检查； | 1、点击捕获； 2、使用探针按验证点选取示意图依次选验证点； 3、采集完成； | 1、精度提示框显示精度值，1mm绿色，1-1.5mm黄色，1.5mm以上红色；信息提示栏显示操作信息；
MS003_SC_125 | 05 增强版模式 | 髋臼制备 | TR050318 | 髋臼配准确认界面-上一步/下一步 | 1、已进入髋臼配准确认界面； 2、验证点已采集完成； | 1、点击上一步； 2、点击下一步； | 1、返回髋臼精配准界面； 2、进入机械臂台车摆位引导界面；
MS003_SC_126 | 05 增强版模式 | 髋臼制备 | TR050319 | 查看机械臂台车摆位页面UI | 1、已进入机械臂台车摆位页面； | 1、查看机械臂台车摆位页面UI； | 1、摆位引导示意图、基座、探针、髋臼示踪器，工具精度检查，上一步，下一步按钮；
MS003_SC_127 | 05 增强版模式 | 髋臼制备 | TR050320、 TR050321、 TR050322 | 根据机械臂台车摆放示意图摆放机械臂台车 | 1、已进入机械臂台车摆位页面； 2、工具精度已检查； | 1、根据根据机械臂台车摆放示意图摆放机械臂台车； | 1、可以根据引导页摆放台车； 信息提示框提示操作信息；
MS003_SC_128 | 05 增强版模式 | 髋臼制备 | TR050323 | 机械臂台车摆位页面-上一步/下一步 | 1、已进入机械臂台车摆位页面； | 1、点击上一步； 2、点击下一步； | 1、返回髋臼配准确认界面； 2、进入磨锉前准备界面；
MS003_SC_129 | 05 增强版模式 | 髋臼制备 | TR050324 | 查看磨锉前准备界面UI | 1、已进入磨锉前准备界面UI； | 1、查看磨锉前准备界面UI； | 1、左侧显示磨锉前准备的引导示意图，包括执行台车刹车提示图、髋臼检查钉提示图、操作杆检查点提示图，右上角有基座、探针、髋臼示踪器，工具精度检查按钮，磨锉杆型号、髋臼锉型号，髋臼检查点及精度显示框，操作杆检查点及精度显示框，mm，捕获、重置,上一步、下一步；
MS003_SC_130 | 05 增强版模式 | 髋臼制备 | TR050325、 TR050326、 TR050327 | 磨锉检查点采集 | 1、已进入磨锉前准备界面UI； 2、工具精度已检查； | 1、执行台车先刹车； 2、选择磨锉杆型号，选择髋臼锉型号； 3、点击捕获，根据示意图点击髋臼检查点，点击捕获，点击操作杆检查点； 4、检查点击采集完成； | 1、检查点状态变为√，信息提示栏显示操作信息；
MS003_SC_131 | 05 增强版模式 | 髋臼制备 | TR050328 | 磨锉前准备界面-上一步/下一步 | 1、已进入磨锉前准备界面UI； 2、检查点已采集； | 1、点击上一步； 2、点击下一步； | 1、返回机械臂台车摆位引导界面； 2、进入髋臼磨锉界面；
MS003_SC_132 | 05 增强版模式 | 髋臼制备 | TR050329 | 查看髋臼磨锉界面UI | 1、已进入髋臼磨锉界面； | 1、查看髋臼磨锉界面； | 1、磨锉示意图（3D髋臼模型图、磨锉杆线框示意图），左上角有髋臼钻电源、虚拟边界指示图标、深度保护指示图标；左下角显示脚撑状态，右上角有剩余磨锉距离（内侧、后侧、上侧）mm，右下角有臼杯前倾角和外展角，°；基座、髋臼示踪器状态，工具精度检查，髋臼锉当前和规划型号，当前型号有下拉菜单；有智能磨锉、自由磨锉、上一步、下一步按钮；
MS003_SC_133 | 05 增强版模式 | 髋臼制备 | TR050330、 TR050331 | 髋臼锉智能磨锉髋臼 | 1、已进入髋臼磨锉界面； 2、工具精度已检查； | 1、点击当前髋臼锉型号，选择； 2、点击智能磨锉； 3、踩下右脚踏，拖动机械臂往规划位置移动； 4、移动到虚拟边界保护与深度保护均开启，髋臼锉进入一级安全区后，髋臼钻电源自动开启，离开一级安全区，髋臼钻电源自动切断； | 1、可以正常磨锉完成规划部分；
MS003_SC_134 | 05 增强版模式 | 髋臼制备 | TR050332、 TR050333、 TR050334 | 髋臼锉自由磨锉髋臼 | 1、已进入髋臼磨锉界面； 2、工具精度已检查； | 1、点击当前髋臼锉型号，选择； 2、点击自由磨锉； 3、踩下右脚踏，拖动机械臂往规划位置移动； | 1、弹框提示“自由磨锉具有较大操作风险，请谨慎使用”，可磨锉完成，无虚拟边界保护与深度保护均开启；信息提示栏提示操作信息；
MS003_SC_135 | 05 增强版模式 | 髋臼制备 | TR050335 | 髋臼磨锉界面-上一步/下一步 | 1、已进入髋臼磨锉界面； 2、髋臼磨锉完成； | 1、点击上一步； 2、点击下一步； | 1、返回髋臼前准备界面； 2、进入臼杯安放前准备界面；
MS003_SC_136 | 05 增强版模式 | 髋臼制备 | TR050336 | 查看臼杯安放前准备界面UI | 1、已进入臼杯安放前准备页面； | 1、查看臼杯安放前准备界面UI； | 1、安放杆示踪器安装检查提示图、安放杆检查点提示图，基座、探针、髋臼、安放杆示踪器状态图标；工具精度检查按钮，安放杆型号和臼杯型号下拉菜单；有髋臼检查点，安放杆检查点选项，捕获、重置、上一步、下一步按钮；髋臼检查点、安放杆精度检查点精度显示框；
MS003_SC_137 | 05 增强版模式 | 髋臼制备 | TR050337、 TR050338、 TR050339 | 髋臼、安放杆检查点采集-查看精度 | 1、已进入臼杯安放前准备页面； 2、工具精度已检查； | 1、选中安放杆的型号及臼杯型号； 2、选中髋臼检查点，点击捕获，按照图示在髋臼点点； 3、选中安放杆检查点，点击捕获，按照图示在安放杆上点点； 4、采集完成； | 1、目标选项状态由未选中变为⊙，再变为√，精度值自动更新；信息提示栏显示操作信息；
MS003_SC_138 | 05 增强版模式 | 髋臼制备 | TR050340 | 臼杯安放前准备界面-上一步/下一步 | 1、已进入臼杯安放前准备页面； 2、髋臼、安放杆点采集完成； | 1、点击上一步； 2、点击下一步； | 1、返回髋臼磨锉界面； 2、进入臼杯安放界面；
MS003_SC_139 | 05 增强版模式 | 髋臼制备 | TR050341 | 查看臼杯安放页面UI | 1、已进入臼杯安放页面UI； | 1、查看臼杯安放页面UI； | 1、左侧显示臼杯安放示意图（3D髋臼模型图、臼杯模型图及敲击锤敲击示意图），左上角有敲击指示图标、轴向保护提示图标、教程状态提示图标、右上角有剩余敲击距离显示框，显示剩余距离值，mm；右下角显示臼杯前倾角角度、外展角角度的当前值和规划值，°；右上角有基座、安放杆、髋臼示踪器；工具精度检查按钮；当前臼杯型号和规划臼杯型号，当前臼杯型号有下拉菜单，自由拖动，智能定位按钮，上一步，下一步按钮；
MS003_SC_140 | 05 增强版模式 | 髋臼制备 | TR050342、 TR050343、 TR050345、 TR050346 | 臼杯进行安放 | 1、已进入臼杯安放页面UI； 2、工具精度已检查； | 1、选择当前臼杯型号； 2、点击智能定位，踩右脚踏； 3、拖动机械臂往规划位置移动； 4、移动到位，按照引导图示使用敲击锤敲击； | 1、臼杯安放完成；角度和敲击距离更新；信息提示框提示操作信息；
MS003_SC_141 | 05 增强版模式 | 髋臼制备 | TR050344 | 机械臂自由拖动 | 1、已进入臼杯安放页面UI； | 1、踩左脚踏，拖动机械臂； | 1、0力拖动；
MS003_SC_142 | 05 增强版模式 | 髋臼制备 | TR050347 | 臼杯安放页面-上一步，下一步 | 1、已进入臼杯安放页面UI； 2、臼杯安放完成； | 1、点击上一步； 2、点击下一步； | 1、返回臼杯安放前准备界面 2、进入臼杯角度验证界面
MS003_SC_143 | 05 增强版模式 | 手术结果 | TR050401 | 查看臼杯角度验证界面UI | 1、已进入臼杯角度验证界面； | 1、查看臼杯角度验证界面UI； | 1、左侧显示臼杯特征点采集的引导示意图，下方显示进度条，臼杯前倾角的当前值和规划值，臼杯外展角的当前值和规划值；右侧显示基座、探针、髋臼示踪器，工具精度检查按钮，臼杯特征点选项，捕获，重置，信息提示框，上一步，下一步按钮；
MS003_SC_144 | 05 增强版模式 | 手术结果 | TR050402、 TR050403、 TR050404 | 采集髋臼特征点验证 | 1、已进入臼杯角度验证界面； 2、基座、探针、髋臼示踪器已被识别； | 1、点击工具精度检查； 2、工具精度检查完成； 3、选中臼杯特征点，使用探针进行特征点采集； 4、点击捕获，按照引导示意图选点，采集完成； | 1、臼杯特征点的勾选项变为√，臼杯的前倾角和外展角的值更新；信息提示框提示操作信息；
MS003_SC_145 | 05 增强版模式 | 手术结果 | TR050405 | 臼杯角度验证界面-上一步/下一步 | 1、已进入臼杯角度验证界面； | 1、点击上一步； 2、点击下一步； | 1、返回臼杯安放页面； 2、进入复位后验证页面；
MS003_SC_146 | 05 增强版模式 | 手术结果 | TR050406 | 查看复位后验证界面UI | 1、已进入复位后验证界面； | 1、查看复位后验证界面UI； | 1、左侧显示假体复位后的3D示意图，左下角显示对比对侧和对比术前的髋长和联合偏距值mm，右下角显示复位后臼杯前倾角，外展角，股骨柄倾角和联合前倾角，°；右上角有基座、探针、髋臼、股骨示踪器状态图标，工具精度检查按钮，右侧显示假体品牌、臼杯型号、规格，衬垫型号，股骨头的型号、规格、长度，股骨柄的型号、规格、颈干角；捕获按钮，信息提示栏，上一步，下一步按钮；
MS003_SC_147 | 05 增强版模式 | 手术结果 | TR050407、 TR050408、 TR050409 | 基座、探针、髋臼、股骨示踪器已识别-捕获-查看复位结果及数值 | 1、已进入复位后验证界面； 2、示踪器均已识别； | 1、点击工具精度检查，检查完成； 2、点击捕获； | 1、复位后的髋长和联合偏距值；臼杯前倾角、外展角，股骨柄倾角及联合前倾角；提示相应的操作信息；
MS003_SC_148 | 05 增强版模式 | 手术结果 | TR050410 | 复位后验证界面-上一步/下一步 | 1、已进入复位后验证界面； | 1、点击上一步； 2、点击下一步； | 1、返回臼杯角度验证界面； 2、进入手术记录界面；
MS003_SC_149 | 05 增强版模式 | 手术结果 | TR050411 | 查看手术记录页面UI | 1、已进入手术记录页面UI； 2、已有30张术中截图； | 1、查看手术记录页面UI； | 1、左侧显示术中截图信息，右侧显示滚动条，手术回放按钮、手术报告按钮，信息提示栏，上一步、完成按钮；
MS003_SC_150 | 05 增强版模式 | 手术结果 | TR050412 | 手术回放 | 1、已进入手术记录页面UI； 2、手术已完成； | 1、点击手术回放； | 1、回放整个手术过程；
MS003_SC_151 | 05 增强版模式 | 手术结果 | TR050413、 TR050414、 TR050415 | 查看手术报告-并导出报告 | 1、已进入手术记录页面UI； 2、手术已完成； | 1、点击手术报告，查看手术报告内容； 2、点击导出报告； | 1、显示手术报告，患者姓名、患者性别、年龄、病历号，手术时间，软件流程，手术入路，手术侧，手术方案（假体品牌，臼杯股骨柄，股骨头，衬垫），手术结果（假体品牌、臼杯、股骨柄、股骨头、衬垫类型、型号），导出报告按钮；
MS003_SC_152 | 05 增强版模式 | 手术结果 | TR050416 | 手术记录页面-上一步/完成 | 1、已进入手术记录页面UI； 2、手术已完成； | 1、点击上一步； 2、点击完成，弹框，点击确认； | 1、返回复位后验证界面； 2、点完成，弹框提示“手术已经完成，请选择注销账户或退出系统”，点击确认，有注销账户、退出系统、取消操作可以执行；
MS003_SC_153 | 06 快速版模式 | 术前准备 | TR060101 | 查看股骨远端标记物放置UI | 1、进入股骨远端标记物放置页面； | 1、查看股骨远端标记物放置UI； | 1、左侧显示股骨远端标记物放置引导示意图，右侧有信息提示栏，上一步，下一步按钮；
MS003_SC_154 | 06 快速版模式 | 术前准备 | TR060102、 TR060103 | 放置股骨远端标记物-查看提示 | 1、进入股骨远端标记物放置页面； | 1、按照左侧引导示意图； 2、放置股骨远端标记物； | 1、可以放置完成，信息提示框有提示；
MS003_SC_155 | 06 快速版模式 | 术前准备 | TR060104 | 股骨远端标记物放置-上一步/下一步 | 1、进入股骨远端标记物放置页面； | 1、点击上一步； 2、点击下一步； | 1、返回手术工具标定页面； 进入髋臼示踪器安装引导页面；
MS003_SC_156 | 06 快速版模式 | 术前准备 | TR060105 | 安装髋臼示踪器并植入检查钉 | 1、进入髋臼示踪器安装引导界面； | 1、按照引导示意图安装髋臼示踪器及检查钉； 2、选中髋臼检查钉，点击捕获，自动对检查钉位置采集，采集完成； | 1、髋臼检查钉前复选框⊙变为√；信息框显示相应操作信息；
MS003_SC_157 | 06 快速版模式 | 术前准备 | TR060106 | 查看标记钉植入、捕获引导界面UI | 1、进入标记钉植入、捕获引导界面； | 1、查看标记钉植入、捕获引导界面UI； | 1、左侧显示标记钉植入、捕获引导示意图；右上角有基座、髋臼、探针示踪器图标，工具检查按钮，近端检查点、远端检查点、捕获、重置、上一步、下一步按钮；
MS003_SC_158 | 06 快速版模式 | 术前准备 | TR060107、 TR060108、 TR060109 | 植入标记钉-并进行检查点采集-查看提示 | 1、进入标记钉植入、捕获引导界面； | 1、点击工具精度检查，检查精度达到要求， 并按照左侧引导页面，植入标记钉； 2、选中近端检查点，点击捕获，采集检查点； 3、选中远端检查点，点击捕获，采集检查点； 4、采集完成，查看信息提示； | 1、检查点采集完成，信息提示框有提示信息；
MS003_SC_159 | 06 快速版模式 | 术前准备 | TR060110 | 标记钉植入、捕获引导界面-上一步/下一步 | 1、进入标记钉植入、捕获引导界面； 2、采集点已标记完成； | 1、点击上一步，点击下一步； | 1、返回髋臼示踪器安装引导页面； 进入髋臼粗配准页面；
MS003_SC_160 | 06 快速版模式 | 髋臼制备 | TR060201 | 髋臼制备 | 1、进入髋臼粗配准页面; | 1、查看MS003_SC_143~MS003_SC_189测试用例； 2、技术需求编号同TR050301至TR050347； | 1、同MS003_SC_143~MS003_SC_189用例结果；
MS003_SC_161 | 06 快速版模式 | 手术结果 | TR060301 | 臼杯角度验证 | / | 1、查看MS003_SC_190~MS003_SC_194测试用例； 2、技术需求编号同TR050401至TR050405； | 1、同MS003_SC_190~MS003_SC_194用例结果；
MS003_SC_162 | 06 快速版模式 | 手术结果 | TR060302 | 查看股骨位置检测页面UI | 1、进入股骨位置检测页面； | 1、查看股骨位置检测页面UI； | 1、左面显示近端检查点，远端检查点位置示意图，右侧有基座、髋臼、探针示踪器状态图，工具精度检查按钮，近端检查点，远端检查点选项，捕获，重置，信息提示栏，上一步，下一步按钮；
MS003_SC_163 | 06 快速版模式 | 手术结果 | TR060303、 TR060304、 TR060305 | 近端、远端检查点采集-查看提示 | 1、进入股骨位置检测页面； | 1、点击工具精度检查，精度满足要求后； 2、选中近端检查点，点击捕获，按照引导示意图，采集近端检查点； 3、选中远端检查点，点击捕获，采集远端检查点； 4、采集完成，查看提示； | 1、检查点按照图示可以采集完成，信息提示栏显示操作信息；
MS003_SC_164 | 06 快速版模式 | 手术结果 | TR060306 | 股骨位置检测页面-上一步/下一步 | 1、进入股骨位置检测页面； 2、检查点已采集完成； | 1、点击上一步； 2、点击下一步； | 1、返回臼杯角度验证页面； 进入复位后验证页面；
MS003_SC_165 | 06 快速版模式 | 手术结果 | TR060307 | 复位验证 | / | 1、查看MS003_SC_195~MS003_SC_199测试用例； 2、技术需求编号同TR050406至TR050410； | 1、同MS003_SC_195~MS003_SC_199用例结果；
MS003_SC_166 | 06 快速版模式 | 手术结果 | TR060308 | 手术记录 | / | 1、查看MS003_SC_200~MS003_SC_203测试用例； 2、技术需求编号同TR050411至TR050416； | 1、同MS003_SC_200~MS003_SC_203用例结果；
MS003_SC_167 | 07 机械臂控制 | 机械臂控制 | TR070101 | 查看机械臂控制页面UI | 1、进入机械臂控制页面； | 1、进入机械臂控制页面查看UI； | 1、显示机械臂姿态渲染窗口，姿态控制，运动控制，状态控制，零位检验，刹车检验，在线标定及×按钮；
MS003_SC_168 | 07 机械臂控制 | 机械臂控制 | TR070102 | 机械臂零位检验，刹车检验 | 1、进入机械臂控制页面； | 1、点击零位检验按钮； 2、点击刹车检验； 3、点击在线标定； | 1、窗口显示零位检验操作示意图，下方有进度条，完成后窗口恢复显示机械臂当前姿态，零位检验变为已检验状态； 刹车检验变为已检验状态，在线标定变为已检验状态；
MS003_SC_169 | 07 机械臂控制 | 机械臂控制 | TR070103、 TR070104 | 机械臂关节数据调整 | 1、进入机械臂控制页面； | 1、后台配置机械臂速度； 2、通过页面按钮调整机械臂关节角数据及姿态数据； | 1、机械臂关节及姿态事实变化；机械臂默认速度50%；
 | 07 机械臂控制 | 机械臂控制 | TR070105 | 机械臂运动到初始位置 | 1、进入机械臂控制页面； | 1、移动机械臂到其他位置； 2、左键点击初始位按钮； 3、松开按钮，继续按初始位按钮； | 1、按下按钮，机械臂运动到初始位，松开按钮机械臂停止；
MS003_SC_170 | 07 机械臂控制 | 机械臂控制 | TR070106 | 机械臂连接断开重启、关机、解除停机测试 | 1、进入机械臂控制页面； 2、机械臂已连接； | 1、点击机械臂断开按钮； 2、点击机械臂连接按钮； 3、点击机械臂重启按钮； 4、点击关机，点关机； 5、机械臂运动到异常姿态，点击解除停机； | 1、机械臂先断开后连接，最后重启； 机械臂关机，机械臂恢复到可以正常运行的状态；
MS003_SC_171 | 07 机械臂控制 | 机械臂控制 | TR070107 | 关闭机械臂控制页面 | 1、进入机械臂控制页面； | 1、点击×按钮； | 1、机械臂控制页面关闭；
MS003_SC_172 | 08 状态显示 | 设备连接状态 | TR080101、 TR080102 | 机械臂、双目相机连接状态 | / | 1、机械臂已连接，查看机械臂主控机的连接状态， 2、相机已连接，查看双目县级的联机状态； | 1、已连接，状态显示绿色；
MS003_SC_173 | 08 状态显示 | 识别状态 | TR080201、 TR080301 | 示踪器识别状态、当前工作模块显示 | / | 1、示踪器已识别，查看示踪器的识别状态； 2、操作软件流程，观察当前页面所在当前的工作环节； | 1、基座示踪器、探针示踪器、髋臼示踪器、股骨示踪器、标定器示踪器已识别，显示绿色； 显示当前工作环节；
MS003_SC_174 | 09 设置 | 设置界面 | TR090101 | 查看设置页面UI | 1、进入设置页面； | 1、查看设置页面UI； | 1、显示用户偏好设置、网络设置、系统设置、日志导出，×按钮；
MS003_SC_175 | 09 设置 | 用户偏好设置 | TR090201、 TR090202、 TR090203、 TR090204 | 用户偏好设置-手术设置、假体设置、规划设置 | 1、进入设置页面； | 1、点击用户偏好设置，点击手术设置，选择软件流程，选择手术入路方式，选择操作杆类型，点击设为默认； 2、点击假体设置，选择假体品牌，臼杯型号，内衬型号，股骨柄型号； 3、点击规划设置，设定臼杯规划的前倾角、外展角；设定股骨柄规划的前倾角； | 1、设置完成，并生效；
MS003_SC_176 | 09 设置 | 网络设置 | TR090301 | 网络设置 | 1、进入设置页面； | 1、点击网络设置，设置当前主机的IP、、端口号； | 1、设置完成，通信成功；
MS003_SC_177 | 09 设置 | 系统设置 | TR090401 | 医院名称设置、屏保时间设置 | 1、进入设置页面； | 1、点击医院名称设置，输入医院名称，选择屏保时间； | 1、设置完成，参数生效；
MS003_SC_178 | 09 设置 | 日志导出 | TR090501 | 导出日志 | 1、进入设置页面； | 1、插入U盘，点击日志导出，选择日志，点击导出； 2、双击日志打开； | 1、提示导出完成，U盘内有导出日志，内容完整；日志被打成压缩包并加密处理；
MS003_SC_179 | 10 工具精度检查 | 工具检查主界面 | TR100101 | 查看工具精度检查页面UI | 1、进入工具精度检查页面； | 1、查看工具精度检查页面UI； | 1、显示髋臼示踪器、股骨示踪器、探针、磨挫杆、打入杆选项栏及精度值；文本框提示内容，有捕获按钮；
MS003_SC_180 | 10 工具精度检查 | 髋臼示踪器检查 | TR100201 | 髋臼示踪器精度检查 | 1、进入工具精度检查页面； | 1、点击髋臼示踪器，按照示意图将探针放到对应位置，点击捕获； | 1、精度值显示；
MS003_SC_181 | 10 工具精度检查 | 股骨示踪器检查 | TR100301 | 股骨示踪器精度检查 | 1、进入工具精度检查页面； | 1、点击股骨示踪器，按照示意图将探针放到对应位置，点击捕获； | 1、精度值显示；
MS003_SC_182 | 10 工具精度检查 | 探针检查 | TR100401 | 探针示踪器精度检查 | 1、进入工具精度检查页面； | 1、点击探针示踪器，按照示意图将探针放到对应位置，点击捕获； | 1、精度值显示；
MS003_SC_183 | 10 工具精度检查 | 磨锉杆检查 | TR100501 | 磨挫杆精度检查 | 1、进入工具精度检查页面； | 1、点击磨挫杆，按照示意图将探针放到对应位置，点击捕获； | 1、精度值显示；
MS003_SC_184 | 10 工具精度检查 | 打入杆检查 | TR100601 | 打入杆精度检查 | 1、进入工具精度检查页面； | 1、点击打入杆，按照示意图将探针放到对应位置，点击捕获； | 1、精度值显示；
MS003_SC_185 | 11 日志和数据管理 | 生成 | TR110101、 TR110102、 TR110103 | 软件运行几天后-查看生成的日志记录内容 | / | 1、系统运行3天，分别进行开机、登陆、新建病例、导入CT、CT绑定、CT预处理、分割、关键特征点标记、规划、点云采集、开始配准运算、配准确认、验证评估、导入患者规划数据，导出患者规划数据、操作机械臂、关闭系统； | 1、日志记录以下信息 系统开机时间。 系统运行状态，错误信息。 双目相机连接状态的记录。 记录登陆的账号。 新建病例的姓名、ID、手术类型、手术模式。 导入CT的记录。 CT绑定的记录。 进入CT预处理、分割的记录。 进入关键特征点标记的记录。 进行规划的关键操作记录，如髋臼规划、股骨规划等。 配准过程的关键操作记录，如开始点云采集、开始配准运算、配准确认等。 验证评估的记录。 完成手术的记录。 导入患者规划数据，导出患者规划数据的记录。 操作机械臂的记录（自由拖动、自动定位、连接、断开连接、开机、重启等）。 关闭系统的记录。 上述步骤中所有报警、错误信息的记录； 每天对应一个日志，共3个日志文件，日志文件以年月日命名，日志名称的时间正确；
MS003_SC_186 | 11 日志和数据管理 | 存储 | TR110201、 TR110202 | 日志与患者数据存储在固定位置 | / | 1、进行软件主流程操作； 2、查看日志及数据存储位置； | 1、日志与患者数据存储在固定位置；
MS003_SC_187 | 11 日志和数据管理 | 导出 | TR110301 | 导出患者规划数据-导出日志 | / | 1、导出患者规划数据； 2、导出日志； | 1、导出内容被压缩加密，数据解压查看内容完整正确；
MS003_SC_188 | 11 日志和数据管理 | 导入 | TR110401 | 导入患者规划数据 | / | 1、导入患者规划数据，进行后续操作； | 1、数据导入后正确，可以进行后续操作；
MS003_SC_189 | 11 日志和数据管理 | 截图 | TR110501 | 截图-查看截图保存位置 | / | 1、点击截图； 2、查看数据保存位置； | 1、图像保存在特定文件夹中；
MS003_SC_190 | 12 导航系统管理 | 双目相机状态管理 | TR120101、 TR120102 | 查看双目相机管理页面UI | 1、进入双目相机管理页面； | 1、查看双目相机管理页面UI； | 1、界面有两个双目相机的工作范围视图，分别是Z轴视图和Y轴视图；显示所有示踪器x,y,z轴的误差；
MS003_SC_191 | 13 控制软件其他需求 | 页面管理 | TR130101 | 页面跳转可以保存数据 | / | 1、软件流程每一步点击上一步下一步； 2、查看数据是否保存； | 1、数据被保存；
MS003_SC_192 | 13 控制软件其他需求 | 页面管理 | TR130102 | 用户无法进入后台操作系统 | / | 1、用户按键盘任意键或组合键； | 1、无法进入后台操作系统；
MS003_SC_193 | 13 控制软件其他需求 | 脚踏控制 | TR130201 | 系统采用双脚踏 | / | 1、查看系统脚踏设计方式； | 1、分左右两个脚踏；左脚踏为自由拖动脚踏，右脚踏为特定功能脚踏；
MS003_SC_194 | 13 控制软件其他需求 | 脚踏控制 | TR130202 | 左脚踏控制机械臂自由拖动 | / | 1、踩左脚踏，手动拖动机械臂； | 1、可以自由拖动机械臂；
MS003_SC_195 | 13 控制软件其他需求 | 脚踏控制 | TR130203 | 配准UI下-采集特征点-踩右脚踏 | / | 1、配准页面；采集特征点后，踩右脚踏； | 1、可对采集的特征点进行确认；
MS003_SC_196 | 13 控制软件其他需求 | 脚踏控制 | TR130204 | 弹窗UI下-踩右脚踏弹框消失 | / | 1、任意弹框下，踩右脚踏； | 1、所有弹框下，踩右脚踏，弹框自动关闭；
MS003_SC_197 | 13 控制软件其他需求 | 脚踏控制 | TR130205 | 髋臼磨锉UI下-按钮显示智能磨锉时-踩右脚踏-进入机械臂的智能磨锉模式 | / | 1、进入髋臼磨锉页面； 2、按钮显示智能磨锉，踩右脚踏； | 1、进入机械臂智能磨锉模式；
MS003_SC_198 | 13 控制软件其他需求 | 脚踏控制 | TR130206 | 髋臼磨锉UI下-按钮显示自由磨锉时-踩右脚踏-进入机械臂的自由磨锉模式 | / | 1、进入髋臼磨锉页面； 2、按钮显示自由磨锉，踩右脚踏； | 1、进入机械臂自由磨锉模式；
MS003_SC_199 | 13 控制软件其他需求 | 脚踏控制 | TR130207 | 臼杯安放UI下-踩住右脚踏-进入机械臂的智能定位模式 | / | 1、进入臼杯安放页面； 2、踩右脚踏； | 1、进入机械臂智能定位模式；
MS003_SC_200 | 13 控制软件其他需求 | 特殊流程跳转 | TR130301 | 需求需要完善
MS003_SC_201 | 13 控制软件其他需求 | 特殊流程跳转 | TR130302 | 需求需要完善
MS003_SC_202 | 13 控制软件其他需求 | 界面风格 | TR130401 | 深色和蓝色皮肤切换 | / | 1、查看默认皮肤，深色模式与蓝色模式切换； | 1、显示默认皮肤，深色皮肤，所有页面都显示深色样式，蓝色皮肤，所有页面切换到蓝色皮肤，皮肤切换后，软件所有操作正常流畅；

Sheet: 其他
MS-003系统测试用例
用例编号 | 一级模块 | 二级模块 | 技术需求编号 | 用例名称 | 前提条件 | 操作步骤 | 预期结果
MS003_SC_OT_001 | 安装卸载 | / | / | 软件首次安装 | / | 1、软件首次安装； | 1、安装完成，可以启动；
MS003_SC_OT_002 | 安装卸载 | / | / | 软件重复安装 | 1、软件已安装； | 1、再次安装软件； | 1、安装失败，提示已安装；
MS003_SC_OT_003 | 安装卸载 | / | / | 软件已安装-同版本软件升级 | 1、软件已安装； 2、本地历史数据已存在； | 1、升级到同一个版本软件安装包； | 1、安装成功，历史数据完好可以使用；
MS003_SC_OT_004 | 安装卸载 | / | / | 软件已安装-不同版本软件升级 | 1、软件已安装； 2、本地历史数据已存在； | 1、升级到更高版本； | 1、安装完成，历史数据完好可以使用；
MS003_SC_OT_005 | 安装卸载 | / | / | 软件未运行-软件从控制面板卸载 | / | 1、软件未运行； 2、从控制面板卸载软件； | 1、可以卸载完成，无残留数据；
MS003_SC_OT_006 | 安装卸载 | / | / | 软件正运行-软件从控制面板卸载 | / | 1、软件正常运行； 2、从控制面板卸载软件； | 1、可以卸载完成；
MS003_SC_OT_007 | 安装卸载 | / | / | 查看软件安装卸载页面UI-中文，可读性强 | / | 1、一步一步安装，检查每个页面的UI； | 1、UI页面内容可读性强，中文显示；
MS003_SC_OT_008 | 性能测试 | / | / | 软件正常操作流程连续运行72小时 | / | 1、开机，软件启动，正常使用72小时； | 1、软件操作流畅，不卡顿，不死机，内存占用正常；
MS003_SC_OT_009 | 性能测试 | / | / | 软件未进行任何操作-连续运行72小时 | / | 1、开机，软件启动，软件未进行任何操作； 2、运行72小时； | 1、软件操作流畅，不卡顿，不死机，内存占用正常；
MS003_SC_OT_010 | 性能测试 | / | PR0501、 PR0502、 PR0503、 PR0504、 PR0505 | windows系统下-运行稳定，功能正常 | 1、操作系统：win10； 2、系统配置： 内存容量≥16GB 硬盘容量≥1TB CPU主频≥3.6GHz GPU内存≥8GB 显存频率≥14Gbps | 1、操作软件各个模块； | 1、功能可以正常使用，运行流程，页面清晰；
