santan444/MS003/03-设计开发输出阶段/02电子/05物料证书/22.分线器/CCC.jpg

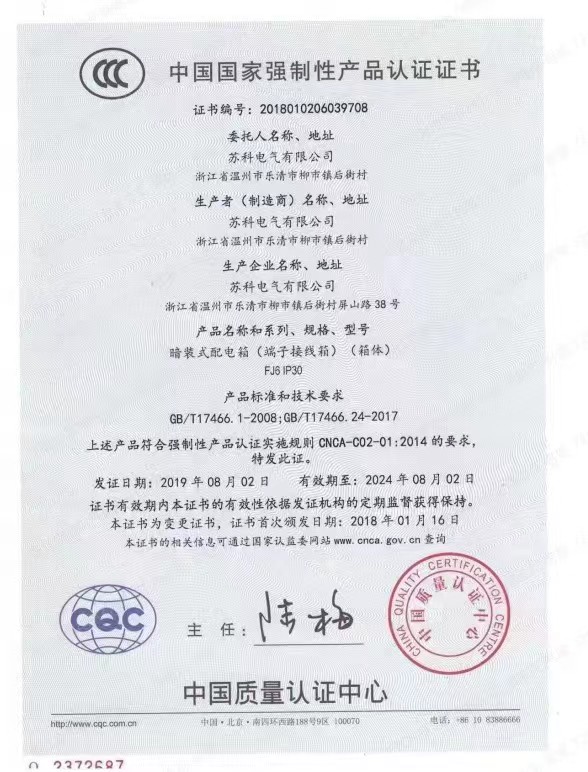
03-设计开发输出阶段/02电子/05物料证书/22.分线器/CCC.jpg
