santan444/MS003/03-设计开发输出阶段/02电子/05物料证书/23HDMI分屏器/TcSgejkk7WAO.jpg

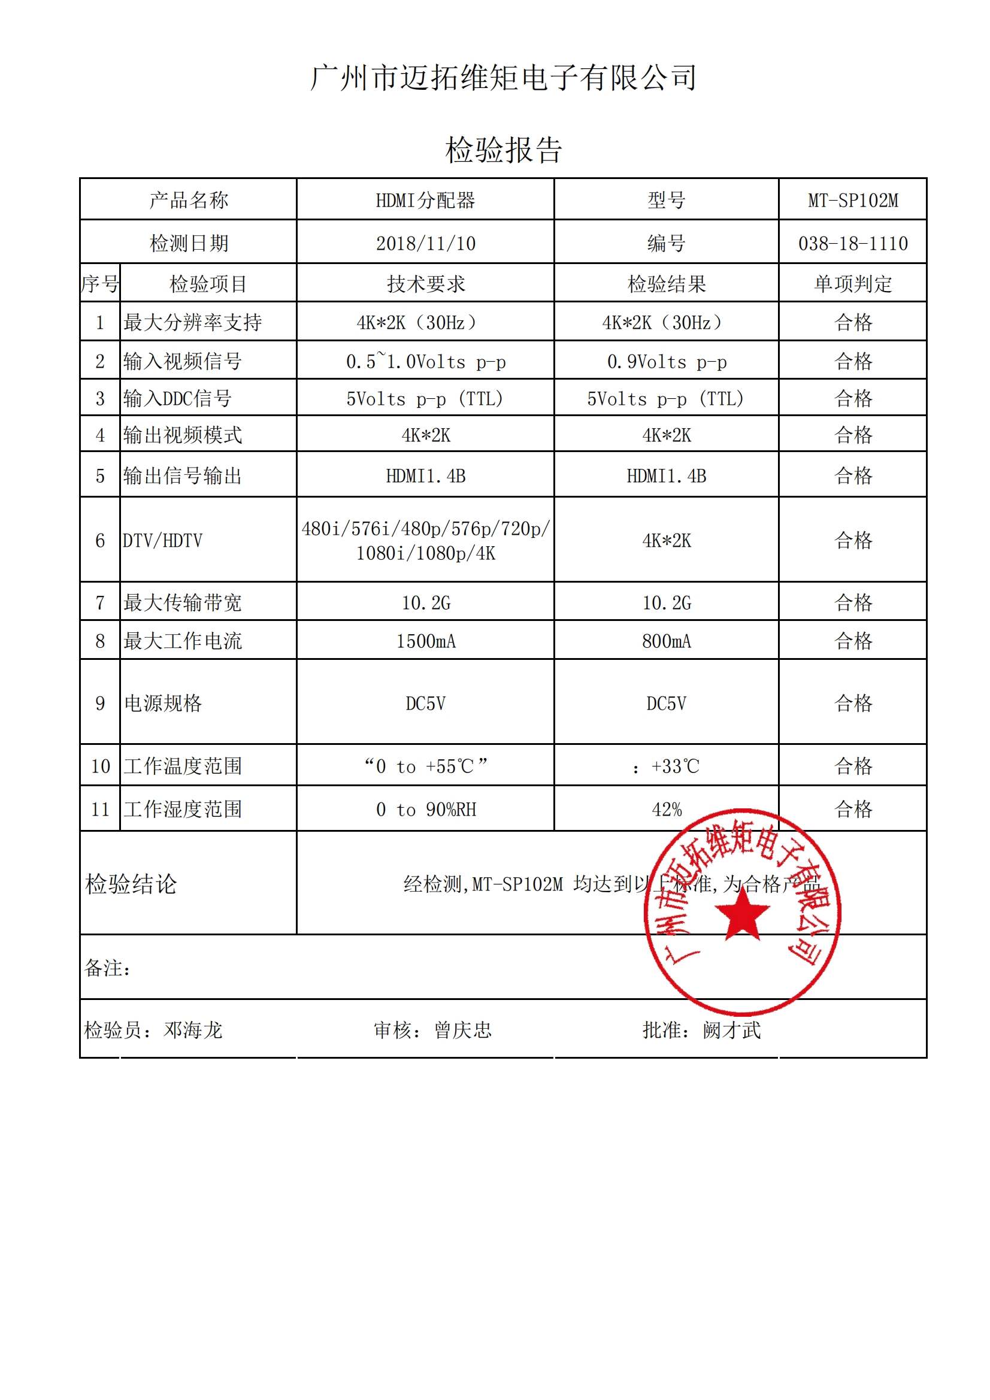
03-设计开发输出阶段/02电子/05物料证书/23HDMI分屏器/TcSgejkk7WAO.jpg
