santan444/MS003/03-设计开发输出阶段/02电子/MS-003.21T001-台车控制板/06_装配图/MS-003.21W007 台车控制板装配图 V1.0.docx

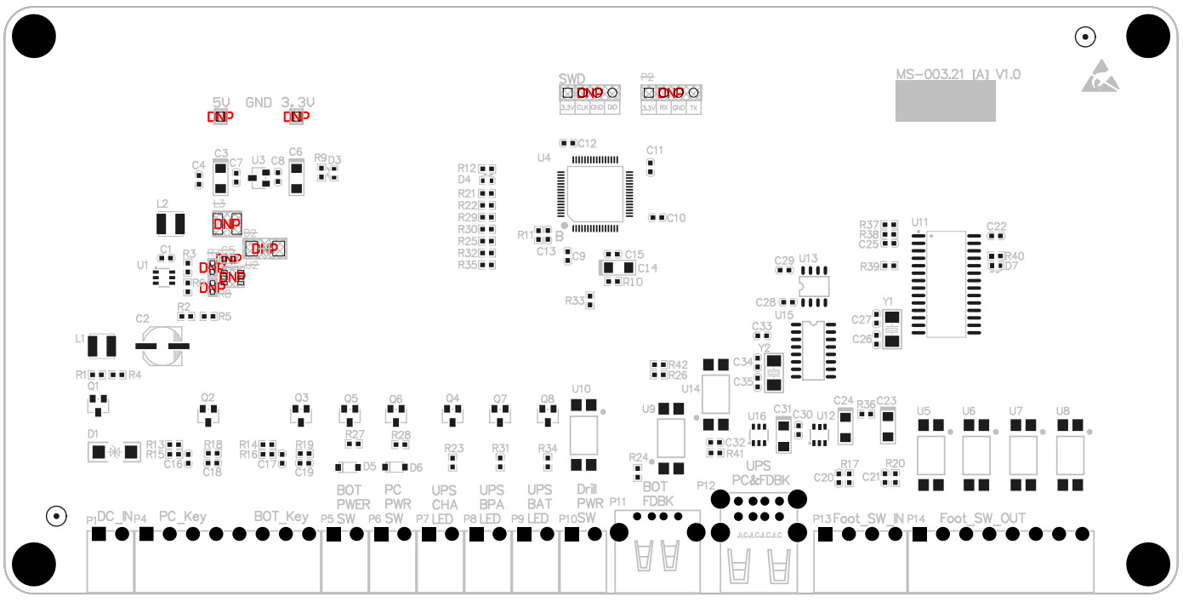
[picture p323: figure]

台车控制板

MS-003.21T007 V1.0

C5，D2，L3，R7,R8，TP1，TP2，U2不焊接
