santan444/MS003/03-设计开发输出阶段/02电子/MS-003.22T001-USB转接板/06_装配图/MS-003.22W007 USB转接板装配图 V1.0.docx

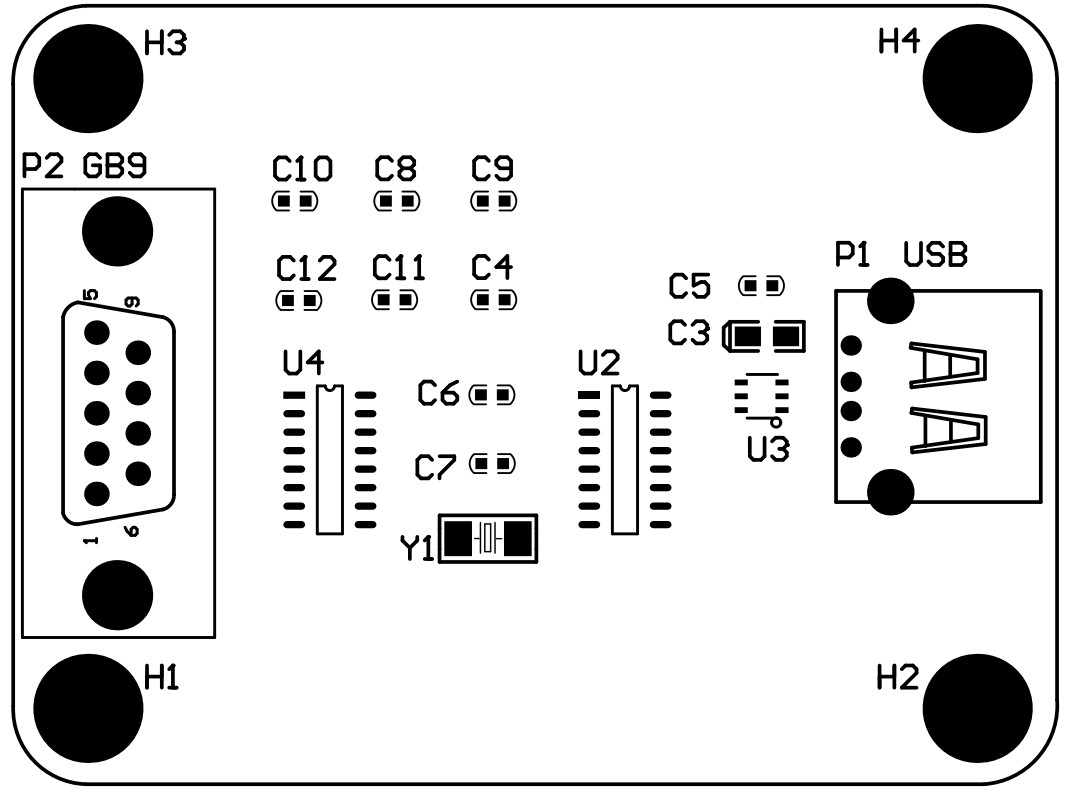
[picture p324: figure]

USB转接板

MS-003.22W007
