santan444/MS003/03-设计开发输出阶段/02电子/MS-003.24T001-灯带驱动板/06_装配图/MS-003.24W007 灯带驱动板装配图 V1.0.docx

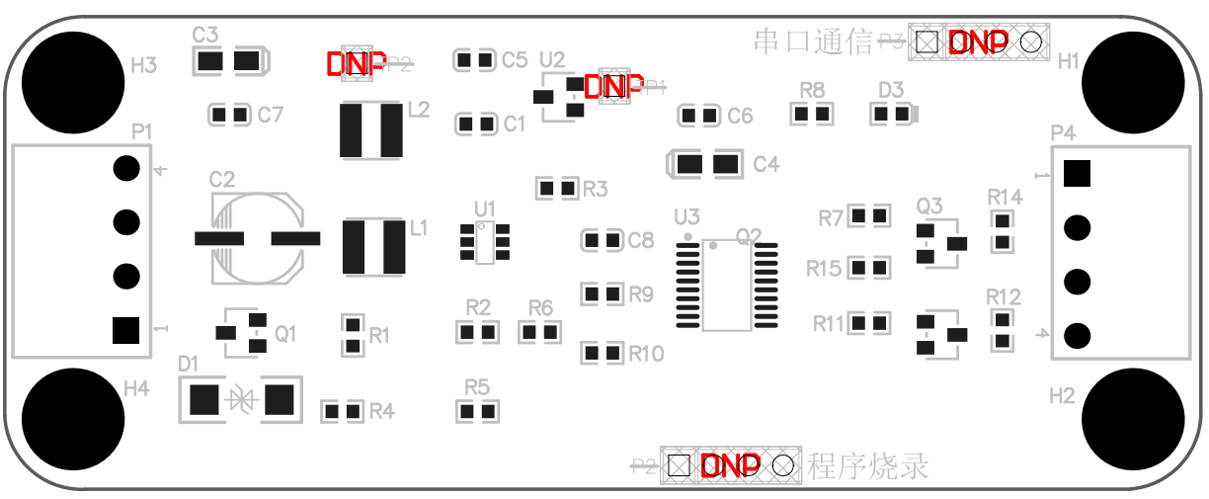
[picture p325: figure]

灯带驱动板

MS-003.24W007 V1.0

TP1、TP2、P2、P3不焊接
