santan444/MS003/03-设计开发输出阶段/02电子/05物料证书/6.隔离变压器T8BFN-85419/UL60601-1 family series (Medical use)-医用电器设备标准.pdf

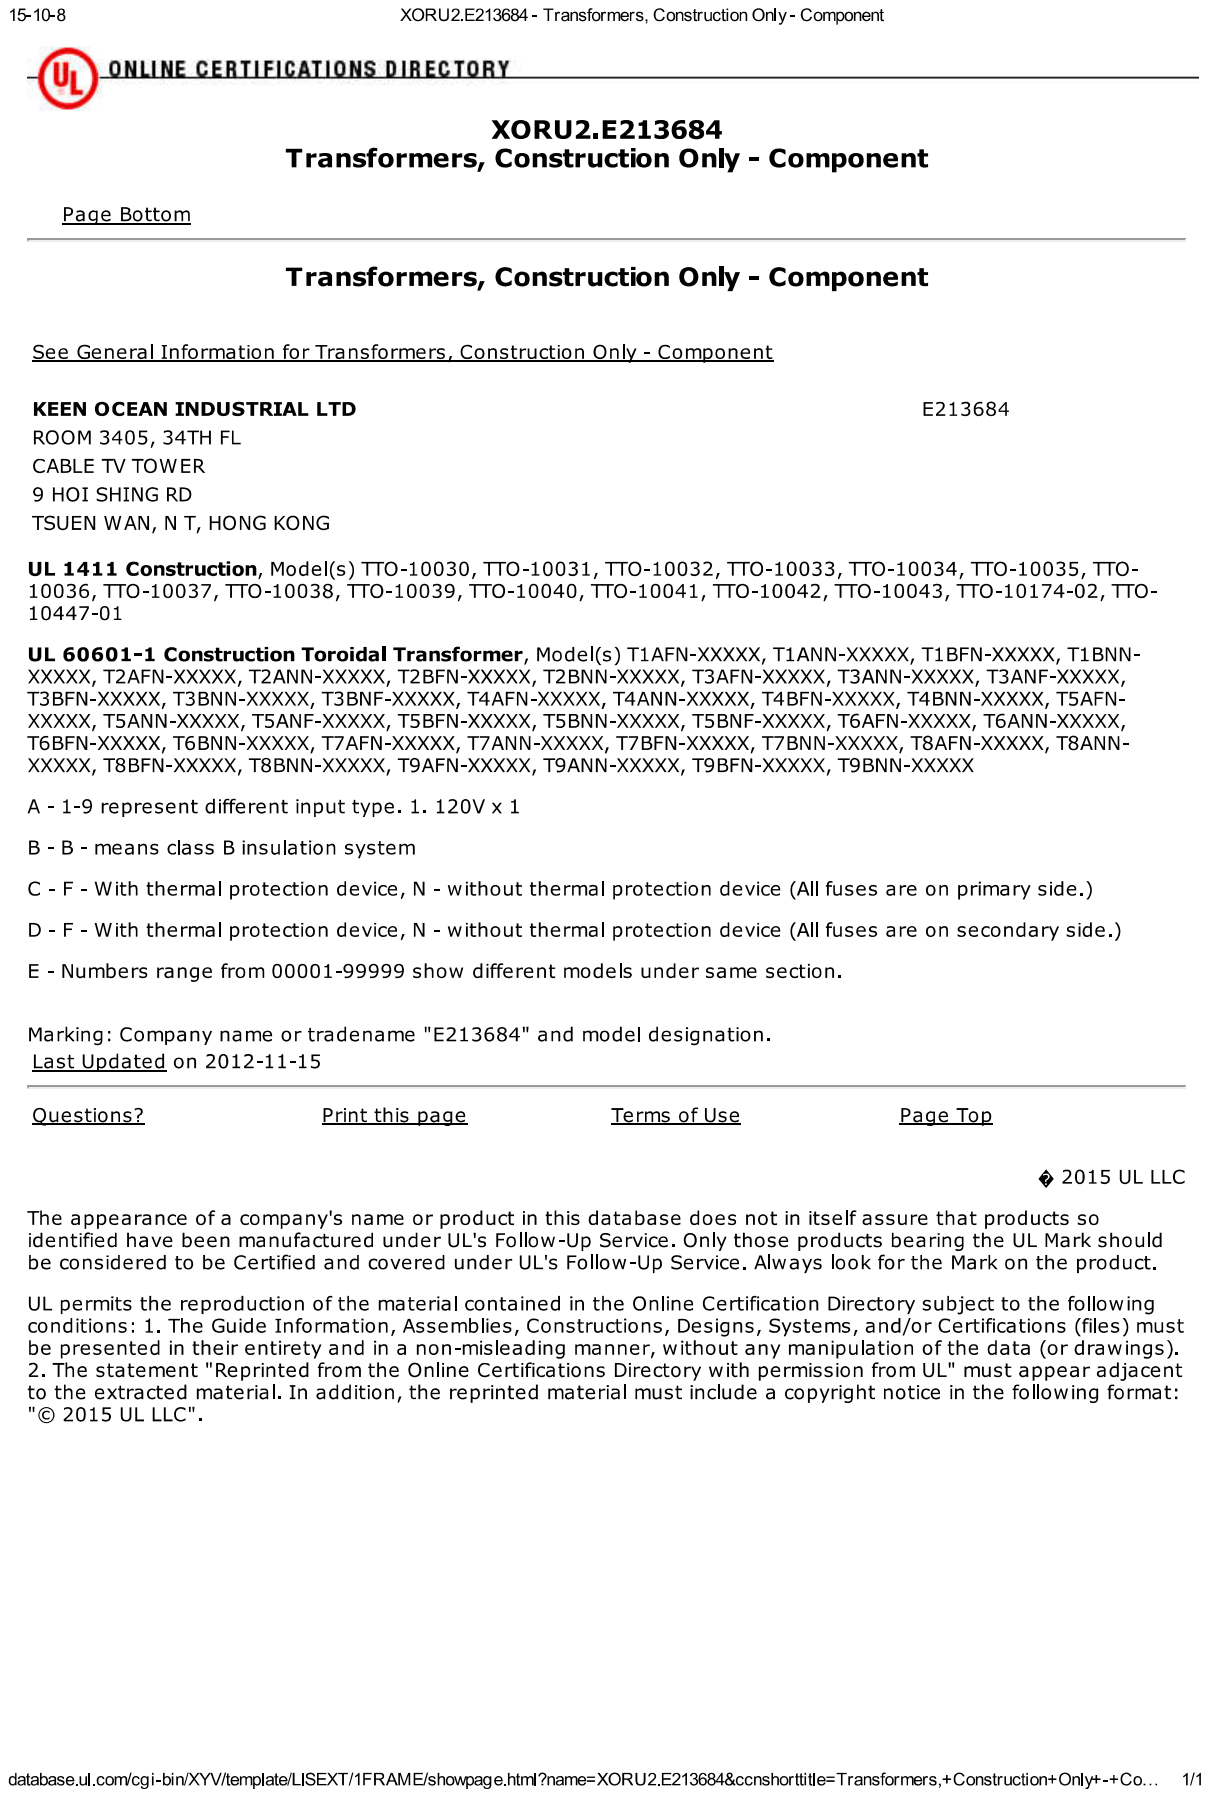
[picture p326: page 1]
