santan444/MS003/03-设计开发输出阶段/02电子/06物料说明书/11.熔断器/5J.pdf

# 5J Φ5.2x20 RoHS Compliant

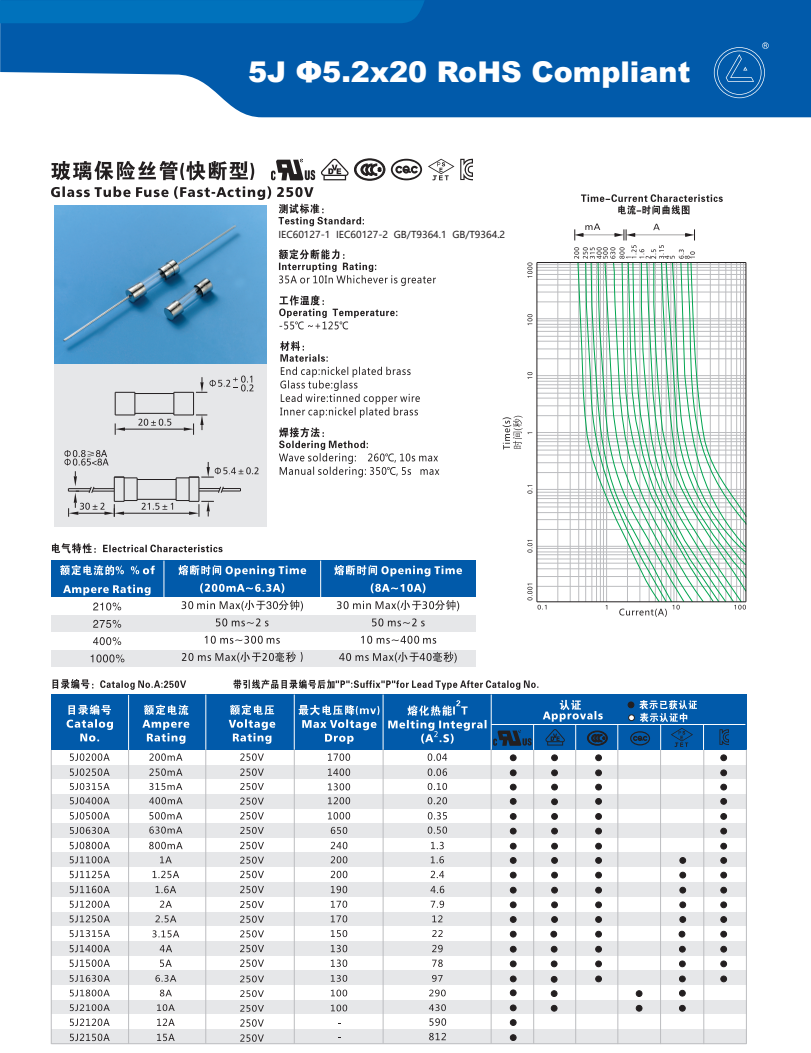
[picture p327: page 1]
IEC60127-1 IEC60127-2 GB/T9364.1 GB/T9364.2
