santan444/MS003/03-设计开发输出阶段/02电子/06物料说明书/23.HDMI分屏/DE3DADD-7736-4C54-93F2-CCE4A262500A.pdf

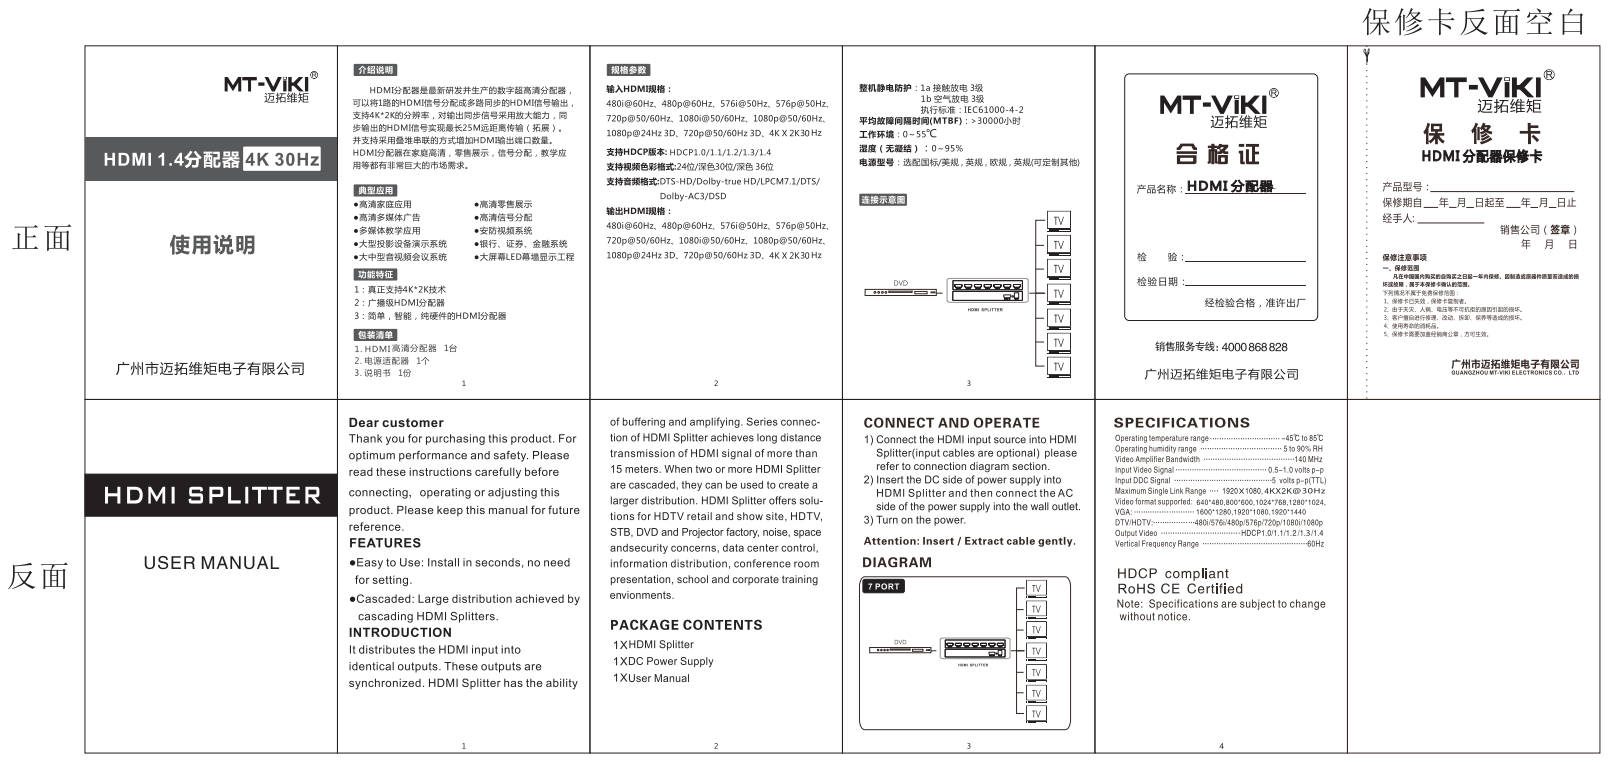
[picture p328: page 1]
