santan444/MS003/03-设计开发输出阶段/02电子/MS-003.21T001-台车控制板/06_装配图/MS-003.21W007 台车控制板装配图 V1.0.pdf

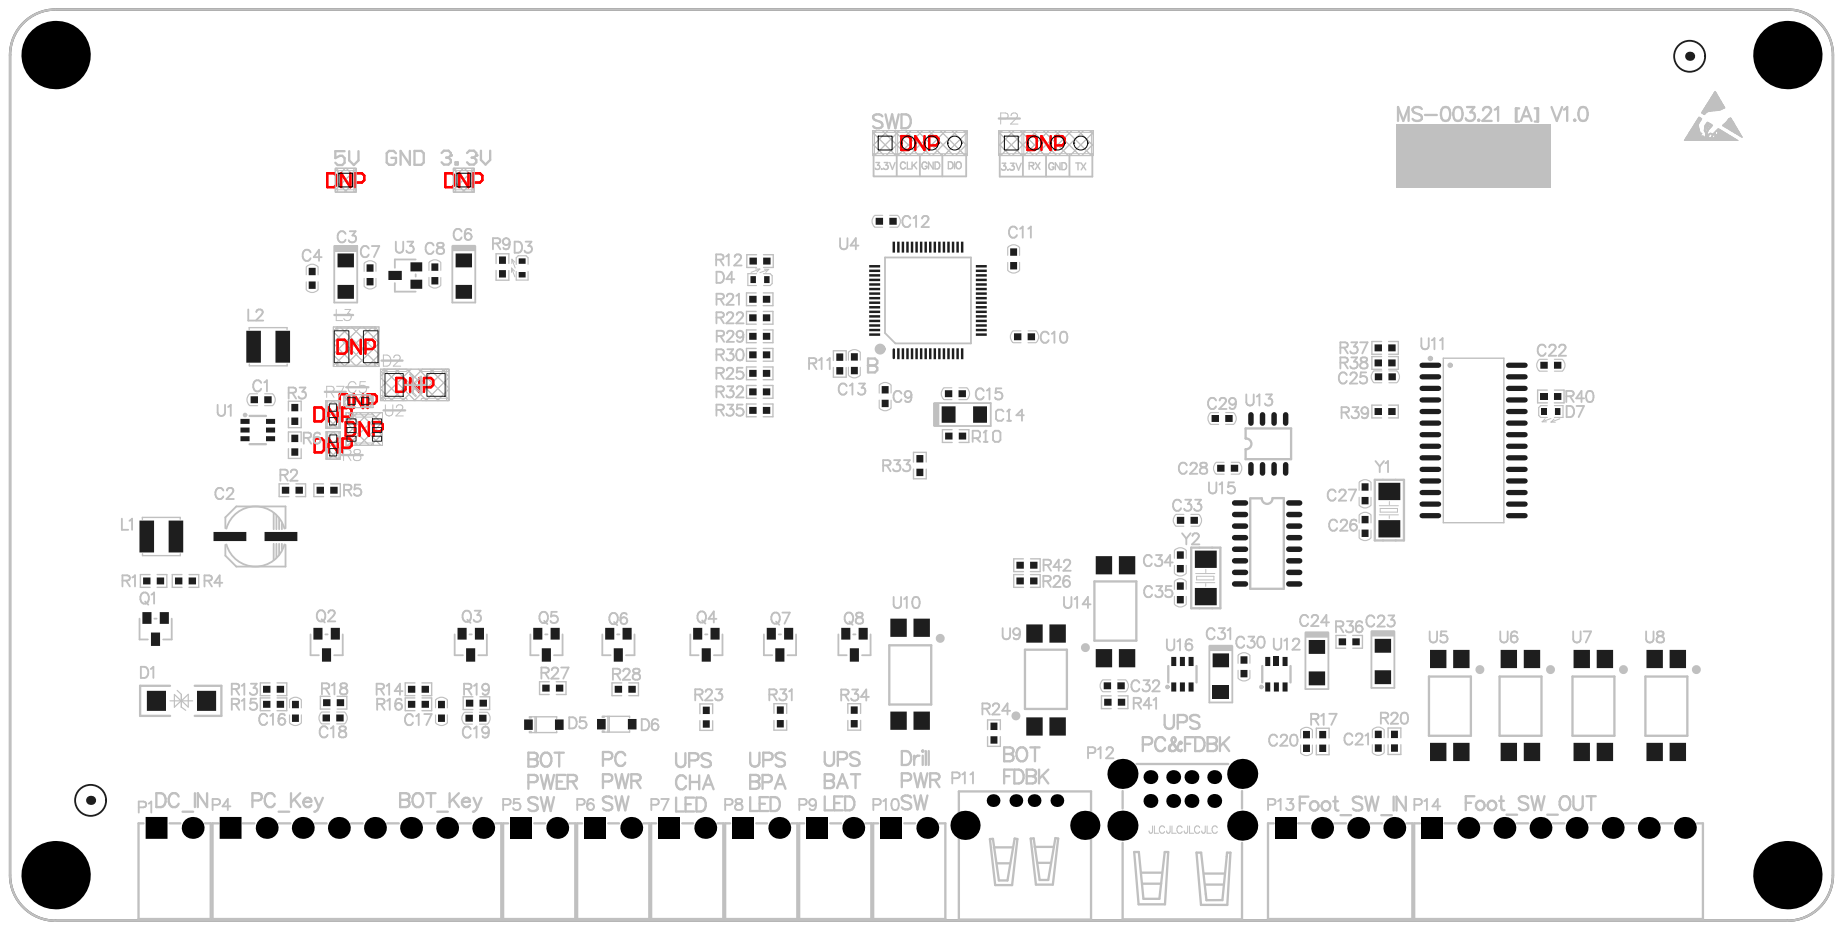
[picture p329: page 1]
