santan444/MS003/03-设计开发输出阶段/02电子/06物料说明书/7.脚踏/无线脚踏/FS-8系列无线医疗脚踏开关（IPX8）.pdf

# FS-8 系列无线医疗脚踏开关(IPx8)

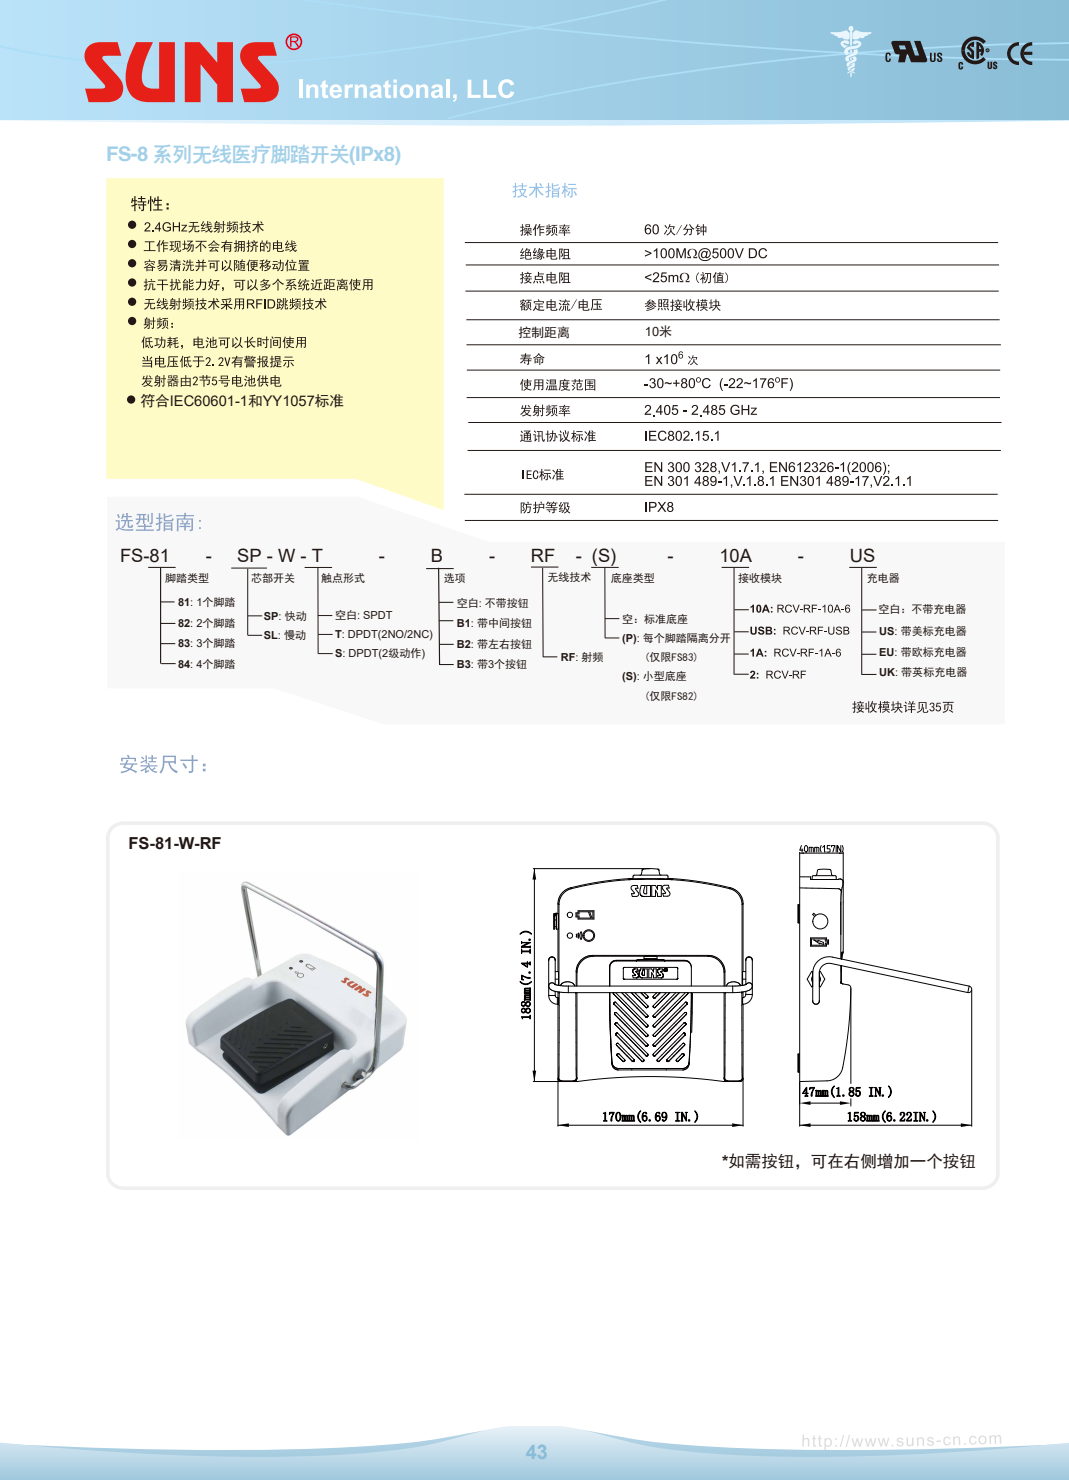
[picture p330: page 1]
*如需按钮，可在右侧增加一个按钮; 符合IEC60601-1和YY1057标准; 空白：不带充电器; US: 带美标充电器; EU: 带欧标充电器; UK: 带英标充电器; 空白: 不带按钮; B1: 带中间按钮; B2: 带左右按钮; B3: 带3个按钮; 81: 1个脚踏; 82: 2个脚踏; 83: 3个脚踏; 84: 4个脚踏; 控制距离; 脚踏类型; 芯部开关; 触点形式; 无线技术; 底座类型; 接收模块; 充电器; 空：标准底座; (P): 每个脚踏隔离分开; (仅限FS83); (S): 小型底座; (仅限FS82); 空白: SPDT T: DPDT(2NO/2NC); S: DPDT(2级动作)

# FS-8 系列无线医疗脚踏开关(IPx8)

# FS-82-W-RF-(S)

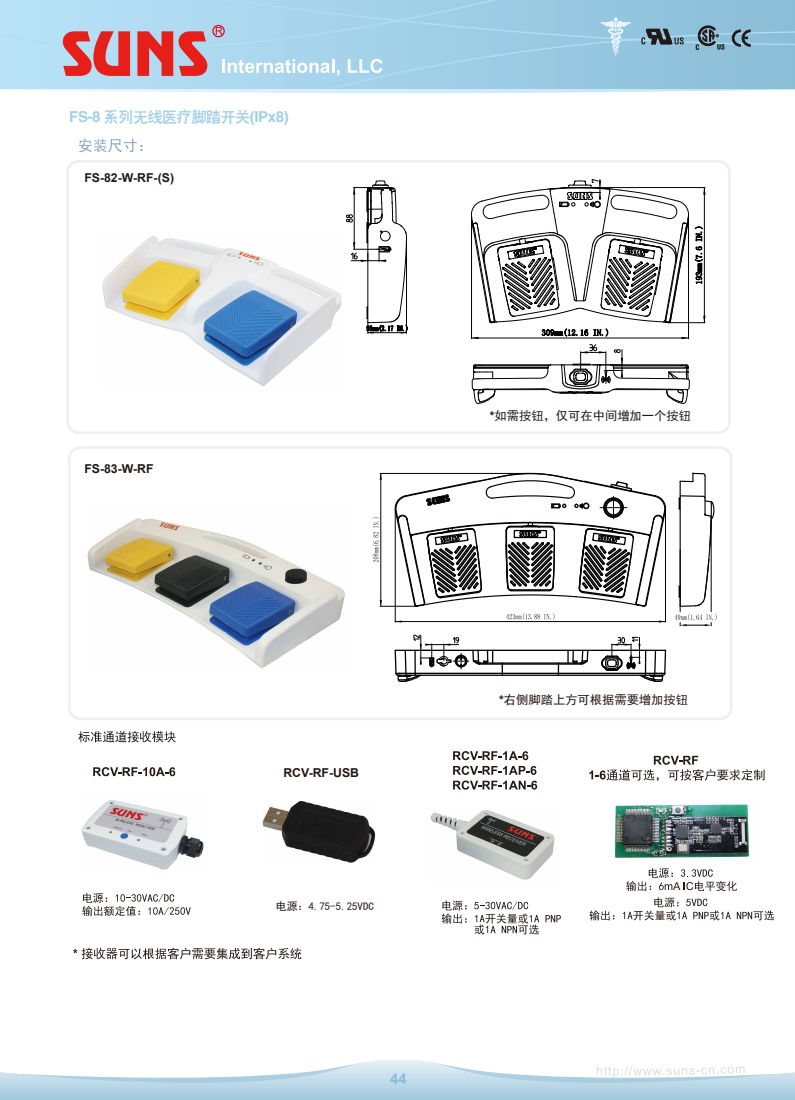
[picture p331: page 2]
电源：4.75-5.25VDC; *如需按钮，仅可在中间增加一个按钮; *右侧脚踏上方可根据需要增加按钮

RCV-RF-USB

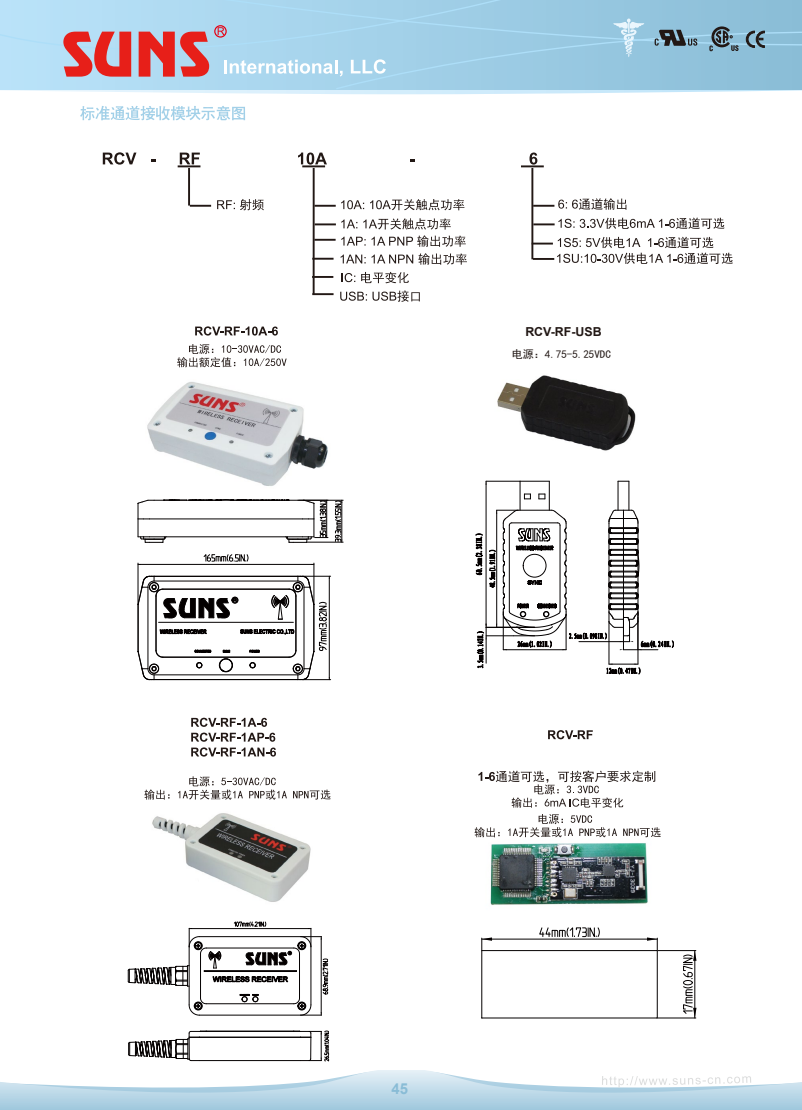
[picture p332: page 3]
电源：4.75-5.25VDC

RCV-RF-USB
