santan444/MS003/03-设计开发输出阶段/02电子/06物料说明书/7.脚踏/无线脚踏/三实无线脚踏.pdf

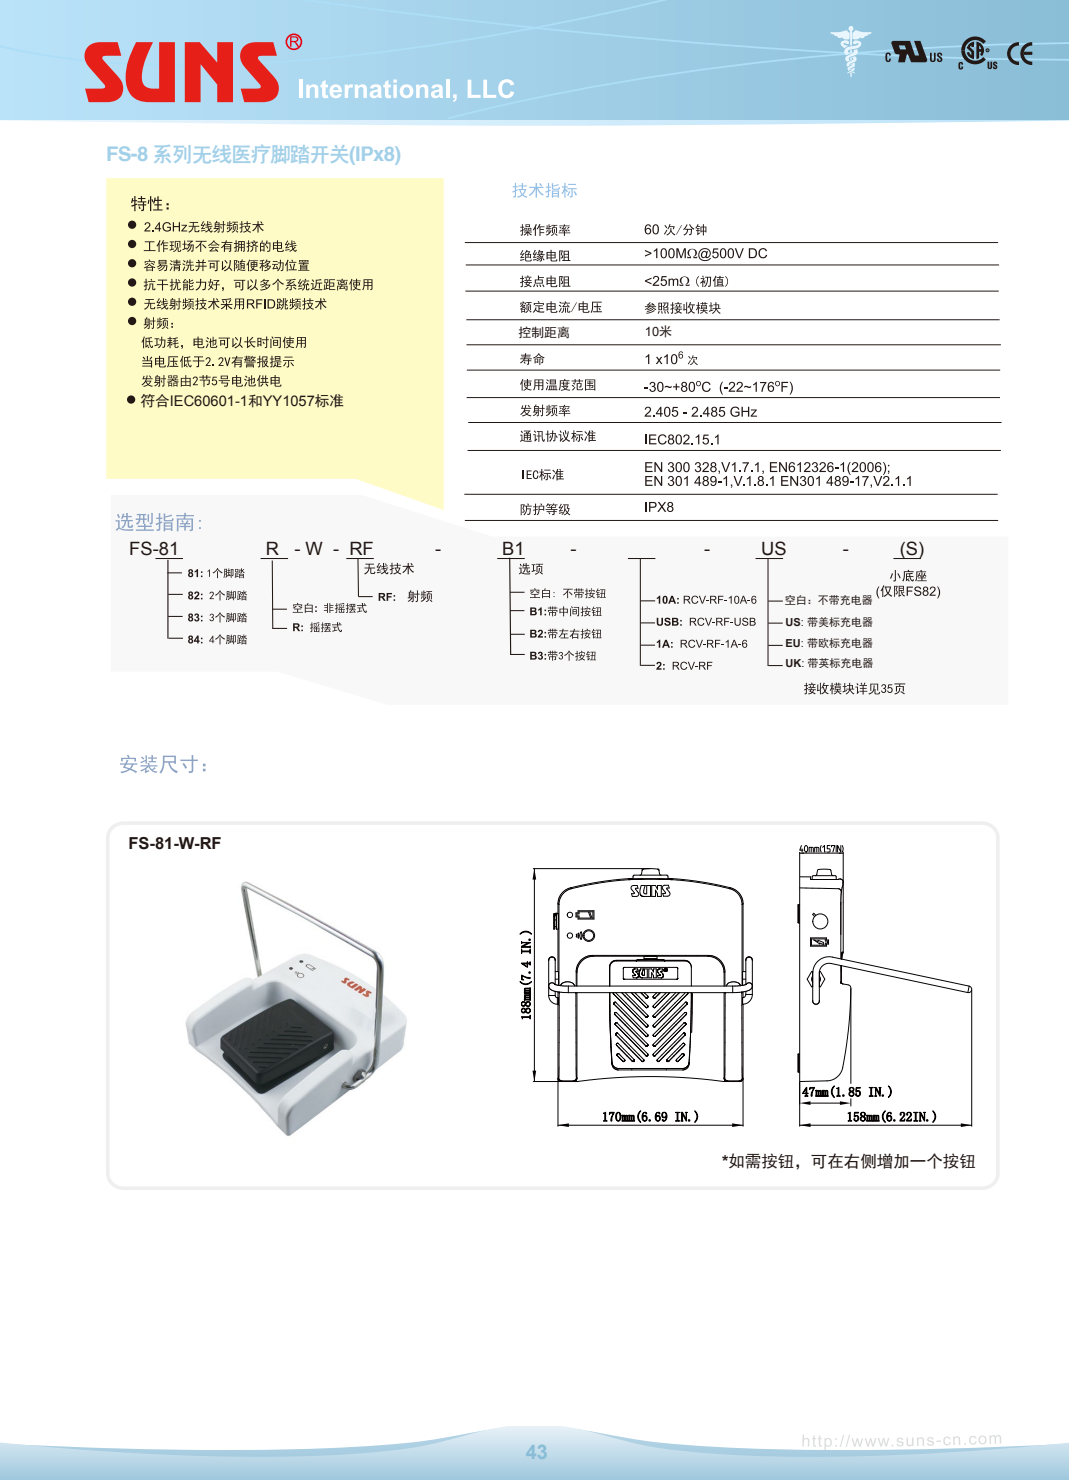
[picture p333: page 1]
FS-8 系列无线医疗脚踏开关(IPx8); *如需按钮，可在右侧增加一个按钮; 空白：不带充电器; 符合IEC60601-1和YY1057标准; US: 带美标充电器; EU: 带欧标充电器; UK: 带英标充电器; 控制距离

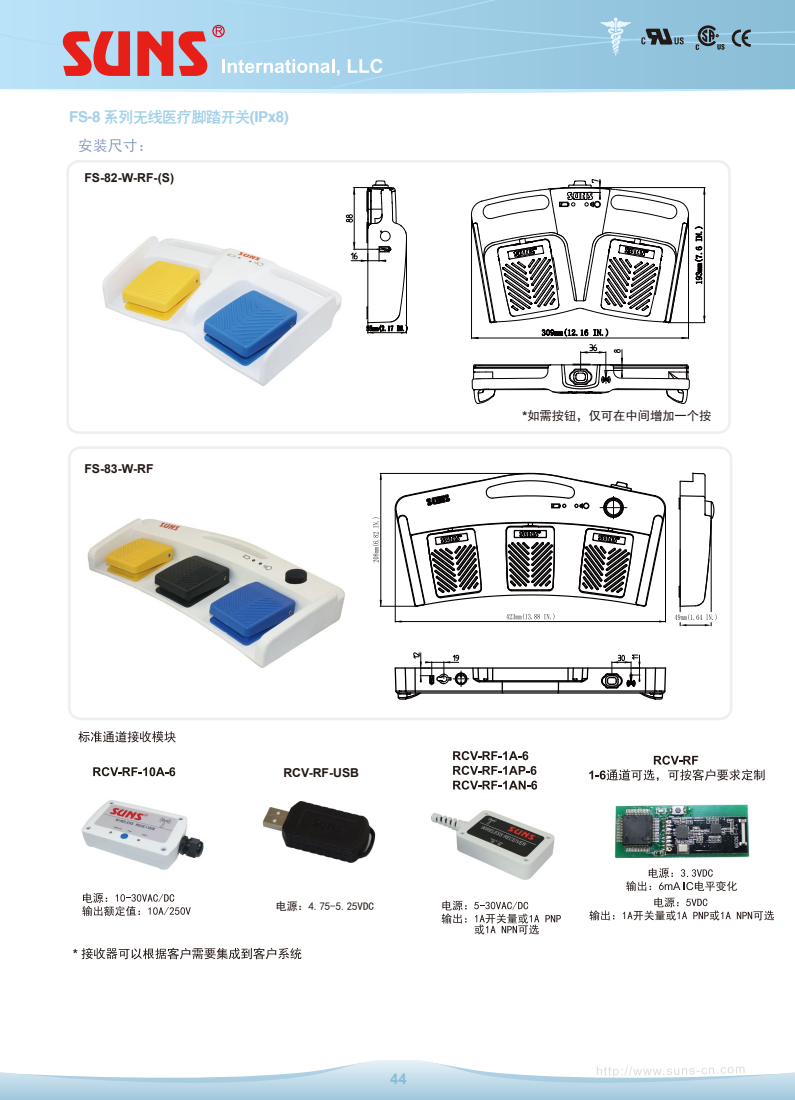
[picture p334: page 2]
FS-8 系列无线医疗脚踏开关(IPx8); 电源：4.75-5.25VDC; *如需按钮，仅可在中间增加一个按

RCV-RF-USB

电源：4.75-5.25VDC

RCV-RF-USB
