santan444/MS003/(list of files, drawings)

Other design files:
03-设计开发输出阶段/02电子/MS-003.22T001-USB转接板/02_PCB/MS-003.22T003USB转接板PCB图 V1.0.PcbDoc
03-设计开发输出阶段/02电子/MS-003.24T001-灯带驱动板/02_PCB/MS-003.24T003灯带驱动板PCB图 V1.0.PcbDoc
